DavidIngraham/ArduPilot-tinkering/viewer/README.md

# MicroAGU viewer workspace

Shared Three.js rendering, recorded-data applets, and the browser ArduPilot + Rust
simulator. Existing HTML URLs are preserved for blog embeds. Physics lives in
`../simulation`; applets never implement or tune the aircraft model.

## Ownership

| Directory | Owns | Must not depend on |
| --- | --- | --- |
| `packages/contracts` | Validated truth/log formats, pose and mission types, worker protocol, attitude math | DOM, Three.js, applications |
| `packages/playback` | Interpolation, live truth buffering, truth/log → render-pose adapters | DOM, Three.js, rendering, simulator |
| `packages/rendering` | CAD and canopy geometry, asset loading, scene resources, cameras and route display | Simulator, applets, UI |
| `packages/sim-browser` | Rust binding adapter, ArduPilot transport, worker client, browser isolation and runtime integrity | Rendering, Three.js, applets |
| `packages/applet-ui` | Mount lifecycle, touch controls, timeline controls, comparison layout, charts and capture | Simulator, applications |
| `apps/applets` | Each explanation's data selection, annotations, layout and definition | Other applet implementations |
| `apps/simulator` | Simulator HTML, flight controls, default home/mission, input mapping, presentation loop | Private renderer or worker state |
| `assets` | CAD models, bounded presentation recordings, runtime configuration and pinned asset inventories | Experiment execution |
| `generated` | Rust JS/WASM/types, ArduPilot WASM and generated MAVLink dialect | Hand edits |
| `tools/build`, `tools/convert`, `tools/publish` | Build manifests, data conversion and verified publishing | Tuning or flight-study execution |
| `../research/viewer-studies` | Recording harnesses, gusts, scenario generation and analysis | Runtime imports from the web applications |

Packages are private npm workspaces with explicit exports and one lockfile.
`npm run check:boundaries` enforces package direction; TypeScript checks every
application, package, tool and test. There is no implicit `shared` catch-all.

## Develop and test

```sh
cd viewer
npm ci
npm run assets:fetch       # Restore missing published excerpts by pinned SHA-256
npm run dev               # Open a page listed in apps/applets/registry.ts
npm test
npm run test:physics      # Frozen native/WASM reference trajectories
npm run test:sitl         # Real ArduPlane: modes, launch, mission and manual takeover
npm run build
npx playwright install chromium
npm run test:browser
```

Node 24 is used in CI. `npm run assets:fetch` never overwrites a local recording.
Large flight logs, source videos and fitting outputs stay outside this workspace.
The committed `assets/manifests/recordings.json` pins the published excerpts.
Builds report missing excerpts; publishing an incomplete applet fails before
writing anything. Replay pages never download ArduPilot or the physics WASM.

After intentionally regenerating and reviewing research exports, run
`npm run assets:inventory` to update the recording hashes. Builds do not rewrite
these expected hashes or regenerate experiments.

## Adding an applet

Create `apps/applets/NAME/index.html`, `definition.ts` and `applet.ts` together.
The simulator's HTML lives at `apps/simulator/index.html` beside `main.ts`.
The definition declares its stable public `page`, source `html`, TypeScript `entry`, exact asset requirements
(or pinned dataset groups), controls and initial camera category. Register it in
`apps/applets/registry.ts`; the build and publisher derive their page lists from
that registry. Applet-specific diagrams and scientific annotations stay beside
the definition. Reuse shared rendering, playback and controls through package
exports; do not import another applet's implementation.

Mount through `registerApplet(definition, scope => ...)`. Use the scope for frames,
timers, event handlers, workers, sockets, captures and owned render resources.
Use `ModelAssets` for per-mount CAD loading. Disposal cancels callbacks and pending
loads, terminates workers, releases GPU resources and closes sockets. The exported
handle supports `mount()` and `dispose()`; the browser tests repeatedly exercise
those operations. The simulator's Reset uses that lifecycle without a reload.

## State and clocks

Simulation truth (`microagu.state.v1`) and measured flight data
(`microagu.flight.v1`) remain distinct. Their playback adapters produce a NED/xyzw
`RenderPose`. Missing canopy/rotor observations remain null. Only rendering converts
NED to Three.js coordinates. The simulator worker owns physics time; one app-level
presentation loop samples the live buffer and updates aircraft and camera together.
The renderer does not read telemetry, execute missions, advance physics or own a clock.

## Build and publish

```sh
npm run build
npm run publish -- --destination /path/to/site/assets/microagu-viewer
# Or publish one application:
npm run publish -- --destination /path/to/site/assets/microagu-viewer --app simulator
```

The build combines Vite's dependency manifest, worker output inventory and each
applet's declared assets into `dist/applet-manifest.json`. Publishing verifies every
file hash before copying the selected dependency closure. It never parses minified
JavaScript. Existing Python `tools/publish_*.py` commands delegate to this publisher.
Only publishing the simulator includes its worker, WASM and isolation service worker.

Source folders do not determine published URLs. The build emits each HTML file at
its definition's `page` (for example `pitch-fbd.html` or `simulator.html`) and makes
its compiled asset URLs relative to that location. The dev server serves these
same routes and redirects source HTML paths to them, preserving query parameters.
Blog links and iframe embeds continue to use `/assets/microagu-viewer/<page>`;
link to `apps/applets/<id>/index.html` on GitHub only when referring to source code.

Generated Rust bindings are produced by `../simulation/tools/generate.sh` into
`generated/physics`. Firmware builds write to `generated/ardupilot`; resolved runtime
configuration/provenance live in `assets/runtime`. The public URLs remain `wasm/*`.
Browser startup checks the recorded hashes and uses versioned runtime URLs.

See [simulator operation and rebuilding](SIMULATOR.md),
[individual experiment and capture recipes](docs/RECIPES.md), and
[the reusable physics package](../simulation/README.md).
