DavidIngraham/ArduPilot-tinkering/scratch/plane-trajectory/LogMessages.rst

.. Dynamically generated list of Logger Messages
.. This page was generated using Tools/autotest/logger_metdata/parse.py

.. DO NOT EDIT

.. _logmessages:

Onboard Message Log Messages
============================

This is a list of log messages which may be present in logs produced and stored onboard ArduPilot vehicles.

.. _ACC:

ACC
~~~

IMU accelerometer data

+----------+----------+-------------------------------------------------+
| TimeUS   | μs       | Time since system startup                       |
+----------+----------+-------------------------------------------------+
| I        | instance | accelerometer sensor instance number            |
+----------+----------+-------------------------------------------------+
| SampleUS | μs       | time since system startup this sample was taken |
+----------+----------+-------------------------------------------------+
| AccX     | m/s/s    | acceleration along X axis                       |
+----------+----------+-------------------------------------------------+
| AccY     | m/s/s    | acceleration along Y axis                       |
+----------+----------+-------------------------------------------------+
| AccZ     | m/s/s    | acceleration along Z axis                       |
+----------+----------+-------------------------------------------------+

.. _ADSB:

ADSB
~~~~

Automatic Dependent Serveillance - Broadcast detected vehicle information

+--------------+-------------------+-----------------------------+
| TimeUS       | μs                | Time since system startup   |
+--------------+-------------------+-----------------------------+
| ICAO_address |                   | Transponder address         |
+--------------+-------------------+-----------------------------+
| Lat          | 1e-7 deglatitude  | Vehicle latitude            |
+--------------+-------------------+-----------------------------+
| Lng          | 1e-7 deglongitude | Vehicle longitude           |
+--------------+-------------------+-----------------------------+
| Alt          | mm                | Vehicle altitude            |
+--------------+-------------------+-----------------------------+
| Heading      | cdegheading       | Vehicle heading             |
+--------------+-------------------+-----------------------------+
| Hor_vel      | mm/s              | Vehicle horizontal velocity |
+--------------+-------------------+-----------------------------+
| Ver_vel      | mm/s              | Vehicle vertical velocity   |
+--------------+-------------------+-----------------------------+
| Squark       |                   | Transponder squawk code     |
+--------------+-------------------+-----------------------------+

.. _AERG:

AERG
~~~~

Aeron PLX GNSS status and accuracy (GPS_PARA + EXTD_GNSS)

+--------+----+-----------------------------------------------------+
| TimeUS | μs | Time since system startup                           |
+--------+----+-----------------------------------------------------+
| GMS    |    | Time of week                                        |
+--------+----+-----------------------------------------------------+
| GWk    |    | GPS week                                            |
+--------+----+-----------------------------------------------------+
| NSat   |    | Satellites in view                                  |
+--------+----+-----------------------------------------------------+
| FixT   |    | GPS fix type as reported to AP_GPS                  |
+--------+----+-----------------------------------------------------+
| Jam    |    | Jamming detection level (1=none,2=warn,3=critical)  |
+--------+----+-----------------------------------------------------+
| Spf    |    | Spoofing detection level (1=none,2=warn,3=critical) |
+--------+----+-----------------------------------------------------+
| HPA    |    | Horizontal position accuracy                        |
+--------+----+-----------------------------------------------------+
| VPA    |    | Vertical position accuracy                          |
+--------+----+-----------------------------------------------------+
| HVA    |    | Horizontal velocity accuracy                        |
+--------+----+-----------------------------------------------------+
| HDOP   |    | Horizontal dilution of precision                    |
+--------+----+-----------------------------------------------------+
| VDOP   |    | Vertical dilution of precision                      |
+--------+----+-----------------------------------------------------+

.. _AERN:

AERN
~~~~

Aeron PLX fused navigation solution (NAV_PARA1)

+--------+--------------+-----------------------------------+
| TimeUS | μs           | Time since system startup         |
+--------+--------------+-----------------------------------+
| Epoch  | s            | Unix epoch seconds at sample time |
+--------+--------------+-----------------------------------+
| Lat    | deglatitude  | Latitude                          |
+--------+--------------+-----------------------------------+
| Lng    | deglongitude | Longitude                         |
+--------+--------------+-----------------------------------+
| Alt    | m            | Height above WGS84 ellipsoid      |
+--------+--------------+-----------------------------------+
| VN     | m/s          | Velocity north                    |
+--------+--------------+-----------------------------------+
| VE     | m/s          | Velocity east                     |
+--------+--------------+-----------------------------------+
| VD     | m/s          | Velocity down                     |
+--------+--------------+-----------------------------------+
| Crs    | degheading   | Course over ground                |
+--------+--------------+-----------------------------------+
| Roll   | rad          | Roll angle                        |
+--------+--------------+-----------------------------------+
| Pitch  | rad          | Pitch angle                       |
+--------+--------------+-----------------------------------+
| Yaw    | rad          | Yaw angle                         |
+--------+--------------+-----------------------------------+
| InsSt  |              | PLX INS filter-source status word |
+--------+--------------+-----------------------------------+
| HwSt   |              | PLX hardware status word          |
+--------+--------------+-----------------------------------+

.. _AERS:

AERS
~~~~

Aeron PLX raw sensor data (SENS_PARA)

+--------+--------+---------------------------+
| TimeUS | μs     | Time since system startup |
+--------+--------+---------------------------+
| Temp   | degC   | Sensor temperature        |
+--------+--------+---------------------------+
| GX     | deg/s  | Gyro X                    |
+--------+--------+---------------------------+
| GY     | deg/s  | Gyro Y                    |
+--------+--------+---------------------------+
| GZ     | deg/s  | Gyro Z                    |
+--------+--------+---------------------------+
| AX     | m/s/s  | Accel X                   |
+--------+--------+---------------------------+
| AY     | m/s/s  | Accel Y                   |
+--------+--------+---------------------------+
| AZ     | m/s/s  | Accel Z                   |
+--------+--------+---------------------------+
| MX     | mGauss | Mag X                     |
+--------+--------+---------------------------+
| MY     | mGauss | Mag Y                     |
+--------+--------+---------------------------+
| MZ     | mGauss | Mag Z                     |
+--------+--------+---------------------------+
| Pres   | Pa     | Barometric pressure       |
+--------+--------+---------------------------+
| BTmp   | degC   | Barometer temperature     |
+--------+--------+---------------------------+
| BAlt   | m      | Barometric altitude       |
+--------+--------+---------------------------+

.. _AETR:

AETR
~~~~

Normalised pre-mixer control surface outputs

+--------+----+--------------------------------------------------------------+
| TimeUS | μs | Time since system startup                                    |
+--------+----+--------------------------------------------------------------+
| Ail    |    | Pre-mixer value for aileron output (between -4500 and 4500)  |
+--------+----+--------------------------------------------------------------+
| Elev   |    | Pre-mixer value for elevator output (between -4500 and 4500) |
+--------+----+--------------------------------------------------------------+
| Thr    |    | Pre-mixer value for throttle output (between -100 and 100)   |
+--------+----+--------------------------------------------------------------+
| Rudd   |    | Pre-mixer value for rudder output (between -4500 and 4500)   |
+--------+----+--------------------------------------------------------------+
| Flap   |    | Pre-mixer value for flaps output (between 0 and 100)         |
+--------+----+--------------------------------------------------------------+
| Steer  |    | Pre-mixer value for steering output (between -4500 and 4500) |
+--------+----+--------------------------------------------------------------+
| SS     |    | Surface movement / airspeed scaling value                    |
+--------+----+--------------------------------------------------------------+

.. _AHR2:

AHR2
~~~~

Backup AHRS data

+--------+--------------+-------------------------------------------+
| TimeUS | μs           | Time since system startup                 |
+--------+--------------+-------------------------------------------+
| Roll   | deg          | Estimated roll                            |
+--------+--------------+-------------------------------------------+
| Pitch  | deg          | Estimated pitch                           |
+--------+--------------+-------------------------------------------+
| Yaw    | degheading   | Estimated yaw                             |
+--------+--------------+-------------------------------------------+
| Alt    | m            | Estimated altitude                        |
+--------+--------------+-------------------------------------------+
| Lat    | deglatitude  | Estimated latitude                        |
+--------+--------------+-------------------------------------------+
| Lng    | deglongitude | Estimated longitude                       |
+--------+--------------+-------------------------------------------+
| Q1     |              | Estimated attitude quaternion component 1 |
+--------+--------------+-------------------------------------------+
| Q2     |              | Estimated attitude quaternion component 2 |
+--------+--------------+-------------------------------------------+
| Q3     |              | Estimated attitude quaternion component 3 |
+--------+--------------+-------------------------------------------+
| Q4     |              | Estimated attitude quaternion component 4 |
+--------+--------------+-------------------------------------------+

.. _AIS1:

AIS1
~~~~

Contents of 'position report' AIS message, see: https://gpsd.gitlab.io/gpsd/AIVDM.html#_types_1_2_and_3_position_report_class_a

+------+----+---------------------------+
| US   | μs | Time since system startup |
+------+----+---------------------------+
| typ  |    | Message Type              |
+------+----+---------------------------+
| rep  |    | Repeat Indicator          |
+------+----+---------------------------+
| mmsi |    | MMSI                      |
+------+----+---------------------------+
| nav  |    | Navigation Status         |
+------+----+---------------------------+
| rot  |    | Rate of Turn (ROT)        |
+------+----+---------------------------+
| sog  |    | Speed Over Ground (SOG)   |
+------+----+---------------------------+
| pos  |    | Position Accuracy         |
+------+----+---------------------------+
| lon  |    | Longitude                 |
+------+----+---------------------------+
| lat  |    | Latitude                  |
+------+----+---------------------------+
| cog  |    | Course Over Ground (COG)  |
+------+----+---------------------------+
| hed  |    | True Heading (HDG)        |
+------+----+---------------------------+
| sec  |    | Time Stamp                |
+------+----+---------------------------+
| man  |    | Maneuver Indicator        |
+------+----+---------------------------+
| raim |    | RAIM flag                 |
+------+----+---------------------------+
| rad  |    | Radio status              |
+------+----+---------------------------+

.. _AIS4:

AIS4
~~~~

Contents of 'Base Station Report' AIS message, see: https://gpsd.gitlab.io/gpsd/AIVDM.html#_type_4_base_station_report

+------+----+---------------------------+
| US   | μs | Time since system startup |
+------+----+---------------------------+
| rep  |    | Repeat Indicator          |
+------+----+---------------------------+
| mmsi |    | MMSI                      |
+------+----+---------------------------+
| year |    | Year (UTC)                |
+------+----+---------------------------+
| mth  |    | Month (UTC)               |
+------+----+---------------------------+
| day  |    | Day (UTC)                 |
+------+----+---------------------------+
| h    |    | Hour (UTC)                |
+------+----+---------------------------+
| m    |    | Minute (UTC)              |
+------+----+---------------------------+
| s    |    | Second (UTC)              |
+------+----+---------------------------+
| fix  |    | Fix quality               |
+------+----+---------------------------+
| lon  |    | Longitude                 |
+------+----+---------------------------+
| lat  |    | Latitude                  |
+------+----+---------------------------+
| epfd |    | Type of EPFD              |
+------+----+---------------------------+
| raim |    | RAIM flag                 |
+------+----+---------------------------+
| rad  |    | Radio status              |
+------+----+---------------------------+

.. _AIS5:

AIS5
~~~~

Contents of 'static and voyage related data' AIS message, see: https://gpsd.gitlab.io/gpsd/AIVDM.html#_type_5_static_and_voyage_related_data
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
