DavidIngraham/ArduPilot-tinkering/scratch/plane-trajectory/raster-matrix/raster-summary-matrix.pdf

## Raster survey matrix: standard L1 versus line-to-line planner Each cell: AUTO course time / requested-line coverage / survey-leg RMS error

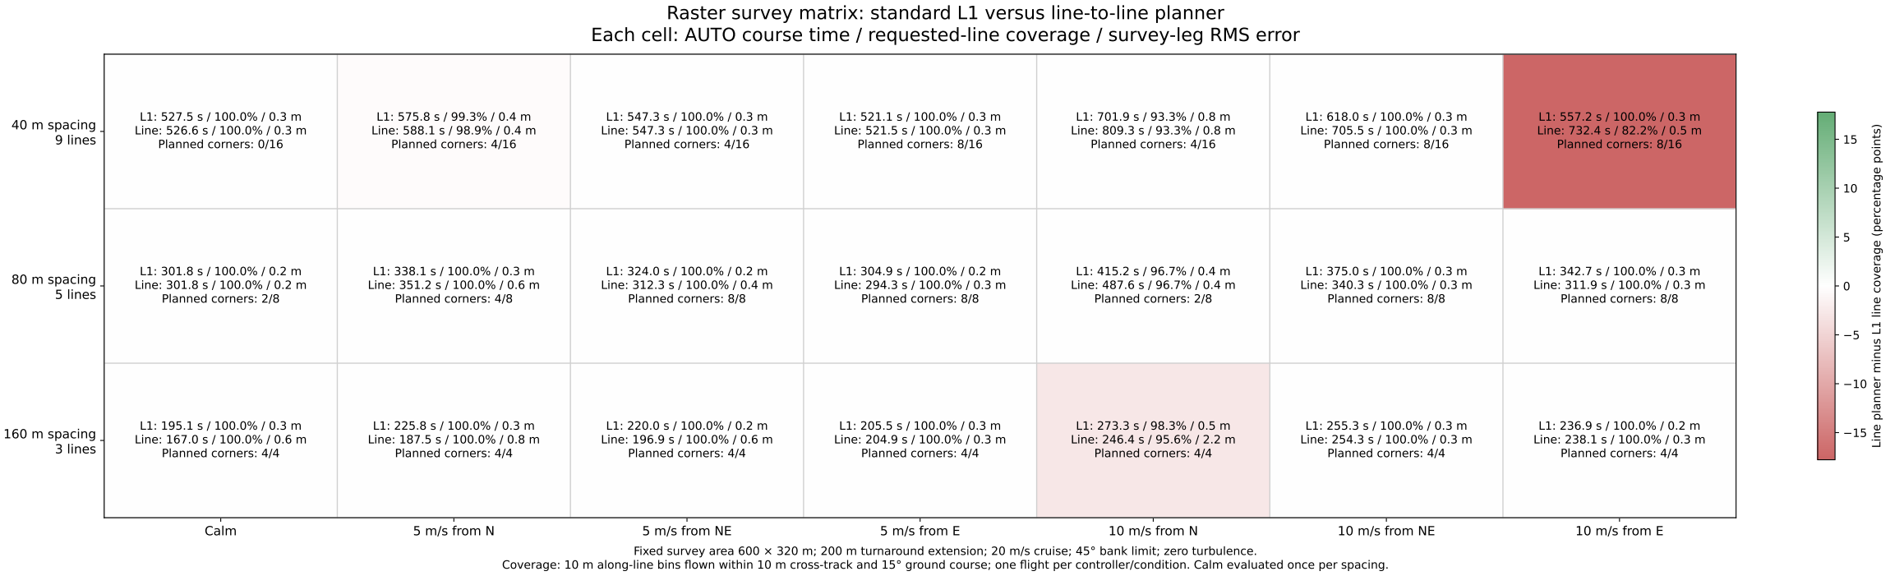
[picture p53: page 1]

Calm | 5 m/s from N | 5 m/s from NE | 5 m/s from E | 10 m/s from N | 10 m/s from NE | 10 m/s from E

40 m spacing
9 lines

80 m spacing
5 lines

160 m spacing
3 lines
L1: 527.5 s / 100.0% / 0.3 m Line: 526.6 s / 100.0% / 0.3 m Planned corners: 0/16 | L1: 575.8 s / 99.3% / 0.4 m Line: 588.1 s / 98.9% / 0.4 m Planned corners: 4/16 | L1: 547.3 s / 100.0% / 0.3 m Line: 547.3 s / 100.0% / 0.3 m Planned corners: 4/16 | L1: 521.1 s / 100.0% / 0.3 m Line: 521.5 s / 100.0% / 0.3 m Planned corners: 8/16 | L1:
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
