DavidIngraham/ArduPilot-tinkering/docs/assets/landing-refinement/landing-final.png

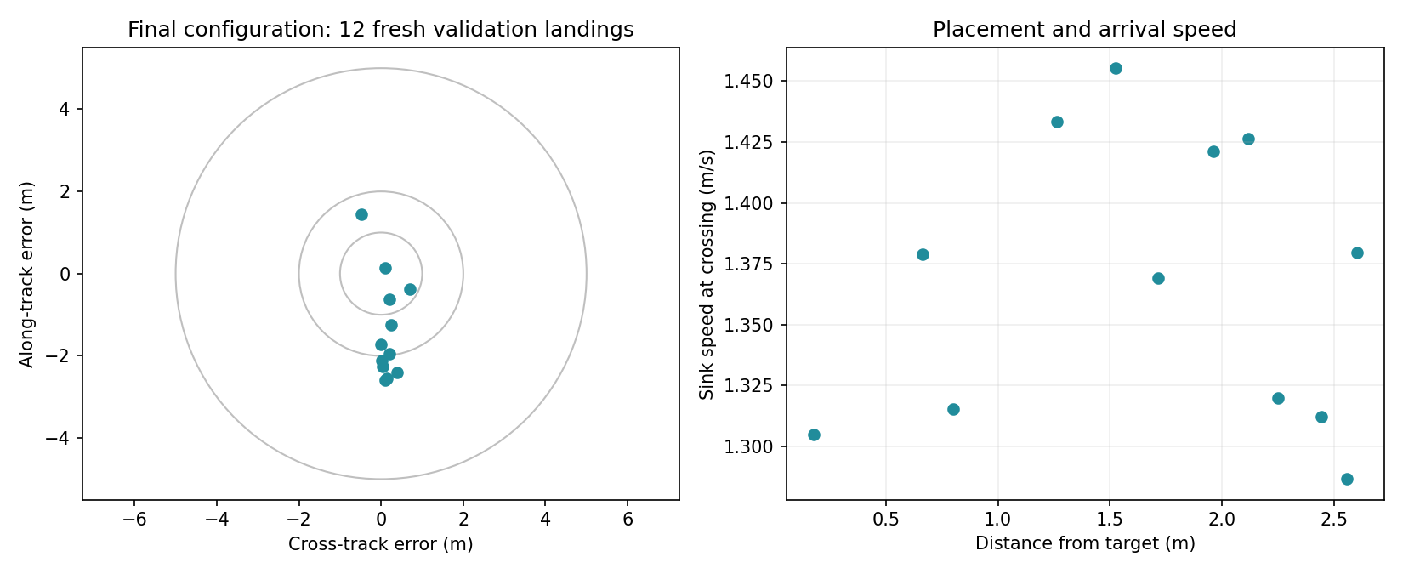
docs/assets/landing-refinement/landing-final.png
