DavidIngraham/ArduPilot-tinkering/docs/assets/landing-refinement/matched-response.png

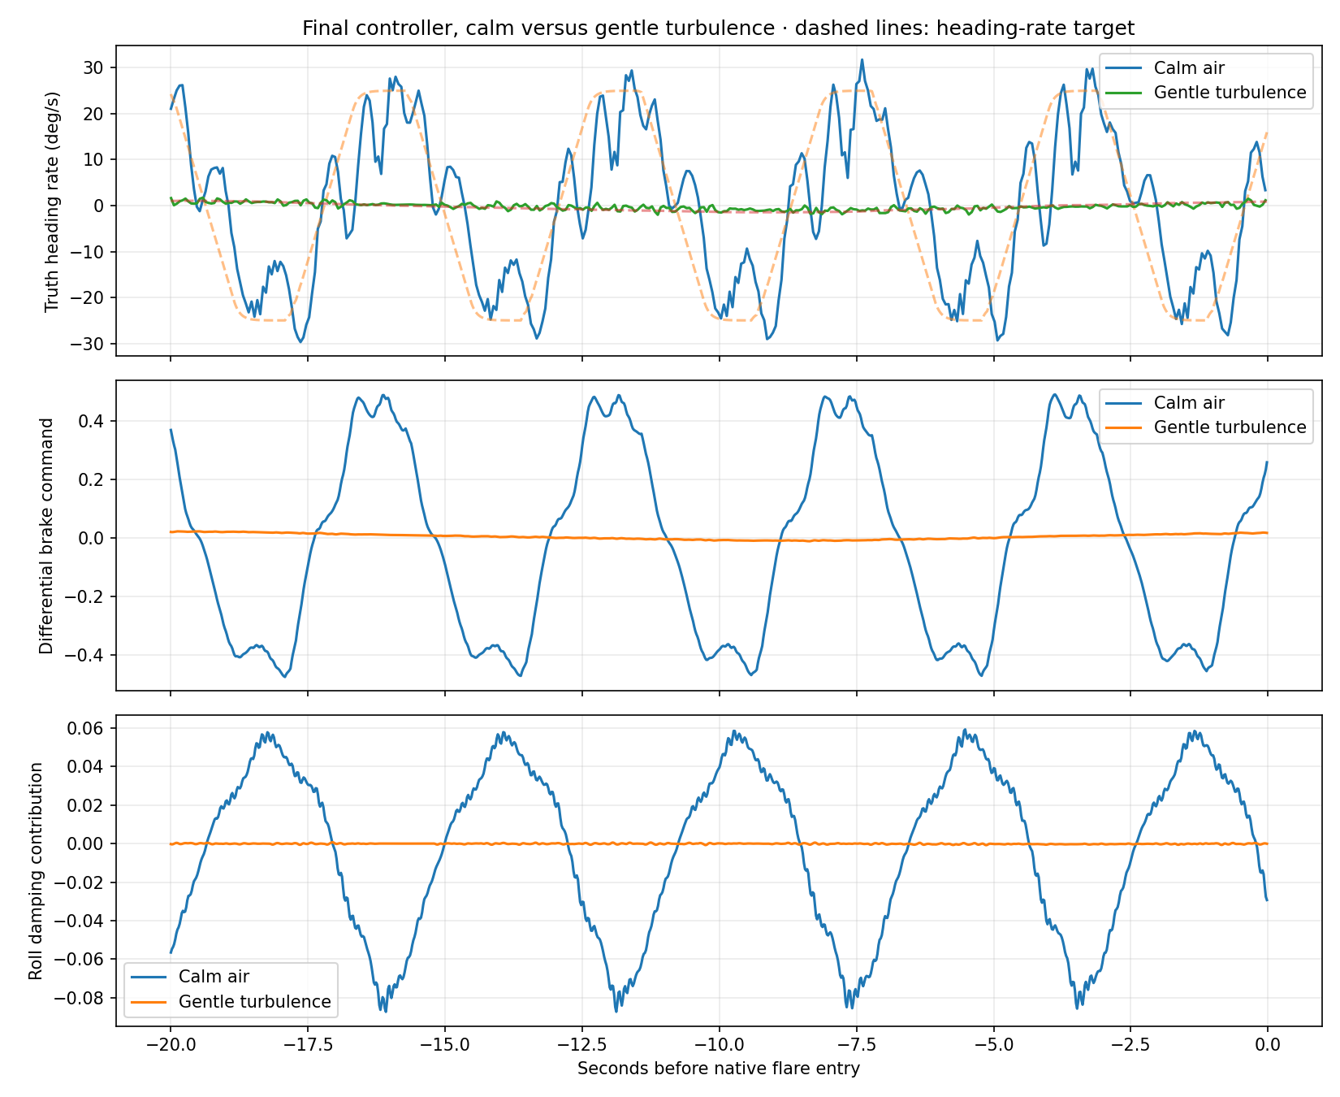
docs/assets/landing-refinement/matched-response.png
