DavidIngraham/ArduPilot-tinkering/docs/assets/landing/landing-final.png

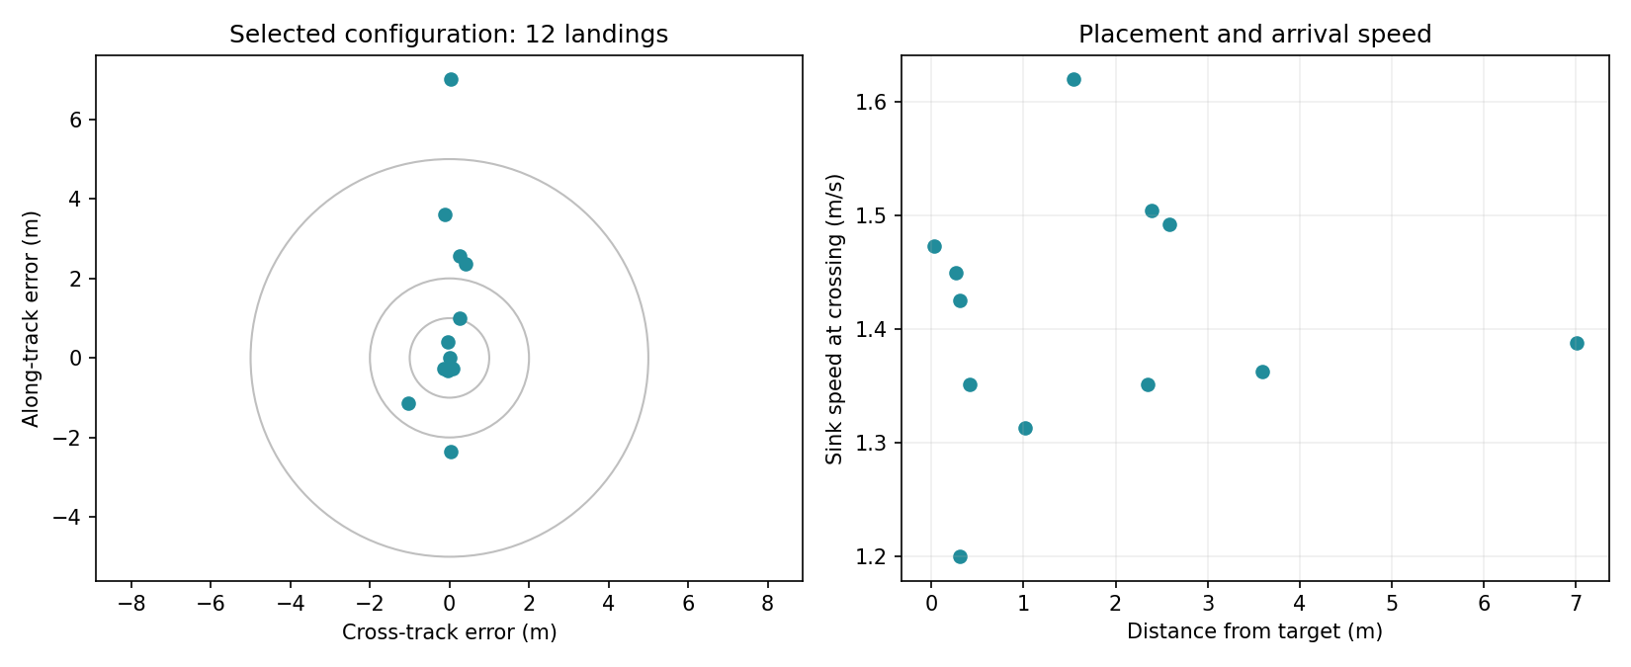
docs/assets/landing/landing-final.png
