DavidIngraham/ArduPilot-tinkering/docs/assets/landing/landing-iteration.png

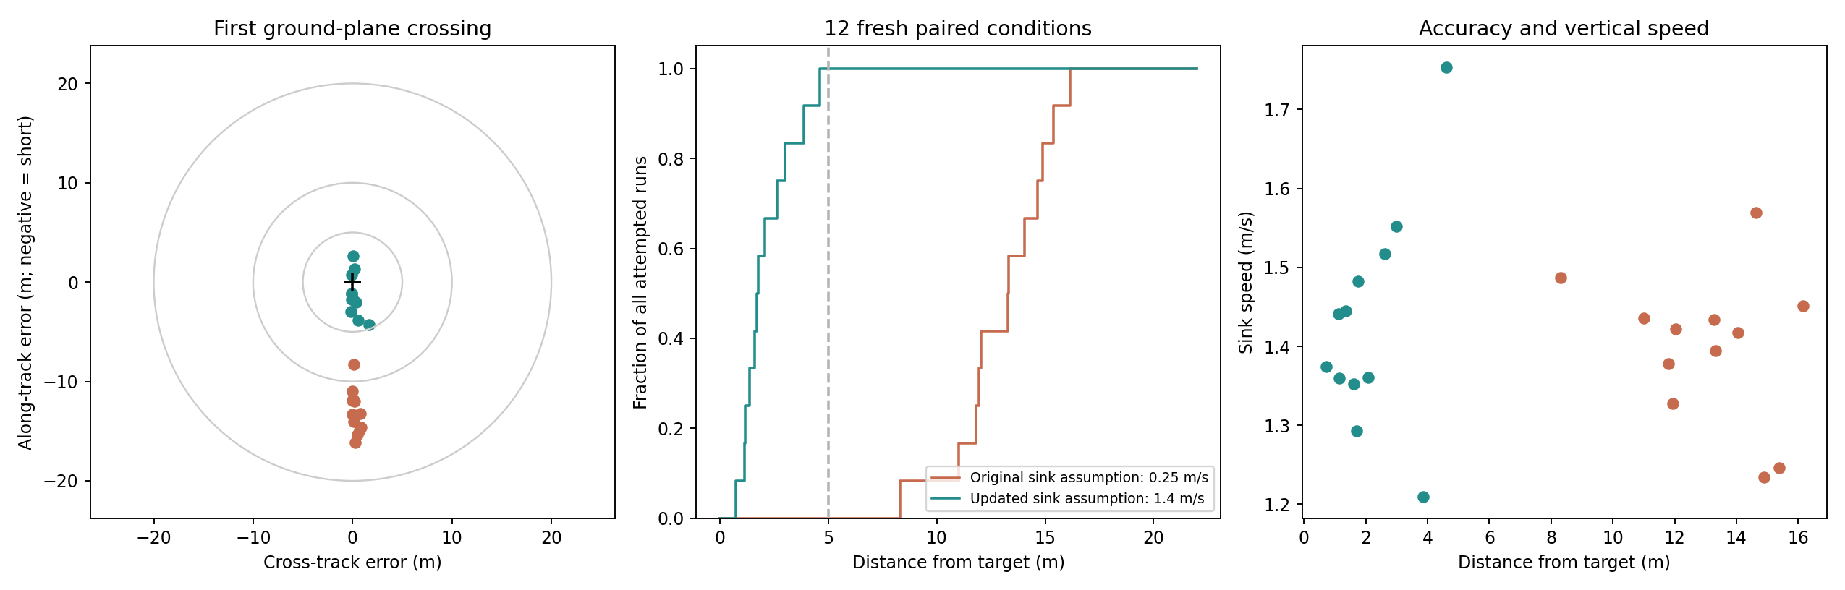
docs/assets/landing/landing-iteration.png
