DavidIngraham/ArduPilot-tinkering/docs/assets/landing/spot-landing.jpg

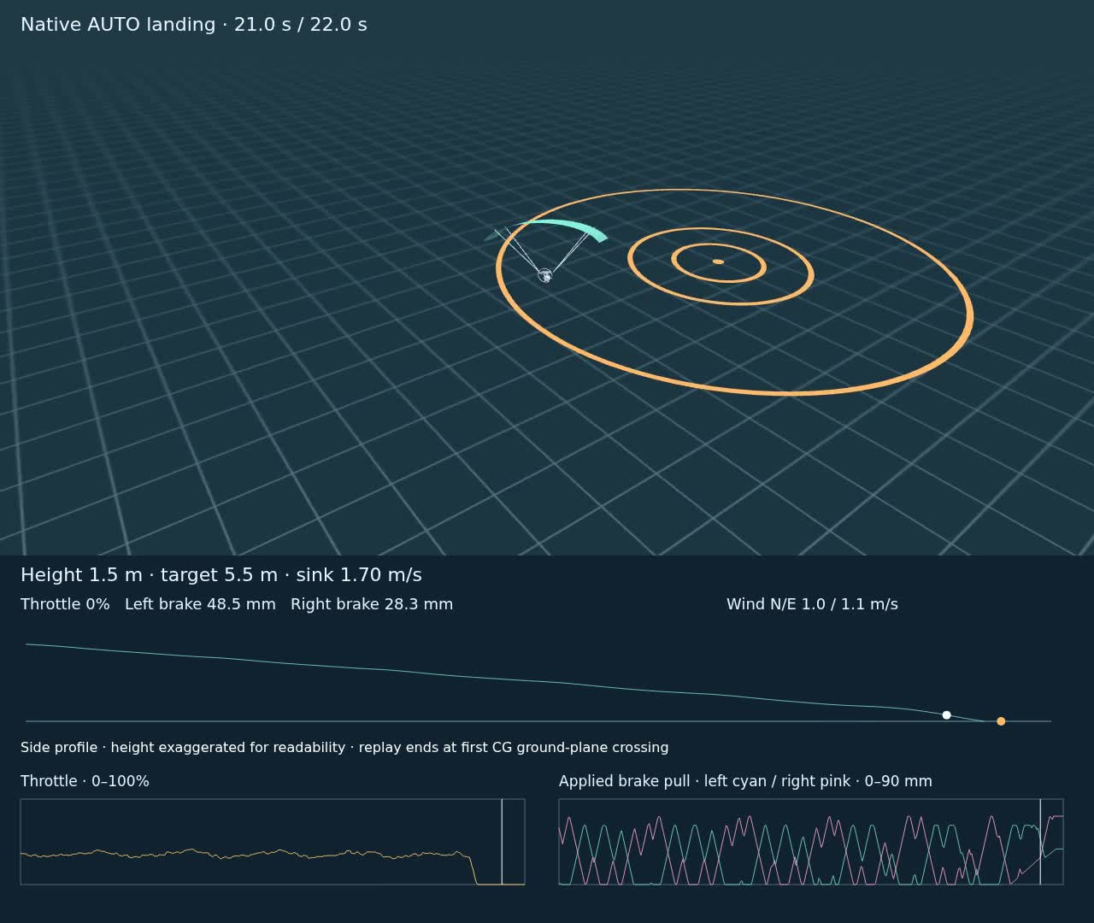
docs/assets/landing/spot-landing.jpg
