DavidIngraham/ArduPilot-tinkering/docs/assets/longitudinal-final-design/candidate-screen.png

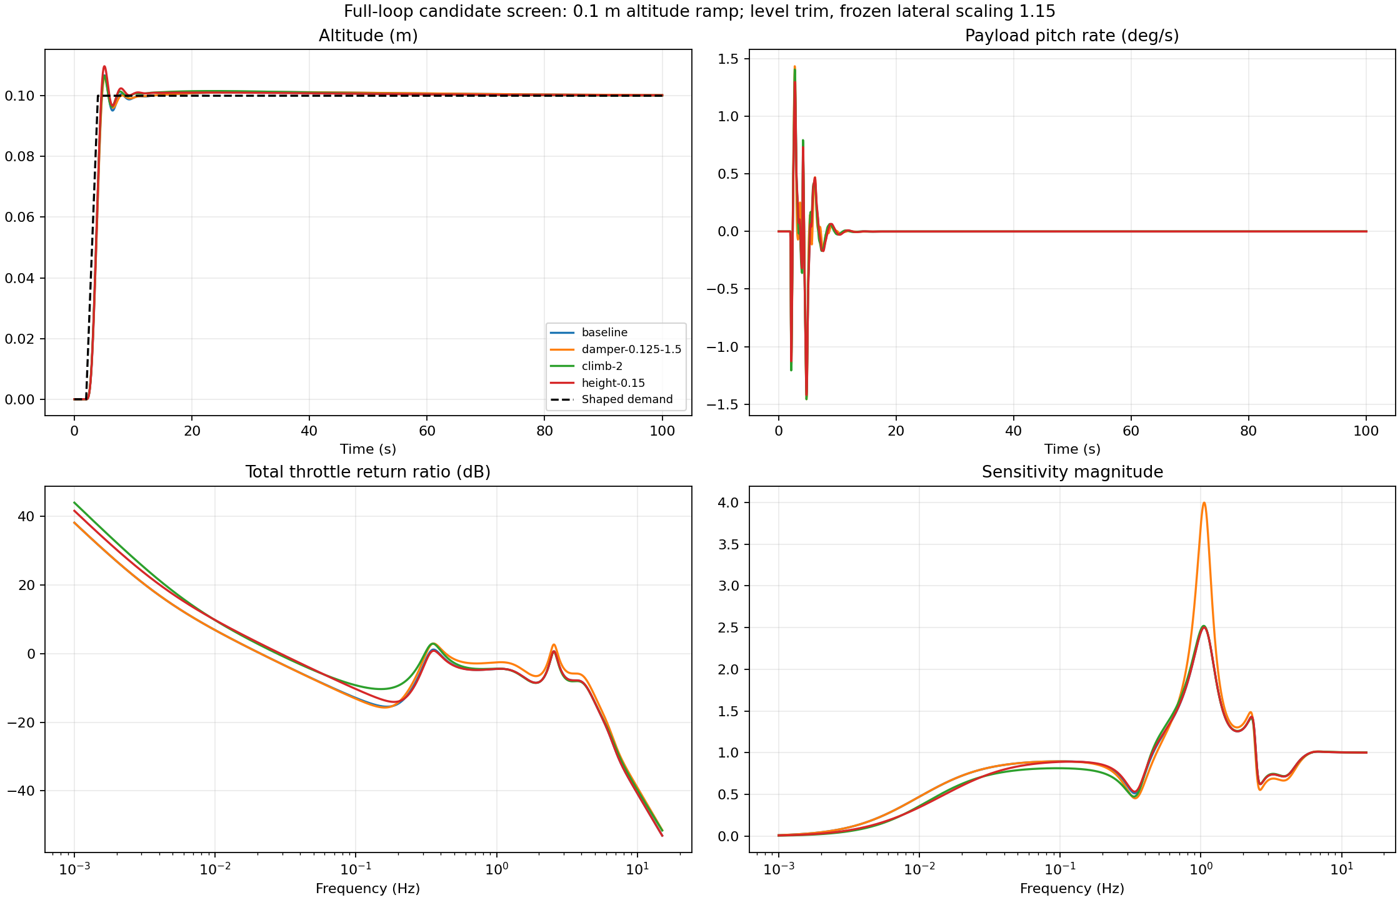
docs/assets/longitudinal-final-design/candidate-screen.png
