DavidIngraham/ArduPilot-tinkering/docs/assets/longitudinal-final-design/nyquist.png

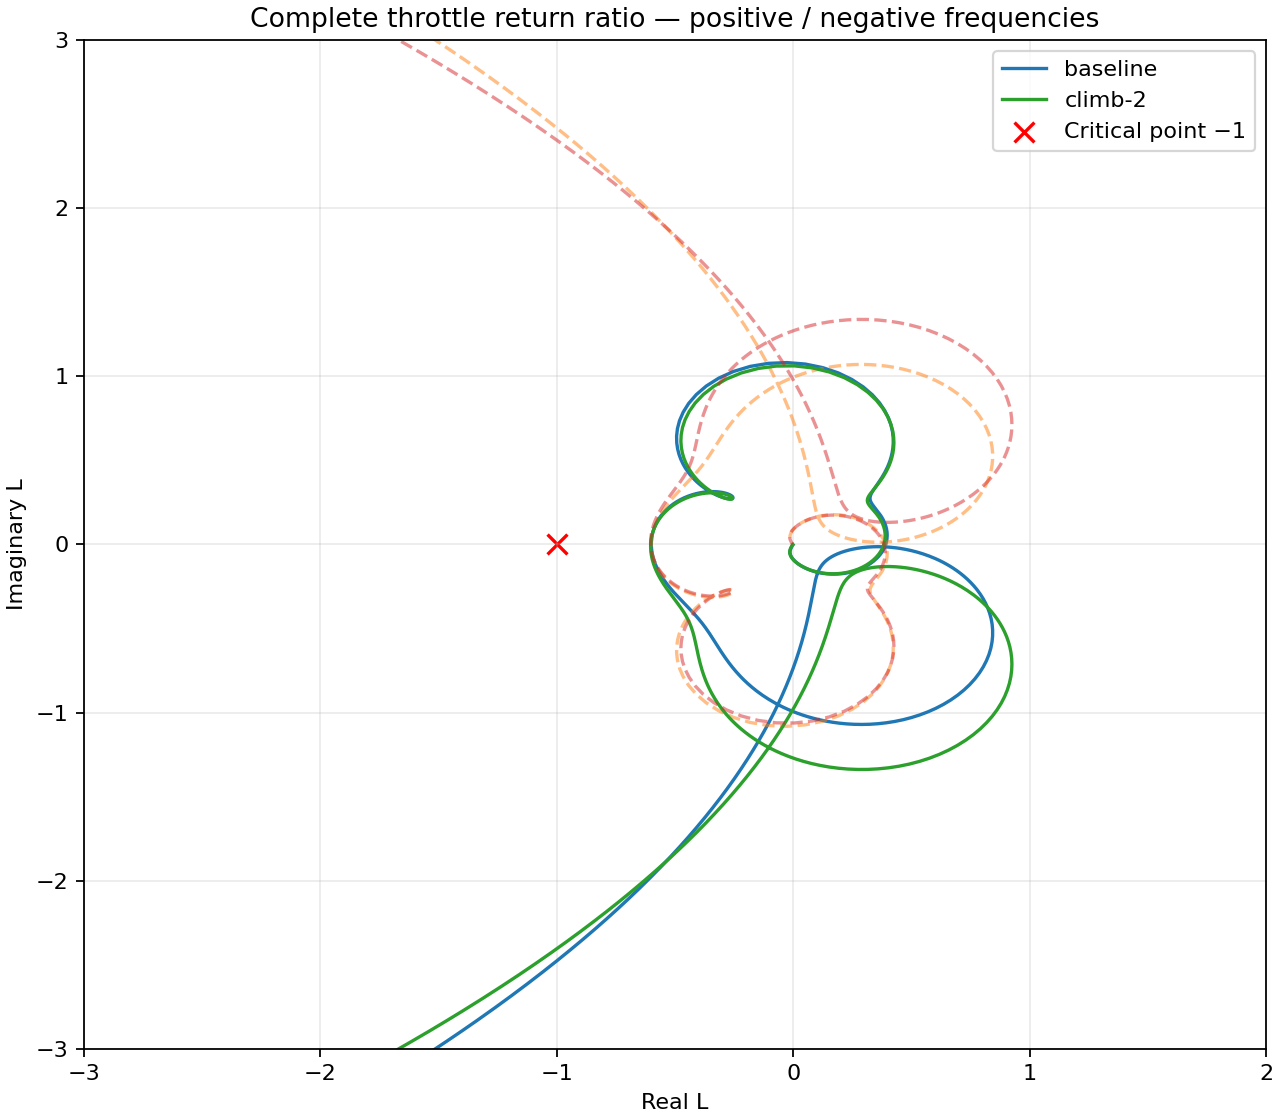
docs/assets/longitudinal-final-design/nyquist.png
