DavidIngraham/ArduPilot-tinkering/docs/assets/micro-agu/battery-box.png

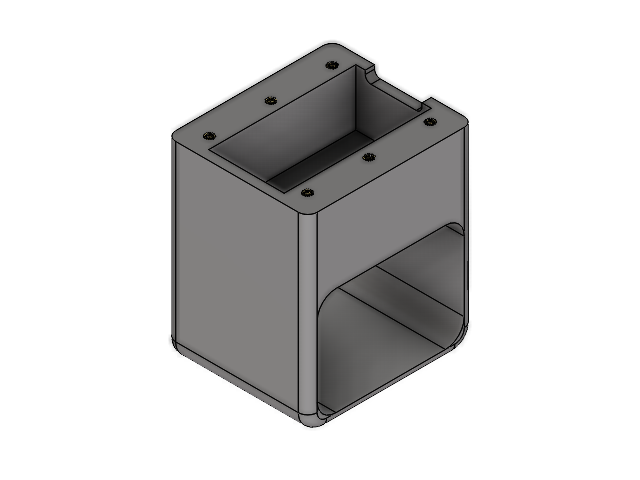
docs/assets/micro-agu/battery-box.png
