DavidIngraham/ArduPilot-tinkering/docs/assets/micro-agu/spreader.png

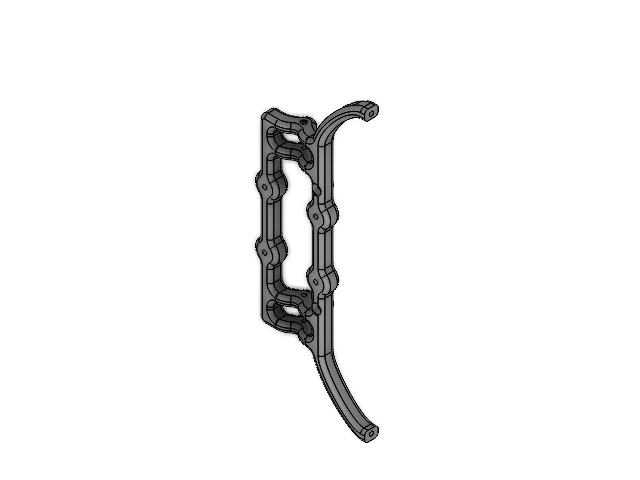
docs/assets/micro-agu/spreader.png
