DavidIngraham/ArduPilot-tinkering/docs/assets/model-mechanics/nine-dof.png

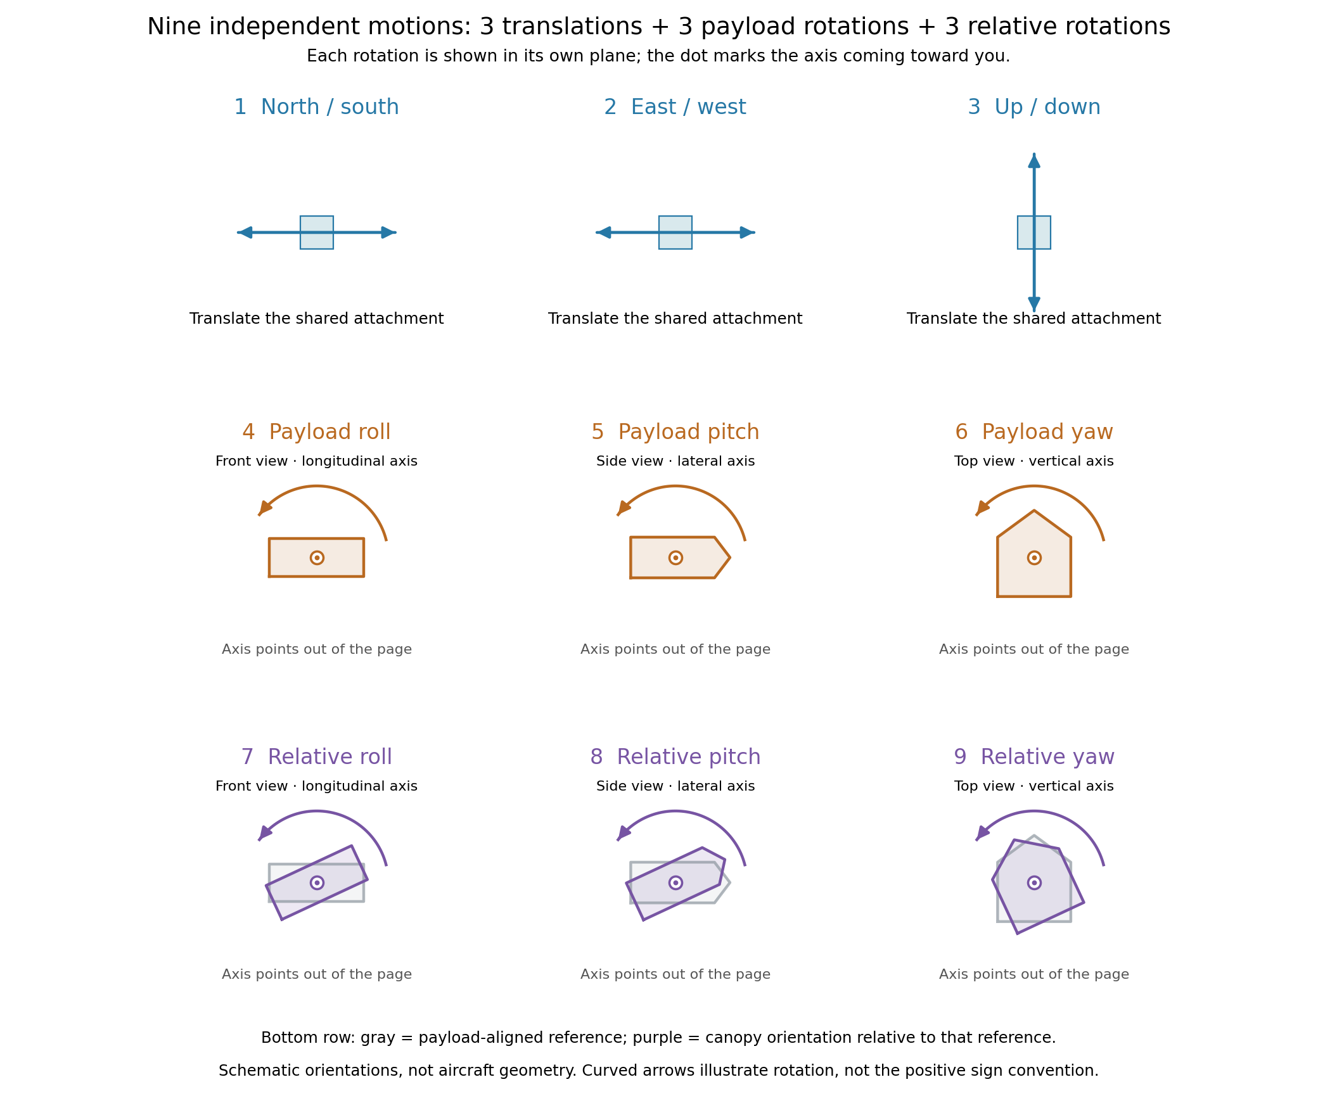
docs/assets/model-mechanics/nine-dof.png
