DavidIngraham/ArduPilot-tinkering/docs/assets/viewer/altitude-comparison/altitude-comparison-smooth-camera.jpg

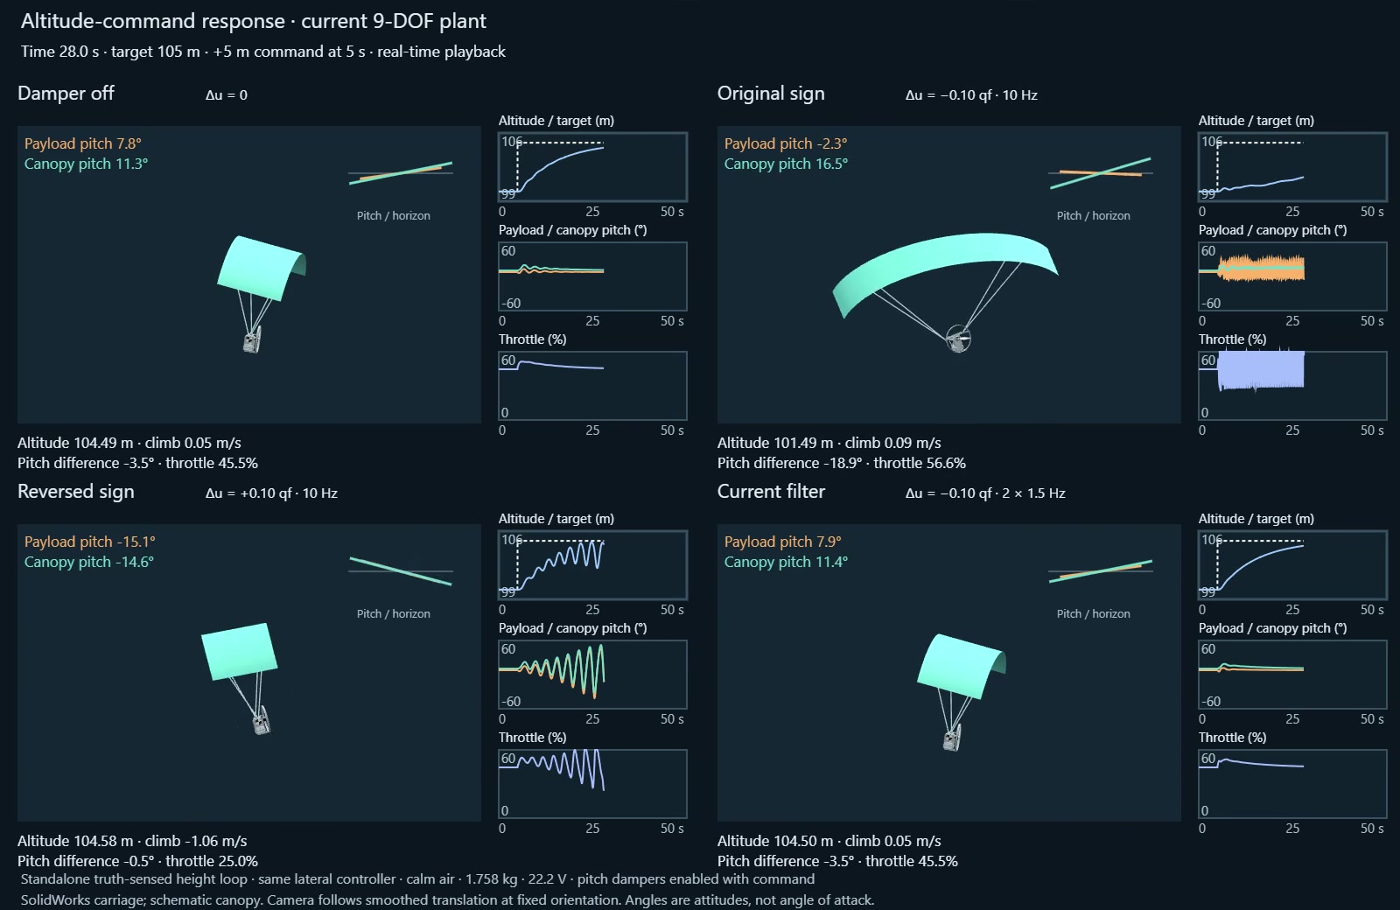
docs/assets/viewer/altitude-comparison/altitude-comparison-smooth-camera.jpg
