DavidIngraham/ArduPilot-tinkering/docs/assets/viewer/auto-calm-profile-plain.jpg

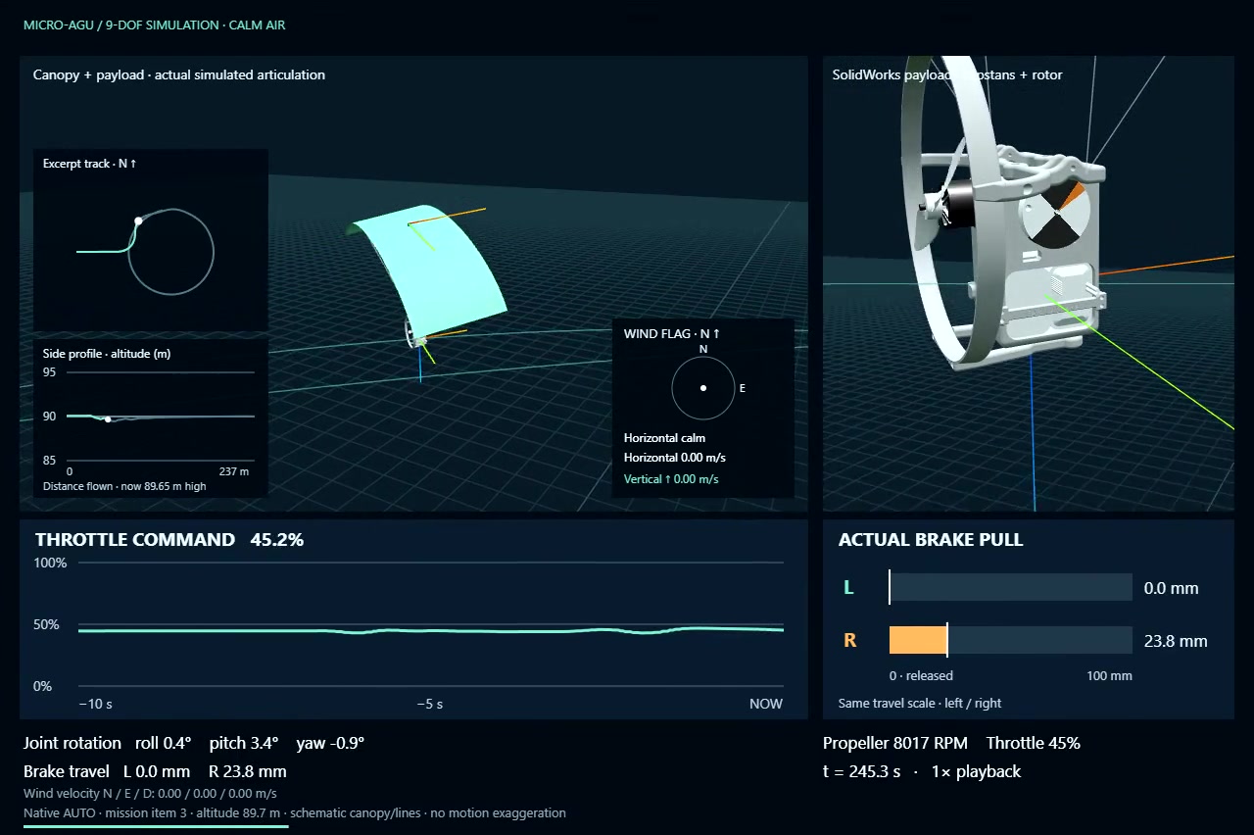
docs/assets/viewer/auto-calm-profile-plain.jpg
