DavidIngraham/ArduPilot-tinkering/docs/assets/viewer/auto-crosswind-profile.jpg

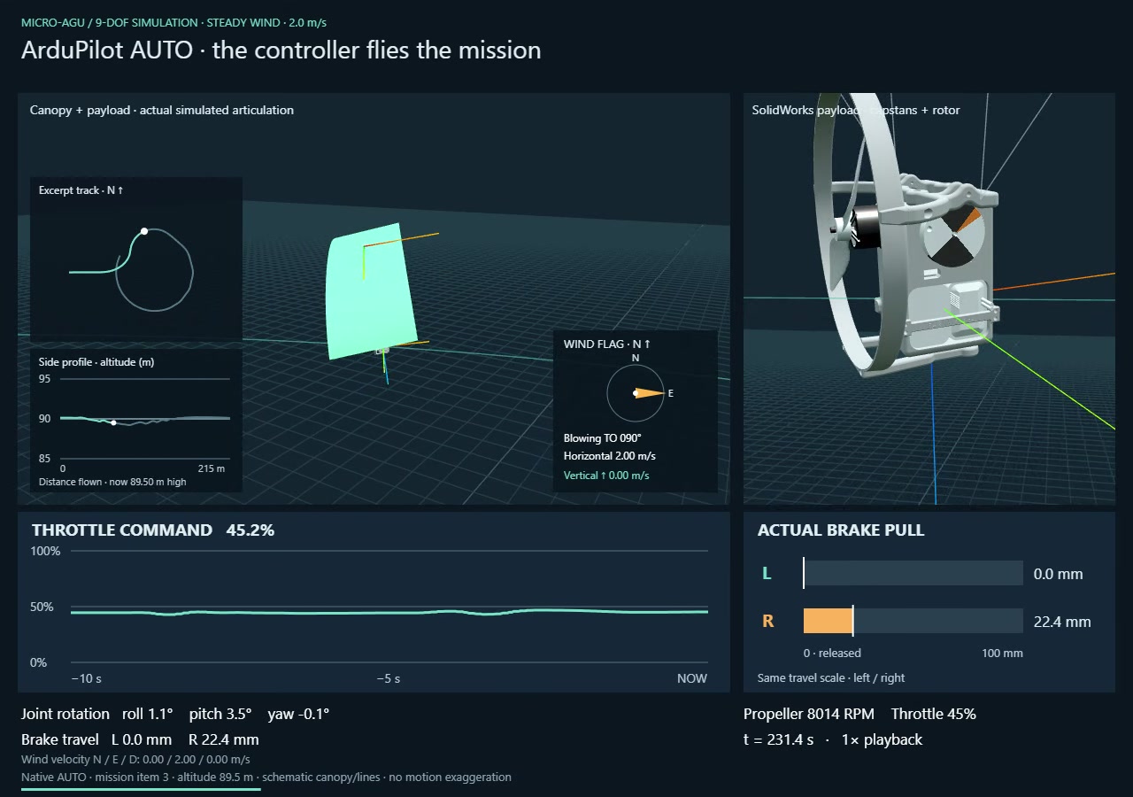
docs/assets/viewer/auto-crosswind-profile.jpg
