DavidIngraham/ArduPilot-tinkering/docs/assets/viewer/auto-gust-profile.jpg

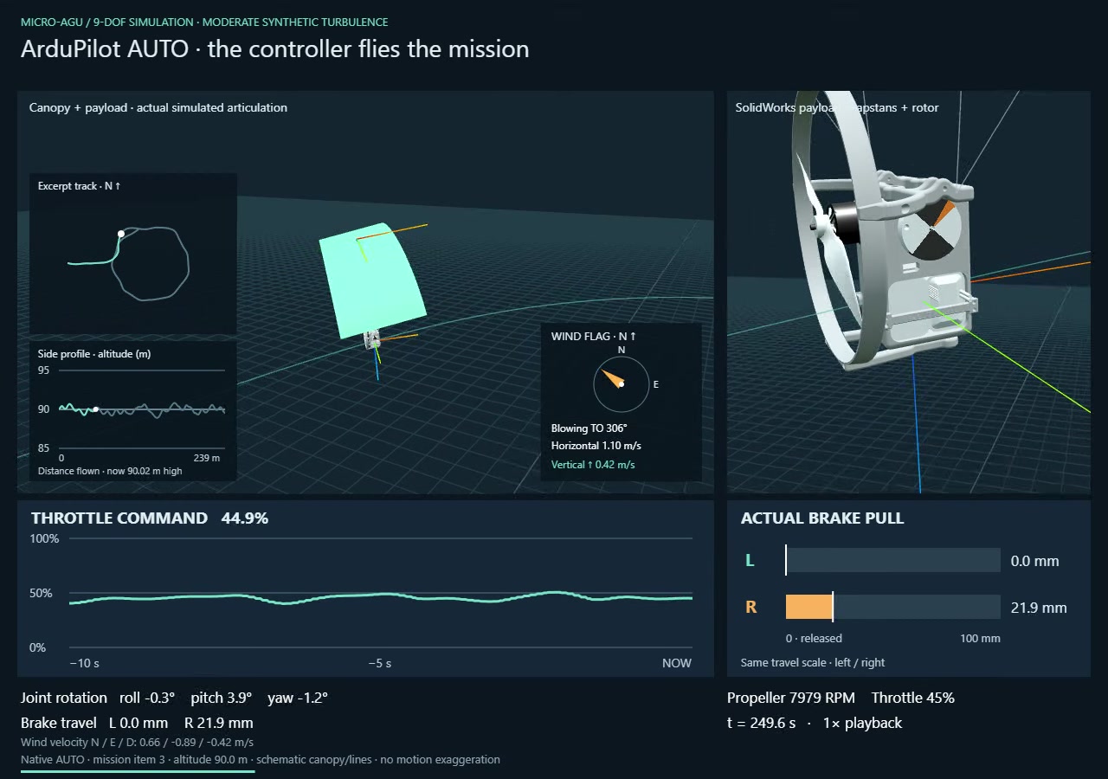
docs/assets/viewer/auto-gust-profile.jpg
