DavidIngraham/ArduPilot-tinkering/docs/assets/viewer/auto-mission-controls.jpg

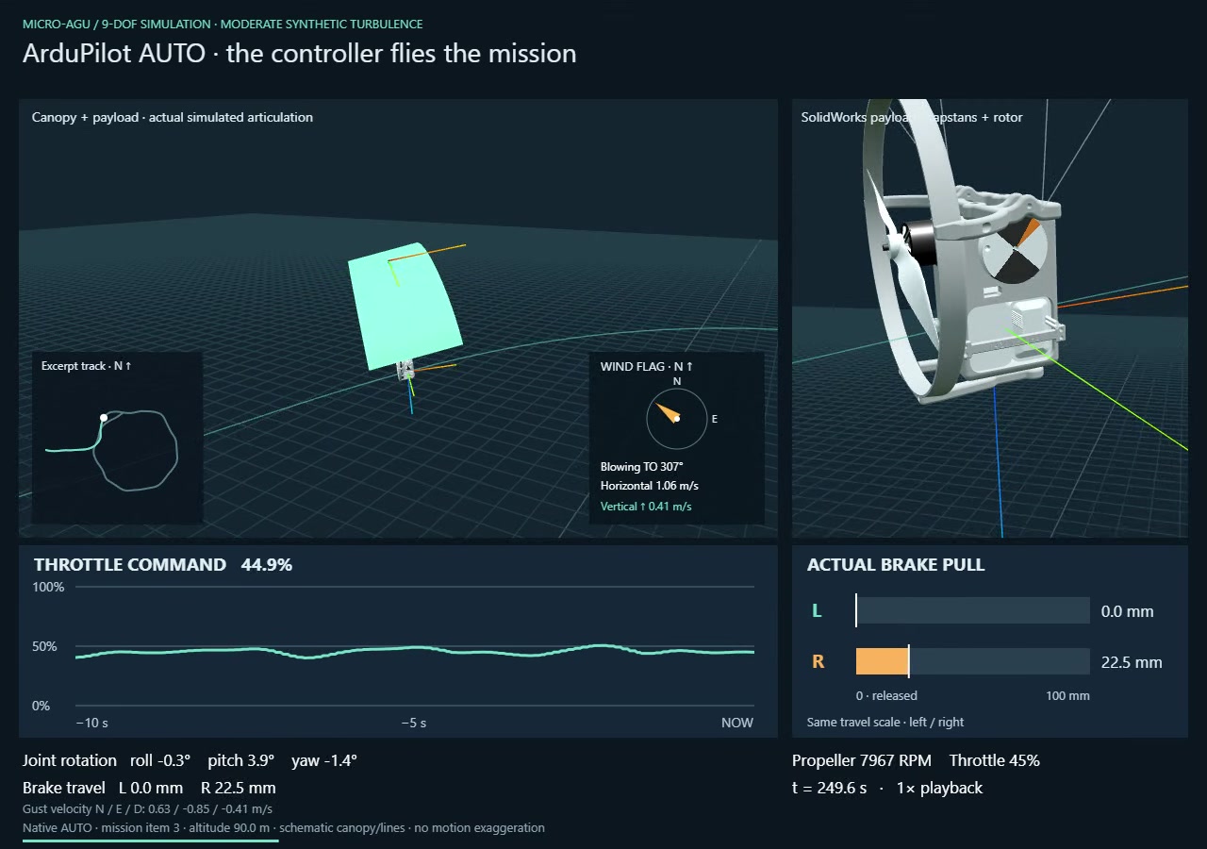
docs/assets/viewer/auto-mission-controls.jpg
