DavidIngraham/ArduPilot-tinkering/docs/assets/viewer/auto-mission-turbulence-marked.jpg

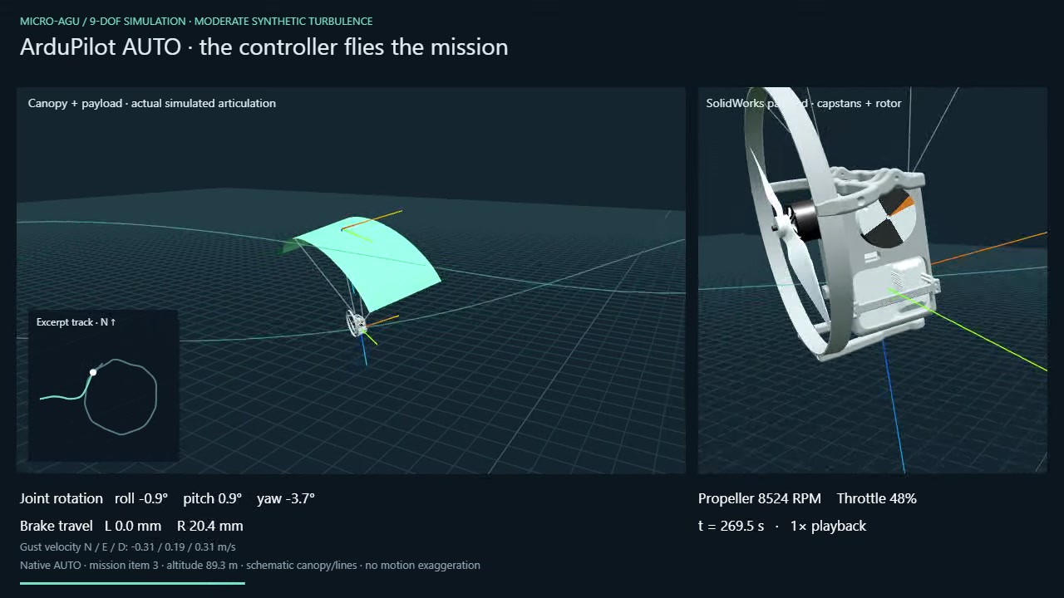
docs/assets/viewer/auto-mission-turbulence-marked.jpg
