DavidIngraham/ArduPilot-tinkering/docs/assets/viewer/joint-tour/joint-tour.jpg

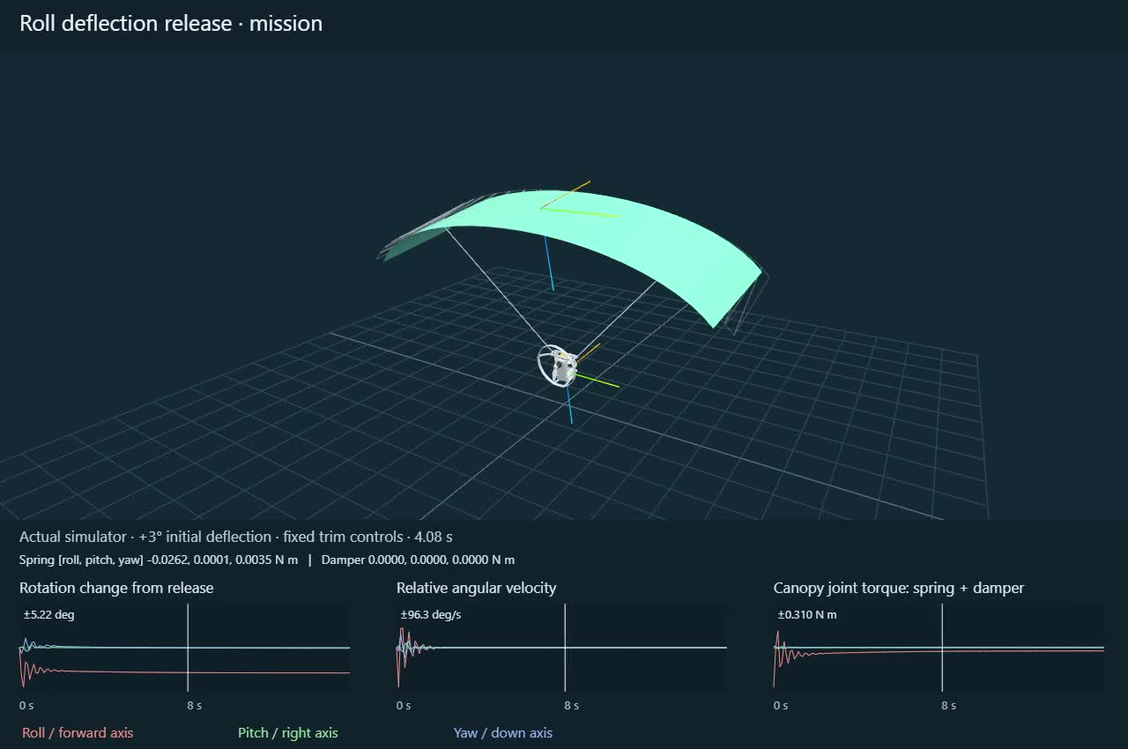
docs/assets/viewer/joint-tour/joint-tour.jpg
