DavidIngraham/ArduPilot-tinkering/docs/assets/viewer/pitch-fbd/pitch-fbd.jpg

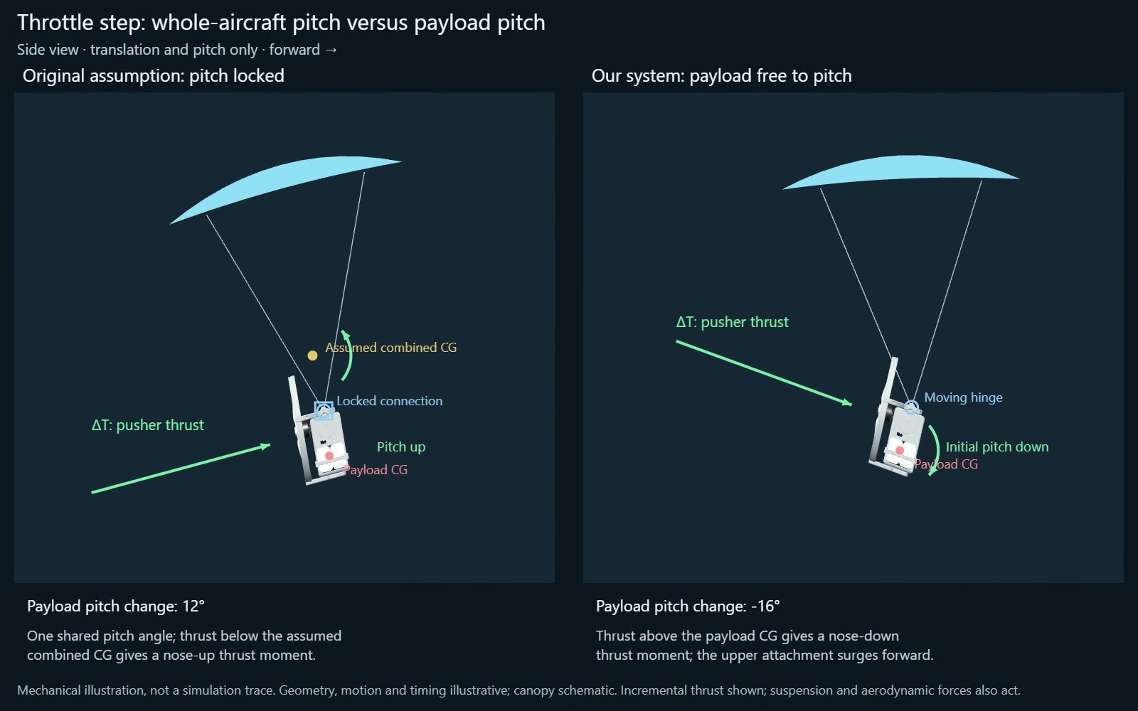
docs/assets/viewer/pitch-fbd/pitch-fbd.jpg
