DavidIngraham/ArduPilot-tinkering/docs/assets/viewer/pitch-sign/pitch-sign-carriage.jpg

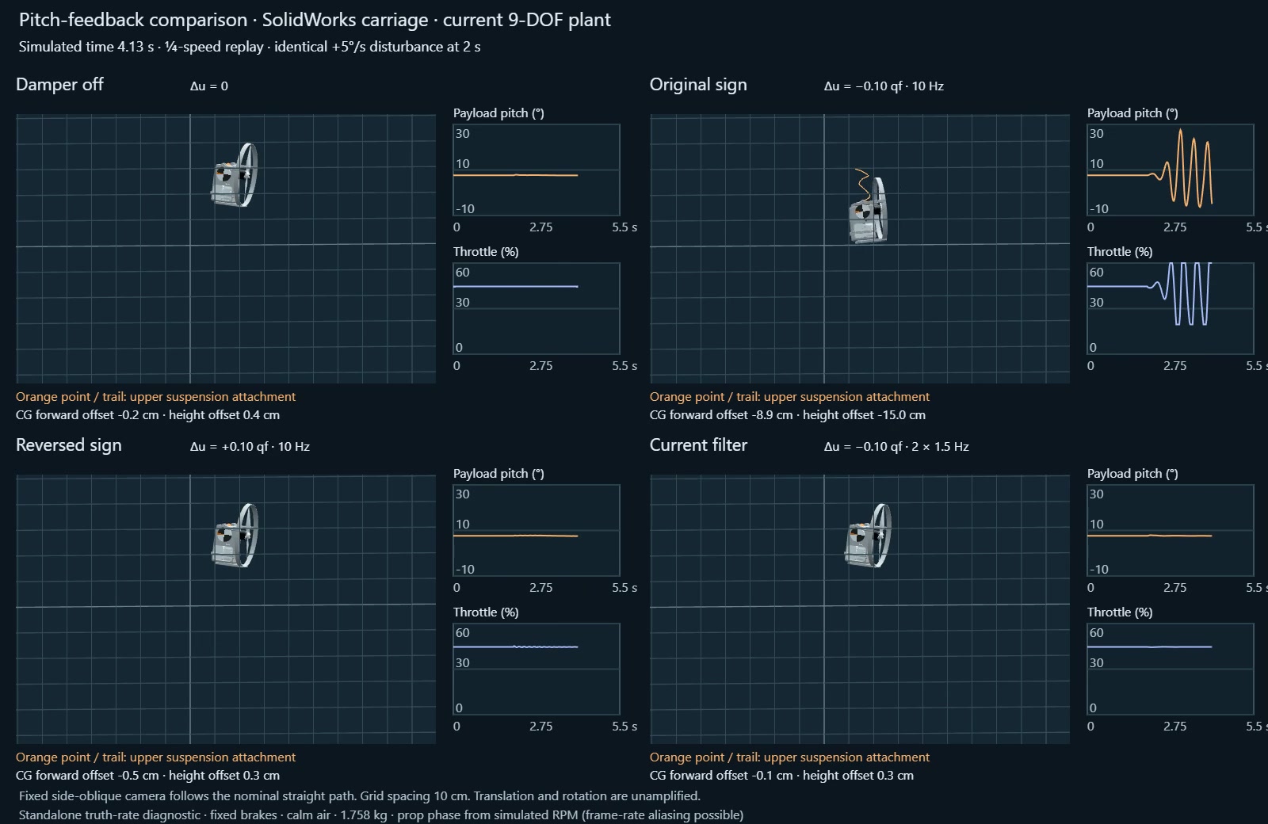
docs/assets/viewer/pitch-sign/pitch-sign-carriage.jpg
