DavidIngraham/ArduPilot-tinkering/docs/assets/viewer/pitch-sign/pitch-sign.jpg

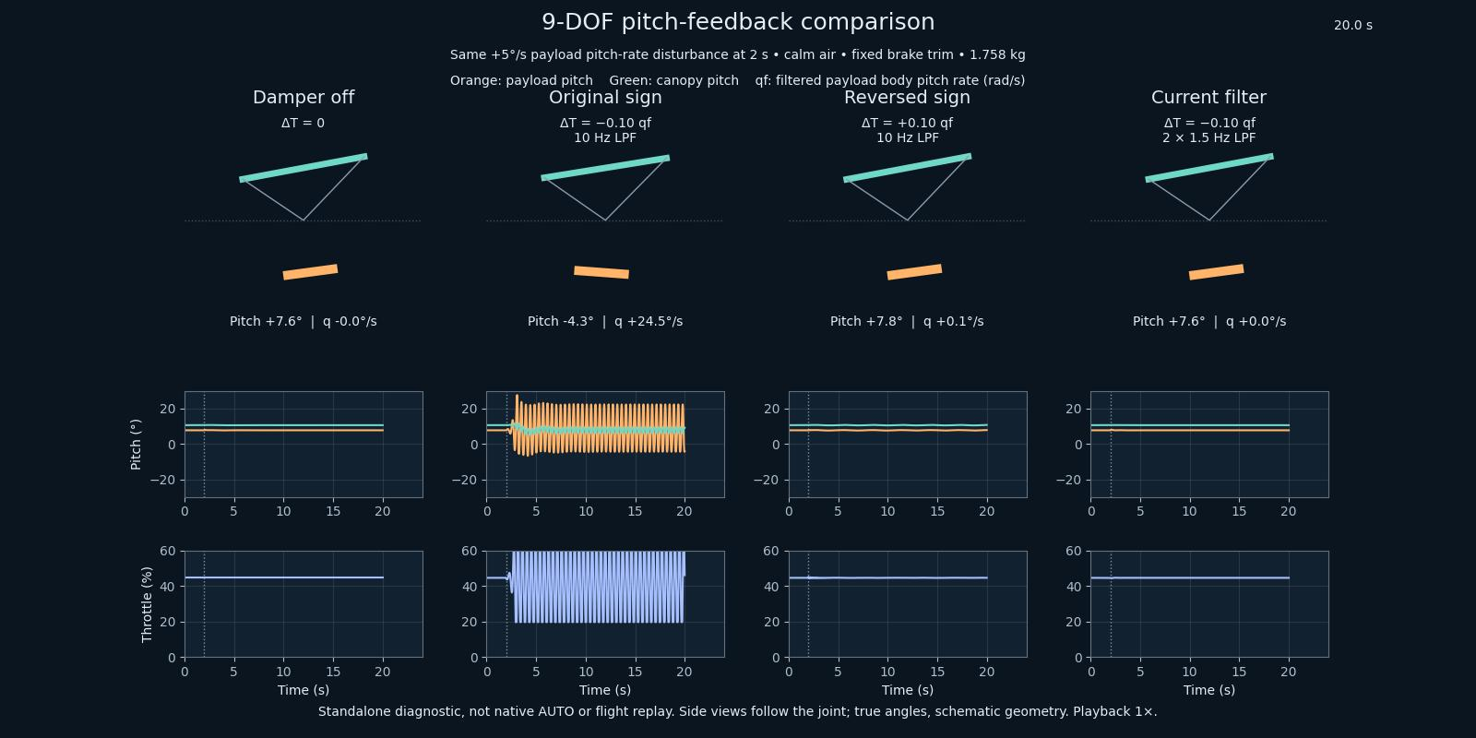
docs/assets/viewer/pitch-sign/pitch-sign.jpg
