DavidIngraham/ArduPilot-tinkering/docs/assets/viewer/reversing-turn-controls-plain.jpg

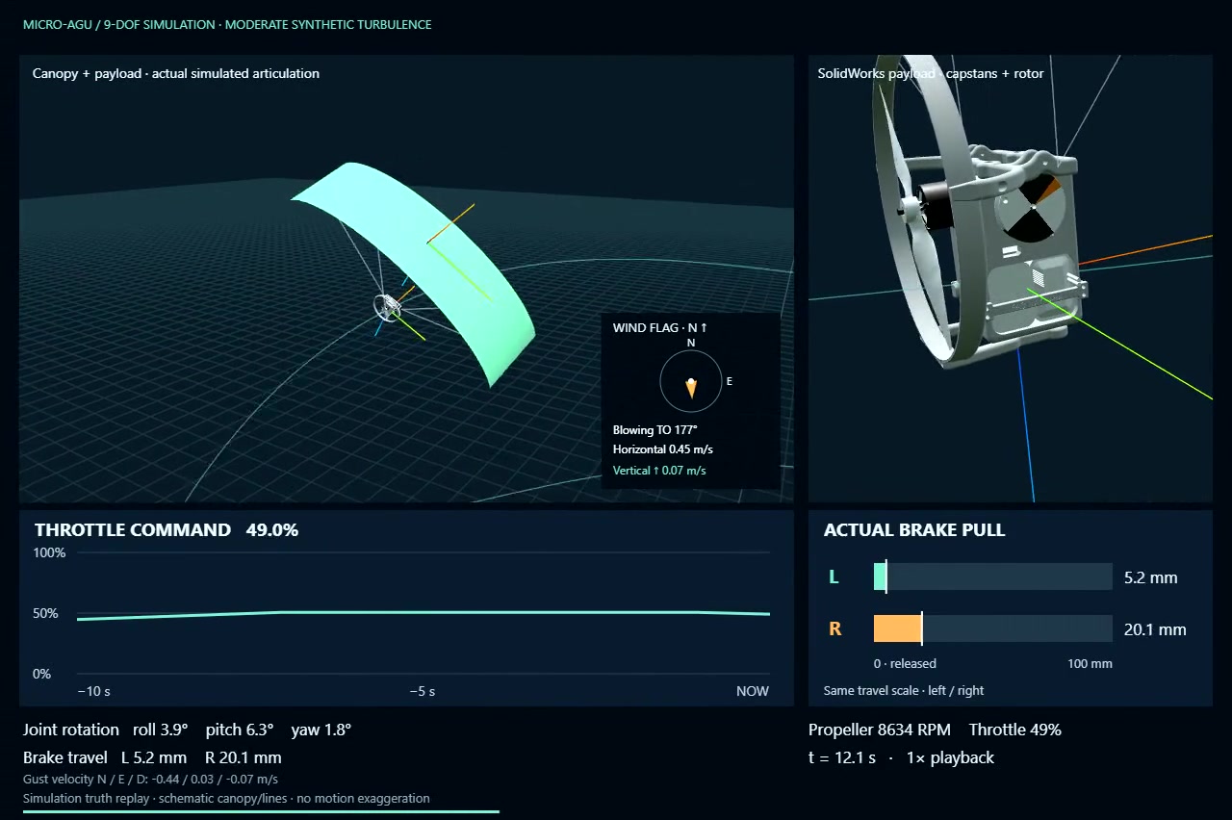
docs/assets/viewer/reversing-turn-controls-plain.jpg
