DavidIngraham/ArduPilot-tinkering/docs/assets/viewer/reversing-turn-turbulence-marked.jpg

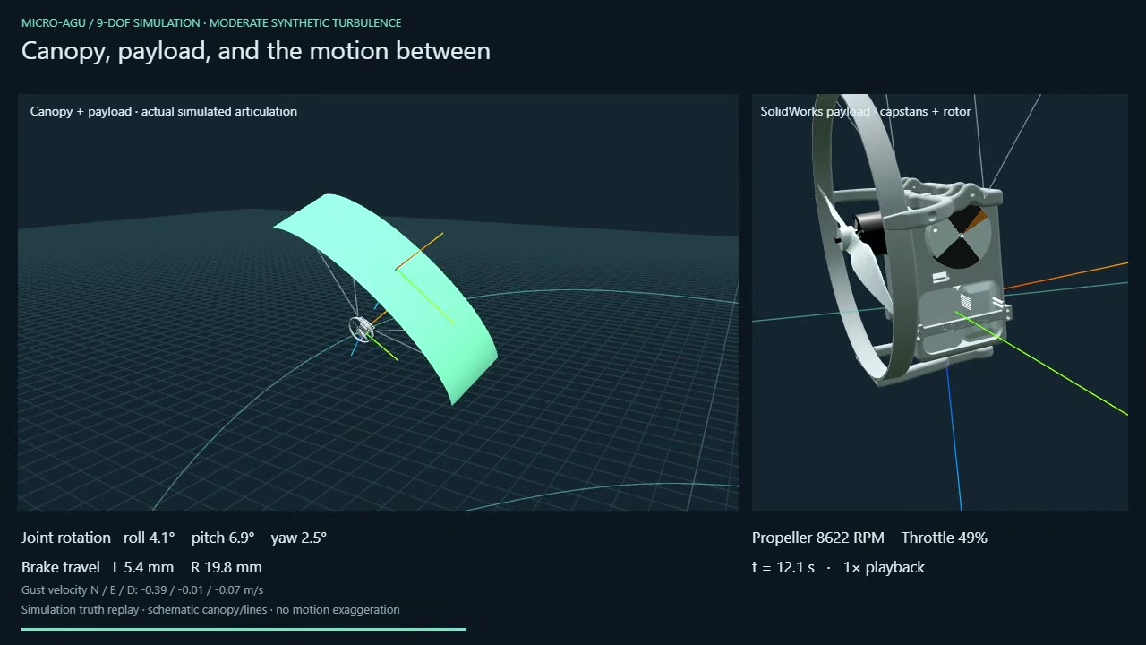
docs/assets/viewer/reversing-turn-turbulence-marked.jpg
