DavidIngraham/ArduPilot-tinkering/docs/assets/viewer/reversing-turn.jpg

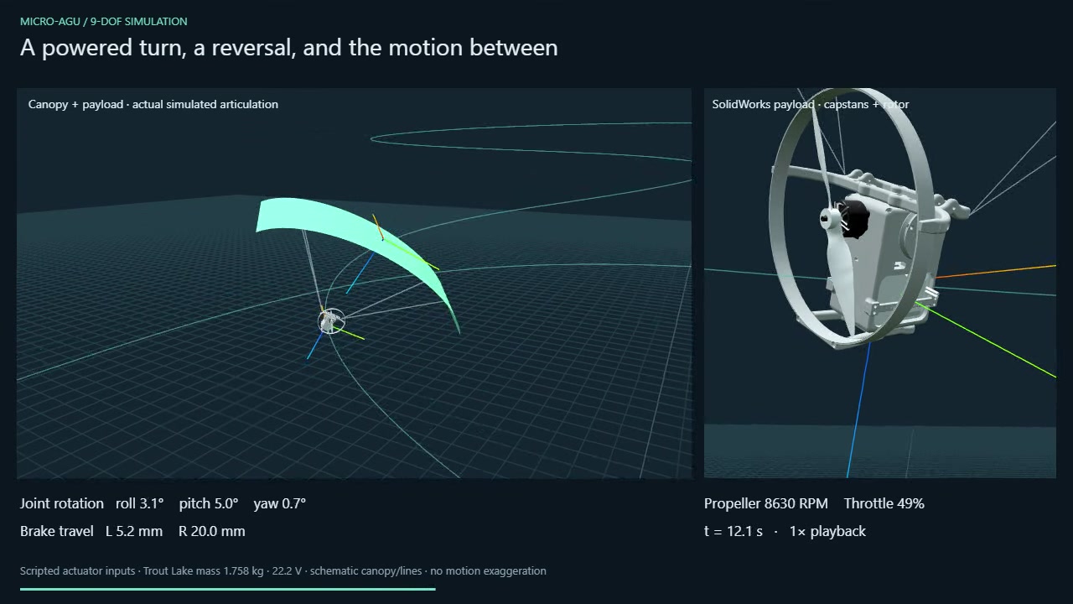
docs/assets/viewer/reversing-turn.jpg
