DavidIngraham/ArduPilot-tinkering/scratch/plane-trajectory/line-transition-comparison.png

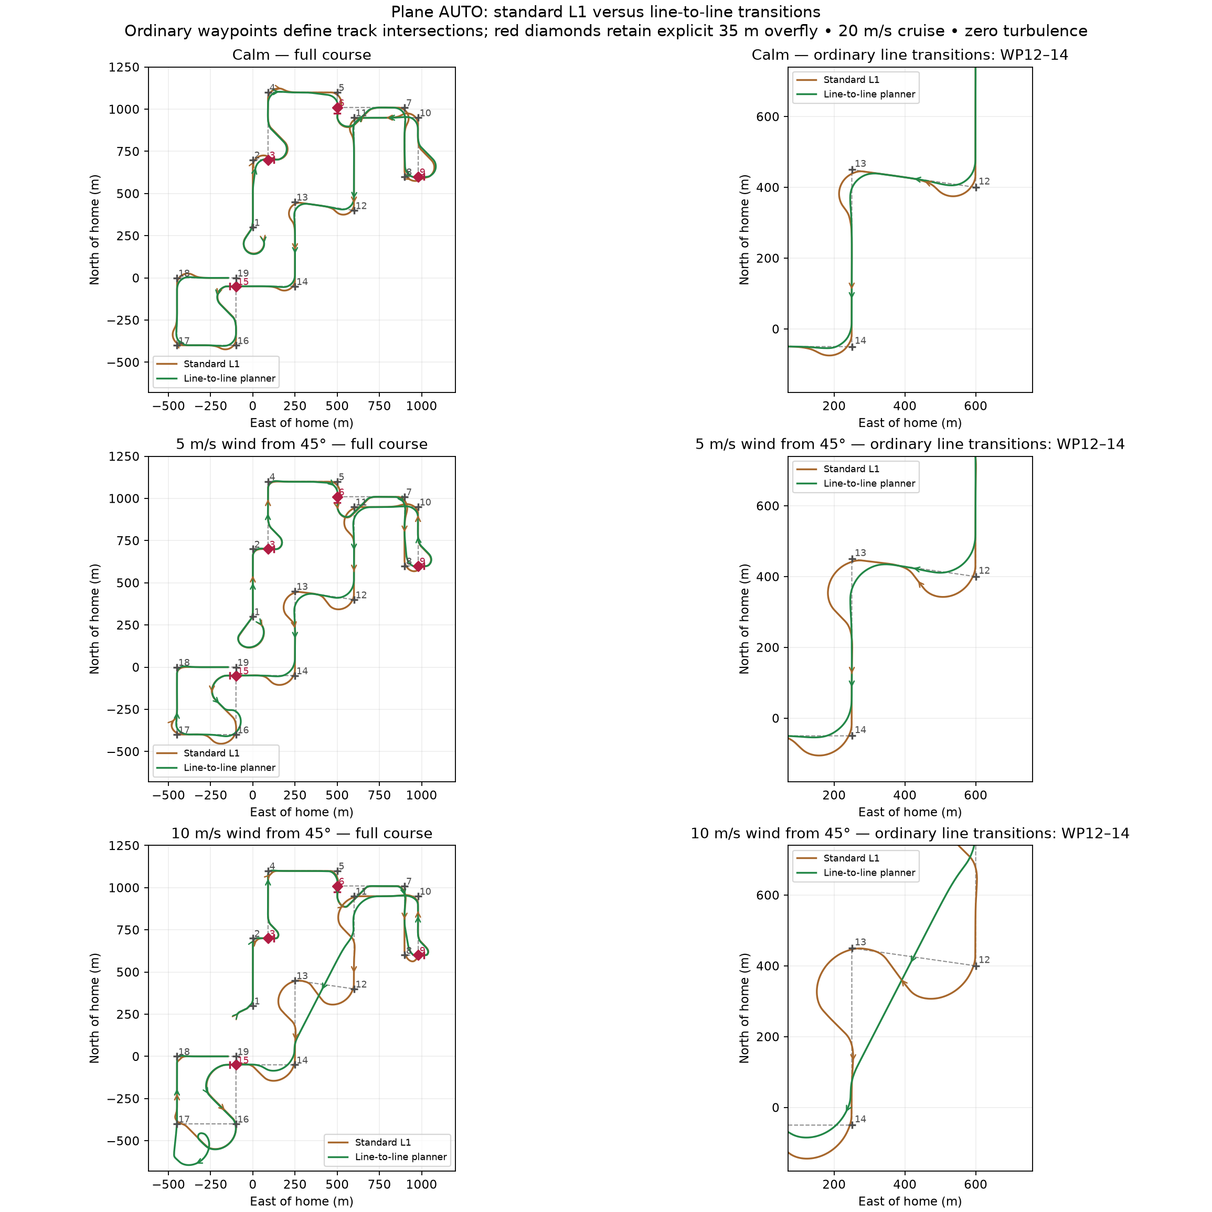
scratch/plane-trajectory/line-transition-comparison.png
