DavidIngraham/ArduPilot-tinkering/scratch/plane-trajectory/mission-comparison.png

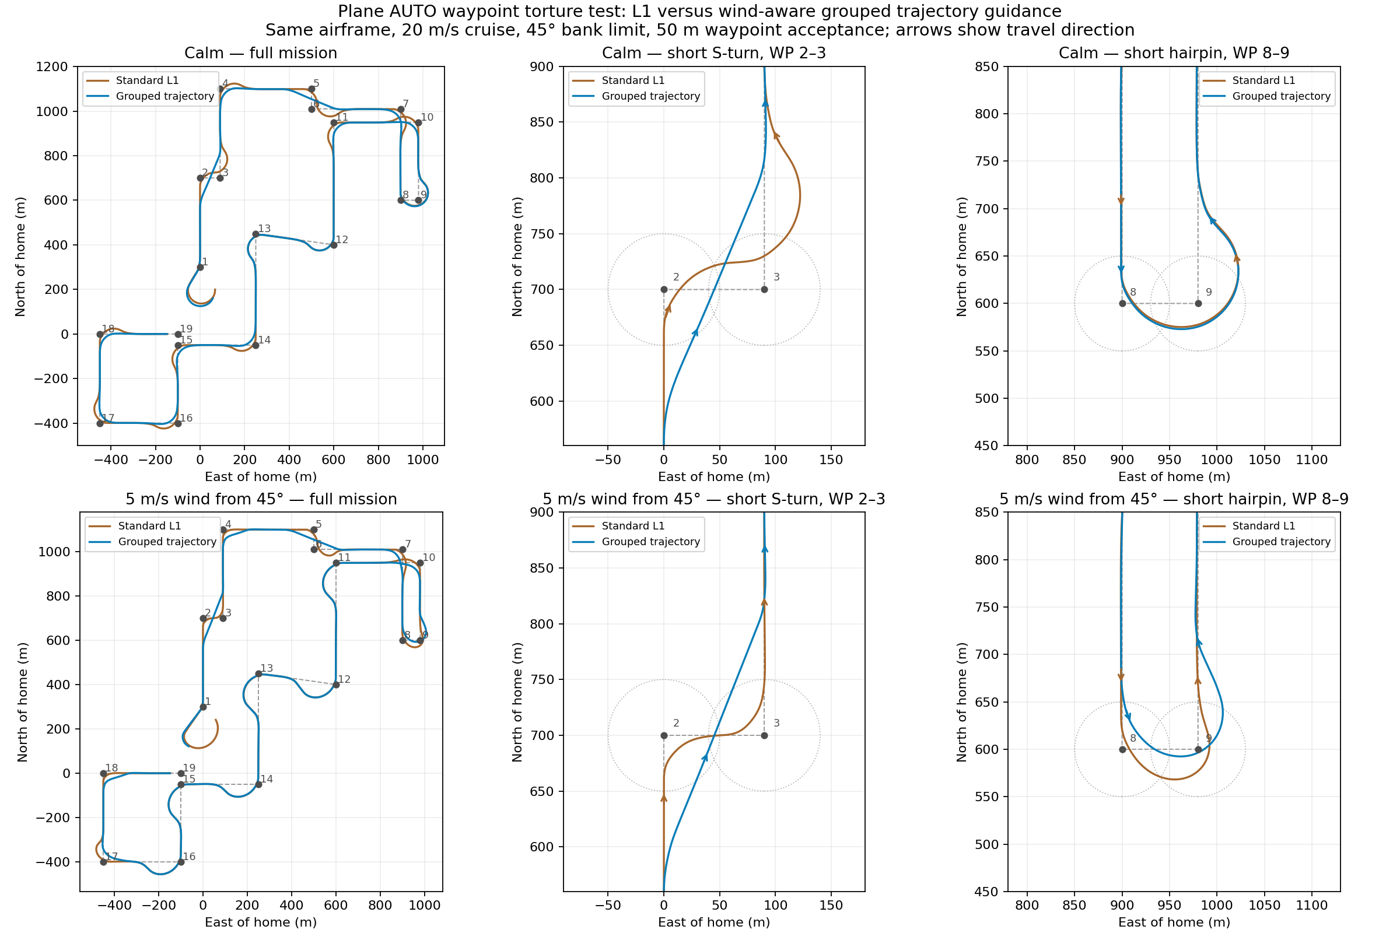
scratch/plane-trajectory/mission-comparison.png
