DavidIngraham/ArduPilot-tinkering/scratch/plane-trajectory/overfly-mission-comparison.png

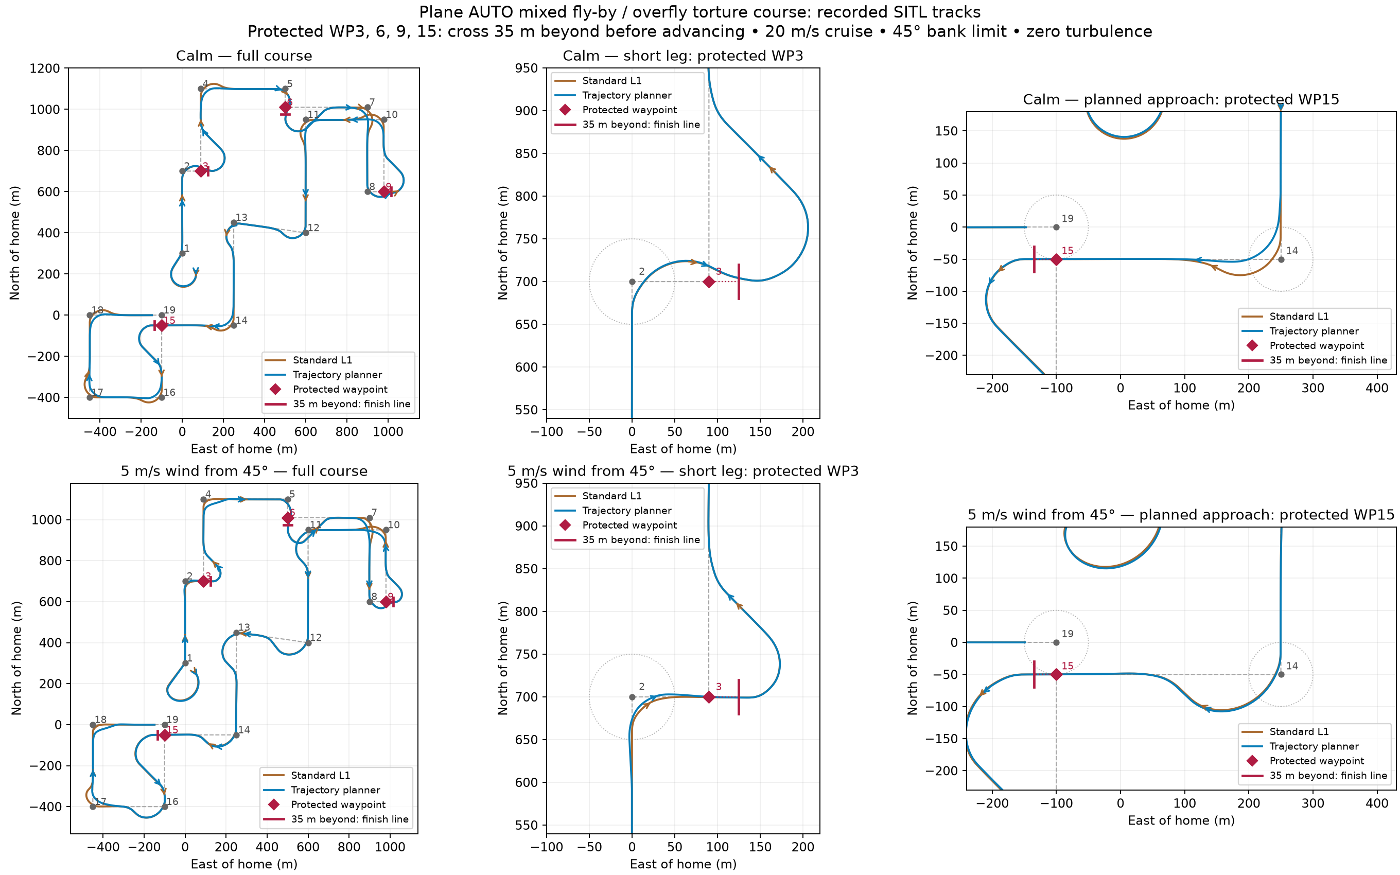
scratch/plane-trajectory/overfly-mission-comparison.png
