DavidIngraham/ArduPilot-tinkering/scratch/plane-trajectory/raster-matrix/raster-summary-matrix.png

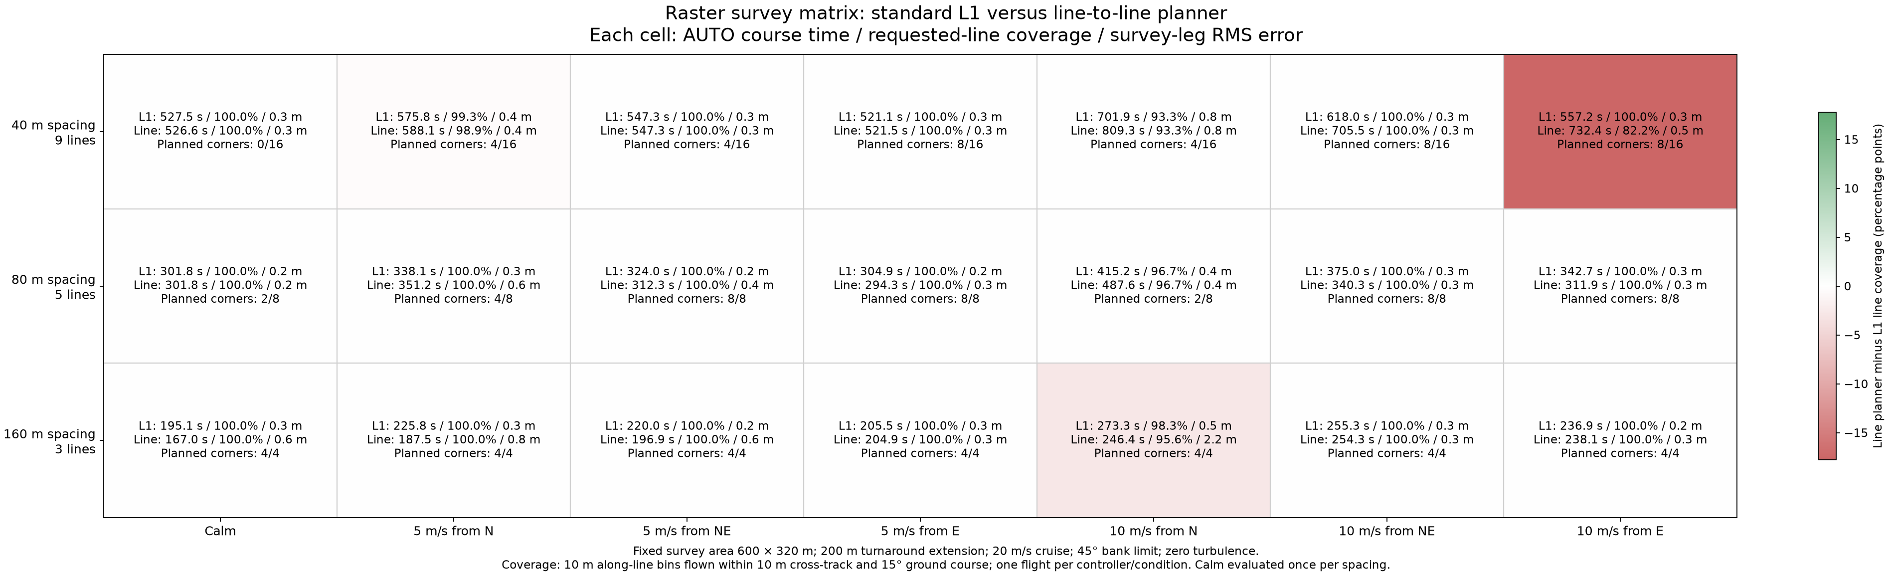
scratch/plane-trajectory/raster-matrix/raster-summary-matrix.png
