DavidIngraham/ArduPilot-tinkering/scratch/plane-trajectory/raster-matrix/raster-track-matrix.png

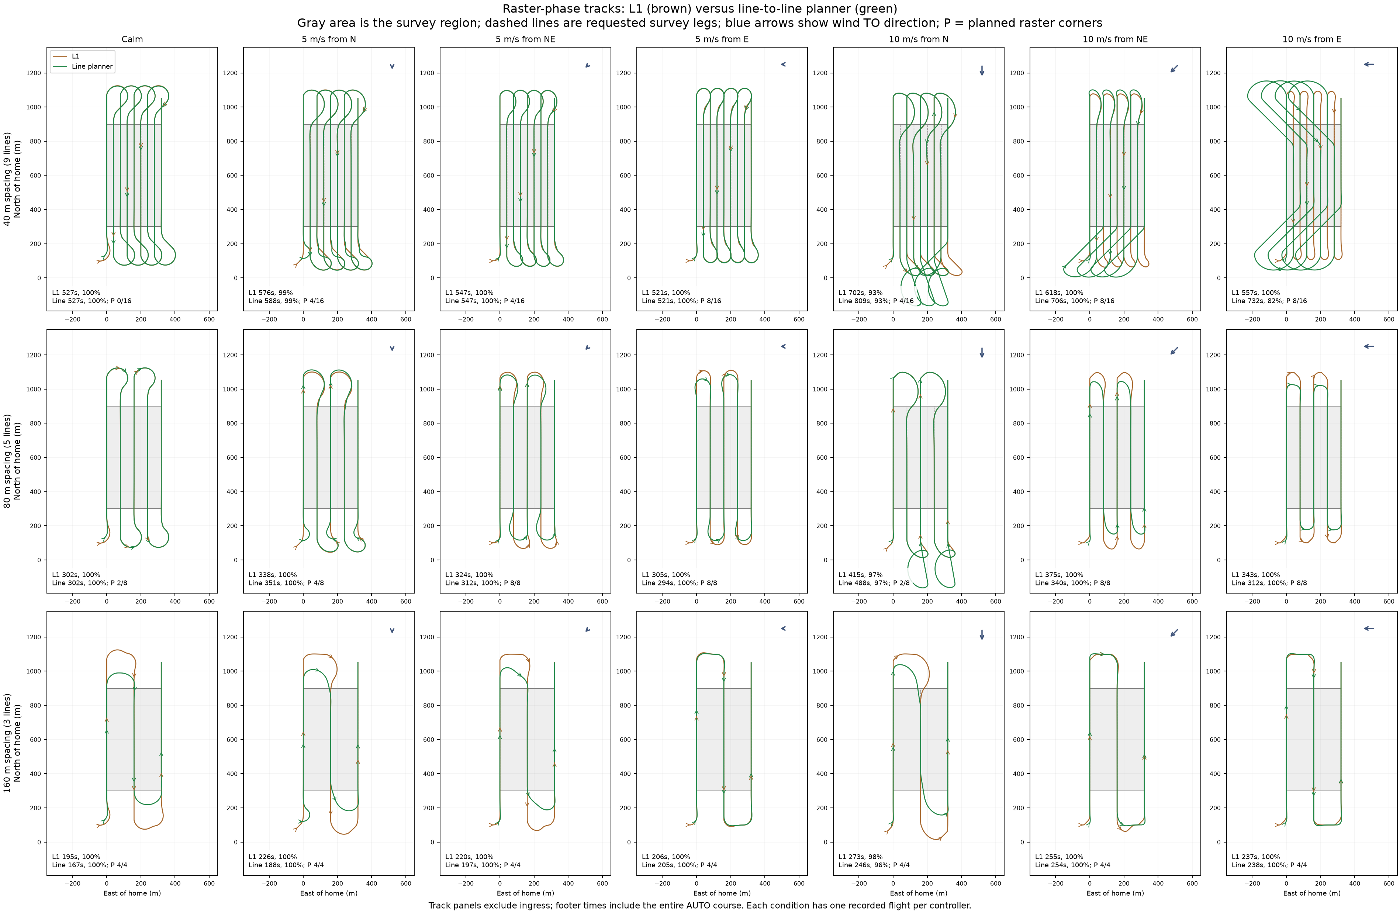
scratch/plane-trajectory/raster-matrix/raster-track-matrix.png
