DavidIngraham/ArduPilot-tinkering/scratch/plane-trajectory/strong-wind-mission-comparison.png

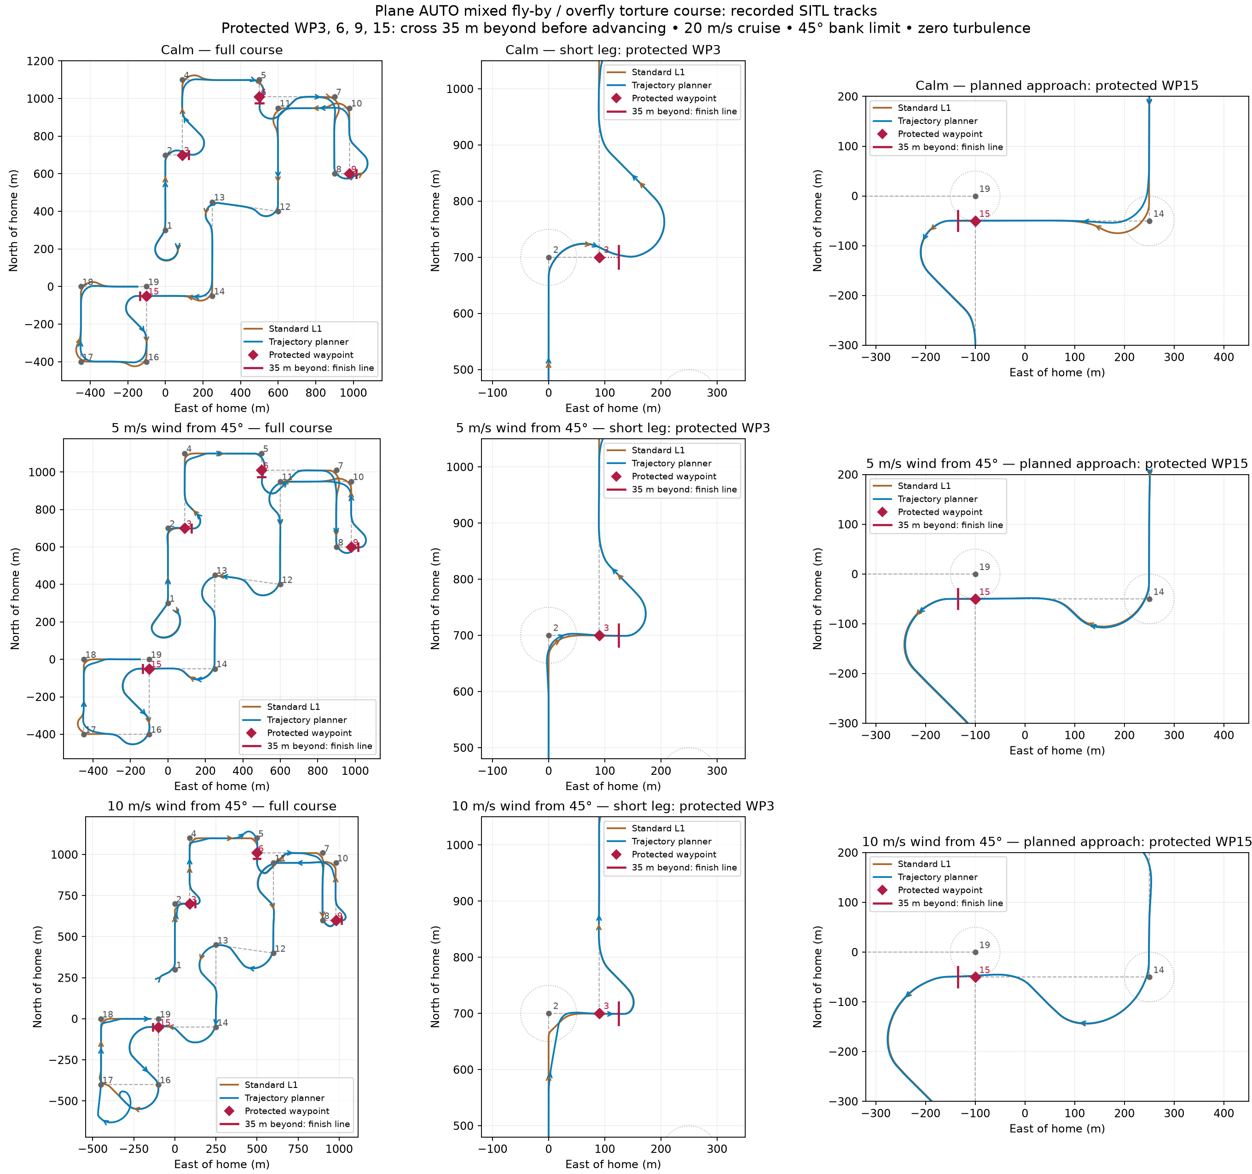
scratch/plane-trajectory/strong-wind-mission-comparison.png
