DavidIngraham/ArduPilot-tinkering/scratch/plane-trajectory/trial07/calm.png

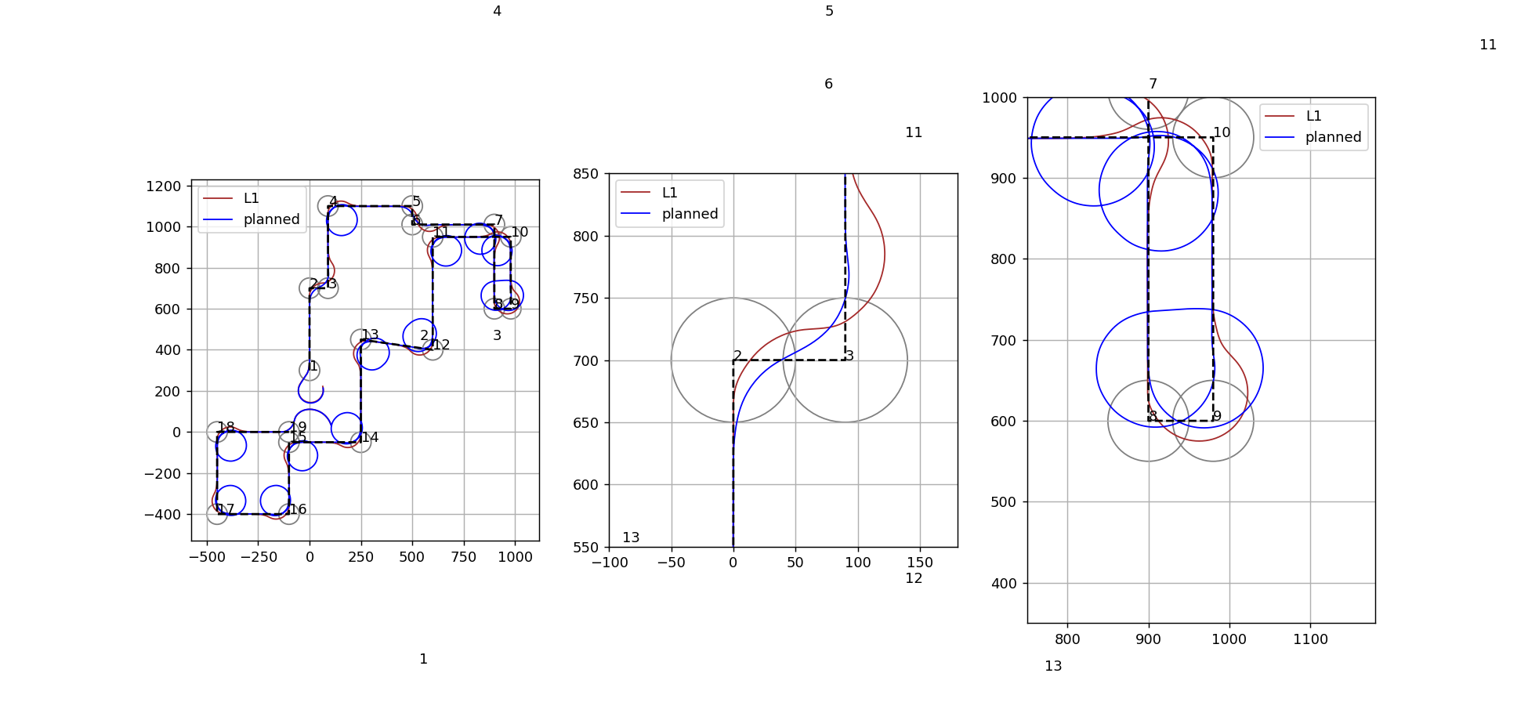
scratch/plane-trajectory/trial07/calm.png
