DavidIngraham/ArduPilot-tinkering/viewer/tests/browser/visual.spec.ts-snapshots/pitch-fbd-linux.png

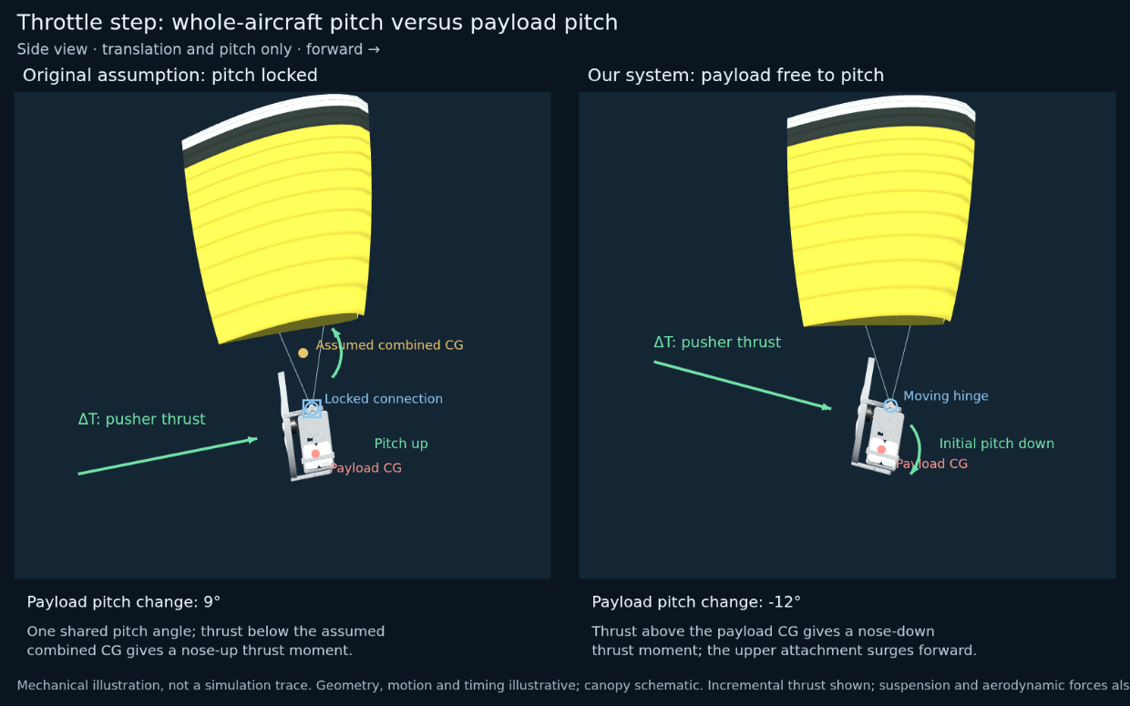
viewer/tests/browser/visual.spec.ts-snapshots/pitch-fbd-linux.png
