DavidIngraham/ArduPilot-tinkering/viewer/tests/browser/visual.spec.ts-snapshots/rigging-comparison-linux.png

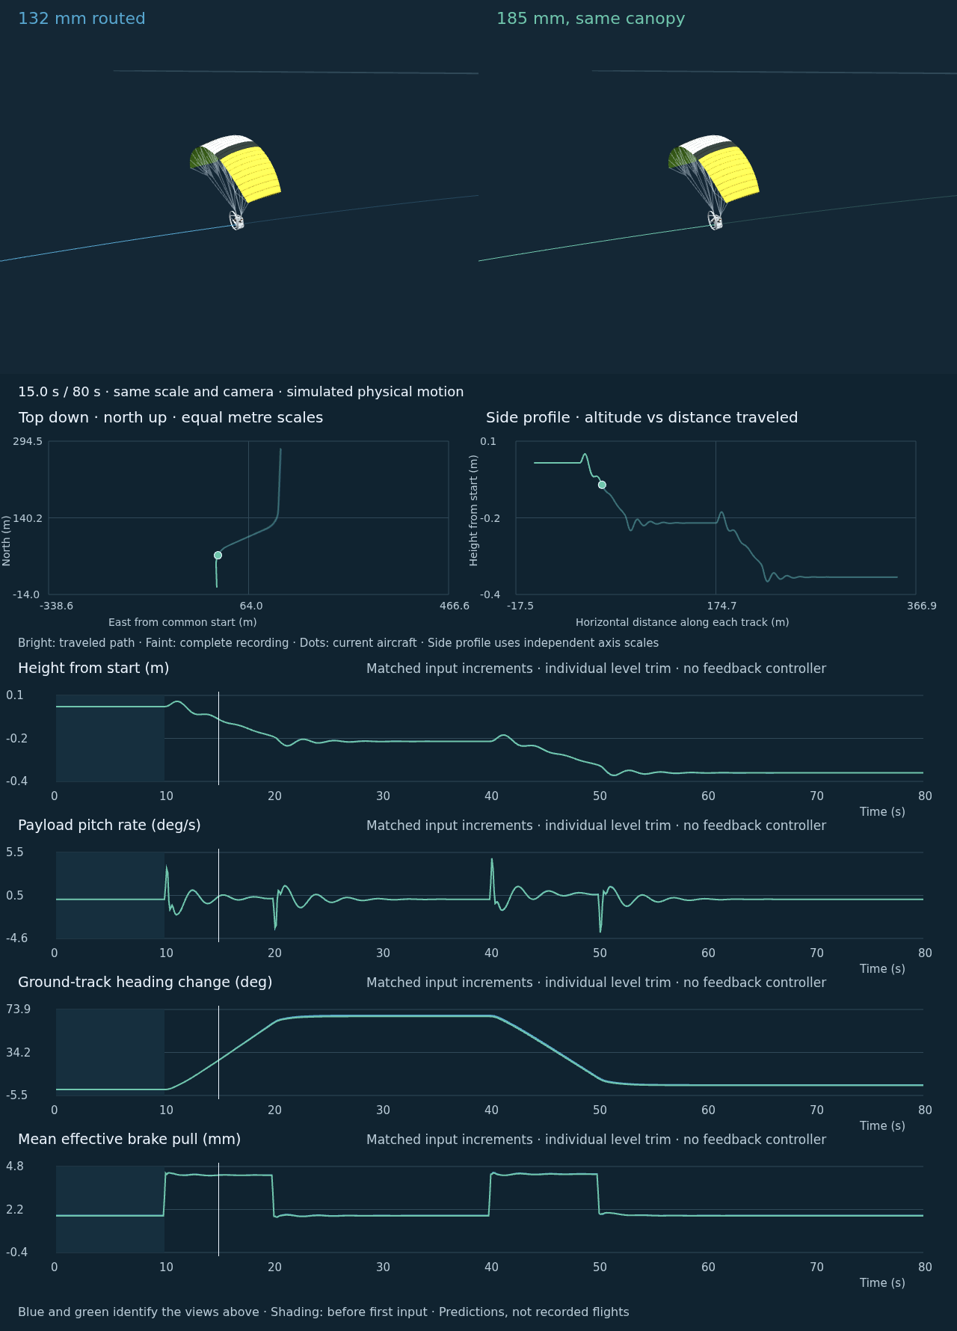
viewer/tests/browser/visual.spec.ts-snapshots/rigging-comparison-linux.png
