DavidIngraham/ArduPilot-tinkering/viewer/tests/browser/visual.spec.ts-snapshots/trim-launch-linux.png

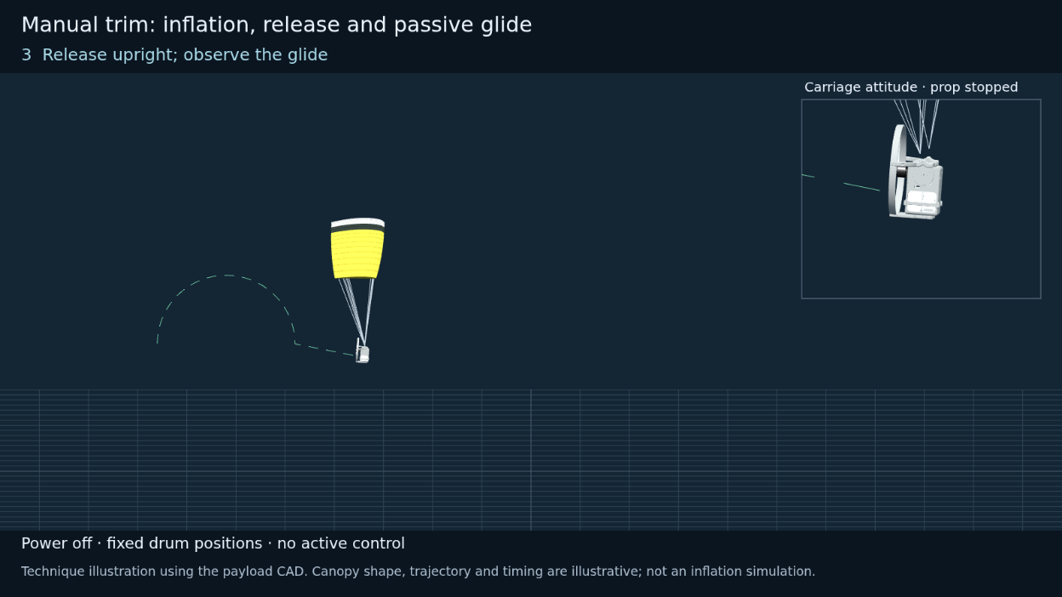
viewer/tests/browser/visual.spec.ts-snapshots/trim-launch-linux.png
