DavidIngraham/ArduPilot-tinkering/scratch/plane-trajectory/raster-soft-turn-cost/raster-summary-matrix.pdf

## Raster survey matrix: standard L1 versus line-to-line planner Each cell: AUTO course time / requested-line coverage / survey-leg RMS error

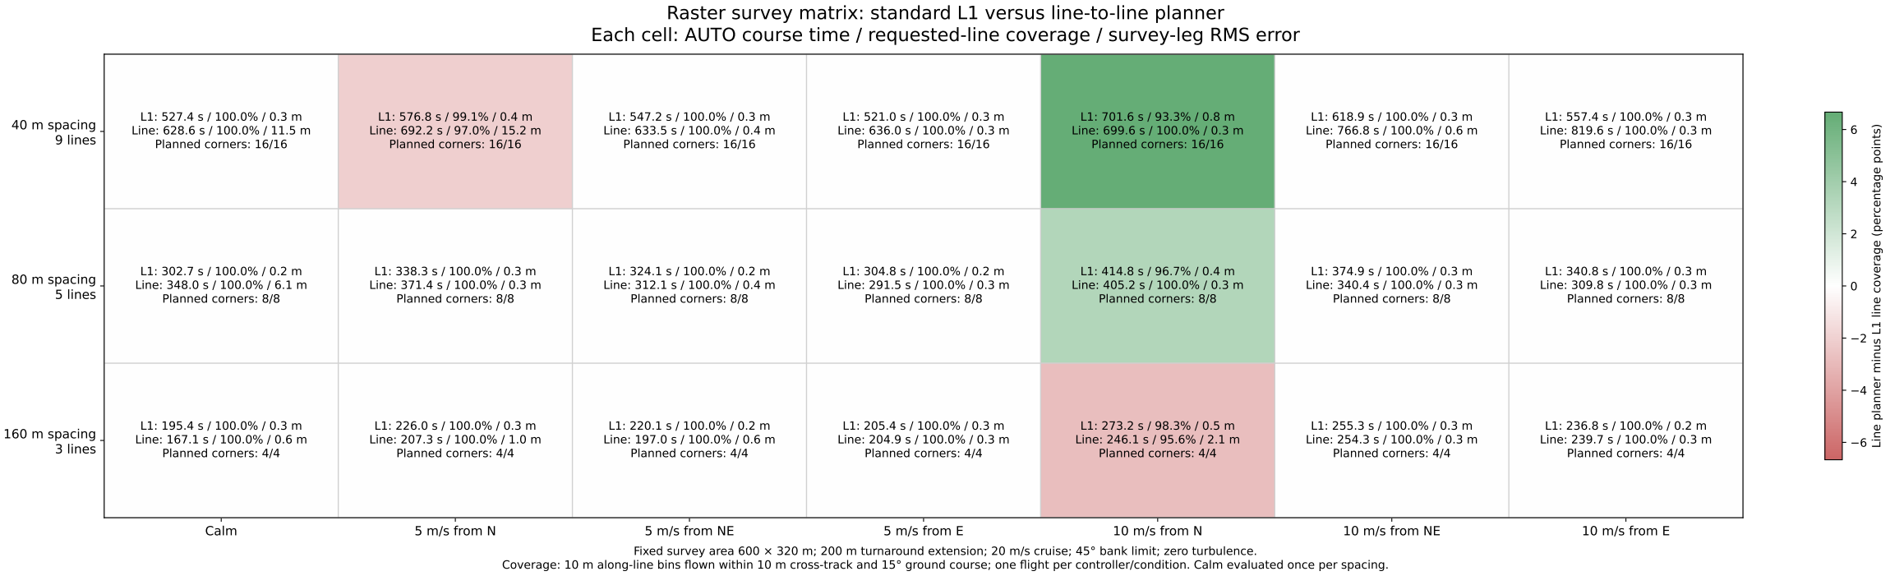
[picture p87: page 1]

Calm | 5 m/s from N | 5 m/s from NE | 5 m/s from E | 10 m/s from N | 10 m/s from NE | 10 m/s from E

40 m spacing
9 lines

80 m spacing
5 lines

160 m spacing
3 lines
L1: 527.4 s / 100.0% / 0.3 m Line: 628.6 s / 100.0% / 11.5 m Planned corners: 16/16 | L1: 576.8 s / 99.1% / 0.4 m Line: 692.2 s / 97.0% / 15.2 m Planned corners: 16/16 | L1: 547.2 s / 100.0% / 0.3 m Line: 633.5 s / 100.0% / 0.4 m Planned corners: 16/16 | L1: 521.0 s / 100.0% / 0.3 m Line: 636.0 s / 100.0% / 0.3 m Planned corners: 16/16 | L1: 701.6 s / 93.3% / 0.8 m Line: 699.6 s / 100.0% / 0.3 m Planned corners: 16/16 | L1: 618.9 s / 100.0% / 0.3 m Line: 766.8 s / 100.0% / 0.6 m Planned corners: 16/16 | L1: 557.4 s / 100.0% / 0.3 m Line: 819.6 s / 100.0% / 0.3 m Planned corners: 16/16
L1: 302.7 s / 100.0% / 0.2 m Line: 348.0 s / 100.0% / 6.1 m Planned corners: 8/8 | L1: 338.3 s / 100.0% / 0.3 m Line: 371.4 s / 100.0% / 0.3 m Planned corners: 8/8 | L1: 324.1 s / 100.0% / 0.2 m Line: 312.1 s / 100.0% / 0.4 m Planned corners: 8/8 | L1: 304.8 s / 100.0% / 0.2 m Line: 291.5 s / 100.0% / 0.3 m Planned corners: 8/8 | L1: 414.8 s / 96.7% / 0.4 m Line: 405.2 s / 100.0% / 0.3 m Planned corners: 8/8 | L1: 374.9 s / 100.0% / 0.3 m Line: 340.4 s / 100.0% / 0.3 m Planned corners: 8/8 | L1: 340.8 s / 100.0% / 0.3 m Line: 309.8 s / 100.0% / 0.3 m Planned corners: 8/8
L1: 195.4 s / 100.0% / 0.3 m Line: 167.1 s / 100.0% / 0.6 m Planned corners: 4/4 | L1: 226.0 s / 100.0% / 0.3 m Line: 207.3 s / 100.0% / 1.0 m Planned corners: 4/4 | L1: 220.1 s / 100.0% / 0.2 m Line: 197.0 s / 100.0% / 0.6 m Planned corners: 4/4 | L1: 205.4 s / 100.0% / 0.3 m Line: 204.9 s / 100.0% / 0.3 m Planned corners: 4/4 | L1: 273.2 s / 98.3% / 0.5 m Line: 246.1 s / 95.6% / 2.1 m Planned corners: 4/4 | L1: 255.3 s / 100.0% / 0.3 m Line: 254.3 s / 100.0% / 0.3 m Planned corners: 4/4 | L1: 236.8 s / 100.0% / 0.2 m Line: 239.7 s / 100.0% / 0.3 m Planned corners: 4/4
−6

−4

−2

0

2

4

6

Line planner minus L1 line coverage (percentage points)

Fixed survey area 600 × 320 m; 200 m turnaround extension; 20 m/s cruise; 45° bank limit; zero turbulence. Coverage: 10 m along-line bins flown within 10 m cross-track and 15° ground course; one flight per controller/condition. Calm evaluated once per spacing.
