DavidIngraham/ArduPilot-tinkering/scratch/plane-trajectory/raster-soft-turn-cost/raster-track-matrix.pdf

−200 | 0 | 200 | 400 | 600

0

200

400

600

800

1000

1200

### 40 m spacing (9 lines)

### North of home (m)

L1 527s, 100%
Line 629s, 100%; P 16/16

### Calm

L1
Line planner
−200 | 0 | 200 | 400 | 600

0

200

400

600

800

1000

1200

L1 577s, 99%
Line 692s, 97%; P 16/16

### 5 m/s from N

−200 | 0 | 200 | 400 | 600

0

200

400

600

800

1000

1200

L1 547s, 100%
Line 633s, 100%; P 16/16

### 5 m/s from NE

−200 | 0 | 200 | 400 | 600

0

200

400

600

800

1000

1200

L1 521s, 100%
Line 636s, 100%; P 16/16

### 5 m/s from E

−200 | 0 | 200 | 400 | 600

0

200

400

600

800

1000

1200

L1 702s, 93%
Line 700s, 100%; P 16/16

### 10 m/s from N

−200 | 0 | 200 | 400 | 600

0

200

400

600

800

1000

1200

L1 619s, 100%
Line 767s, 100%; P 16/16

### 10 m/s from NE

−200 | 0 | 200 | 400 | 600

0

200

400

600

800

1000

1200

L1 557s, 100%
Line 820s, 100%; P 16/16

### 10 m/s from E

−200 | 0 | 200 | 400 | 600

0

200

400

600

800

1000

1200

### 80 m spacing (5 lines)

### North of home (m)

L1 303s, 100%
Line 348s, 100%; P 8/8
−200 | 0 | 200 | 400 | 600

0

200

400

600

800

1000

1200

L1 338s, 100%
Line 371s, 100%; P 8/8
−200 | 0 | 200 | 400 | 600

0

200

400

600

800

1000

1200

L1 324s, 100%
Line 312s, 100%; P 8/8
−200 | 0 | 200 | 400 | 600

0

200

400

600

800

1000

1200

L1 305s, 100%
Line 292s, 100%; P 8/8
−200 | 0 | 200 | 400 | 600

0

200

400

600

800

1000

1200

L1 415s, 97%
Line 405s, 100%; P 8/8
−200 | 0 | 200 | 400 | 600

0

200

400

600

800

1000

1200

L1 375s, 100%
Line 340s, 100%; P 8/8
−200 | 0 | 200 | 400 | 600

0

200

400

600

800

1000

1200

L1 341s, 100%
Line 310s, 100%; P 8/8
−200 | 0 | 200 | 400 | 600

East of home (m)

0

200

400

600

800

1000

1200

### 160 m spacing (3 lines)

### North of home (m)

L1 195s, 100%
Line 167s, 100%; P 4/4
−200 | 0 | 200 | 400 | 600

East of home (m)

0

200

400

600

800

1000

1200

L1 226s, 100%
Line 207s, 100%; P 4/4
−200 | 0 | 200 | 400 | 600

East of home (m)

0

200

400

600

800

1000

1200

L1 220s, 100%
Line 197s, 100%; P 4/4
−200 | 0 | 200 | 400 | 600

East of home (m)

0

200

400

600

800

1000

1200

L1 205s, 100%
Line 205s, 100%; P 4/4
−200 | 0 | 200 | 400 | 600

East of home (m)

0

200

400

600

800

1000

1200

L1 273s, 98%
Line 246s, 96%; | P 4/4
−200 | 0 | 200 | 400 | 600

East of home (m)

0

200

400

600

800

1000

1200

L1 255s, 100%
Line 254s, 100%; P 4/4
−200 | 0 | 200 | 400 | 600

East of home (m)

0

200

400

600

800

1000

1200

L1 237s, 100%
Line 240s, 100%; P 4/4

# Raster-phase tracks: L1 (brown) versus line-to-line planner (green)

Gray area is the survey region; dashed lines are requested survey legs; blue arrows show wind TO direction; P = planned raster corners

Track panels exclude ingress; footer times include the entire AUTO course. Each condition has one recorded flight per controller.
