DavidIngraham/ArduPilot-tinkering/scratch/plane-trajectory/raster-soft-turn-cost/raster-track-matrix.png

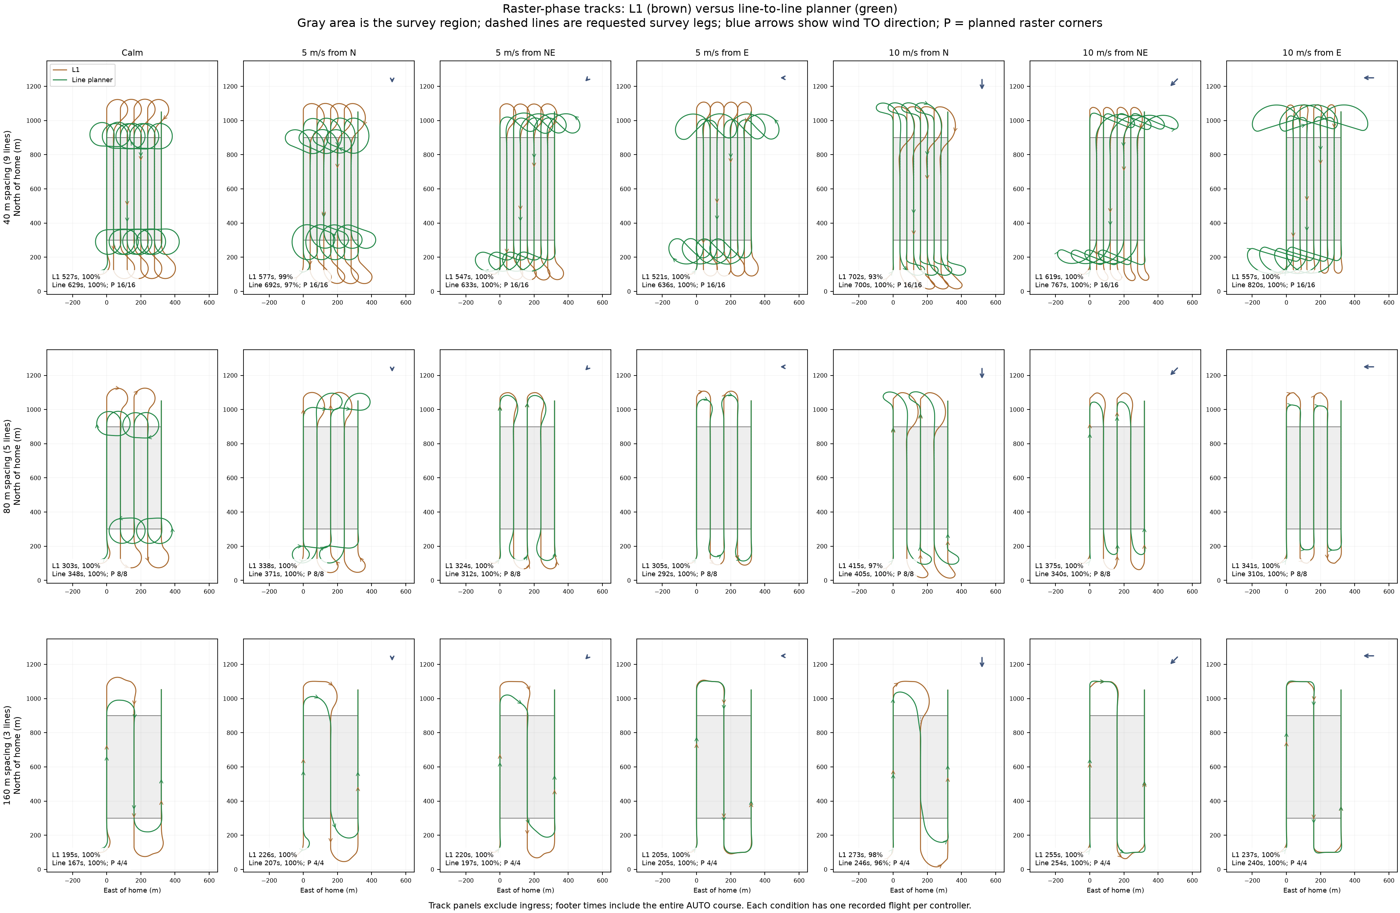
scratch/plane-trajectory/raster-soft-turn-cost/raster-track-matrix.png
