DavidIngraham/ArduPilot-tinkering/cad/solidworks/3115Motor.SLDASM

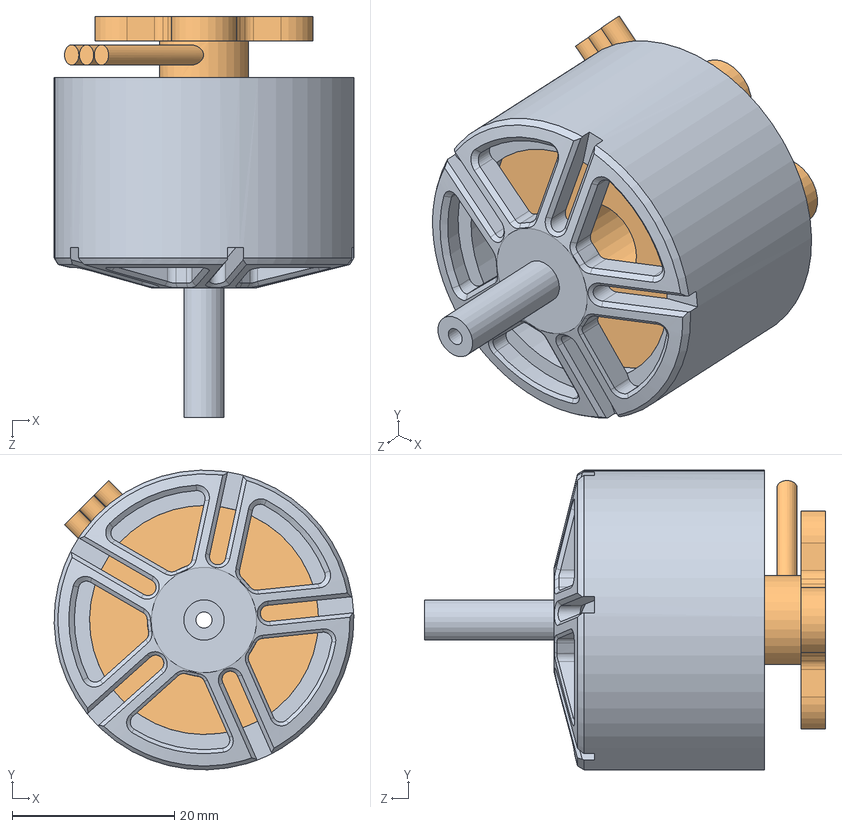
[picture p89: CAD file, 2026-10-14]
cad/solidworks/3115Motor.SLDASM
37.0 x 37.0 x 49.5 mm
Stator
Rotor
