DavidIngraham/ArduPilot-tinkering/cad/solidworks/microAGU.SLDASM

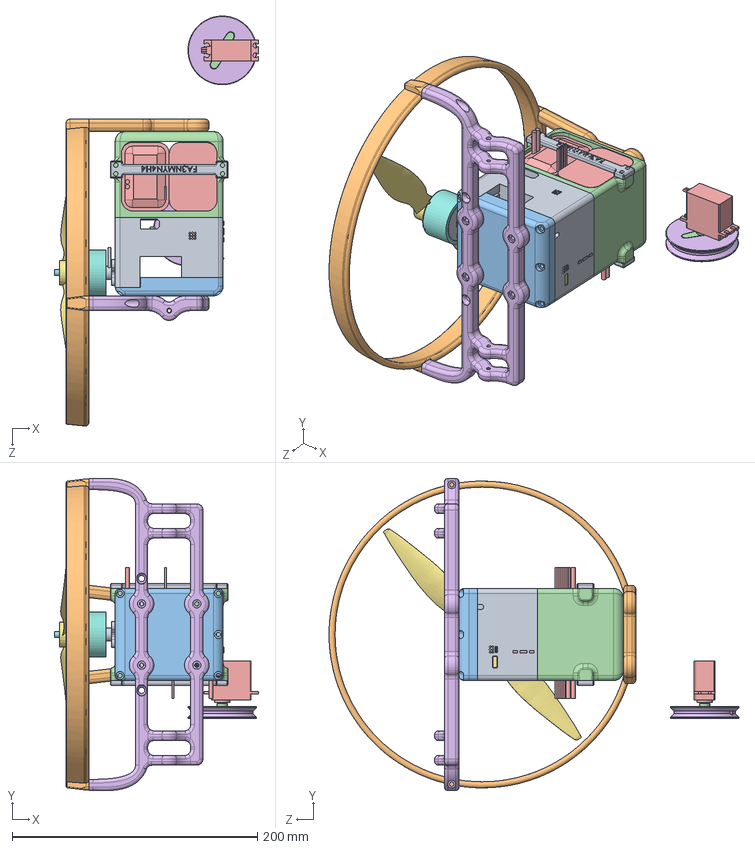
[picture p90: CAD file, 2026-10-14]
cad/solidworks/microAGU.SLDASM
166.3 x 254.5 x 334.1 mm
Shroud
Stator
Rotor
APC 9x6 CW
SpreaderBarSpar
Nav6S300Lion x 2
BatteryBox
TopBlock
M10Q-5883
CoreBlock
AutoPilot
USBBoard
ControlArm x 2
DS339HV x 2
ServoHorn x 2
ESC
Skid
BatteryGate x 2
