DavidIngraham/ArduPilot-tinkering/cad/solidworks/ServoAssembly.SLDASM

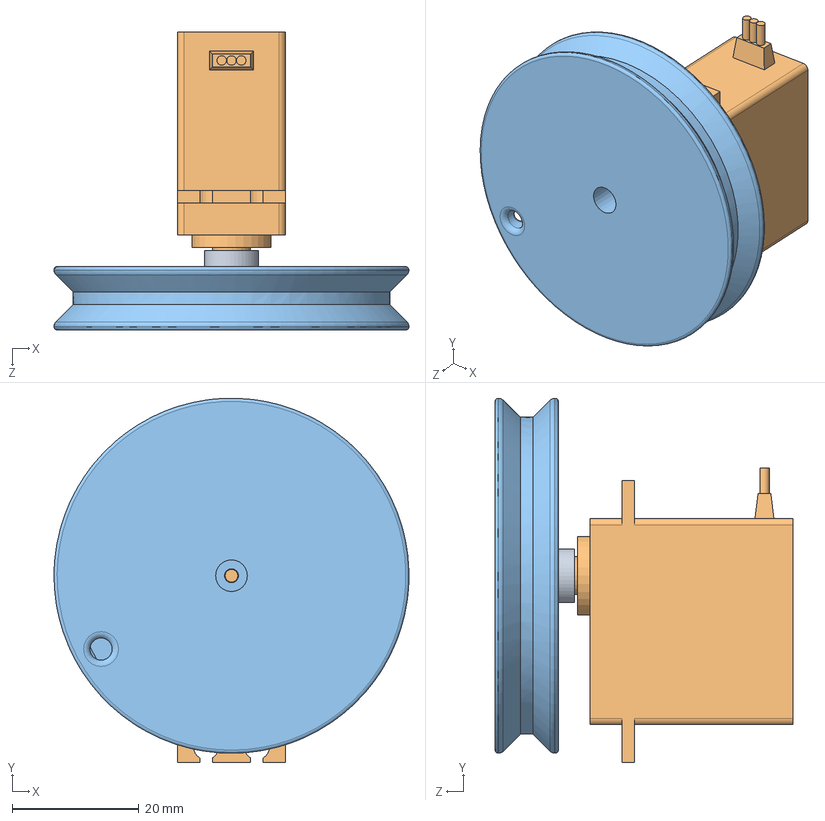
[picture p91: CAD file, 2026-10-14]
cad/solidworks/ServoAssembly.SLDASM
56.0 x 57.5 x 47.0 mm
ControlArm
DS339HV
ServoHorn
