DavidIngraham/ArduPilot-tinkering/cad/solidworks/BatteryBoxAssm.SLDASM

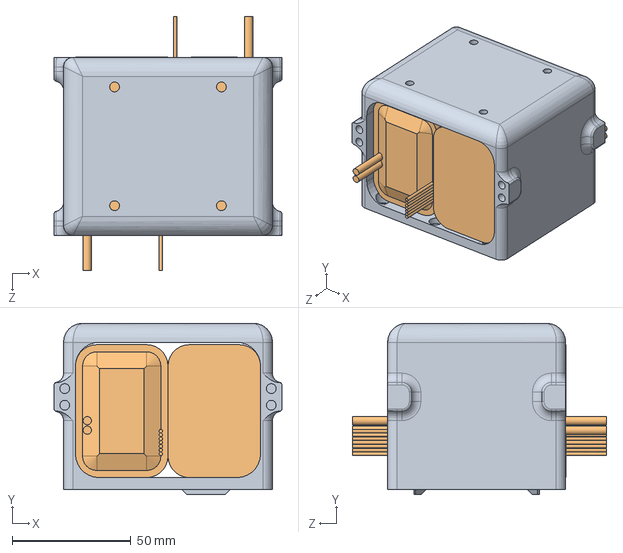
[picture p92: CAD file, 2026-10-14]
cad/solidworks/BatteryBoxAssm.SLDASM
96.0 x 72.2 x 107.0 mm
Nav6S300Lion x 2
BatteryBox
