DavidIngraham/ArduPilot-tinkering/cad/solidworks/SpreaderBarSpar.SLDPRT

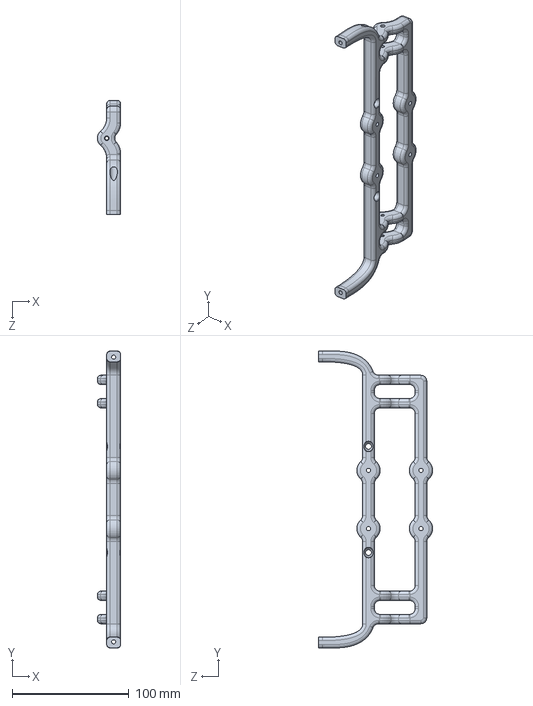
[picture p93: CAD file, 2026-10-15]
cad/solidworks/SpreaderBarSpar.SLDPRT
20.0 x 254.5 x 98.0 mm
