DavidIngraham/ArduPilot-tinkering/cad/solidworks/ServoHorn.SLDPRT

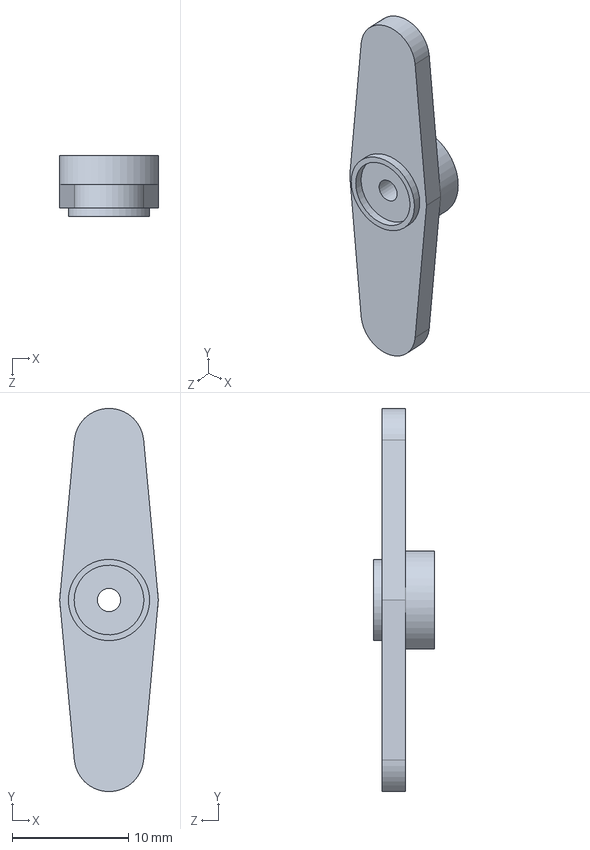
[picture p94: CAD file, 2026-10-14]
cad/solidworks/ServoHorn.SLDPRT
8.50 x 33.0 x 5.25 mm
