DavidIngraham/ArduPilot-tinkering/cad/solidworks/Rotor.SLDPRT

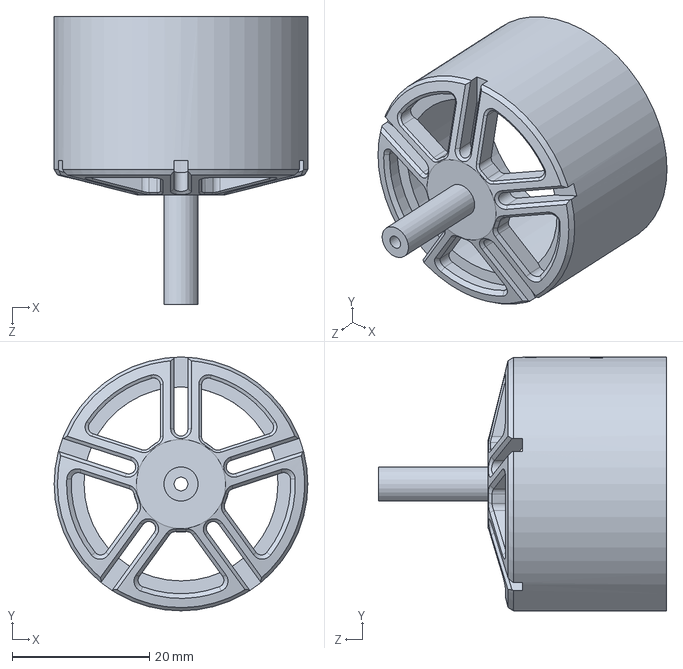
[picture p95: CAD file, 2026-10-14]
cad/solidworks/Rotor.SLDPRT
37.0 x 37.0 x 42.0 mm
