DavidIngraham/ArduPilot-tinkering/cad/solidworks/BatteryBox.SLDPRT

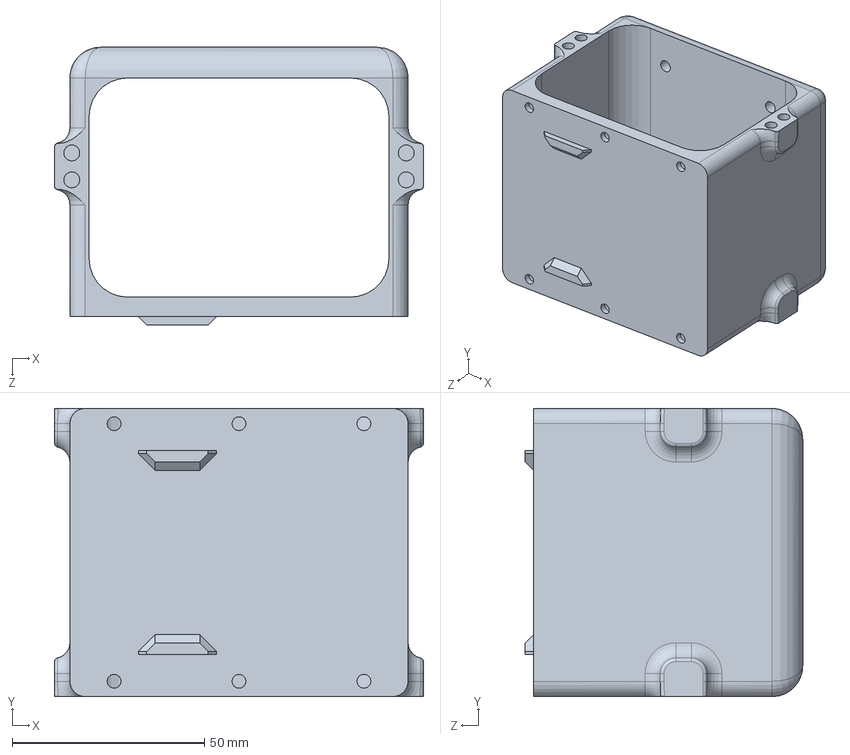
[picture p96: CAD file, 2026-10-14]
cad/solidworks/BatteryBox.SLDPRT
96.0 x 75.0 x 72.2 mm
