DavidIngraham/ArduPilot-tinkering/cad/solidworks/ControlArm.SLDPRT

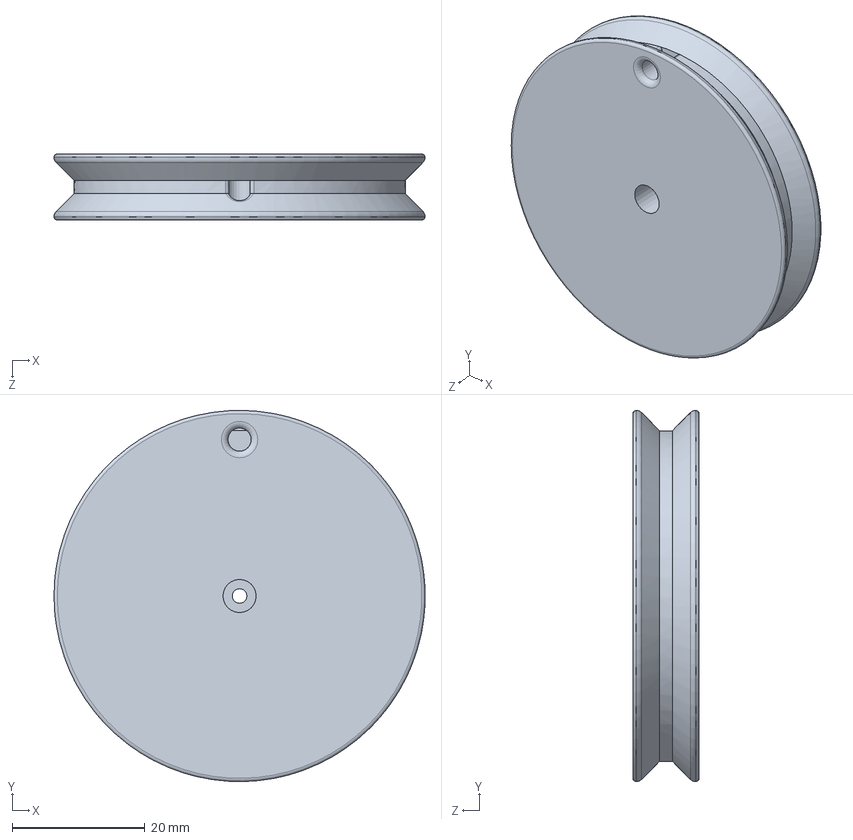
[picture p97: CAD file, 2026-10-14]
cad/solidworks/ControlArm.SLDPRT
56.0 x 56.0 x 10.0 mm
