DavidIngraham/ArduPilot-tinkering/cad/solidworks/CoreBlock.SLDPRT

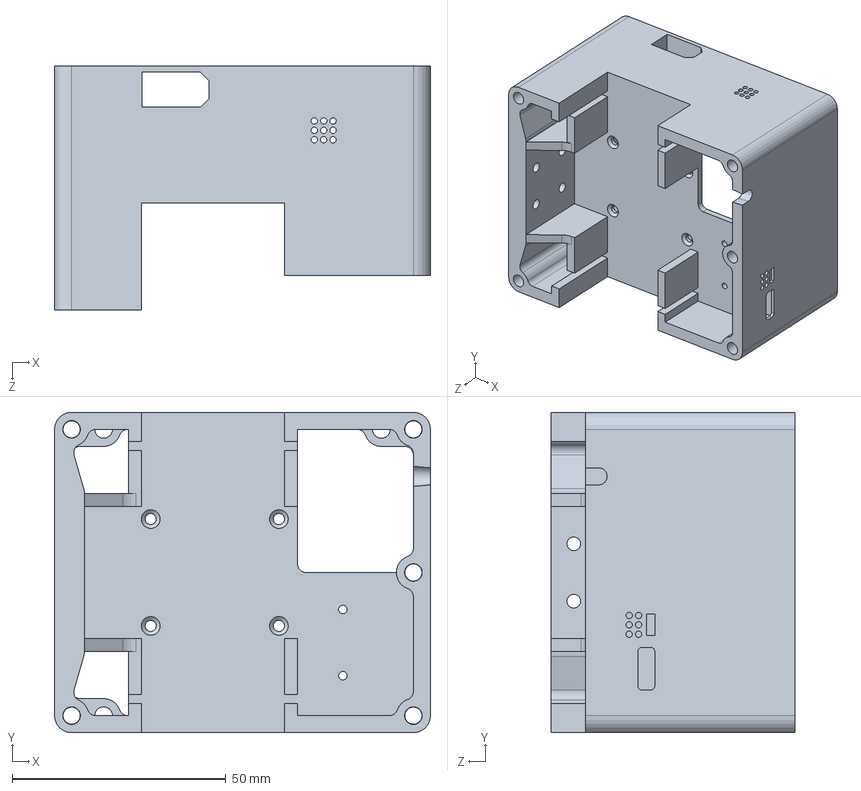
[picture p98: CAD file, 2026-10-14]
cad/solidworks/CoreBlock.SLDPRT
88.0 x 75.0 x 57.0 mm
