DavidIngraham/ArduPilot-tinkering/cad/solidworks/ESC.SLDPRT

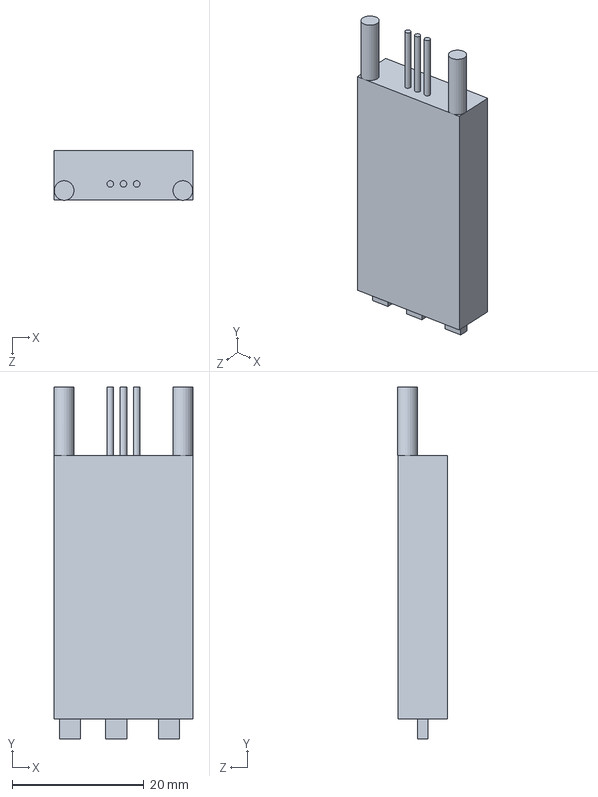
[picture p99: CAD file, 2026-10-14]
cad/solidworks/ESC.SLDPRT
21.0 x 53.4 x 7.55 mm
