DavidIngraham/ArduPilot-tinkering/cad/solidworks/Nav6S300Lion.SLDPRT

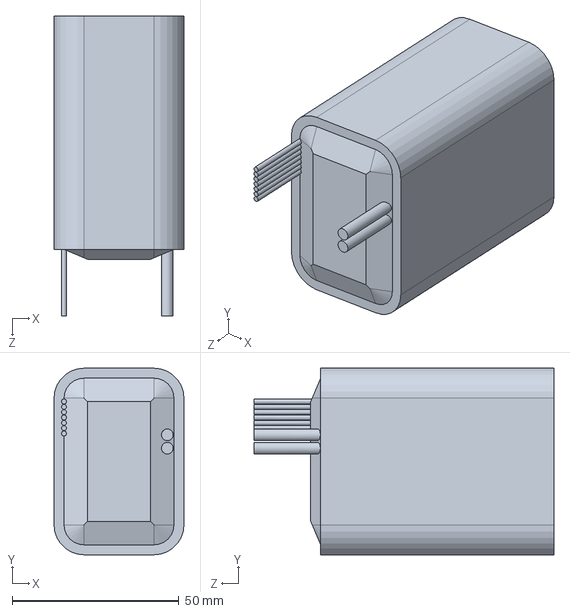
[picture p100: CAD file, 2026-10-14]
cad/solidworks/Nav6S300Lion.SLDPRT
39.0 x 56.0 x 90.0 mm
