DavidIngraham/ArduPilot-tinkering/cad/solidworks/APC 9x6 CW.SLDPRT

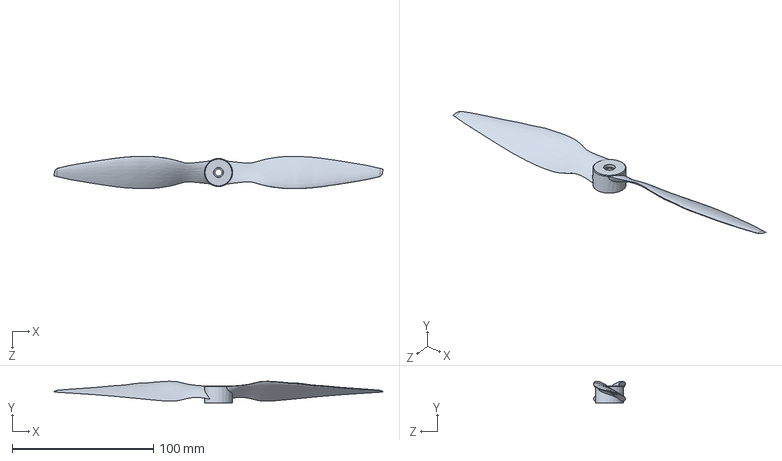
[picture p101: CAD file, 2026-10-14]
cad/solidworks/APC 9x6 CW.SLDPRT
232.6 x 15.2 x 22.9 mm
