DavidIngraham/ArduPilot-tinkering/cad/solidworks/Stator.SLDPRT

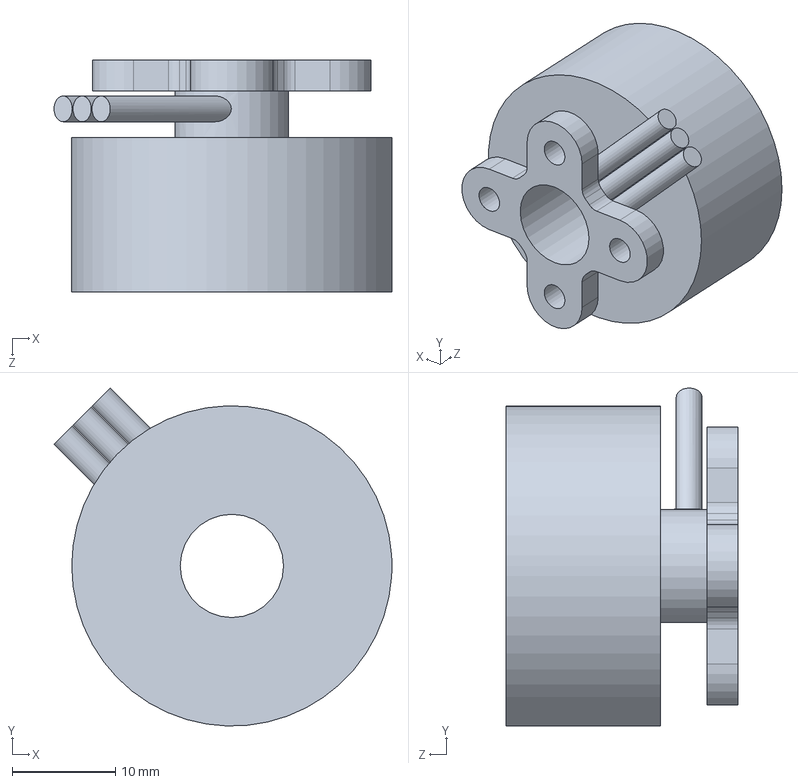
[picture p102: CAD file, 2026-10-14]
cad/solidworks/Stator.SLDPRT
32.7 x 32.7 x 22.5 mm
