DavidIngraham/ArduPilot-tinkering/cad/solidworks/USBBoard.SLDPRT

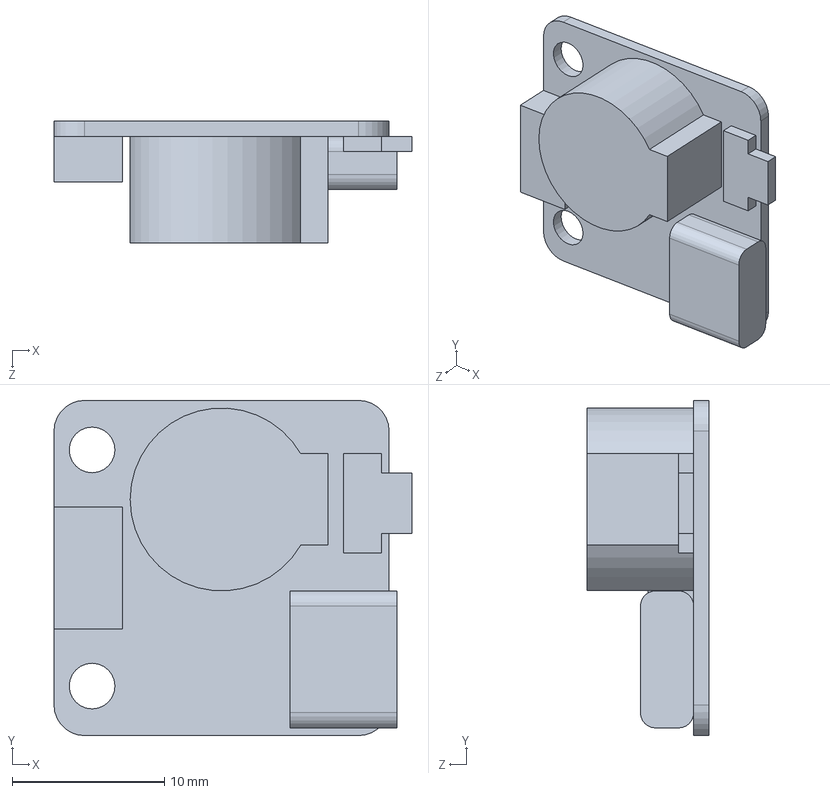
[picture p103: CAD file, 2026-10-14]
cad/solidworks/USBBoard.SLDPRT
23.5 x 22.0 x 8.00 mm
