DavidIngraham/ArduPilot-tinkering/cad/solidworks/TopBlock.SLDPRT

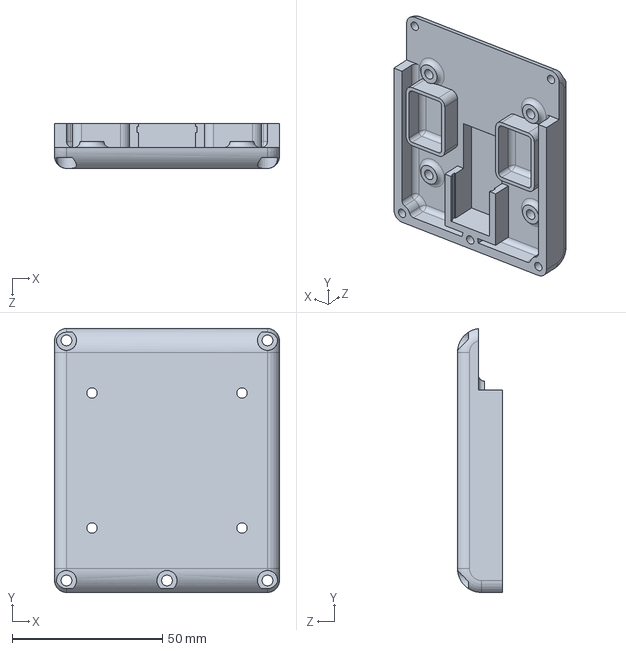
[picture p104: CAD file, 2026-10-14]
cad/solidworks/TopBlock.SLDPRT
75.0 x 88.0 x 15.0 mm
