DavidIngraham/ArduPilot-tinkering/cad/solidworks/AutoPilot.SLDPRT

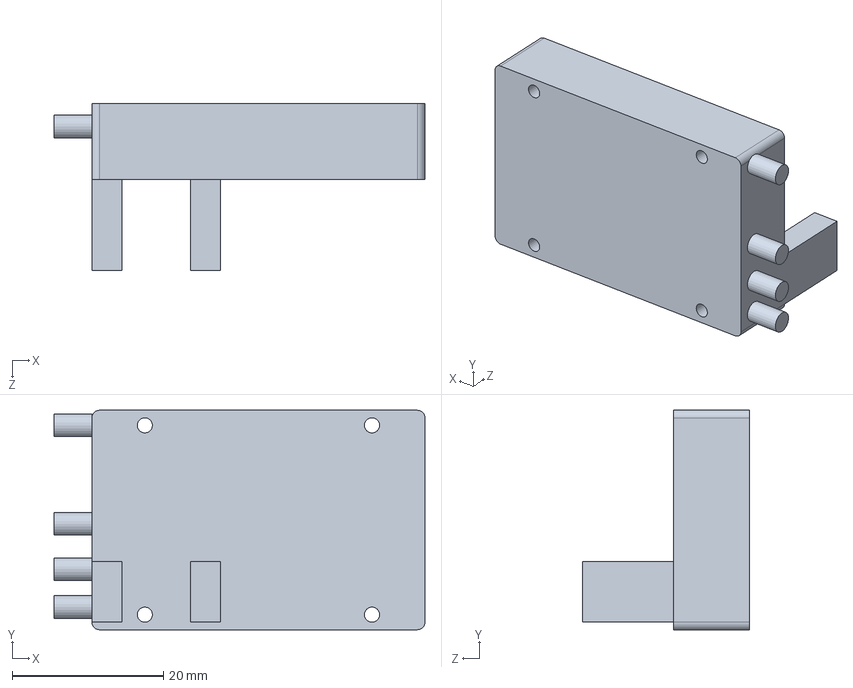
[picture p105: CAD file, 2026-10-14]
cad/solidworks/AutoPilot.SLDPRT
49.0 x 29.0 x 22.0 mm
