DavidIngraham/ArduPilot-tinkering/cad/solidworks/Skid.SLDPRT

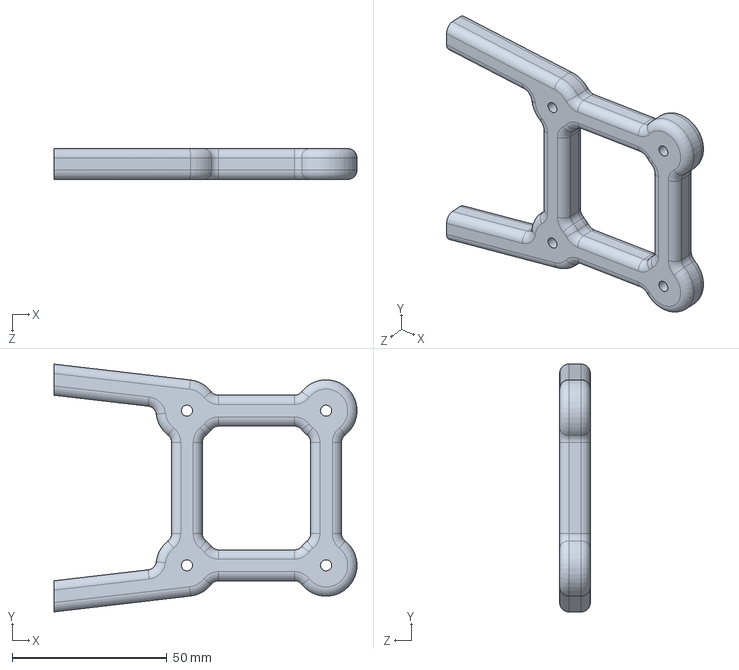
[picture p106: CAD file, 2026-10-14]
cad/solidworks/Skid.SLDPRT
98.0 x 80.1 x 10.0 mm
