DavidIngraham/ArduPilot-tinkering/cad/solidworks/DS339HV.SLDPRT

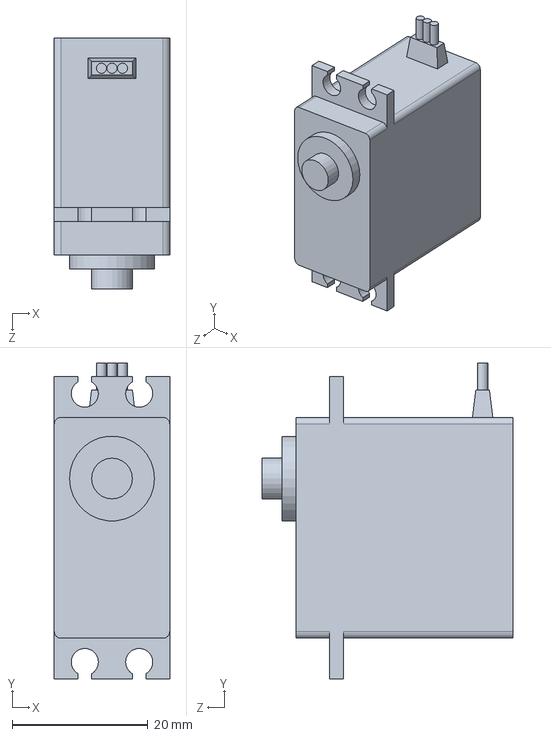
[picture p107: CAD file, 2026-10-14]
cad/solidworks/DS339HV.SLDPRT
17.0 x 46.5 x 37.0 mm
