DavidIngraham/ArduPilot-tinkering/cad/solidworks/SpreaderBar.SLDPRT

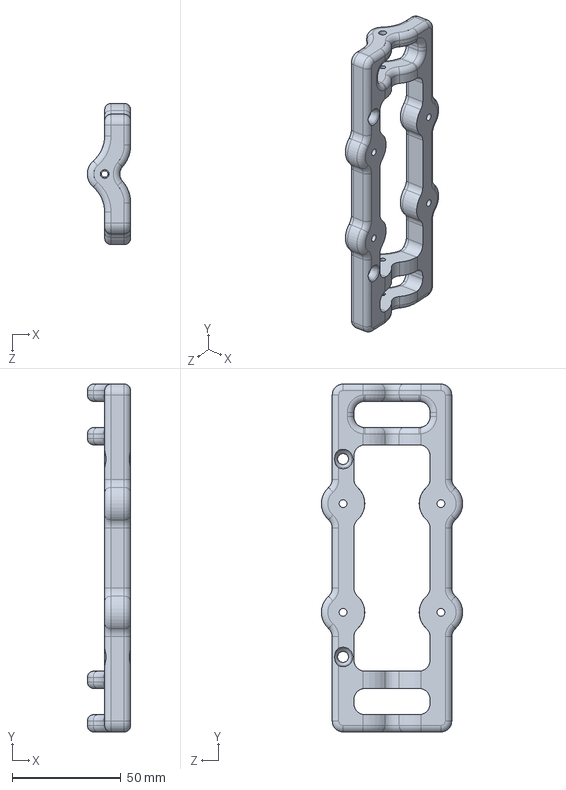
[picture p108: CAD file, 2026-10-14]
cad/solidworks/SpreaderBar.SLDPRT
20.0 x 160.0 x 65.0 mm
