DavidIngraham/ArduPilot-tinkering/cad/solidworks/M10Q-5883.SLDPRT

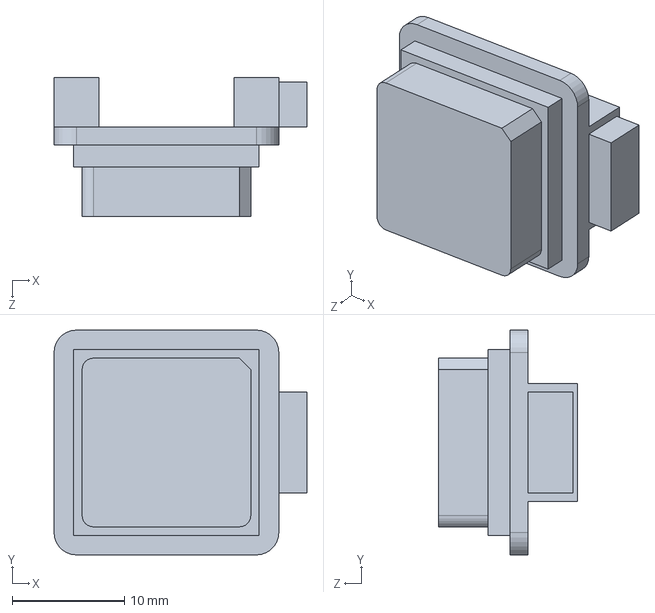
[picture p109: CAD file, 2026-10-14]
cad/solidworks/M10Q-5883.SLDPRT
22.5 x 20.0 x 12.4 mm
