DavidIngraham/ArduPilot-tinkering/cad/solidworks/BatteryGate.SLDPRT

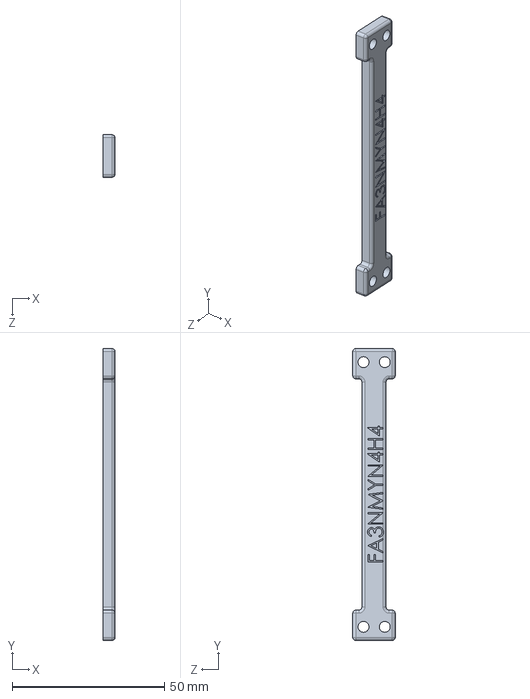
[picture p110: CAD file, 2026-10-14]
cad/solidworks/BatteryGate.SLDPRT
4.00 x 96.0 x 14.0 mm
