DavidIngraham/ArduPilot-tinkering/cad/solidworks/Shroud.SLDPRT

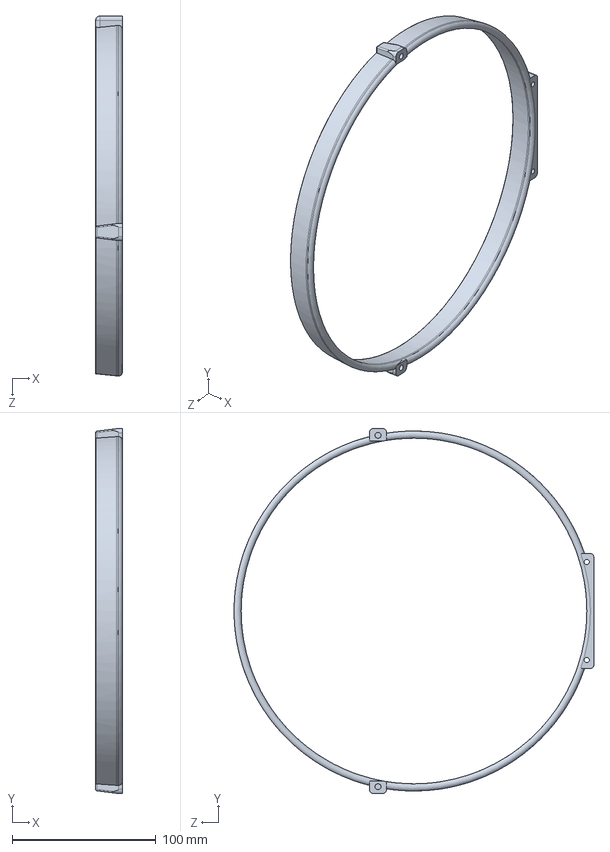
[picture p111: CAD file, 2026-10-14]
cad/solidworks/Shroud.SLDPRT
18.5 x 253.6 x 250.0 mm
