DavidIngraham/ArduPilot-tinkering/cad/solidworks/BatteryBoxWithInserts.SLDASM

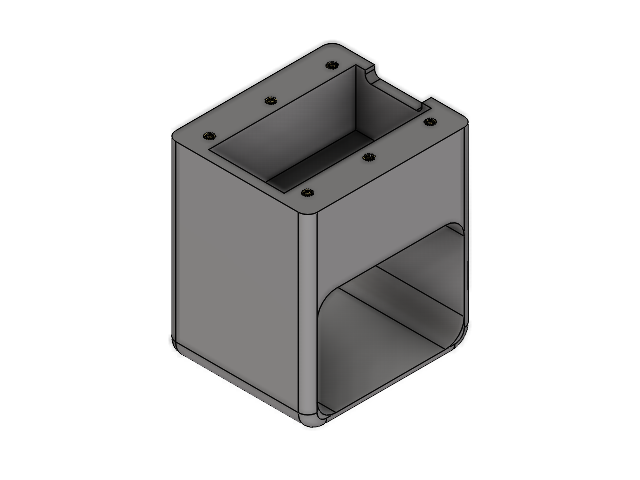
[picture p112: CAD file, 2026-10-14]
cad/solidworks/BatteryBoxWithInserts.SLDASM
BatteryBox
m3_standard x 6
