DavidIngraham/ArduPilot-tinkering/cad/solidworks/SpreaderAssembly.SLDASM

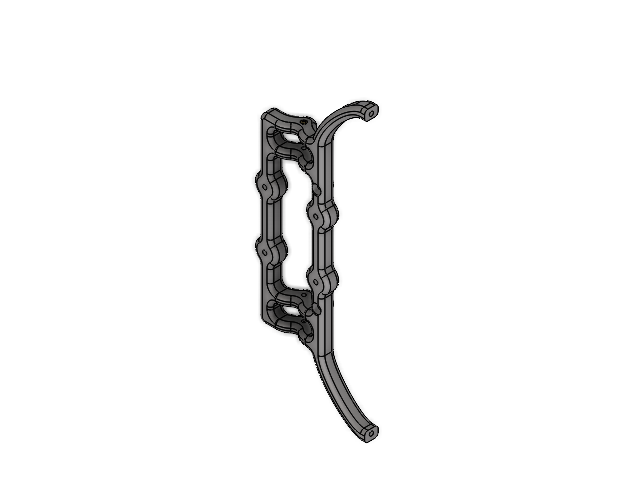
[picture p113: CAD file, 2026-10-14]
cad/solidworks/SpreaderAssembly.SLDASM
SpreaderBarSpar
m3_standard x 2
