DavidIngraham/ArduPilot-tinkering/cad/solidworks/AvionicsAsm.SLDASM

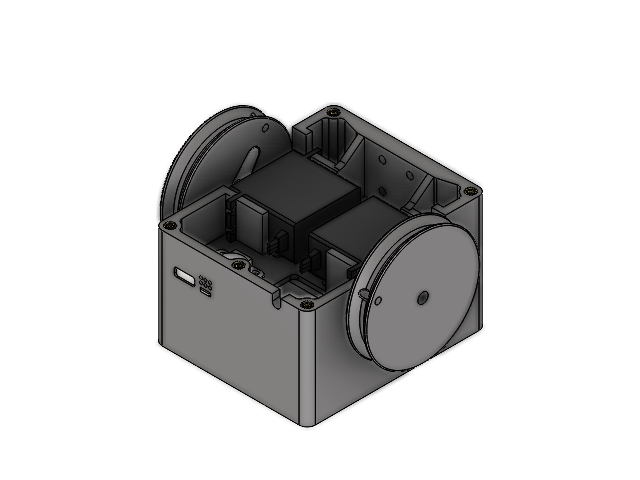
[picture p114: CAD file, 2026-10-14]
cad/solidworks/AvionicsAsm.SLDASM
CoreBlock
AutoPilot
m3_standard x 11
USBBoard
ControlArm x 2
DS339HV x 2
ServoHorn x 2
ESC
