DavidIngraham/ArduPilot-tinkering/(list of files, cad)

Other CAD files:
cad/solidworks/CoreWithInserts.SLDASM
cad/solidworks/MirrorServoAssembly.SLDASM
cad/solidworks/MirrorDS339HV.SLDPRT
cad/solidworks/MirrorControlArm.SLDPRT
cad/solidworks/MirrorServoHorn.SLDPRT
