DavidIngraham/ArduPilot-tinkering/provenance/paraglider-unit-tests.txt

[==========] Running 20 tests from 1 test suite.
[----------] Global test environment set-up.
[----------] 20 tests from ParagliderTest
[ RUN      ] ParagliderTest.ThrowGuideSuppliesReactionMomentsUntilRelease
[       OK ] ParagliderTest.ThrowGuideSuppliesReactionMomentsUntilRelease (1 ms)
[ RUN      ] ParagliderTest.BrakeForceUsesDynamicPressure
[       OK ] ParagliderTest.BrakeForceUsesDynamicPressure (0 ms)
[ RUN      ] ParagliderTest.BrakeForceIsMirrorSymmetric
[       OK ] ParagliderTest.BrakeForceIsMirrorSymmetric (0 ms)
[ RUN      ] ParagliderTest.BrakeMomentsUseSpanSquared
[       OK ] ParagliderTest.BrakeMomentsUseSpanSquared (0 ms)
[ RUN      ] ParagliderTest.BrakeMomentsReverseAndCancel
[       OK ] ParagliderTest.BrakeMomentsReverseAndCancel (0 ms)
[ RUN      ] ParagliderTest.YawDampingOpposesRotationAndScalesWithSpeed
[       OK ] ParagliderTest.YawDampingOpposesRotationAndScalesWithSpeed (0 ms)
[ RUN      ] ParagliderTest.PropellerReactionTorqueTracksThrustAndRotationDirection
[       OK ] ParagliderTest.PropellerReactionTorqueTracksThrustAndRotationDirection (0 ms)
[ RUN      ] ParagliderTest.NoseUpIncreasesAngleOfAttackAndLift
[       OK ] ParagliderTest.NoseUpIncreasesAngleOfAttackAndLift (0 ms)
[ RUN      ] ParagliderTest.CanopyJointPitchUsesPhysicalAngleConvention
[       OK ] ParagliderTest.CanopyJointPitchUsesPhysicalAngleConvention (0 ms)
[ RUN      ] ParagliderTest.LiftIsPerpendicularAndDragOpposesAirflow
[       OK ] ParagliderTest.LiftIsPerpendicularAndDragOpposesAirflow (0 ms)
[ RUN      ] ParagliderTest.AirflowAndCanopySpanDefineLiftPlane
[       OK ] ParagliderTest.AirflowAndCanopySpanDefineLiftPlane (0 ms)
[ RUN      ] ParagliderTest.PitchRateMomentRemovesEnergy
[       OK ] ParagliderTest.PitchRateMomentRemovesEnergy (0 ms)
[ RUN      ] ParagliderTest.NegativeStallPreservesLiftSign
[       OK ] ParagliderTest.NegativeStallPreservesLiftSign (0 ms)
[ RUN      ] ParagliderTest.PitchMomentOpposesIncreasingAngleOfAttack
[       OK ] ParagliderTest.PitchMomentOpposesIncreasingAngleOfAttack (0 ms)
[ RUN      ] ParagliderTest.JointGeometryKeepsSystemCGFixed
[       OK ] ParagliderTest.JointGeometryKeepsSystemCGFixed (0 ms)
[ RUN      ] ParagliderTest.ThrustAbovePayloadCGCanPitchPayloadDown
[       OK ] ParagliderTest.ThrustAbovePayloadCGCanPitchPayloadDown (0 ms)
[ RUN      ] ParagliderTest.LockedJointUsesTotalMomentAndInertia
[       OK ] ParagliderTest.LockedJointUsesTotalMomentAndInertia (0 ms)
[ RUN      ] ParagliderTest.JointDampingRemovesEnergy
[       OK ] ParagliderTest.JointDampingRemovesEnergy (0 ms)
[ RUN      ] ParagliderTest.FreeJointConservesEnergyWithoutDamping
[       OK ] ParagliderTest.FreeJointConservesEnergyWithoutDamping (1 ms)
[ RUN      ] ParagliderTest.CanopyRateChangesAerodynamicDamping
[       OK ] ParagliderTest.CanopyRateChangesAerodynamicDamping (0 ms)
[----------] 20 tests from ParagliderTest (2 ms total)

[----------] Global test environment tear-down
[==========] 20 tests from 1 test suite ran. (2 ms total)
[  PASSED  ] 20 tests.
