DavidIngraham/ArduPilot-tinkering/scratch/paraglider-tests/pitch-joint/unit-tests.txt

[==========] Running 12 tests from 1 test suite.
[----------] Global test environment set-up.
[----------] 12 tests from ParagliderTest
[ RUN      ] ParagliderTest.BrakeForceUsesDynamicPressure
[       OK ] ParagliderTest.BrakeForceUsesDynamicPressure (0 ms)
[ RUN      ] ParagliderTest.BrakeForceIsMirrorSymmetric
[       OK ] ParagliderTest.BrakeForceIsMirrorSymmetric (0 ms)
[ RUN      ] ParagliderTest.BrakeMomentsUseSpanSquared
[       OK ] ParagliderTest.BrakeMomentsUseSpanSquared (0 ms)
[ RUN      ] ParagliderTest.BrakeMomentsReverseAndCancel
[       OK ] ParagliderTest.BrakeMomentsReverseAndCancel (0 ms)
[ RUN      ] ParagliderTest.YawDampingOpposesRotationAndScalesWithSpeed
[       OK ] ParagliderTest.YawDampingOpposesRotationAndScalesWithSpeed (0 ms)
[ RUN      ] ParagliderTest.PropellerReactionTorqueTracksThrustAndRotationDirection
[       OK ] ParagliderTest.PropellerReactionTorqueTracksThrustAndRotationDirection (0 ms)
[ RUN      ] ParagliderTest.JointGeometryKeepsSystemCGFixed
[       OK ] ParagliderTest.JointGeometryKeepsSystemCGFixed (0 ms)
[ RUN      ] ParagliderTest.ThrustAbovePayloadCGCanPitchPayloadDown
[       OK ] ParagliderTest.ThrustAbovePayloadCGCanPitchPayloadDown (0 ms)
[ RUN      ] ParagliderTest.LockedJointUsesTotalMomentAndInertia
[       OK ] ParagliderTest.LockedJointUsesTotalMomentAndInertia (0 ms)
[ RUN      ] ParagliderTest.JointDampingRemovesEnergy
[       OK ] ParagliderTest.JointDampingRemovesEnergy (0 ms)
[ RUN      ] ParagliderTest.FreeJointConservesEnergyWithoutDamping
[       OK ] ParagliderTest.FreeJointConservesEnergyWithoutDamping (11 ms)
[ RUN      ] ParagliderTest.CanopyRateChangesAerodynamicDamping
[       OK ] ParagliderTest.CanopyRateChangesAerodynamicDamping (0 ms)
[----------] 12 tests from ParagliderTest (11 ms total)

[----------] Global test environment tear-down
[==========] 12 tests from 1 test suite ran. (11 ms total)
[  PASSED  ] 12 tests.
