DavidIngraham/ArduPilot-tinkering/scratch/paraglider-tests/pitch-joint/auto-regression/restored-joint-test.txt

lckfile='/workspace/buildlogs/autotest.lck'
step=test.Plane.ParagliderPitchJoint
Running: ("git rev-parse HEAD") in (/workspace/ardupilot)
Removing diagnostic files: ['autotest-1791505197849956.tlog']
>>>> RUNNING STEP: test.Plane.ParagliderPitchJoint at Fri Oct  9 00:26:57 2026
Running: ("rm -f logs/*.BIN logs/LASTLOG.TXT") in (.)
step=test.Plane.ParagliderPitchJoint
step=test.Plane.ParagliderPitchJoint
AT-0000.1: Starting simulator
AT-0000.1: Starting SITL
Running: "/workspace/ardupilot/build/sitl/bin/arduplane" "-w" "--home" "-35.362938,149.165085,585,354" "--model" "plane-elevrev" "--serial1=tcp:2" "--defaults" "/tmp/tmp_6yz3pl2"
arduplane: Home: -35.362938 149.165085 alt=585.000000m hdg=354.000000
arduplane: Starting sketch 'ArduPlane'
arduplane: Starting SITL input
arduplane: Using Irlock at port : 9005
arduplane: Using \clock topic for DDS timing: disabled
arduplane: bind port 5760 for SERIAL0
arduplane: SERIAL0 on TCP port 5760
arduplane: Waiting for connection ....
AT-0000.2: Starting MAVLink connection
AT-0000.4: Drained 0 messages from mav (0.000000/s)
arduplane: Connection on serial port 5760
arduplane: Loaded defaults from @ROMFS/models/plane.parm,@ROMFS/models/plane-reverse-servo-pitch-yaw.parm,@ROMFS/models/plane-reverse-rc-pitch-yaw.parm,/tmp/tmp_6yz3pl2
arduplane: Smoothing reset at 0.001
arduplane: bind port 5762 for SERIAL1
arduplane: SERIAL1 on TCP port 5762
arduplane: bind port 5763 for SERIAL2
arduplane: SERIAL2 on TCP port 5763
arduplane: validate_structures:536: Validating structures
arduplane: Waiting for internal clock bits to be set (current=0x00)
arduplane: Loaded defaults from @ROMFS/models/plane.parm,@ROMFS/models/plane-reverse-servo-pitch-yaw.parm,@ROMFS/models/plane-reverse-rc-pitch-yaw.parm,/tmp/tmp_6yz3pl2
AT-0000.5: AP: Ground start
AT-0000.5: AP: Skipping INS calibration
AT-0000.5: AP: Calibrating barometer
AT-0000.5: AP: RCInput: decoding UDP (Pulses)
AT-0000.6: Doing timesync roundtrip
AT-0000.6: Received: TIMESYNC {tc1 : 1029077000, ts1 : 588410519802}
AT-0000.6: Received TIMESYNC response after 0.003053s
AT-0000.9: AP: Barometer 1 calibration complete
AT-0000.9: AP: Barometer 2 calibration complete
AT-0000.9: AP: Airspeed 1 calibration started
AT-0000.9: AP: ArduPilot Ready
AT-0001.0: AP: Throttle failsafe off
AT-0001.3: AP: Airspeed 1 calibrated
AT-0001.7: Drained 895 messages from mav (1284.847197/s)
AT-0001.8: Firmware Version (4, 8, 0, 'dev')
AT-0001.8: Firmware hash e97b7242
Running: ("git rev-parse --short=8 HEAD") in (/workspace/ardupilot)
AT-0001.8: Git hash e97b7242
AT-0002.0: Sim time: 8.165000
AT-0002.0: set_parameters: ({'LOG_DISARMED': 1, 'LOG_DARM_RATEMAX': 5, 'LOG_FILE_RATEMAX': 10})
AT-0002.0: LOG_DISARMED want=1.000000 autopilot=None (attempt=1/30)
AT-0002.0: Requesting (LOG_DISARMED)
AT-0002.0: LOG_DARM_RATEMAX want=5.000000 autopilot=None (attempt=1/30)
AT-0002.0: Requesting (LOG_DARM_RATEMAX)
AT-0002.0: LOG_FILE_RATEMAX want=10.000000 autopilot=None (attempt=1/30)
AT-0002.0: Requesting (LOG_FILE_RATEMAX)
AT-0002.0: LOG_DISARMED want=1.000000 autopilot=None (attempt=2/30)
AT-0002.0: Requesting (LOG_DISARMED)
AT-0002.0: LOG_DARM_RATEMAX want=5.000000 autopilot=None (attempt=2/30)
AT-0002.0: Requesting (LOG_DARM_RATEMAX)
AT-0002.0: LOG_FILE_RATEMAX want=10.000000 autopilot=None (attempt=2/30)
AT-0002.0: Requesting (LOG_FILE_RATEMAX)
AT-0002.1: Received wanted PARAM_VALUE LOG_DISARMED=0.000000
AT-0002.1: Received wanted PARAM_VALUE LOG_DARM_RATEMAX=0.000000
AT-0002.1: Received wanted PARAM_VALUE LOG_FILE_RATEMAX=0.000000
AT-0002.1: Received wanted PARAM_VALUE LOG_DISARMED=0.000000
AT-0002.1: Received wanted PARAM_VALUE LOG_DARM_RATEMAX=0.000000
AT-0002.1: Received wanted PARAM_VALUE LOG_FILE_RATEMAX=0.000000
AT-0002.1: AP: GPS 1: probing for u-blox at 230400 baud
AT-0002.1: AP: GPS 1: detected u-blox
AT-0002.1: LOG_DISARMED want=1.000000 autopilot=0.0 (attempt=3/30)
AT-0002.1: Sending set (LOG_DISARMED) to (1.000000) (old=0.000000)
AT-0002.1: LOG_DARM_RATEMAX want=5.000000 autopilot=0.0 (attempt=3/30)
AT-0002.1: Sending set (LOG_DARM_RATEMAX) to (5.000000) (old=0.000000)
AT-0002.1: LOG_FILE_RATEMAX want=10.000000 autopilot=0.0 (attempt=3/30)
AT-0002.1: Sending set (LOG_FILE_RATEMAX) to (10.000000) (old=0.000000)
AT-0002.2: Received wanted PARAM_VALUE LOG_DISARMED=1.000000
AT-0002.2: Received wanted PARAM_VALUE LOG_DARM_RATEMAX=5.000000
AT-0002.2: Received wanted PARAM_VALUE LOG_FILE_RATEMAX=10.000000
AT-0002.2: AP: EKF2 IMU0 MAG0 initial yaw alignment complete
AT-0002.2: AP: EKF2 IMU1 MAG0 initial yaw alignment complete
AT-0002.2: LOG_DISARMED want=1.000000 autopilot=1.0 (attempt=4/30)
AT-0002.2: LOG_DISARMED is now 1.000000
AT-0002.2: LOG_DARM_RATEMAX want=5.000000 autopilot=5.0 (attempt=4/30)
AT-0002.2: LOG_DARM_RATEMAX is now 5.000000
AT-0002.2: LOG_FILE_RATEMAX want=10.000000 autopilot=10.0 (attempt=4/30)
AT-0002.2: LOG_FILE_RATEMAX is now 10.000000
AT-0002.3: Drained 0 messages from mav (0.000000/s)
AT-0002.4: Rebooting SITL
AT-0002.4: Sending param_request_read for (STAT_RESET)
AT-0002.6: get_parameter(STAT_RESET): PARAM_VALUE {param_id : STAT_RESET, param_value : 1.0, param_type : 6, param_count : 1461, param_index : 65535}
AT-0002.7: Sending param_request_read for (STAT_BOOTCNT)
AT-0003.5: AP: EKF3 IMU0 initialised
AT-0003.5: AP: EKF3 IMU1 initialised
AT-0003.8: get_parameter(STAT_BOOTCNT): PARAM_VALUE {param_id : STAT_BOOTCNT, param_value : 1.0, param_type : 4, param_count : 1461, param_index : 65535}
AT-0003.9: Sending reboot command
AT-0003.9: Sending COMMAND_LONG to (1,1) (MAV_CMD_PREFLIGHT_REBOOT_SHUTDOWN=246) (p1=1.000000 p2=1.000000 p3=0.000000 p4=0.000000 p5=0.000000 p6=0.000000  p7=0.000000)
AT-0003.9: Sending param_request_read for (STAT_BOOTCNT)
AT-0003.9: AP: EKF3 IMU0 tilt alignment complete
AT-0003.9: AP: EKF3 IMU1 tilt alignment complete
AT-0003.9: While awaiting reboot received (COMMAND_ACK {command : 246, result : 0, progress : 0, result_param2 : 0, target_system : 250, target_component : 250})
EOF on TCP socket
Attempting reconnect
[Errno 111] Connection refused sleeping
[Errno 111] Connection refused sleeping
[Errno 111] Connection refused sleeping
arduplane: Home: -35.362938 149.165085 alt=585.000000m hdg=354.000000
arduplane: Starting sketch 'ArduPlane'
arduplane: Starting SITL input
arduplane: Using Irlock at port : 9005
arduplane: Using \clock topic for DDS timing: disabled
arduplane: bind port 5760 for SERIAL0
arduplane: SERIAL0 on TCP port 5760
arduplane: Waiting for connection ....
arduplane: Connection on serial port 5760
AT-0004.2: get_parameter(STAT_BOOTCNT): None
AT-0004.2: Sending param_request_read for (STAT_BOOTCNT)
arduplane: Loaded defaults from @ROMFS/models/plane.parm,@ROMFS/models/plane-reverse-servo-pitch-yaw.parm,@ROMFS/models/plane-reverse-rc-pitch-yaw.parm,/tmp/tmp_6yz3pl2
arduplane: bind port 5762 for SERIAL1
arduplane: SERIAL1 on TCP port 5762
arduplane: bind port 5763 for SERIAL2
arduplane: SERIAL2 on TCP port 5763
arduplane: Smoothing reset at 0.001
arduplane: validate_structures:536: Validating structures
arduplane: Waiting for internal clock bits to be set (current=0x00)
arduplane: Loaded defaults from @ROMFS/models/plane.parm,@ROMFS/models/plane-reverse-servo-pitch-yaw.parm,@ROMFS/models/plane-reverse-rc-pitch-yaw.parm,/tmp/tmp_6yz3pl2
AT-0004.2: get_parameter(STAT_BOOTCNT): PARAM_VALUE {param_id : INS_ACC_ID, param_value : 2753028.0, param_type : 6, param_count : 1451, param_index : 65535}
AT-0004.2: (INS_ACC_ID) != (STAT_BOOTCNT)
AT-0004.2: get_parameter(STAT_BOOTCNT): PARAM_VALUE {param_id : INS_ACC2_ID, param_value : 2753036.0, param_type : 6, param_count : 1451, param_index : 65535}
AT-0004.2: (INS_ACC2_ID) != (STAT_BOOTCNT)
AT-0004.2: get_parameter(STAT_BOOTCNT): PARAM_VALUE {param_id : BARO_ALT_OFFSET, param_value : 0.0, param_type : 9, param_count : 1451, param_index : 65535}
AT-0004.2: (BARO_ALT_OFFSET) != (STAT_BOOTCNT)
AT-0004.2: get_parameter(STAT_BOOTCNT): PARAM_VALUE {param_id : STAT_BOOTCNT, param_value : 2.0, param_type : 4, param_count : 1451, param_index : 65535}
AT-0004.2: current=2.0 required=2
AT-0004.2: Doing timesync roundtrip
AT-0004.2: AP: Ground start
AT-0004.2: AP: Skipping INS calibration
AT-0004.2: AP: Calibrating barometer
AT-0004.2: Received: TIMESYNC {tc1 : 213570000, ts1 : 605590388986}
AT-0004.2: Received TIMESYNC response after 0.000149s
AT-0004.2: Calling initialise-after-reboot
AT-0004.2: AP: RCInput: decoding UDP (Pulses)
AT-0004.2: Drained 0 messages from mav (0.000000/s)
AT-0004.3: Doing timesync roundtrip
AT-0004.3: Received: TIMESYNC {tc1 : 1041572000, ts1 : 609885356282}
AT-0004.3: Received TIMESYNC response after 0.000036s
AT-0004.3: AP: Barometer 1 calibration complete
AT-0004.3: AP: Barometer 2 calibration complete
AT-0004.3: AP: Airspeed 1 calibration started
AT-0004.3: AP: ArduPilot Ready
AT-0004.3: AP: Throttle failsafe off
AT-0004.4: Reboot complete
AT-0004.4: set_parameters: ({})
AT-0004.4: Sending COMMAND_LONG to (1,1) (MAV_CMD_REQUEST_MESSAGE=512) (p1=164.000000 p2=0.000000 p3=0.000000 p4=0.000000 p5=0.000000 p6=0.000000  p7=0.000000)
AT-0004.4: Simstate Close to startup location: dist=0.011132 max=1.000000 (simstate: Location(lat=-35.3629381 lng=149.1650850 no-alt) start-loc: Location(lat=-35.3629380 lng=149.1650850 alt=585.00m-ABSOLUTE))
AT-0004.4: SITL is running
AT-0004.4: Ready to start testing!
AT-0004.4: Waiting for a heartbeat with mavlink protocol 2.0
AT-0004.4: Drained 26 messages from mav (12832.655213/s)
AT-0004.5: Setting up RC parameters
AT-0004.5: AP: Airspeed 1 calibrated
AT-0004.5: RC values good
AT-0004.5: Waiting for mode-switch mode MANUAL
AT-0004.5: Waiting for mode MANUAL
AT-0004.7: Got mode MANUAL
AT-0004.7: Received (MISSION_ACK {target_system : 250, target_component : 250, type : 0, mission_type : 1})
AT-0004.7: MISSION_ACK.target_system has expected value 250
AT-0004.7: MISSION_ACK.target_component has expected value 250
AT-0004.7: MISSION_ACK.type has expected value 0 (MAV_MISSION_ACCEPTED)
AT-0004.7: AP: Fence Indexed OK
AT-0004.7: Received (MISSION_ACK {target_system : 250, target_component : 250, type : 0, mission_type : 0})
AT-0004.7: MISSION_ACK.target_system has expected value 250
AT-0004.7: MISSION_ACK.target_component has expected value 250
AT-0004.7: MISSION_ACK.type has expected value 0 (MAV_MISSION_ACCEPTED)
AT-0004.7: AP: Flight plan received
AT-0004.7: Received (MISSION_ACK {target_system : 250, target_component : 250, type : 0, mission_type : 2})
AT-0004.7: MISSION_ACK.target_system has expected value 250
AT-0004.7: MISSION_ACK.target_component has expected value 250
AT-0004.7: MISSION_ACK.type has expected value 0 (MAV_MISSION_ACCEPTED)
AT-0004.7: ##################################################################################
AT-0004.7: ########## ParagliderPitchJoint (Fly the articulated model with the throttle pitch damper disabled)  ##########
AT-0004.7: ##################################################################################
AT-0004.7: Downloading parameters
AT-0004.7: AP: ArduPlane V4.8.0-dev (e97b7242)
AT-0004.7: AP: f34bda38c22c4dee98a9bc8da64e12a2
AT-0005.3: Downloaded 1461 parameters OK (attempt=1)
AT-0005.3: Doing timesync roundtrip
AT-0005.3: Received: TIMESYNC {tc1 : 7502320000, ts1 : 614180323578}
AT-0005.3: Received TIMESYNC response after 0.000000s
AT-0005.3: RC values good
AT-0005.3: Changing mode to MANUAL
AT-0005.3: Sending COMMAND_LONG to (1,1) (MAV_CMD_DO_SET_MODE=176) (p1=1.000000 p2=0.000000 p3=0.000000 p4=0.000000 p5=0.000000 p6=0.000000  p7=0.000000)
AT-0005.3: Got mode MANUAL
AT-0005.4: AP: GPS 1: probing for u-blox at 230400 baud
AT-0005.4: AP: GPS 1: detected u-blox
AT-0005.5: AP: EKF2 IMU0 MAG0 initial yaw alignment complete
AT-0005.5: AP: EKF2 IMU1 MAG0 initial yaw alignment complete
AT-0005.5: Overriding speedup to 10
AT-0005.5: set_parameters: ({'SIM_SPEEDUP': 10})
AT-0005.5: SIM_SPEEDUP want=10.000000 autopilot=None (attempt=1/10)
AT-0005.5: Requesting (SIM_SPEEDUP)
AT-0005.5: AP: EKF3 IMU0 initialised
AT-0005.5: AP: EKF3 IMU1 initialised
AT-0005.5: Received wanted PARAM_VALUE SIM_SPEEDUP=10.000000
AT-0005.5: SIM_SPEEDUP want=10.000000 autopilot=10.0 (attempt=2/10)
AT-0005.5: SIM_SPEEDUP is now 10.000000
AT-0005.5: Stopping SITL
arduplane: 
AT-0005.7: Starting SITL
Running: "/workspace/ardupilot/build/sitl/bin/arduplane" "-w" "--home" "-35.362938,149.165085,585,354" "--model" "paraglider-throw:paraglider-pitch-joint.json" "--serial1=tcp:2" "--defaults" "/tmp/tmp6xp5anyc,/workspace/ardupilot/Tools/autotest/default_params/paraglider.parm"
arduplane: Loaded paraglider coefficients from @ROMFS/models/paraglider-pitch-joint.json
arduplane: Home: -35.362938 149.165085 alt=585.000000m hdg=354.000000
arduplane: Starting sketch 'ArduPlane'
arduplane: Starting SITL input
arduplane: Using Irlock at port : 9005
arduplane: Using \clock topic for DDS timing: disabled
arduplane: bind port 5760 for SERIAL0
arduplane: SERIAL0 on TCP port 5760
arduplane: Waiting for connection ....
Attempting reconnect
AT-0005.7: Drained 0 messages from mav (0.000000/s)
arduplane: Connection on serial port 5760
arduplane: Loaded defaults from @ROMFS/default_params/paraglider.parm,/tmp/tmp6xp5anyc,/workspace/ardupilot/Tools/autotest/default_params/paraglider.parm
arduplane: Smoothing reset at 0.001
arduplane: bind port 5762 for SERIAL1
arduplane: SERIAL1 on TCP port 5762
arduplane: bind port 5763 for SERIAL2
arduplane: SERIAL2 on TCP port 5763
arduplane: validate_structures:536: Validating structures
arduplane: Closed connection on SERIAL0
arduplane: Waiting for internal clock bits to be set (current=0x00)
arduplane: New connection on SERIAL0
arduplane: Loaded defaults from @ROMFS/default_params/paraglider.parm,/tmp/tmp6xp5anyc,/workspace/ardupilot/Tools/autotest/default_params/paraglider.parm
AT-0005.7: AP: Ground start
AT-0005.7: AP: Skipping INS calibration
AT-0005.7: AP: Calibrating barometer
AT-0005.8: AP: RCInput: decoding UDP (Pulses)
AT-0006.7: Doing timesync roundtrip
AT-0006.7: AP: Barometer 1 calibration complete
AT-0006.7: AP: Barometer 2 calibration complete
AT-0006.7: AP: No airspeed sensor
AT-0006.7: AP: ArduPilot Ready
AT-0006.7: AP: Throttle failsafe off
AT-0006.7: Received: TIMESYNC {tc1 : 4883368000, ts1 : 622770258170}
AT-0006.8: Received TIMESYNC response after 0.000541s
AT-0006.8: RC values good
AT-0006.8: Sending param_request_read for (TECS_PG_ENABLE)
AT-0006.8: get_parameter(TECS_PG_ENABLE): PARAM_VALUE {param_id : TECS_PG_ENABLE, param_value : 1.0, param_type : 2, param_count : 1410, param_index : 65535}
AT-0006.8: Sending param_request_read for (SERVO1_FUNCTION)
AT-0006.9: get_parameter(SERVO1_FUNCTION): PARAM_VALUE {param_id : SERVO1_FUNCTION, param_value : 190.0, param_type : 4, param_count : 1410, param_index : 65535}
AT-0006.9: Sending param_request_read for (SERVO2_FUNCTION)
AT-0006.9: get_parameter(SERVO2_FUNCTION): PARAM_VALUE {param_id : SERVO2_FUNCTION, param_value : 191.0, param_type : 4, param_count : 1410, param_index : 65535}
AT-0006.9: TECS_PG_ENABLE has expected value 1.000000
AT-0006.9: SERVO1_FUNCTION has expected value 190.000000
AT-0006.9: SERVO2_FUNCTION has expected value 191.000000
AT-0006.9: set_parameters: ({'TKOFF_ALT': 120, 'SERVO7_FUNCTION': 0, 'TECS_PTCH_DAMP': 0})
AT-0006.9: TKOFF_ALT want=120.000000 autopilot=None (attempt=1/30)
AT-0006.9: Requesting (TKOFF_ALT)
AT-0006.9: SERVO7_FUNCTION want=0.000000 autopilot=None (attempt=1/30)
AT-0006.9: Requesting (SERVO7_FUNCTION)
AT-0006.9: TECS_PTCH_DAMP want=0.000000 autopilot=None (attempt=1/30)
AT-0006.9: Requesting (TECS_PTCH_DAMP)
AT-0006.9: Received wanted PARAM_VALUE TKOFF_ALT=50.000000
AT-0006.9: Received wanted PARAM_VALUE SERVO7_FUNCTION=0.000000
AT-0006.9: Received wanted PARAM_VALUE TECS_PTCH_DAMP=0.200000
AT-0006.9: TKOFF_ALT want=120.000000 autopilot=50.0 (attempt=2/30)
AT-0006.9: Sending set (TKOFF_ALT) to (120.000000) (old=50.000000)
AT-0006.9: SERVO7_FUNCTION want=0.000000 autopilot=0.0 (attempt=2/30)
AT-0006.9: SERVO7_FUNCTION is now 0.000000
AT-0006.9: TECS_PTCH_DAMP want=0.000000 autopilot=0.20000000298023224 (attempt=2/30)
AT-0006.9: Sending set (TECS_PTCH_DAMP) to (0.000000) (old=0.200000)
AT-0006.9: Received wanted PARAM_VALUE TKOFF_ALT=120.000000
AT-0006.9: Received wanted PARAM_VALUE TECS_PTCH_DAMP=0.000000
AT-0006.9: TKOFF_ALT want=120.000000 autopilot=120.0 (attempt=3/30)
AT-0006.9: TKOFF_ALT is now 120.000000
AT-0006.9: TECS_PTCH_DAMP want=0.000000 autopilot=0.0 (attempt=3/30)
AT-0006.9: TECS_PTCH_DAMP is now 0.000000
AT-0006.9: Changing mode to TAKEOFF
AT-0006.9: Sending COMMAND_LONG to (1,1) (MAV_CMD_DO_SET_MODE=176) (p1=1.000000 p2=13.000000 p3=0.000000 p4=0.000000 p5=0.000000 p6=0.000000  p7=0.000000)
AT-0006.9: Got mode TAKEOFF
AT-0006.9: Waiting for ready to arm
AT-0006.9: Sending param_request_read for (AHRS_EKF_TYPE)
AT-0007.0: get_parameter(AHRS_EKF_TYPE): PARAM_VALUE {param_id : AHRS_EKF_TYPE, param_value : 3.0, param_type : 2, param_count : 1410, param_index : 65535}
AT-0007.0: Waiting for EKF value 831
AT-0007.0: Want=831 got=1024 errors=1024
AT-0007.1: AP: GPS 1: probing for u-blox at 230400 baud
AT-0007.1: AP: GPS 1: detected u-blox
AT-0007.1: Want=831 got=1024 errors=1024
AT-0007.2: Want=831 got=1024 errors=1024
AT-0007.2: AP: EKF3 IMU0 initialised
AT-0007.2: AP: EKF3 IMU1 initialised
AT-0007.4: Want=831 got=0 errors=0
AT-0007.4: AP: EKF3 IMU0 tilt alignment complete
AT-0007.4: AP: EKF3 IMU1 tilt alignment complete
AT-0007.4: AP: EKF3 IMU0 MAG0 initial yaw alignment complete
AT-0007.4: AP: EKF3 IMU1 MAG0 initial yaw alignment complete
AT-0007.4: Want=831 got=167 errors=128
AT-0007.6: Want=831 got=167 errors=128
AT-0007.7: Want=831 got=167 errors=128
AT-0007.9: Want=831 got=167 errors=128
AT-0008.0: Want=831 got=167 errors=128
AT-0008.8: Want=831 got=167 errors=128
AT-0009.2: Want=831 got=167 errors=128
AT-0009.7: Want=831 got=167 errors=128
AT-0009.9: AP: EKF3 IMU0 origin set
AT-0009.9: AP: EKF3 IMU1 origin set
AT-0009.9: AP: EKF3 IMU0 is using GPS
AT-0009.9: AP: EKF3 IMU1 is using GPS
AT-0009.9: AP: AHRS: EKF3 active
AT-0009.9: AP: Field Elevation Set: 585m
AT-0009.9: EKF Flags OK
AT-0009.9: Waiting for GPS health
AT-0009.9: GPS healthy after 0.000000/30.000000 seconds
AT-0010.0: Polled home position (HOME_POSITION {latitude : -353629380, longitude : 1491650850, altitude : 585090, x : 0.0, y : 0.0, z : -0.0, q : [nan, nan, nan, nan], approach_x : 0.0, approach_y : 0.0, approach_z : 0.0, time_usec : 20984936})
AT-0010.0: Doing timesync roundtrip
AT-0010.0: Received: TIMESYNC {tc1 : 21068558000, ts1 : 635655160058}
AT-0010.0: Received TIMESYNC response after 0.000000s
AT-0010.1: Took 13 seconds to become armable
AT-0010.1: Arm motors with MAVLink cmd
AT-0010.1: Sending COMMAND_LONG to (1,1) (MAV_CMD_COMPONENT_ARM_DISARM=400) (p1=1.000000 p2=0.000000 p3=0.000000 p4=0.000000 p5=0.000000 p6=0.000000  p7=0.000000)
AT-0010.1: ACK received: COMMAND_ACK {command : 400, result : 0, progress : 0, result_param2 : 0, target_system : 250, target_component : 250} (0.000000s)
AT-0010.1: AP: Throttle armed
AT-0010.1: AP: Armed AUTO, xaccel = -0.0 m/s/s, waiting 0.2 sec
AT-0010.1: AP: Triggered AUTO. GPS speed = 0.0
AT-0010.1: Motors ARMED
AT-0010.1: RC values good
AT-0010.1: Sending COMMAND_LONG to (1,1) (MAV_CMD_DO_SET_SERVO=183) (p1=7.000000 p2=2000.000000 p3=0.000000 p4=0.000000 p5=0.000000 p6=0.000000  p7=0.000000)
AT-0010.1: ACK received: COMMAND_ACK {command : 183, result : 0, progress : 0, result_param2 : 0, target_system : 250, target_component : 250} (0.000000s)
AT-0010.1: Waiting for Altitude=122.50 with accuracy 7.50
AT-0010.2: Altitude=0.01 (want 122.500000 +- 7.500000)
AT-0010.2: AP: Takeoff to 120m for 200.0m heading 354.0 deg
AT-0010.2: AP: Autoland direction= 354
AT-0010.2: Altitude=4.89 (want 122.500000 +- 7.500000)
AT-0010.3: Altitude=3.87 (want 122.500000 +- 7.500000)
AT-0010.4: Altitude=9.29 (want 122.500000 +- 7.500000)
AT-0010.6: Altitude=10.90 (want 122.500000 +- 7.500000)
AT-0011.4: AP: SIM Hit ground at 3.122988 m/s
AT-0011.6: Altitude=-0.13 (want 122.500000 +- 7.500000)
AT-0011.9: Altitude=2.08 (want 122.500000 +- 7.500000)
AT-0012.0: Altitude=4.75 (want 122.500000 +- 7.500000)
AT-0012.1: Altitude=6.32 (want 122.500000 +- 7.500000)
AT-0012.2: Altitude=9.29 (want 122.500000 +- 7.500000)
AT-0012.3: Altitude=11.14 (want 122.500000 +- 7.500000)
AT-0012.4: Altitude=12.82 (want 122.500000 +- 7.500000)
AT-0012.5: Altitude=15.11 (want 122.500000 +- 7.500000)
AT-0012.6: Altitude=16.97 (want 122.500000 +- 7.500000)
AT-0012.8: Altitude=18.96 (want 122.500000 +- 7.500000)
AT-0012.9: Altitude=21.22 (want 122.500000 +- 7.500000)
AT-0013.1: Altitude=22.97 (want 122.500000 +- 7.500000)
AT-0013.2: Altitude=25.00 (want 122.500000 +- 7.500000)
AT-0013.3: Altitude=27.60 (want 122.500000 +- 7.500000)
AT-0013.4: Altitude=29.53 (want 122.500000 +- 7.500000)
AT-0013.5: Altitude=31.44 (want 122.500000 +- 7.500000)
AT-0013.6: Altitude=33.55 (want 122.500000 +- 7.500000)
AT-0013.7: Altitude=35.37 (want 122.500000 +- 7.500000)
AT-0013.8: Altitude=37.33 (want 122.500000 +- 7.500000)
AT-0013.9: Altitude=39.45 (want 122.500000 +- 7.500000)
AT-0014.0: Altitude=41.37 (want 122.500000 +- 7.500000)
AT-0014.2: Altitude=43.55 (want 122.500000 +- 7.500000)
AT-0014.3: Altitude=45.48 (want 122.500000 +- 7.500000)
AT-0014.4: Altitude=47.80 (want 122.500000 +- 7.500000)
AT-0014.5: Altitude=49.65 (want 122.500000 +- 7.500000)
AT-0014.6: Altitude=51.55 (want 122.500000 +- 7.500000)
AT-0014.7: Altitude=53.30 (want 122.500000 +- 7.500000)
AT-0014.8: Altitude=55.24 (want 122.500000 +- 7.500000)
AT-0015.0: Altitude=56.99 (want 122.500000 +- 7.500000)
AT-0015.1: Altitude=58.94 (want 122.500000 +- 7.500000)
AT-0015.2: Altitude=60.72 (want 122.500000 +- 7.500000)
AT-0015.3: Altitude=62.68 (want 122.500000 +- 7.500000)
AT-0015.5: Altitude=64.64 (want 122.500000 +- 7.500000)
AT-0015.6: Altitude=66.59 (want 122.500000 +- 7.500000)
AT-0015.7: Altitude=68.55 (want 122.500000 +- 7.500000)
AT-0015.7: Altitude=70.56 (want 122.500000 +- 7.500000)
AT-0015.8: Altitude=72.39 (want 122.500000 +- 7.500000)
AT-0016.0: Altitude=75.13 (want 122.500000 +- 7.500000)
AT-0016.1: Altitude=77.06 (want 122.500000 +- 7.500000)
AT-0016.2: Altitude=78.86 (want 122.500000 +- 7.500000)
AT-0016.3: Altitude=81.33 (want 122.500000 +- 7.500000)
AT-0016.7: Altitude=87.04 (want 122.500000 +- 7.500000)
AT-0016.8: Altitude=89.43 (want 122.500000 +- 7.500000)
AT-0016.9: Altitude=91.41 (want 122.500000 +- 7.500000)
AT-0017.1: Altitude=93.55 (want 122.500000 +- 7.500000)
AT-0017.2: Altitude=96.11 (want 122.500000 +- 7.500000)
AT-0017.3: Altitude=97.90 (want 122.500000 +- 7.500000)
AT-0017.4: Altitude=100.20 (want 122.500000 +- 7.500000)
AT-0017.5: Altitude=102.54 (want 122.500000 +- 7.500000)
AT-0017.7: Altitude=104.43 (want 122.500000 +- 7.500000)
AT-0017.8: Altitude=106.54 (want 122.500000 +- 7.500000)
AT-0017.9: Altitude=108.30 (want 122.500000 +- 7.500000)
AT-0018.0: Altitude=110.43 (want 122.500000 +- 7.500000)
AT-0018.1: Altitude=112.22 (want 122.500000 +- 7.500000)
AT-0018.2: Altitude=114.34 (want 122.500000 +- 7.500000)
AT-0018.2: Attained Altitude=115.133
AT-0018.3: Sending COMMAND_LONG to (1,1) (MAV_CMD_DO_SET_SERVO=183) (p1=7.000000 p2=1000.000000 p3=0.000000 p4=0.000000 p5=0.000000 p6=0.000000  p7=0.000000)
AT-0018.3: ACK received: COMMAND_ACK {command : 183, result : 0, progress : 0, result_param2 : 0, target_system : 250, target_component : 250} (0.000000s)
AT-0018.3: Changing mode to FBWB
AT-0018.3: Sending COMMAND_LONG to (1,1) (MAV_CMD_DO_SET_MODE=176) (p1=1.000000 p2=6.000000 p3=0.000000 p4=0.000000 p5=0.000000 p6=0.000000  p7=0.000000)
AT-0018.3: Got mode FBWB
AT-0018.3: RC values good
AT-0018.4: Delaying 30.000000 seconds for settle the passive pitch joint
AT-0032.0: Disarm motors with MAVLink cmd
AT-0032.0: Sending COMMAND_LONG to (1,1) (MAV_CMD_COMPONENT_ARM_DISARM=400) (p1=0.000000 p2=21196.000000 p3=0.000000 p4=0.000000 p5=0.000000 p6=0.000000  p7=0.000000)
AT-0032.0: ACK received: COMMAND_ACK {command : 400, result : 0, progress : 0, result_param2 : 0, target_system : 250, target_component : 250} (0.000000s)
AT-0032.0: Waiting for DISARM
AT-0032.0: AP: Throttle disarmed
AT-0032.0: Waiting for disarm (0.00s so far of allowed 30.00)
AT-0032.0: DISARMED after 0.00 seconds (allowed=30.00)
AT-0032.0: Drained 0 messages from mav (0.000000/s)
AT-0032.2: set_parameters: ({'SIM_SPEEDUP': 10.0, 'SERVO7_FUNCTION': 0.0, 'TKOFF_ALT': 50.0, 'TECS_PTCH_DAMP': 0.20000000298023224})
AT-0032.2: SIM_SPEEDUP want=10.000000 autopilot=None (attempt=1/40)
AT-0032.2: Requesting (SIM_SPEEDUP)
AT-0032.2: SERVO7_FUNCTION want=0.000000 autopilot=None (attempt=1/40)
AT-0032.2: Requesting (SERVO7_FUNCTION)
AT-0032.2: TKOFF_ALT want=50.000000 autopilot=None (attempt=1/40)
AT-0032.2: Requesting (TKOFF_ALT)
AT-0032.2: TECS_PTCH_DAMP want=0.200000 autopilot=None (attempt=1/40)
AT-0032.2: Requesting (TECS_PTCH_DAMP)
AT-0032.2: SIM_SPEEDUP want=10.000000 autopilot=None (attempt=2/40)
AT-0032.2: Requesting (SIM_SPEEDUP)
AT-0032.2: SERVO7_FUNCTION want=0.000000 autopilot=None (attempt=2/40)
AT-0032.2: Requesting (SERVO7_FUNCTION)
AT-0032.2: TKOFF_ALT want=50.000000 autopilot=None (attempt=2/40)
AT-0032.2: Requesting (TKOFF_ALT)
AT-0032.2: TECS_PTCH_DAMP want=0.200000 autopilot=None (attempt=2/40)
AT-0032.2: Requesting (TECS_PTCH_DAMP)
AT-0032.2: Received wanted PARAM_VALUE SIM_SPEEDUP=10.000000
AT-0032.2: Received wanted PARAM_VALUE SERVO7_FUNCTION=0.000000
AT-0032.2: Received wanted PARAM_VALUE TKOFF_ALT=120.000000
AT-0032.2: Received wanted PARAM_VALUE TECS_PTCH_DAMP=0.000000
AT-0032.2: Received wanted PARAM_VALUE SIM_SPEEDUP=10.000000
AT-0032.2: SIM_SPEEDUP want=10.000000 autopilot=10.0 (attempt=3/40)
AT-0032.2: SIM_SPEEDUP is now 10.000000
AT-0032.2: SERVO7_FUNCTION want=0.000000 autopilot=0.0 (attempt=3/40)
AT-0032.2: SERVO7_FUNCTION is now 0.000000
AT-0032.2: TKOFF_ALT want=50.000000 autopilot=120.0 (attempt=3/40)
AT-0032.2: Sending set (TKOFF_ALT) to (50.000000) (old=120.000000)
AT-0032.2: TECS_PTCH_DAMP want=0.200000 autopilot=0.0 (attempt=3/40)
AT-0032.2: Sending set (TECS_PTCH_DAMP) to (0.200000) (old=0.000000)
AT-0032.2: Received wanted PARAM_VALUE TKOFF_ALT=120.000000
AT-0032.2: Received wanted PARAM_VALUE TECS_PTCH_DAMP=0.000000
AT-0032.2: Received wanted PARAM_VALUE TKOFF_ALT=50.000000
AT-0032.2: Received wanted PARAM_VALUE TECS_PTCH_DAMP=0.200000
AT-0032.2: TKOFF_ALT want=50.000000 autopilot=50.0 (attempt=4/40)
AT-0032.2: TKOFF_ALT is now 50.000000
AT-0032.2: TECS_PTCH_DAMP want=0.200000 autopilot=0.20000000298023224 (attempt=4/40)
AT-0032.2: TECS_PTCH_DAMP is now 0.200000
AT-0032.2: Drained 0 messages from mav (0.000000/s)
AT-0032.3: Resetting SITL commandline to default
AT-0032.3: Stopping SITL
arduplane: 
AT-0032.3: Starting SITL
Running: "/workspace/ardupilot/build/sitl/bin/arduplane" "-w" "--home" "-35.362938,149.165085,585,354" "--model" "plane-elevrev" "--serial1=tcp:2" "--defaults" "/tmp/tmp10uovu1w"
arduplane: Home: -35.362938 149.165085 alt=585.000000m hdg=354.000000
arduplane: Starting sketch 'ArduPlane'
arduplane: Starting SITL input
arduplane: Using Irlock at port : 9005
arduplane: Using \clock topic for DDS timing: disabled
arduplane: bind port 5760 for SERIAL0
arduplane: SERIAL0 on TCP port 5760
arduplane: Waiting for connection ....
Attempting reconnect
AT-0032.4: Doing timesync roundtrip
arduplane: Connection on serial port 5760
arduplane: Loaded defaults from @ROMFS/models/plane.parm,@ROMFS/models/plane-reverse-servo-pitch-yaw.parm,@ROMFS/models/plane-reverse-rc-pitch-yaw.parm,/tmp/tmp10uovu1w
arduplane: Smoothing reset at 0.001
arduplane: bind port 5762 for SERIAL1
arduplane: SERIAL1 on TCP port 5762
arduplane: bind port 5763 for SERIAL2
arduplane: SERIAL2 on TCP port 5763
arduplane: validate_structures:536: Validating structures
arduplane: Waiting for internal clock bits to be set (current=0x00)
AT-0032.4: Received: TIMESYNC {tc1 : -2177000, ts1 : 652835029242}
AT-0032.4: Received TIMESYNC response after 0.000037s
arduplane: Loaded defaults from @ROMFS/models/plane.parm,@ROMFS/models/plane-reverse-servo-pitch-yaw.parm,@ROMFS/models/plane-reverse-rc-pitch-yaw.parm,/tmp/tmp10uovu1w
AT-0032.4: AP: Ground start
AT-0032.4: AP: Skipping INS calibration
AT-0032.4: AP: Calibrating barometer
AT-0032.4: AP: RCInput: decoding UDP (Pulses)
AT-0032.5: set_parameters: ({'LOG_DISARMED': 1, 'LOG_DARM_RATEMAX': 5, 'LOG_FILE_RATEMAX': 10})
AT-0032.5: AP: Barometer 1 calibration complete
AT-0032.5: AP: Barometer 2 calibration complete
AT-0032.5: AP: Airspeed 1 calibration started
AT-0032.5: AP: ArduPilot Ready
AT-0032.5: AP: Throttle failsafe off
AT-0032.5: LOG_DISARMED want=1.000000 autopilot=None (attempt=1/30)
AT-0032.5: Requesting (LOG_DISARMED)
AT-0032.6: LOG_DARM_RATEMAX want=5.000000 autopilot=None (attempt=1/30)
AT-0032.6: Requesting (LOG_DARM_RATEMAX)
AT-0032.6: LOG_FILE_RATEMAX want=10.000000 autopilot=None (attempt=1/30)
AT-0032.6: Requesting (LOG_FILE_RATEMAX)
AT-0032.6: Received wanted PARAM_VALUE LOG_DISARMED=0.000000
AT-0032.6: Received wanted PARAM_VALUE LOG_DARM_RATEMAX=0.000000
AT-0032.6: Received wanted PARAM_VALUE LOG_FILE_RATEMAX=0.000000
AT-0032.6: LOG_DISARMED want=1.000000 autopilot=0.0 (attempt=2/30)
AT-0032.6: Sending set (LOG_DISARMED) to (1.000000) (old=0.000000)
AT-0032.6: LOG_DARM_RATEMAX want=5.000000 autopilot=0.0 (attempt=2/30)
AT-0032.6: Sending set (LOG_DARM_RATEMAX) to (5.000000) (old=0.000000)
AT-0032.6: LOG_FILE_RATEMAX want=10.000000 autopilot=0.0 (attempt=2/30)
AT-0032.6: Sending set (LOG_FILE_RATEMAX) to (10.000000) (old=0.000000)
AT-0032.6: Received wanted PARAM_VALUE LOG_DISARMED=1.000000
AT-0032.6: Received wanted PARAM_VALUE LOG_DARM_RATEMAX=5.000000
AT-0032.6: Received wanted PARAM_VALUE LOG_FILE_RATEMAX=10.000000
AT-0032.6: LOG_DISARMED want=1.000000 autopilot=1.0 (attempt=3/30)
AT-0032.6: LOG_DISARMED is now 1.000000
AT-0032.6: LOG_DARM_RATEMAX want=5.000000 autopilot=5.0 (attempt=3/30)
AT-0032.6: LOG_DARM_RATEMAX is now 5.000000
AT-0032.6: LOG_FILE_RATEMAX want=10.000000 autopilot=10.0 (attempt=3/30)
AT-0032.6: LOG_FILE_RATEMAX is now 10.000000
AT-0032.6: Drained 0 messages from mav (0.000000/s)
AT-0032.7: Rebooting SITL
AT-0032.7: Sending param_request_read for (STAT_RESET)
AT-0032.7: get_parameter(STAT_RESET): PARAM_VALUE {param_id : STAT_RESET, param_value : 1.0, param_type : 6, param_count : 1461, param_index : 65535}
AT-0032.7: Sending param_request_read for (STAT_BOOTCNT)
AT-0032.7: AP: Airspeed 1 calibrated
AT-0032.7: get_parameter(STAT_BOOTCNT): PARAM_VALUE {param_id : STAT_BOOTCNT, param_value : 1.0, param_type : 4, param_count : 1461, param_index : 65535}
AT-0032.7: Sending reboot command
AT-0032.7: Sending COMMAND_LONG to (1,1) (MAV_CMD_PREFLIGHT_REBOOT_SHUTDOWN=246) (p1=1.000000 p2=1.000000 p3=0.000000 p4=0.000000 p5=0.000000 p6=0.000000  p7=0.000000)
AT-0032.7: Sending param_request_read for (STAT_BOOTCNT)
AT-0032.7: While awaiting reboot received (COMMAND_ACK {command : 246, result : 0, progress : 0, result_param2 : 0, target_system : 250, target_component : 250})
EOF on TCP socket
Attempting reconnect
[Errno 111] Connection refused sleeping
arduplane: Home: -35.362938 149.165085 alt=585.000000m hdg=354.000000
arduplane: Starting sketch 'ArduPlane'
arduplane: Starting SITL input
arduplane: Using Irlock at port : 9005
arduplane: Using \clock topic for DDS timing: disabled
arduplane: bind port 5760 for SERIAL0
arduplane: SERIAL0 on TCP port 5760
arduplane: Waiting for connection ....
arduplane: Connection on serial port 5760
arduplane: Loaded defaults from @ROMFS/models/plane.parm,@ROMFS/models/plane-reverse-servo-pitch-yaw.parm,@ROMFS/models/plane-reverse-rc-pitch-yaw.parm,/tmp/tmp10uovu1w
arduplane: bind port 5762 for SERIAL1
arduplane: SERIAL1 on TCP port 5762
arduplane: bind port 5763 for SERIAL2
arduplane: SERIAL2 on TCP port 5763
arduplane: Smoothing reset at 0.001
arduplane: validate_structures:536: Validating structures
arduplane: Waiting for internal clock bits to be set (current=0x00)
AT-0032.8: get_parameter(STAT_BOOTCNT): None
AT-0032.8: Sending param_request_read for (STAT_BOOTCNT)
AT-0032.8: AP: Ground start
AT-0032.8: AP: Skipping INS calibration
AT-0032.8: AP: Calibrating barometer
AT-0032.8: AP: RCInput: decoding UDP (Pulses)
arduplane: Loaded defaults from @ROMFS/models/plane.parm,@ROMFS/models/plane-reverse-servo-pitch-yaw.parm,@ROMFS/models/plane-reverse-rc-pitch-yaw.parm,/tmp/tmp10uovu1w
AT-0032.8: get_parameter(STAT_BOOTCNT): PARAM_VALUE {param_id : STAT_BOOTCNT, param_value : 2.0, param_type : 4, param_count : 1451, param_index : 65535}
AT-0032.8: current=2.0 required=2
AT-0032.8: Doing timesync roundtrip
AT-0032.8: Received: TIMESYNC {tc1 : 984928000, ts1 : 665719931130}
AT-0032.8: Received TIMESYNC response after 0.000092s
AT-0032.8: Calling initialise-after-reboot
AT-0032.8: Drained 0 messages from mav (0.000000/s)
AT-0032.9: Doing timesync roundtrip
AT-0032.9: AP: Barometer 1 calibration complete
AT-0032.9: AP: Barometer 2 calibration complete
AT-0032.9: AP: Airspeed 1 calibration started
AT-0032.9: AP: ArduPilot Ready
AT-0032.9: Received: TIMESYNC {tc1 : 1722966000, ts1 : 670014898426}
AT-0032.9: Received TIMESYNC response after 0.000025s
AT-0032.9: AP: Throttle failsafe off
AT-0033.0: Reboot complete
AT-0033.0: set_parameters: ({})
AT-0033.0: Sending COMMAND_LONG to (1,1) (MAV_CMD_REQUEST_MESSAGE=512) (p1=164.000000 p2=0.000000 p3=0.000000 p4=0.000000 p5=0.000000 p6=0.000000  p7=0.000000)
AT-0033.0: Simstate Close to startup location: dist=0.011132 max=1.000000 (simstate: Location(lat=-35.3629381 lng=149.1650850 no-alt) start-loc: Location(lat=-35.3629380 lng=149.1650850 alt=585.00m-ABSOLUTE))
AT-0033.0: Reset SITL commandline to default
AT-0033.0: Downloading parameters
AT-0033.0: AP: ArduPlane V4.8.0-dev (e97b7242)
AT-0033.0: AP: f34bda38c22c4dee98a9bc8da64e12a2
AT-0033.3: Downloaded 1461 parameters OK (attempt=1)
AT-0033.3: Parameter leak check: clean
AT-0033.3: AP: Airspeed 1 calibrated
AT-0033.6: Received (MISSION_ACK {target_system : 250, target_component : 250, type : 0, mission_type : 1})
AT-0033.6: MISSION_ACK.target_system has expected value 250
AT-0033.6: MISSION_ACK.target_component has expected value 250
AT-0033.6: MISSION_ACK.type has expected value 0 (MAV_MISSION_ACCEPTED)
AT-0033.6: AP: Fence Indexed OK
AT-0033.9: Received (MISSION_ACK {target_system : 250, target_component : 250, type : 0, mission_type : 0})
AT-0033.9: MISSION_ACK.target_system has expected value 250
AT-0033.9: MISSION_ACK.target_component has expected value 250
AT-0033.9: MISSION_ACK.type has expected value 0 (MAV_MISSION_ACCEPTED)
AT-0033.9: AP: Flight plan received
AT-0033.9: AP: GPS 1: probing for u-blox at 230400 baud
AT-0033.9: AP: GPS 1: detected u-blox
AT-0034.0: AP: EKF2 IMU0 MAG0 initial yaw alignment complete
AT-0034.0: AP: EKF2 IMU1 MAG0 initial yaw alignment complete
AT-0034.0: AP: EKF3 IMU0 initialised
AT-0034.0: AP: EKF3 IMU1 initialised
AT-0034.1: Received (MISSION_ACK {target_system : 250, target_component : 250, type : 0, mission_type : 2})
AT-0034.1: MISSION_ACK.target_system has expected value 250
AT-0034.1: MISSION_ACK.target_component has expected value 250
AT-0034.1: MISSION_ACK.type has expected value 0 (MAV_MISSION_ACCEPTED)
AT-0034.1: AP: EKF3 IMU0 tilt alignment complete
AT-0034.1: AP: EKF3 IMU1 tilt alignment complete
AT-0034.1: AP: EKF3 IMU0 MAG0 initial yaw alignment complete
AT-0034.1: AP: EKF3 IMU1 MAG0 initial yaw alignment complete
AT-0034.2: Received (MISSION_ACK {target_system : 250, target_component : 250, type : 0, mission_type : 0})
AT-0034.2: MISSION_ACK.target_system has expected value 250
AT-0034.2: MISSION_ACK.target_component has expected value 250
AT-0034.2: MISSION_ACK.type has expected value 0 (MAV_MISSION_ACCEPTED)
AT-0034.2: PASSED: "ParagliderPitchJoint (Fly the articulated model with the throttle pitch damper disabled)"
AT-0034.2: Joining RC thread
AT-0034.2: Stopping SITL
arduplane: 
>>>> PASSED STEP: test.Plane.ParagliderPitchJoint at Fri Oct  9 00:27:32 2026
