DavidIngraham/ArduPilot-tinkering/scratch/paraglider-tests/separation-2026-10-07/autotest-artifacts/ArduPlane-ParagliderL1Damping.txt

AT-0000.8: ##################################################################################
AT-0000.8: ########## ParagliderL1Damping (Evaluate stronger L1 guidance damping on the extended AUTO mission)  ##########
AT-0000.8: ##################################################################################
AT-0000.8: Downloading parameters
AT-0000.8: AP: ArduPlane V4.8.0-dev (dd6d3fce)
AT-0000.8: AP: f34bda38c22c4dee98a9bc8da64e12a2
AT-0001.0: Downloaded 1460 parameters OK (attempt=1)
AT-0001.0: Doing timesync roundtrip
AT-0001.0: Received: TIMESYNC {tc1 : 5082455000, ts1 : 618475290874}
AT-0001.0: Received TIMESYNC response after 0.000000s
AT-0001.0: RC values good
AT-0001.0: Changing mode to MANUAL
AT-0001.0: Sending COMMAND_LONG to (1,1) (MAV_CMD_DO_SET_MODE=176) (p1=1.000000 p2=0.000000 p3=0.000000 p4=0.000000 p5=0.000000 p6=0.000000  p7=0.000000)
AT-0001.0: Got mode MANUAL
AT-0001.0: Overriding speedup to 10
AT-0001.0: set_parameters: ({'SIM_SPEEDUP': 10})
AT-0001.0: SIM_SPEEDUP want=10.000000 autopilot=None (attempt=1/10)
AT-0001.0: Requesting (SIM_SPEEDUP)
AT-0001.0: Received wanted PARAM_VALUE SIM_SPEEDUP=10.000000
AT-0001.0: SIM_SPEEDUP want=10.000000 autopilot=10.0 (attempt=2/10)
AT-0001.0: SIM_SPEEDUP is now 10.000000
AT-0001.0: Stopping SITL
AT-0001.1: Starting SITL
Running: "/workspace/ardupilot/build/sitl/bin/arduplane" "-w" "--home" "-35.362938,149.165085,585,354" "--model" "paraglider-throw" "--serial1=tcp:2" "--defaults" "/tmp/tmpcy045uzk,/workspace/ardupilot/Tools/autotest/default_params/paraglider.parm"
Attempting reconnect
AT-0001.1: Drained 0 messages from mav (0.000000/s)
AT-0001.1: AP: Ground start
AT-0001.1: AP: Skipping INS calibration
AT-0001.1: AP: Calibrating barometer
AT-0001.1: AP: RCInput: decoding UDP (Pulses)
AT-0001.2: Doing timesync roundtrip
AT-0001.2: Received: TIMESYNC {tc1 : 1052401000, ts1 : 627065225466}
AT-0001.2: Received TIMESYNC response after 0.000185s
AT-0001.3: AP: Barometer 1 calibration complete
AT-0001.3: AP: Barometer 2 calibration complete
AT-0001.3: AP: No airspeed sensor
AT-0001.3: AP: ArduPilot Ready
AT-0001.3: AP: Throttle failsafe off
AT-0001.3: RC values good
AT-0001.3: Sending param_request_read for (TECS_PG_ENABLE)
AT-0001.3: get_parameter(TECS_PG_ENABLE): PARAM_VALUE {param_id : TECS_PG_ENABLE, param_value : 1.0, param_type : 2, param_count : 1398, param_index : 65535}
AT-0001.3: Sending param_request_read for (SERVO1_FUNCTION)
AT-0001.4: get_parameter(SERVO1_FUNCTION): PARAM_VALUE {param_id : SERVO1_FUNCTION, param_value : 190.0, param_type : 4, param_count : 1398, param_index : 65535}
AT-0001.4: Sending param_request_read for (SERVO2_FUNCTION)
AT-0001.4: get_parameter(SERVO2_FUNCTION): PARAM_VALUE {param_id : SERVO2_FUNCTION, param_value : 191.0, param_type : 4, param_count : 1398, param_index : 65535}
AT-0001.4: TECS_PG_ENABLE has expected value 1.000000
AT-0001.4: SERVO1_FUNCTION has expected value 190.000000
AT-0001.4: SERVO2_FUNCTION has expected value 191.000000
AT-0001.4: set_parameters: ({'TKOFF_ALT': 60, 'SERVO7_FUNCTION': 0})
AT-0001.4: TKOFF_ALT want=60.000000 autopilot=None (attempt=1/20)
AT-0001.4: Requesting (TKOFF_ALT)
AT-0001.4: SERVO7_FUNCTION want=0.000000 autopilot=None (attempt=1/20)
AT-0001.4: Requesting (SERVO7_FUNCTION)
AT-0001.4: Received wanted PARAM_VALUE TKOFF_ALT=50.000000
AT-0001.4: Received wanted PARAM_VALUE SERVO7_FUNCTION=0.000000
AT-0001.4: TKOFF_ALT want=60.000000 autopilot=50.0 (attempt=2/20)
AT-0001.4: Sending set (TKOFF_ALT) to (60.000000) (old=50.000000)
AT-0001.4: SERVO7_FUNCTION want=0.000000 autopilot=0.0 (attempt=2/20)
AT-0001.4: SERVO7_FUNCTION is now 0.000000
AT-0001.4: Received wanted PARAM_VALUE TKOFF_ALT=60.000000
AT-0001.4: TKOFF_ALT want=60.000000 autopilot=60.0 (attempt=3/20)
AT-0001.4: TKOFF_ALT is now 60.000000
AT-0001.4: Changing mode to TAKEOFF
AT-0001.4: Sending COMMAND_LONG to (1,1) (MAV_CMD_DO_SET_MODE=176) (p1=1.000000 p2=13.000000 p3=0.000000 p4=0.000000 p5=0.000000 p6=0.000000  p7=0.000000)
AT-0001.4: Got mode TAKEOFF
AT-0001.4: Waiting for ready to arm
AT-0001.4: Sending param_request_read for (AHRS_EKF_TYPE)
AT-0001.4: get_parameter(AHRS_EKF_TYPE): PARAM_VALUE {param_id : AHRS_EKF_TYPE, param_value : 3.0, param_type : 2, param_count : 1398, param_index : 65535}
AT-0001.4: Waiting for EKF value 831
AT-0001.4: Want=831 got=1024 errors=1024
AT-0001.6: Want=831 got=1024 errors=1024
AT-0001.7: Want=831 got=1024 errors=1024
AT-0001.8: Want=831 got=1024 errors=1024
AT-0001.9: Want=831 got=1024 errors=1024
AT-0002.0: Want=831 got=1024 errors=1024
AT-0002.0: AP: GPS 1: probing for u-blox at 230400 baud
AT-0002.0: AP: GPS 1: detected u-blox
AT-0002.1: Want=831 got=1024 errors=1024
AT-0002.1: AP: EKF3 IMU0 initialised
AT-0002.1: AP: EKF3 IMU1 initialised
AT-0002.2: Want=831 got=1024 errors=1024
AT-0002.3: Want=831 got=0 errors=0
AT-0002.3: AP: EKF3 IMU0 tilt alignment complete
AT-0002.3: AP: EKF3 IMU1 tilt alignment complete
AT-0002.3: AP: EKF3 IMU0 MAG0 initial yaw alignment complete
AT-0002.3: AP: EKF3 IMU1 MAG0 initial yaw alignment complete
AT-0002.4: Want=831 got=167 errors=128
AT-0002.5: Want=831 got=167 errors=128
AT-0002.6: Want=831 got=167 errors=128
AT-0002.7: Want=831 got=167 errors=128
AT-0002.8: Want=831 got=167 errors=128
AT-0002.9: Want=831 got=167 errors=128
AT-0003.1: Want=831 got=167 errors=128
AT-0003.1: AP: EKF3 IMU0 origin set
AT-0003.1: AP: EKF3 IMU1 origin set
AT-0003.1: AP: EKF3 IMU0 is using GPS
AT-0003.1: AP: EKF3 IMU1 is using GPS
AT-0003.1: AP: AHRS: EKF3 active
AT-0003.1: AP: Field Elevation Set: 585m
AT-0003.1: EKF Flags OK
AT-0003.1: Waiting for GPS health
AT-0003.2: GPS healthy after 0.000000/30.000000 seconds
AT-0003.2: Polled home position (HOME_POSITION {latitude : -353629380, longitude : 1491650850, altitude : 585090, x : 0.0, y : 0.0, z : -0.0, q : [nan, nan, nan, nan], approach_x : 0.0, approach_y : 0.0, approach_z : 0.0, time_usec : 20984936})
AT-0003.2: Doing timesync roundtrip
AT-0003.2: Received: TIMESYNC {tc1 : 21129367000, ts1 : 639950127354}
AT-0003.2: Received TIMESYNC response after 0.000000s
AT-0003.2: Took 18 seconds to become armable
AT-0003.2: Arm motors with MAVLink cmd
AT-0003.2: Sending COMMAND_LONG to (1,1) (MAV_CMD_COMPONENT_ARM_DISARM=400) (p1=1.000000 p2=0.000000 p3=0.000000 p4=0.000000 p5=0.000000 p6=0.000000  p7=0.000000)
AT-0003.2: ACK received: COMMAND_ACK {command : 400, result : 0, progress : 0, result_param2 : 0, target_system : 250, target_component : 250} (0.000000s)
AT-0003.3: AP: Throttle armed
AT-0003.3: AP: Armed AUTO, xaccel = -0.0 m/s/s, waiting 0.2 sec
AT-0003.3: AP: Triggered AUTO. GPS speed = 0.0
AT-0003.3: Motors ARMED
AT-0003.3: RC values good
AT-0003.3: Sending COMMAND_LONG to (1,1) (MAV_CMD_DO_SET_SERVO=183) (p1=7.000000 p2=2000.000000 p3=0.000000 p4=0.000000 p5=0.000000 p6=0.000000  p7=0.000000)
AT-0003.3: ACK received: COMMAND_ACK {command : 183, result : 0, progress : 0, result_param2 : 0, target_system : 250, target_component : 250} (0.000000s)
AT-0003.3: Waiting for Altitude=62.50 with accuracy 7.50
AT-0003.3: Altitude=-0.02 (want 62.500000 +- 7.500000)
AT-0003.4: AP: Takeoff to 60m for 200.0m heading 354.0 deg
AT-0003.4: AP: Autoland direction= 353
AT-0003.5: Altitude=4.88 (want 62.500000 +- 7.500000)
AT-0003.6: Altitude=8.11 (want 62.500000 +- 7.500000)
AT-0003.7: Altitude=12.65 (want 62.500000 +- 7.500000)
AT-0003.8: Altitude=14.65 (want 62.500000 +- 7.500000)
AT-0003.9: Altitude=12.35 (want 62.500000 +- 7.500000)
AT-0004.0: Altitude=6.24 (want 62.500000 +- 7.500000)
AT-0004.1: Altitude=3.22 (want 62.500000 +- 7.500000)
AT-0004.2: Altitude=1.07 (want 62.500000 +- 7.500000)
AT-0004.3: AP: SIM Hit ground at 2.107569 m/s
AT-0004.3: Altitude=-0.23 (want 62.500000 +- 7.500000)
AT-0004.4: Altitude=0.28 (want 62.500000 +- 7.500000)
AT-0004.5: Altitude=3.21 (want 62.500000 +- 7.500000)
AT-0004.6: Altitude=5.18 (want 62.500000 +- 7.500000)
AT-0004.7: Altitude=6.41 (want 62.500000 +- 7.500000)
AT-0004.8: Altitude=8.24 (want 62.500000 +- 7.500000)
AT-0004.9: Altitude=10.65 (want 62.500000 +- 7.500000)
AT-0005.0: Altitude=12.26 (want 62.500000 +- 7.500000)
AT-0005.1: Altitude=13.92 (want 62.500000 +- 7.500000)
AT-0005.2: Altitude=15.93 (want 62.500000 +- 7.500000)
AT-0005.4: Altitude=18.02 (want 62.500000 +- 7.500000)
AT-0005.5: Altitude=19.62 (want 62.500000 +- 7.500000)
AT-0005.6: Altitude=21.57 (want 62.500000 +- 7.500000)
AT-0005.7: Altitude=23.50 (want 62.500000 +- 7.500000)
AT-0005.8: Altitude=25.44 (want 62.500000 +- 7.500000)
AT-0005.9: Altitude=27.16 (want 62.500000 +- 7.500000)
AT-0006.0: Altitude=29.20 (want 62.500000 +- 7.500000)
AT-0006.1: Altitude=31.04 (want 62.500000 +- 7.500000)
AT-0006.2: Altitude=32.94 (want 62.500000 +- 7.500000)
AT-0006.3: Altitude=34.91 (want 62.500000 +- 7.500000)
AT-0006.4: Altitude=36.93 (want 62.500000 +- 7.500000)
AT-0006.5: Altitude=38.91 (want 62.500000 +- 7.500000)
AT-0006.6: Altitude=40.86 (want 62.500000 +- 7.500000)
AT-0006.7: Altitude=42.86 (want 62.500000 +- 7.500000)
AT-0006.9: Altitude=44.85 (want 62.500000 +- 7.500000)
AT-0007.0: Altitude=46.84 (want 62.500000 +- 7.500000)
AT-0007.1: Altitude=48.78 (want 62.500000 +- 7.500000)
AT-0007.2: Altitude=50.76 (want 62.500000 +- 7.500000)
AT-0007.3: Altitude=52.73 (want 62.500000 +- 7.500000)
AT-0007.4: Altitude=54.70 (want 62.500000 +- 7.500000)
AT-0007.4: Attained Altitude=55.066
AT-0007.4: Sending COMMAND_LONG to (1,1) (MAV_CMD_DO_SET_SERVO=183) (p1=7.000000 p2=1000.000000 p3=0.000000 p4=0.000000 p5=0.000000 p6=0.000000  p7=0.000000)
AT-0007.4: ACK received: COMMAND_ACK {command : 183, result : 0, progress : 0, result_param2 : 0, target_system : 250, target_component : 250} (0.000000s)
AT-0007.4: Changing mode to FBWB
AT-0007.4: Sending COMMAND_LONG to (1,1) (MAV_CMD_DO_SET_MODE=176) (p1=1.000000 p2=6.000000 p3=0.000000 p4=0.000000 p5=0.000000 p6=0.000000  p7=0.000000)
AT-0007.4: Got mode FBWB
AT-0007.5: RC values good
AT-0007.5: Waiting for Altitude=60.00 with accuracy 15.00
AT-0007.5: Altitude=56.15 (got 60.000000 +- 15.000000)
AT-0007.6: Altitude=57.87 (got 60.000000 +- 15.000000) (maintain=1.1/15.0)
AT-0007.7: Altitude=58.63 (got 60.000000 +- 15.000000) (maintain=2.2/15.0)
AT-0007.8: Altitude=58.59 (got 60.000000 +- 15.000000) (maintain=3.3/15.0)
AT-0007.9: Altitude=58.38 (got 60.000000 +- 15.000000) (maintain=4.4/15.0)
AT-0008.0: Altitude=58.19 (got 60.000000 +- 15.000000) (maintain=5.5/15.0)
AT-0008.1: Altitude=57.98 (got 60.000000 +- 15.000000) (maintain=6.6/15.0)
AT-0008.3: Altitude=57.77 (got 60.000000 +- 15.000000) (maintain=7.7/15.0)
AT-0008.4: Altitude=57.59 (got 60.000000 +- 15.000000) (maintain=8.7/15.0)
AT-0008.5: Altitude=57.40 (got 60.000000 +- 15.000000) (maintain=9.8/15.0)
AT-0008.6: Altitude=57.24 (got 60.000000 +- 15.000000) (maintain=10.8/15.0)
AT-0008.7: Altitude=57.06 (got 60.000000 +- 15.000000) (maintain=11.9/15.0)
AT-0008.8: Altitude=56.93 (got 60.000000 +- 15.000000) (maintain=12.9/15.0)
AT-0008.9: Altitude=56.77 (got 60.000000 +- 15.000000) (maintain=14.0/15.0)
AT-0009.0: Altitude=56.61 (got 60.000000 +- 15.000000) (maintain=15.0/15.0)
AT-0009.0: Attained Altitude=57.62095862068965
AT-0009.0: set_parameters: ({'WP_RADIUS': 40, 'WP_MAX_RADIUS': 0, 'WP_LOITER_RAD': 60, 'SIM_WIND_SPD': 0, 'SIM_WIND_TURB': 0})
AT-0009.0: WP_RADIUS want=40.000000 autopilot=None (attempt=1/50)
AT-0009.0: Requesting (WP_RADIUS)
AT-0009.0: WP_MAX_RADIUS want=0.000000 autopilot=None (attempt=1/50)
AT-0009.0: Requesting (WP_MAX_RADIUS)
AT-0009.0: WP_LOITER_RAD want=60.000000 autopilot=None (attempt=1/50)
AT-0009.0: Requesting (WP_LOITER_RAD)
AT-0009.0: SIM_WIND_SPD want=0.000000 autopilot=None (attempt=1/50)
AT-0009.0: Requesting (SIM_WIND_SPD)
AT-0009.0: SIM_WIND_TURB want=0.000000 autopilot=None (attempt=1/50)
AT-0009.0: Requesting (SIM_WIND_TURB)
AT-0009.0: Received wanted PARAM_VALUE WP_RADIUS=90.000000
AT-0009.0: Received wanted PARAM_VALUE WP_MAX_RADIUS=0.000000
AT-0009.0: Received wanted PARAM_VALUE WP_LOITER_RAD=60.000000
AT-0009.0: Received wanted PARAM_VALUE SIM_WIND_SPD=0.000000
AT-0009.0: Received wanted PARAM_VALUE SIM_WIND_TURB=0.000000
AT-0009.0: WP_RADIUS want=40.000000 autopilot=90.0 (attempt=2/50)
AT-0009.0: Sending set (WP_RADIUS) to (40.000000) (old=90.000000)
AT-0009.0: WP_MAX_RADIUS want=0.000000 autopilot=0.0 (attempt=2/50)
AT-0009.0: WP_MAX_RADIUS is now 0.000000
AT-0009.0: WP_LOITER_RAD want=60.000000 autopilot=60.0 (attempt=2/50)
AT-0009.0: WP_LOITER_RAD is now 60.000000
AT-0009.0: SIM_WIND_SPD want=0.000000 autopilot=0.0 (attempt=2/50)
AT-0009.0: SIM_WIND_SPD is now 0.000000
AT-0009.0: SIM_WIND_TURB want=0.000000 autopilot=0.0 (attempt=2/50)
AT-0009.0: SIM_WIND_TURB is now 0.000000
AT-0009.0: Received wanted PARAM_VALUE WP_RADIUS=40.000000
AT-0009.0: WP_RADIUS want=40.000000 autopilot=40.0 (attempt=3/50)
AT-0009.0: WP_RADIUS is now 40.000000
AT-0009.0: set_parameters: ({'NAVL1_DAMPING': 0.85})
AT-0009.0: NAVL1_DAMPING want=0.850000 autopilot=None (attempt=1/10)
AT-0009.0: Requesting (NAVL1_DAMPING)
AT-0009.0: Received wanted PARAM_VALUE NAVL1_DAMPING=0.750000
AT-0009.0: NAVL1_DAMPING want=0.850000 autopilot=0.75 (attempt=2/10)
AT-0009.0: Sending set (NAVL1_DAMPING) to (0.850000) (old=0.750000)
AT-0009.0: Received wanted PARAM_VALUE NAVL1_DAMPING=0.850000
AT-0009.0: NAVL1_DAMPING want=0.850000 autopilot=0.8500000238418579 (attempt=3/10)
AT-0009.0: NAVL1_DAMPING is now 0.850000
AT-0009.0: Sending param_request_read for (NAVL1_DAMPING)
AT-0009.0: get_parameter(NAVL1_DAMPING): PARAM_VALUE {param_id : NAVL1_DAMPING, param_value : 0.8500000238418579, param_type : 9, param_count : 1398, param_index : 65535}
AT-0009.0: Sending param_request_read for (NAVL1_PERIOD)
AT-0009.1: get_parameter(NAVL1_PERIOD): PARAM_VALUE {param_id : NAVL1_PERIOD, param_value : 17.0, param_type : 9, param_count : 1398, param_index : 65535}
AT-0009.1: Polled home position (HOME_POSITION {latitude : -353629380, longitude : 1491650850, altitude : 585080, x : 0.0, y : 0.0, z : 0.009999999776482582, q : [nan, nan, nan, nan], approach_x : 0.0, approach_y : 0.0, approach_z : 0.0, time_usec : 79984660})
AT-0009.1: check waypoints upload/download: upload 13 items
AT-0009.1: Doing timesync roundtrip
AT-0009.1: Received: TIMESYNC {tc1 : 80062451000, ts1 : 661424963834}
AT-0009.1: Received TIMESYNC response after 0.000000s
AT-0009.1: Handling request for item 0/12
AT-0009.1: Item (MISSION_ITEM_INT {target_system : 1, target_component : 1, seq : 0, frame : 6, command : 16, current : 0, autocontinue : 0, param1 : 0, param2 : 0, param3 : 0, param4 : 0, x : 0, y : 0, z : 0, mission_type : 0})
AT-0009.1: Handling request for item 1/12
AT-0009.1: Item (MISSION_ITEM_INT {target_system : 1, target_component : 1, seq : 1, frame : 6, command : 16, current : 0, autocontinue : 0, param1 : 0, param2 : 0, param3 : 0, param4 : 0, x : -353606921, y : 1491650849, z : 60, mission_type : 0})
AT-0009.1: Handling request for item 2/12
AT-0009.1: Item (MISSION_ITEM_INT {target_system : 1, target_component : 1, seq : 2, frame : 6, command : 16, current : 0, autocontinue : 0, param1 : 0, param2 : 0, param3 : 0, param4 : 0, x : -353570989, y : 1491650849, z : 90, mission_type : 0})
AT-0009.1: Handling request for item 3/12
AT-0009.1: Item (MISSION_ITEM_INT {target_system : 1, target_component : 1, seq : 3, frame : 6, command : 18, current : 0, autocontinue : 0, param1 : 2, param2 : 0, param3 : 60, param4 : 0, x : -353570988, y : 1491694909, z : 90, mission_type : 0})
AT-0009.1: Handling request for item 4/12
AT-0009.1: Item (MISSION_ITEM_INT {target_system : 1, target_component : 1, seq : 4, frame : 6, command : 16, current : 0, autocontinue : 0, param1 : 0, param2 : 0, param3 : 0, param4 : 0, x : -353606921, y : 1491694910, z : 60, mission_type : 0})
AT-0009.1: Handling request for item 5/12
AT-0009.1: Item (MISSION_ITEM_INT {target_system : 1, target_component : 1, seq : 5, frame : 6, command : 16, current : 0, autocontinue : 0, param1 : 0, param2 : 0, param3 : 0, param4 : 0, x : -353606921, y : 1491650849, z : 45, mission_type : 0})
AT-0009.1: Handling request for item 6/12
AT-0009.1: Item (MISSION_ITEM_INT {target_system : 1, target_component : 1, seq : 6, frame : 6, command : 16, current : 0, autocontinue : 0, param1 : 0, param2 : 0, param3 : 0, param4 : 0, x : -353642854, y : 1491650849, z : 45, mission_type : 0})
AT-0009.1: Handling request for item 7/12
AT-0009.1: Item (MISSION_ITEM_INT {target_system : 1, target_component : 1, seq : 7, frame : 6, command : 16, current : 0, autocontinue : 0, param1 : 0, param2 : 0, param3 : 0, param4 : 0, x : -353642854, y : 1491606787, z : 75, mission_type : 0})
AT-0009.1: Handling request for item 8/12
AT-0009.1: Item (MISSION_ITEM_INT {target_system : 1, target_component : 1, seq : 8, frame : 6, command : 18, current : 0, autocontinue : 0, param1 : 2, param2 : 0, param3 : -60, param4 : 0, x : -353606921, y : 1491606789, z : 75, mission_type : 0})
AT-0009.1: Handling request for item 9/12
AT-0009.1: Item (MISSION_ITEM_INT {target_system : 1, target_component : 1, seq : 9, frame : 6, command : 16, current : 0, autocontinue : 0, param1 : 0, param2 : 0, param3 : 0, param4 : 0, x : -353570988, y : 1491606790, z : 55, mission_type : 0})
AT-0009.1: Handling request for item 10/12
AT-0009.1: Item (MISSION_ITEM_INT {target_system : 1, target_component : 1, seq : 10, frame : 6, command : 16, current : 0, autocontinue : 0, param1 : 0, param2 : 0, param3 : 0, param4 : 0, x : -353570989, y : 1491650849, z : 55, mission_type : 0})
AT-0009.1: Handling request for item 11/12
AT-0009.1: Item (MISSION_ITEM_INT {target_system : 1, target_component : 1, seq : 11, frame : 6, command : 16, current : 0, autocontinue : 0, param1 : 0, param2 : 0, param3 : 0, param4 : 0, x : -353606921, y : 1491650849, z : 60, mission_type : 0})
AT-0009.1: Handling request for item 12/12
AT-0009.1: Item (MISSION_ITEM_INT {target_system : 1, target_component : 1, seq : 12, frame : 6, command : 17, current : 0, autocontinue : 0, param1 : 0, param2 : 0, param3 : 60, param4 : 0, x : -353629290, y : 1491650960, z : 60, mission_type : 0})
AT-0009.1: All sent
AT-0009.1: Upload of all 13 items succeeded
AT-0009.1: check waypoints upload/download: download items
AT-0009.1: Sending mission_request_list
AT-0009.1: AP: Flight plan received
AT-0009.1: Requesting item 0 (remaining=13)
AT-0009.2: Got (MISSION_ITEM_INT {target_system : 250, target_component : 250, seq : 0, frame : 0, command : 16, current : 0, autocontinue : 1, param1 : 0.0, param2 : 0.0, param3 : 0.0, param4 : 0.0, x : -353629380, y : 1491650850, z : 585.0800170898438, mission_type : 0})
AT-0009.2: Item 0 OK
AT-0009.2: Requesting item 1 (remaining=12)
AT-0009.2: Got (MISSION_ITEM_INT {target_system : 250, target_component : 250, seq : 1, frame : 3, command : 16, current : 0, autocontinue : 1, param1 : 0.0, param2 : 0.0, param3 : 0.0, param4 : 0.0, x : -353606921, y : 1491650849, z : 60.0, mission_type : 0})
AT-0009.2: Item 1 OK
AT-0009.2: Requesting item 2 (remaining=11)
AT-0009.2: Got (MISSION_ITEM_INT {target_system : 250, target_component : 250, seq : 2, frame : 3, command : 16, current : 0, autocontinue : 1, param1 : 0.0, param2 : 0.0, param3 : 0.0, param4 : 0.0, x : -353570989, y : 1491650849, z : 90.0, mission_type : 0})
AT-0009.2: Item 2 OK
AT-0009.2: Requesting item 3 (remaining=10)
AT-0009.2: Got (MISSION_ITEM_INT {target_system : 250, target_component : 250, seq : 3, frame : 3, command : 18, current : 0, autocontinue : 1, param1 : 2.0, param2 : 0.0, param3 : 60.0, param4 : 0.0, x : -353570988, y : 1491694909, z : 90.0, mission_type : 0})
AT-0009.2: Item 3 OK
AT-0009.2: Requesting item 4 (remaining=9)
AT-0009.2: Got (MISSION_ITEM_INT {target_system : 250, target_component : 250, seq : 4, frame : 3, command : 16, current : 0, autocontinue : 1, param1 : 0.0, param2 : 0.0, param3 : 0.0, param4 : 0.0, x : -353606921, y : 1491694910, z : 60.0, mission_type : 0})
AT-0009.2: Item 4 OK
AT-0009.2: Requesting item 5 (remaining=8)
AT-0009.2: Got (MISSION_ITEM_INT {target_system : 250, target_component : 250, seq : 5, frame : 3, command : 16, current : 0, autocontinue : 1, param1 : 0.0, param2 : 0.0, param3 : 0.0, param4 : 0.0, x : -353606921, y : 1491650849, z : 45.0, mission_type : 0})
AT-0009.2: Item 5 OK
AT-0009.2: Requesting item 6 (remaining=7)
AT-0009.2: Got (MISSION_ITEM_INT {target_system : 250, target_component : 250, seq : 6, frame : 3, command : 16, current : 0, autocontinue : 1, param1 : 0.0, param2 : 0.0, param3 : 0.0, param4 : 0.0, x : -353642854, y : 1491650849, z : 45.0, mission_type : 0})
AT-0009.2: Item 6 OK
AT-0009.2: Requesting item 7 (remaining=6)
AT-0009.2: Got (MISSION_ITEM_INT {target_system : 250, target_component : 250, seq : 7, frame : 3, command : 16, current : 0, autocontinue : 1, param1 : 0.0, param2 : 0.0, param3 : 0.0, param4 : 0.0, x : -353642854, y : 1491606787, z : 75.0, mission_type : 0})
AT-0009.2: Item 7 OK
AT-0009.2: Requesting item 8 (remaining=5)
AT-0009.2: Got (MISSION_ITEM_INT {target_system : 250, target_component : 250, seq : 8, frame : 3, command : 18, current : 0, autocontinue : 1, param1 : 2.0, param2 : 0.0, param3 : -60.0, param4 : 0.0, x : -353606921, y : 1491606789, z : 75.0, mission_type : 0})
AT-0009.2: Item 8 OK
AT-0009.2: Requesting item 9 (remaining=4)
AT-0009.2: Got (MISSION_ITEM_INT {target_system : 250, target_component : 250, seq : 9, frame : 3, command : 16, current : 0, autocontinue : 1, param1 : 0.0, param2 : 0.0, param3 : 0.0, param4 : 0.0, x : -353570988, y : 1491606790, z : 55.0, mission_type : 0})
AT-0009.2: Item 9 OK
AT-0009.2: Requesting item 10 (remaining=3)
AT-0009.2: Got (MISSION_ITEM_INT {target_system : 250, target_component : 250, seq : 10, frame : 3, command : 16, current : 0, autocontinue : 1, param1 : 0.0, param2 : 0.0, param3 : 0.0, param4 : 0.0, x : -353570989, y : 1491650849, z : 55.0, mission_type : 0})
AT-0009.2: Item 10 OK
AT-0009.2: Requesting item 11 (remaining=2)
AT-0009.2: Got (MISSION_ITEM_INT {target_system : 250, target_component : 250, seq : 11, frame : 3, command : 16, current : 0, autocontinue : 1, param1 : 0.0, param2 : 0.0, param3 : 0.0, param4 : 0.0, x : -353606921, y : 1491650849, z : 60.0, mission_type : 0})
AT-0009.2: Item 11 OK
AT-0009.2: Requesting item 12 (remaining=1)
AT-0009.2: Got (MISSION_ITEM_INT {target_system : 250, target_component : 250, seq : 12, frame : 3, command : 17, current : 0, autocontinue : 1, param1 : 0.0, param2 : 0.0, param3 : 60.0, param4 : 0.0, x : -353629290, y : 1491650960, z : 60.0, mission_type : 0})
AT-0009.2: Item 12 OK
AT-0009.2: All received
AT-0009.2: Checking waypoint items same
AT-0009.2: Checking 13 items
AT-0009.2: Comparing (MISSION_ITEM_INT {target_system : 1, target_component : 1, seq : 1, frame : 6, command : 16, current : 0, autocontinue : 0, param1 : 0, param2 : 0, param3 : 0, param4 : 0, x : -353606921, y : 1491650849, z : 60, mission_type : 0}) and (MISSION_ITEM_INT {target_system : 250, target_component : 250, seq : 1, frame : 3, command : 16, current : 0, autocontinue : 1, param1 : 0.0, param2 : 0.0, param3 : 0.0, param4 : 0.0, x : -353606921, y : 1491650849, z : 60.0, mission_type : 0})
AT-0009.2: Type is 0
AT-0009.2: Comparing (MISSION_ITEM_INT {target_system : 1, target_component : 1, seq : 2, frame : 6, command : 16, current : 0, autocontinue : 0, param1 : 0, param2 : 0, param3 : 0, param4 : 0, x : -353570989, y : 1491650849, z : 90, mission_type : 0}) and (MISSION_ITEM_INT {target_system : 250, target_component : 250, seq : 2, frame : 3, command : 16, current : 0, autocontinue : 1, param1 : 0.0, param2 : 0.0, param3 : 0.0, param4 : 0.0, x : -353570989, y : 1491650849, z : 90.0, mission_type : 0})
AT-0009.2: Type is 0
AT-0009.2: Comparing (MISSION_ITEM_INT {target_system : 1, target_component : 1, seq : 3, frame : 6, command : 18, current : 0, autocontinue : 0, param1 : 2, param2 : 0, param3 : 60, param4 : 0, x : -353570988, y : 1491694909, z : 90, mission_type : 0}) and (MISSION_ITEM_INT {target_system : 250, target_component : 250, seq : 3, frame : 3, command : 18, current : 0, autocontinue : 1, param1 : 2.0, param2 : 0.0, param3 : 60.0, param4 : 0.0, x : -353570988, y : 1491694909, z : 90.0, mission_type : 0})
AT-0009.2: Type is 0
AT-0009.2: Comparing (MISSION_ITEM_INT {target_system : 1, target_component : 1, seq : 4, frame : 6, command : 16, current : 0, autocontinue : 0, param1 : 0, param2 : 0, param3 : 0, param4 : 0, x : -353606921, y : 1491694910, z : 60, mission_type : 0}) and (MISSION_ITEM_INT {target_system : 250, target_component : 250, seq : 4, frame : 3, command : 16, current : 0, autocontinue : 1, param1 : 0.0, param2 : 0.0, param3 : 0.0, param4 : 0.0, x : -353606921, y : 1491694910, z : 60.0, mission_type : 0})
AT-0009.2: Type is 0
AT-0009.2: Comparing (MISSION_ITEM_INT {target_system : 1, target_component : 1, seq : 5, frame : 6, command : 16, current : 0, autocontinue : 0, param1 : 0, param2 : 0, param3 : 0, param4 : 0, x : -353606921, y : 1491650849, z : 45, mission_type : 0}) and (MISSION_ITEM_INT {target_system : 250, target_component : 250, seq : 5, frame : 3, command : 16, current : 0, autocontinue : 1, param1 : 0.0, param2 : 0.0, param3 : 0.0, param4 : 0.0, x : -353606921, y : 1491650849, z : 45.0, mission_type : 0})
AT-0009.2: Type is 0
AT-0009.2: Comparing (MISSION_ITEM_INT {target_system : 1, target_component : 1, seq : 6, frame : 6, command : 16, current : 0, autocontinue : 0, param1 : 0, param2 : 0, param3 : 0, param4 : 0, x : -353642854, y : 1491650849, z : 45, mission_type : 0}) and (MISSION_ITEM_INT {target_system : 250, target_component : 250, seq : 6, frame : 3, command : 16, current : 0, autocontinue : 1, param1 : 0.0, param2 : 0.0, param3 : 0.0, param4 : 0.0, x : -353642854, y : 1491650849, z : 45.0, mission_type : 0})
AT-0009.2: Type is 0
AT-0009.2: Comparing (MISSION_ITEM_INT {target_system : 1, target_component : 1, seq : 7, frame : 6, command : 16, current : 0, autocontinue : 0, param1 : 0, param2 : 0, param3 : 0, param4 : 0, x : -353642854, y : 1491606787, z : 75, mission_type : 0}) and (MISSION_ITEM_INT {target_system : 250, target_component : 250, seq : 7, frame : 3, command : 16, current : 0, autocontinue : 1, param1 : 0.0, param2 : 0.0, param3 : 0.0, param4 : 0.0, x : -353642854, y : 1491606787, z : 75.0, mission_type : 0})
AT-0009.2: Type is 0
AT-0009.2: Comparing (MISSION_ITEM_INT {target_system : 1, target_component : 1, seq : 8, frame : 6, command : 18, current : 0, autocontinue : 0, param1 : 2, param2 : 0, param3 : -60, param4 : 0, x : -353606921, y : 1491606789, z : 75, mission_type : 0}) and (MISSION_ITEM_INT {target_system : 250, target_component : 250, seq : 8, frame : 3, command : 18, current : 0, autocontinue : 1, param1 : 2.0, param2 : 0.0, param3 : -60.0, param4 : 0.0, x : -353606921, y : 1491606789, z : 75.0, mission_type : 0})
AT-0009.2: Type is 0
AT-0009.2: Comparing (MISSION_ITEM_INT {target_system : 1, target_component : 1, seq : 9, frame : 6, command : 16, current : 0, autocontinue : 0, param1 : 0, param2 : 0, param3 : 0, param4 : 0, x : -353570988, y : 1491606790, z : 55, mission_type : 0}) and (MISSION_ITEM_INT {target_system : 250, target_component : 250, seq : 9, frame : 3, command : 16, current : 0, autocontinue : 1, param1 : 0.0, param2 : 0.0, param3 : 0.0, param4 : 0.0, x : -353570988, y : 1491606790, z : 55.0, mission_type : 0})
AT-0009.2: Type is 0
AT-0009.2: Comparing (MISSION_ITEM_INT {target_system : 1, target_component : 1, seq : 10, frame : 6, command : 16, current : 0, autocontinue : 0, param1 : 0, param2 : 0, param3 : 0, param4 : 0, x : -353570989, y : 1491650849, z : 55, mission_type : 0}) and (MISSION_ITEM_INT {target_system : 250, target_component : 250, seq : 10, frame : 3, command : 16, current : 0, autocontinue : 1, param1 : 0.0, param2 : 0.0, param3 : 0.0, param4 : 0.0, x : -353570989, y : 1491650849, z : 55.0, mission_type : 0})
AT-0009.2: Type is 0
AT-0009.2: Comparing (MISSION_ITEM_INT {target_system : 1, target_component : 1, seq : 11, frame : 6, command : 16, current : 0, autocontinue : 0, param1 : 0, param2 : 0, param3 : 0, param4 : 0, x : -353606921, y : 1491650849, z : 60, mission_type : 0}) and (MISSION_ITEM_INT {target_system : 250, target_component : 250, seq : 11, frame : 3, command : 16, current : 0, autocontinue : 1, param1 : 0.0, param2 : 0.0, param3 : 0.0, param4 : 0.0, x : -353606921, y : 1491650849, z : 60.0, mission_type : 0})
AT-0009.2: Type is 0
AT-0009.2: Comparing (MISSION_ITEM_INT {target_system : 1, target_component : 1, seq : 12, frame : 6, command : 17, current : 0, autocontinue : 0, param1 : 0, param2 : 0, param3 : 60, param4 : 0, x : -353629290, y : 1491650960, z : 60, mission_type : 0}) and (MISSION_ITEM_INT {target_system : 250, target_component : 250, seq : 12, frame : 3, command : 17, current : 0, autocontinue : 1, param1 : 0.0, param2 : 0.0, param3 : 60.0, param4 : 0.0, x : -353629290, y : 1491650960, z : 60.0, mission_type : 0})
AT-0009.2: Type is 0
AT-0009.3: Polled home position (HOME_POSITION {latitude : -353629380, longitude : 1491650850, altitude : 585080, x : 0.0, y : 0.0, z : 0.009999999776482582, q : [nan, nan, nan, nan], approach_x : 0.0, approach_y : 0.0, approach_z : 0.0, time_usec : 81384933})
AT-0009.3: Sending COMMAND_LONG to (1,1) (MAV_CMD_SET_MESSAGE_INTERVAL=511) (p1=33.000000 p2=100000.000000 p3=0.000000 p4=0.000000 p5=0.000000 p6=0.000000  p7=0.000000)
AT-0009.3: ACK received: COMMAND_ACK {command : 511, result : 0, progress : 0, result_param2 : 0, target_system : 250, target_component : 250} (0.000000s)
AT-0009.3: Sending COMMAND_LONG to (1,1) (MAV_CMD_SET_MESSAGE_INTERVAL=511) (p1=30.000000 p2=100000.000000 p3=0.000000 p4=0.000000 p5=0.000000 p6=0.000000  p7=0.000000)
AT-0009.3: ACK received: COMMAND_ACK {command : 511, result : 0, progress : 0, result_param2 : 0, target_system : 250, target_component : 250} (0.000000s)
AT-0009.3: Sending COMMAND_LONG to (1,1) (MAV_CMD_SET_MESSAGE_INTERVAL=511) (p1=36.000000 p2=100000.000000 p3=0.000000 p4=0.000000 p5=0.000000 p6=0.000000  p7=0.000000)
AT-0009.3: ACK received: COMMAND_ACK {command : 511, result : 0, progress : 0, result_param2 : 0, target_system : 250, target_component : 250} (0.000000s)
AT-0009.3: Sending COMMAND_LONG to (1,1) (MAV_CMD_SET_MESSAGE_INTERVAL=511) (p1=42.000000 p2=100000.000000 p3=0.000000 p4=0.000000 p5=0.000000 p6=0.000000  p7=0.000000)
AT-0009.3: ACK received: COMMAND_ACK {command : 511, result : 0, progress : 0, result_param2 : 0, target_system : 250, target_component : 250} (0.000000s)
AT-0009.3: Sending COMMAND_LONG to (1,1) (MAV_CMD_SET_MESSAGE_INTERVAL=511) (p1=62.000000 p2=100000.000000 p3=0.000000 p4=0.000000 p5=0.000000 p6=0.000000  p7=0.000000)
AT-0009.3: ACK received: COMMAND_ACK {command : 511, result : 0, progress : 0, result_param2 : 0, target_system : 250, target_component : 250} (0.000000s)
AT-0009.3: Waiting for wp=1 current=1 dist=373m
AT-0009.3: Changing mode to AUTO
AT-0009.4: Sending COMMAND_LONG to (1,1) (MAV_CMD_DO_SET_MODE=176) (p1=1.000000 p2=10.000000 p3=0.000000 p4=0.000000 p5=0.000000 p6=0.000000  p7=0.000000)
AT-0009.4: Got mode AUTO
AT-0009.4: Sending param_request_read for (AIRSPEED_CRUISE)
AT-0009.4: AP: Mission: 1 WP
AT-0009.4: get_parameter(AIRSPEED_CRUISE): PARAM_VALUE {param_id : AIRSPEED_CRUISE, param_value : 5.0, param_type : 9, param_count : 1398, param_index : 65535}
AT-0009.4: -
AT-0009.4: ---------- AUTO item 1 at 60 metres  ----------
AT-0009.4: -
AT-0009.4: Waiting for wp=1 current=1 dist=429m
AT-0009.4: Waiting for wp=2 current=1 dist=431m
AT-0009.4: Waiting for wp=2 current=1 dist=432m
AT-0009.4: Waiting for wp=2 current=1 dist=433m
AT-0009.5: Waiting for wp=2 current=1 dist=434m
AT-0009.5: Waiting for wp=2 current=1 dist=435m
AT-0009.5: Waiting for wp=2 current=1 dist=436m
AT-0009.5: Waiting for wp=2 current=1 dist=436m
AT-0009.5: Waiting for wp=2 current=1 dist=437m
AT-0009.6: Waiting for wp=2 current=1 dist=438m
AT-0009.6: Waiting for wp=2 current=1 dist=439m
AT-0009.6: Waiting for wp=2 current=1 dist=439m
AT-0009.6: Waiting for wp=2 current=1 dist=440m
AT-0009.7: Waiting for wp=2 current=1 dist=440m
AT-0009.7: Waiting for wp=2 current=1 dist=441m
AT-0009.7: Waiting for wp=2 current=1 dist=441m
AT-0009.7: Waiting for wp=2 current=1 dist=442m
AT-0009.7: Waiting for wp=2 current=1 dist=443m
AT-0009.8: Waiting for wp=2 current=1 dist=443m
AT-0009.8: Waiting for wp=2 current=1 dist=444m
AT-0009.8: Waiting for wp=2 current=1 dist=445m
AT-0009.8: Waiting for wp=2 current=1 dist=446m
AT-0009.8: Waiting for wp=2 current=1 dist=446m
AT-0009.9: Waiting for wp=2 current=1 dist=447m
AT-0009.9: Waiting for wp=2 current=1 dist=448m
AT-0009.9: Waiting for wp=2 current=1 dist=448m
AT-0009.9: Waiting for wp=2 current=1 dist=449m
AT-0009.9: Waiting for wp=2 current=1 dist=449m
AT-0010.0: Waiting for wp=2 current=1 dist=450m
AT-0010.0: Waiting for wp=2 current=1 dist=451m
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
AT-0104.5: Waiting for wp=9 current=8 dist=74m
AT-0104.5: Waiting for wp=9 current=8 dist=73m
AT-0104.6: Waiting for wp=9 current=8 dist=72m
AT-0104.6: Waiting for wp=9 current=8 dist=71m
AT-0104.6: Waiting for wp=9 current=8 dist=70m
AT-0104.6: Waiting for wp=9 current=8 dist=69m
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
