DavidIngraham/ArduPilot-tinkering/docs/assets/flight-testing/pitch-damper-fbd.png

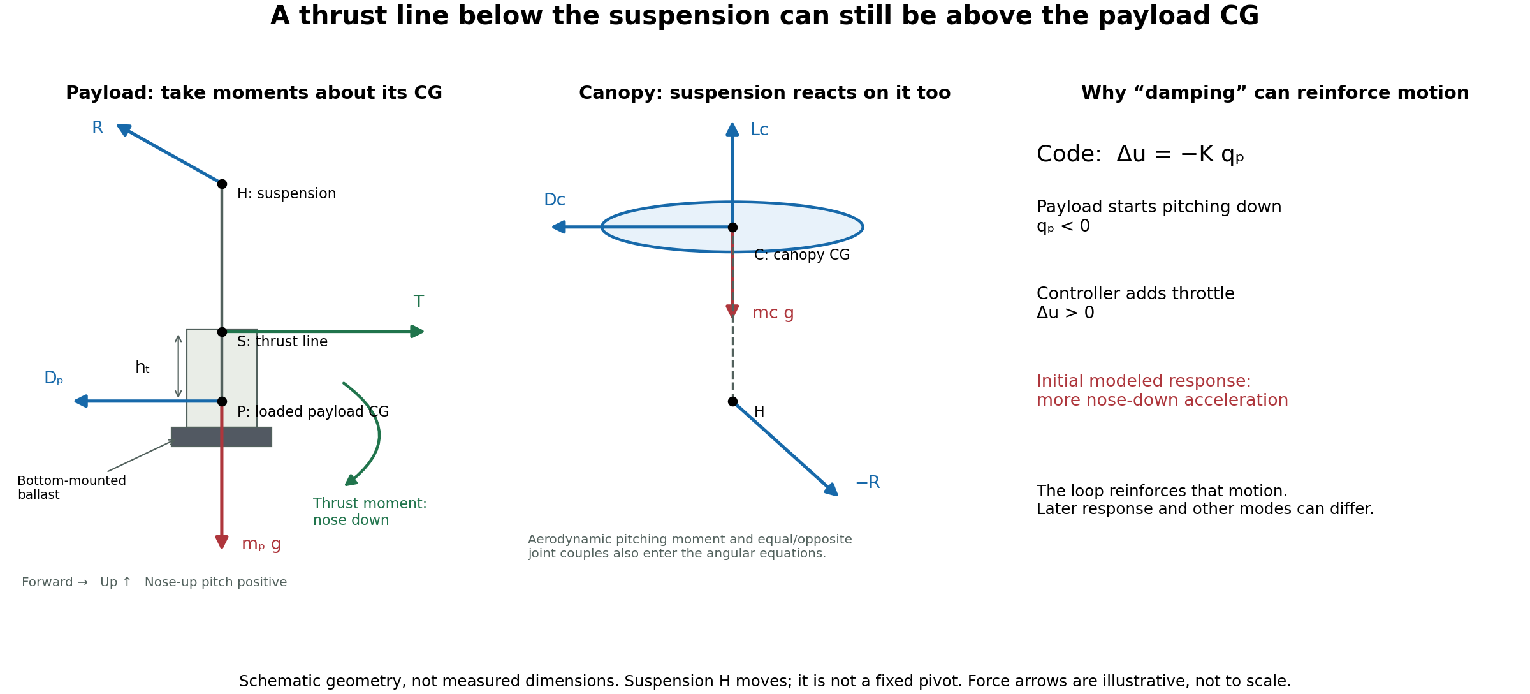
docs/assets/flight-testing/pitch-damper-fbd.png
