DavidIngraham/ArduPilot-tinkering/docs/assets/flight-testing/replay/hood-river-recap.jpg

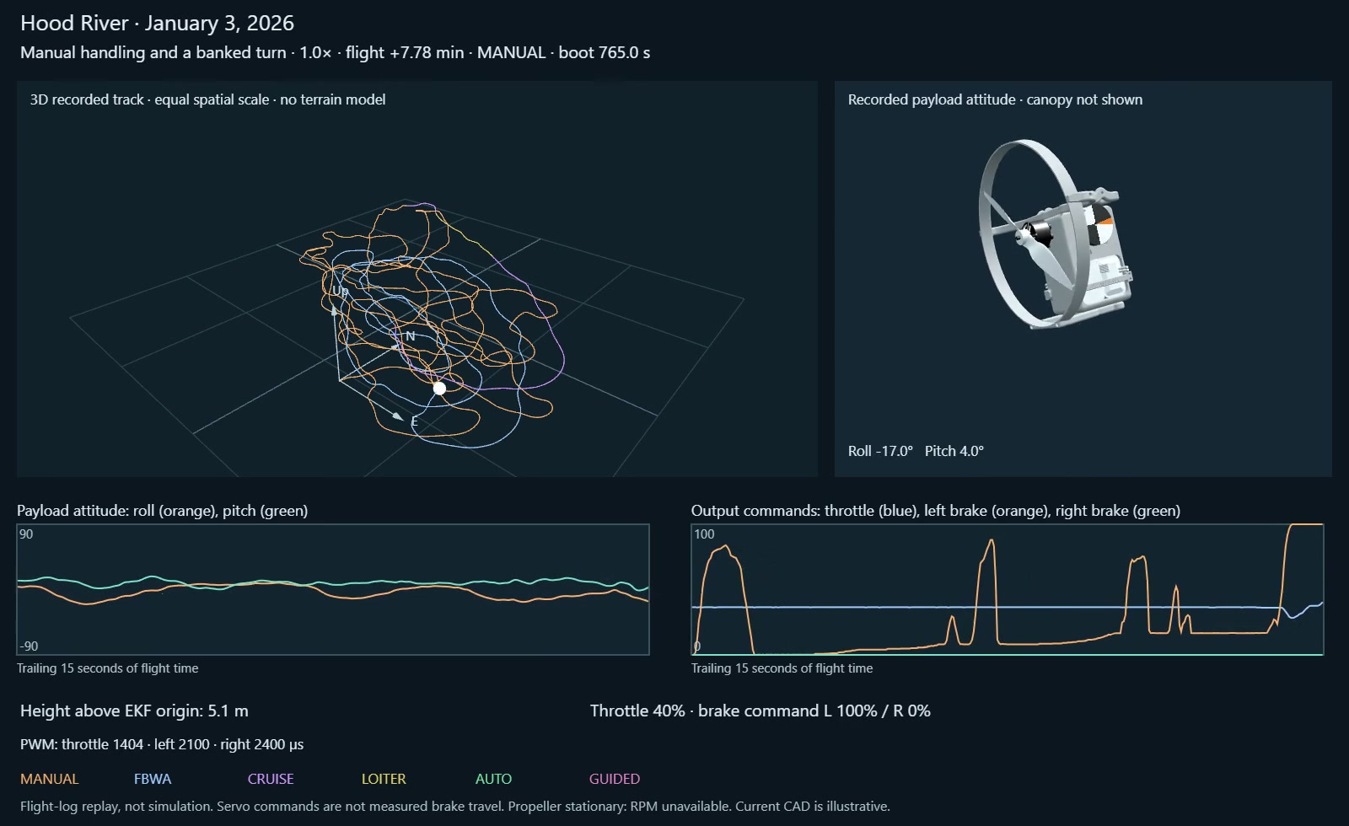
docs/assets/flight-testing/replay/hood-river-recap.jpg
