DavidIngraham/ArduPilot-tinkering/docs/assets/flight-testing/replay/trout-lake-recap.jpg

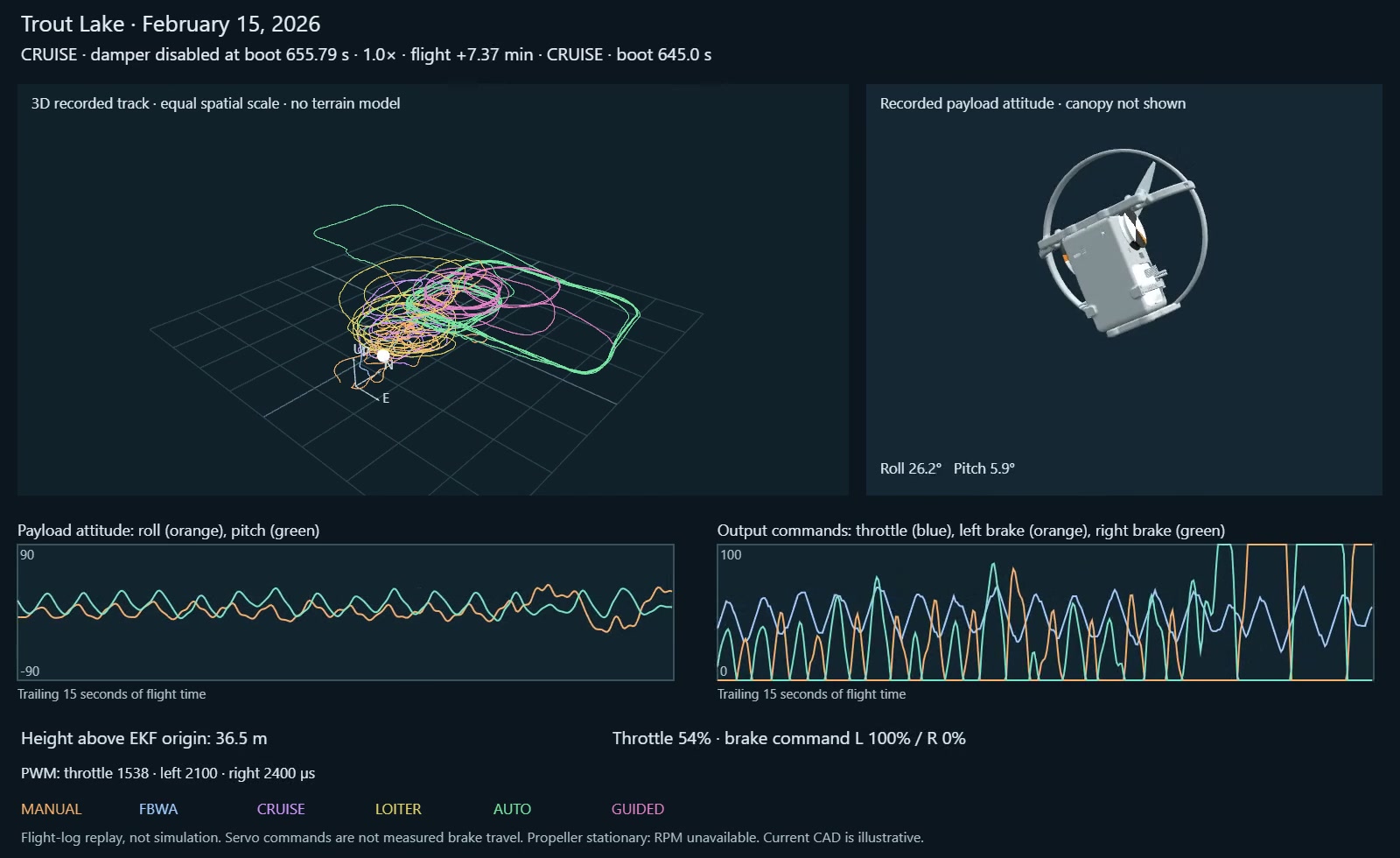
docs/assets/flight-testing/replay/trout-lake-recap.jpg
