DavidIngraham/ArduPilot-tinkering/docs/assets/flight-testing/trim-launch.jpg

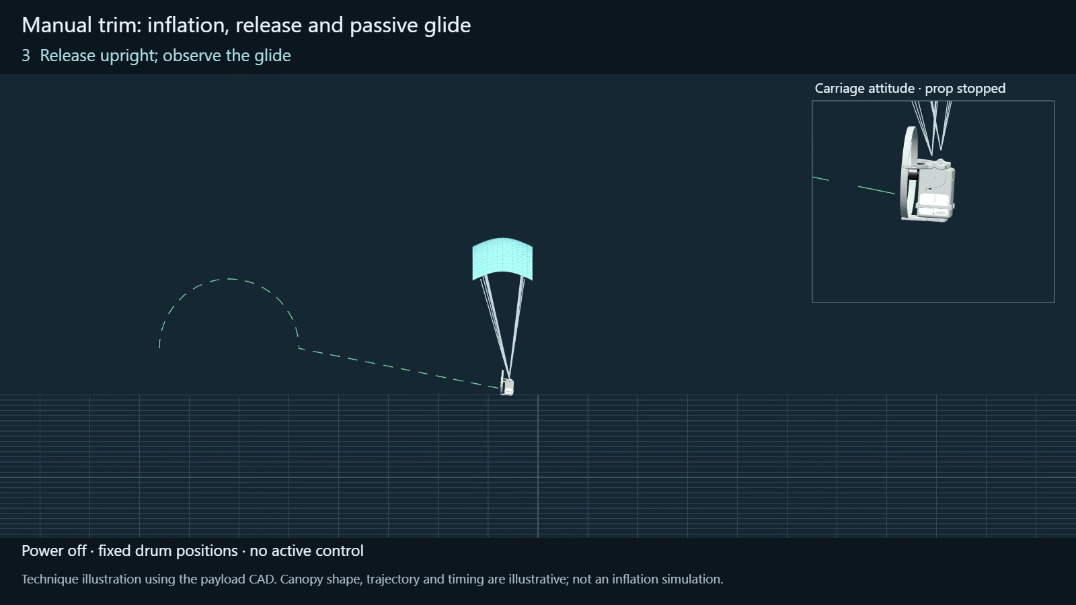
docs/assets/flight-testing/trim-launch.jpg
