DavidIngraham/ArduPilot-tinkering/research/flight-log-analysis/figures/turn-model-spike/classical-longitudinal/closed-bode.png

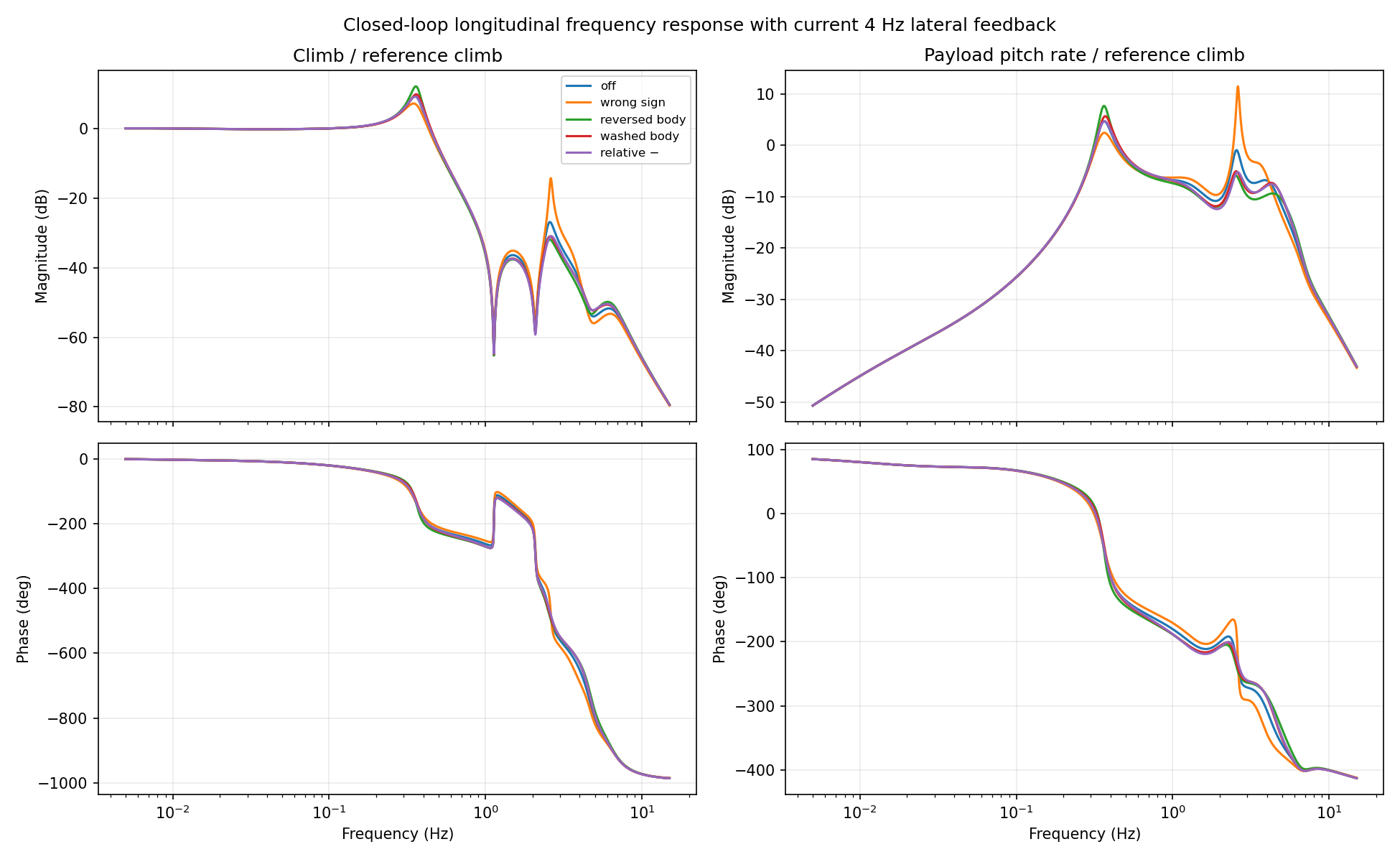
research/flight-log-analysis/figures/turn-model-spike/classical-longitudinal/closed-bode.png
