DavidIngraham/ArduPilot-tinkering/research/flight-log-analysis/figures/turn-model-spike/classical-longitudinal/damper-root-locus.png

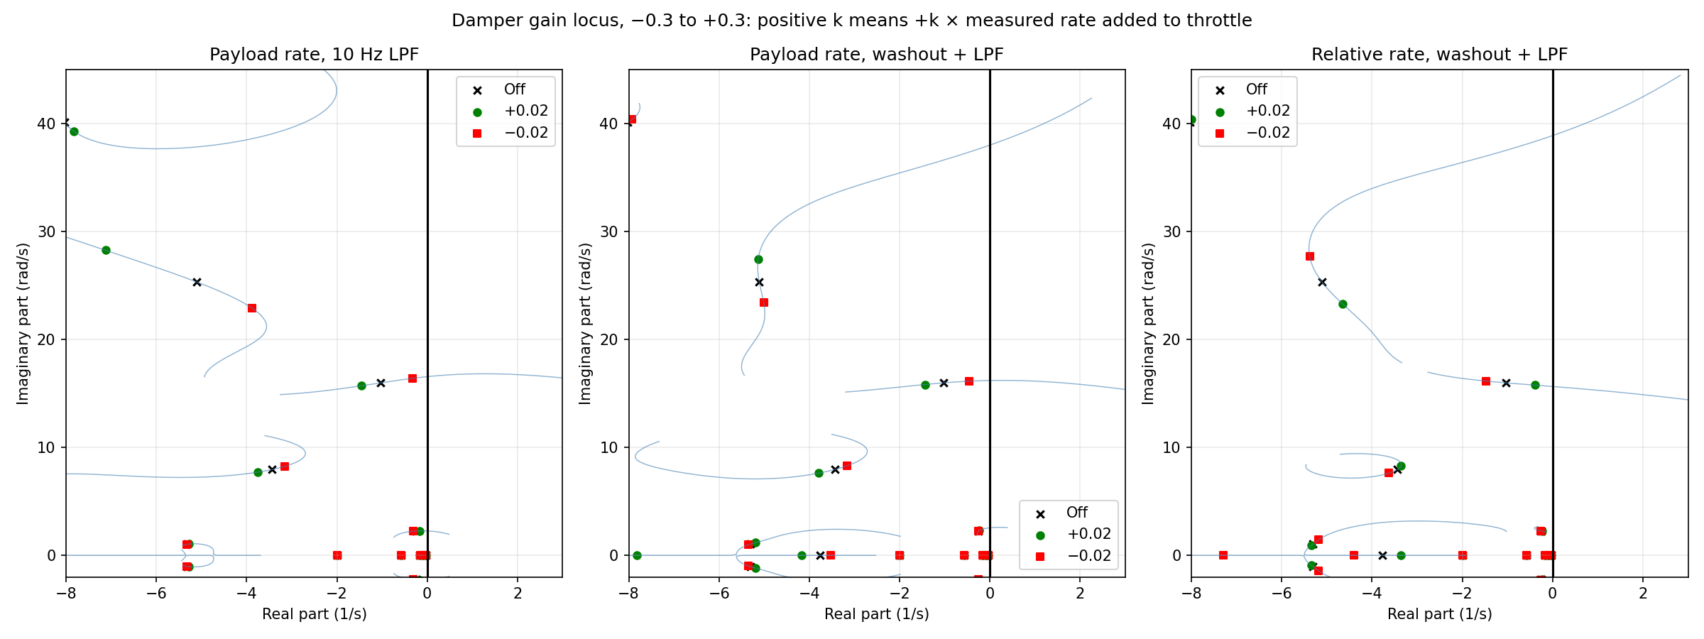
research/flight-log-analysis/figures/turn-model-spike/classical-longitudinal/damper-root-locus.png
