DavidIngraham/ArduPilot-tinkering/research/flight-log-analysis/figures/turn-model-spike/classical-longitudinal/gain-scan.png

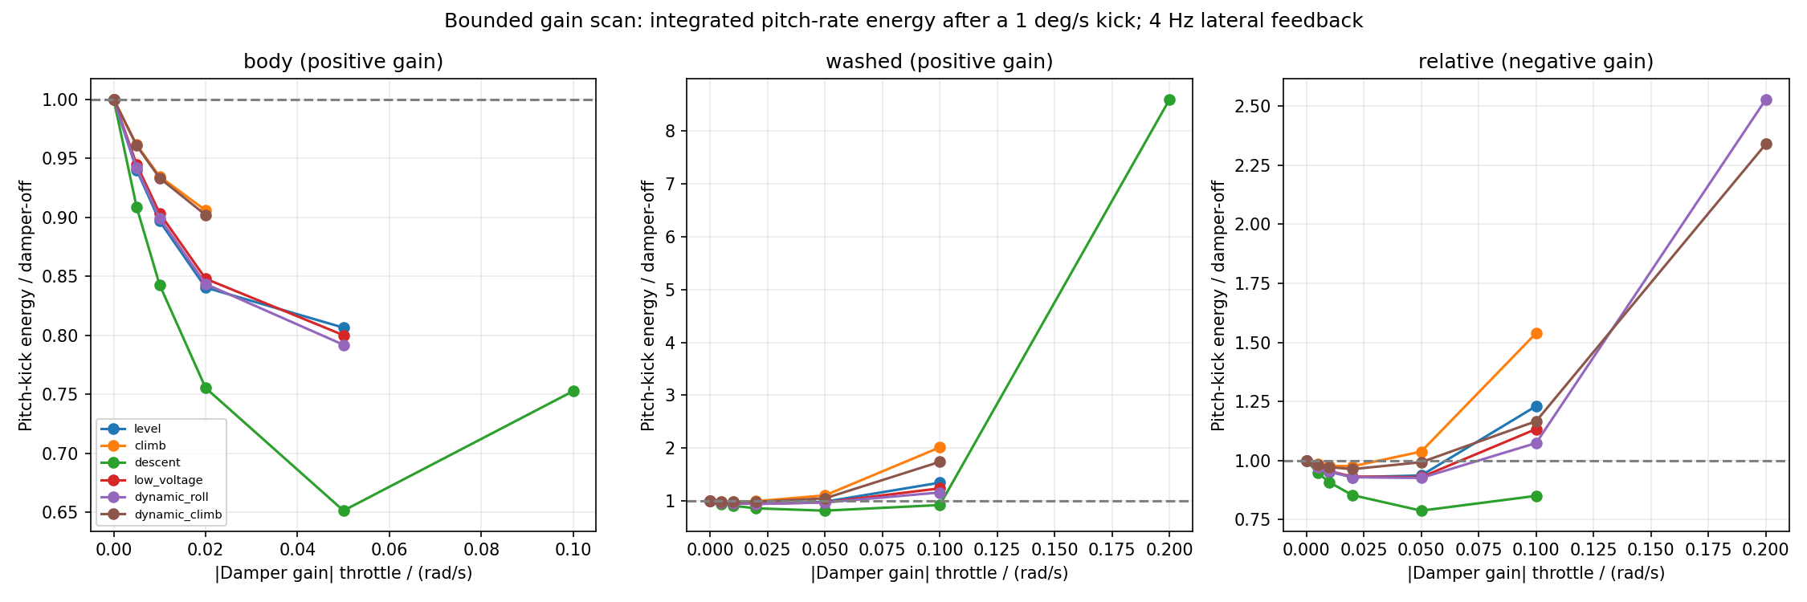
research/flight-log-analysis/figures/turn-model-spike/classical-longitudinal/gain-scan.png
