DavidIngraham/ArduPilot-tinkering/research/flight-log-analysis/figures/turn-model-spike/classical-longitudinal/nonlinear-dampers.png

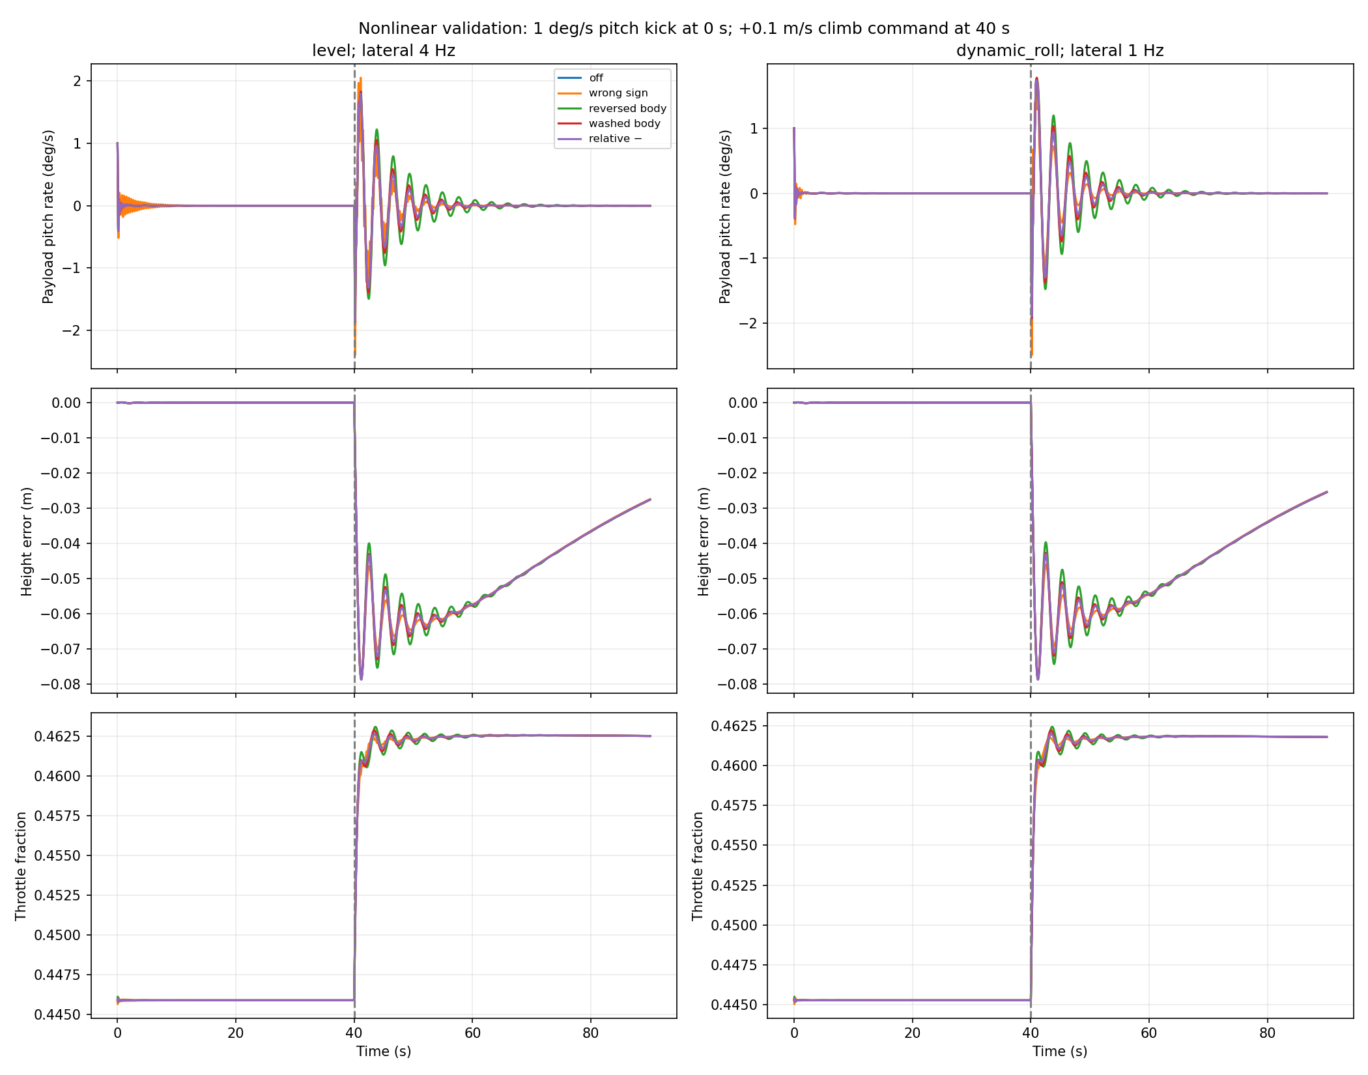
research/flight-log-analysis/figures/turn-model-spike/classical-longitudinal/nonlinear-dampers.png
