DavidIngraham/ArduPilot-tinkering/research/flight-log-analysis/figures/turn-model-spike/classical-longitudinal/nonlinear-summary.png

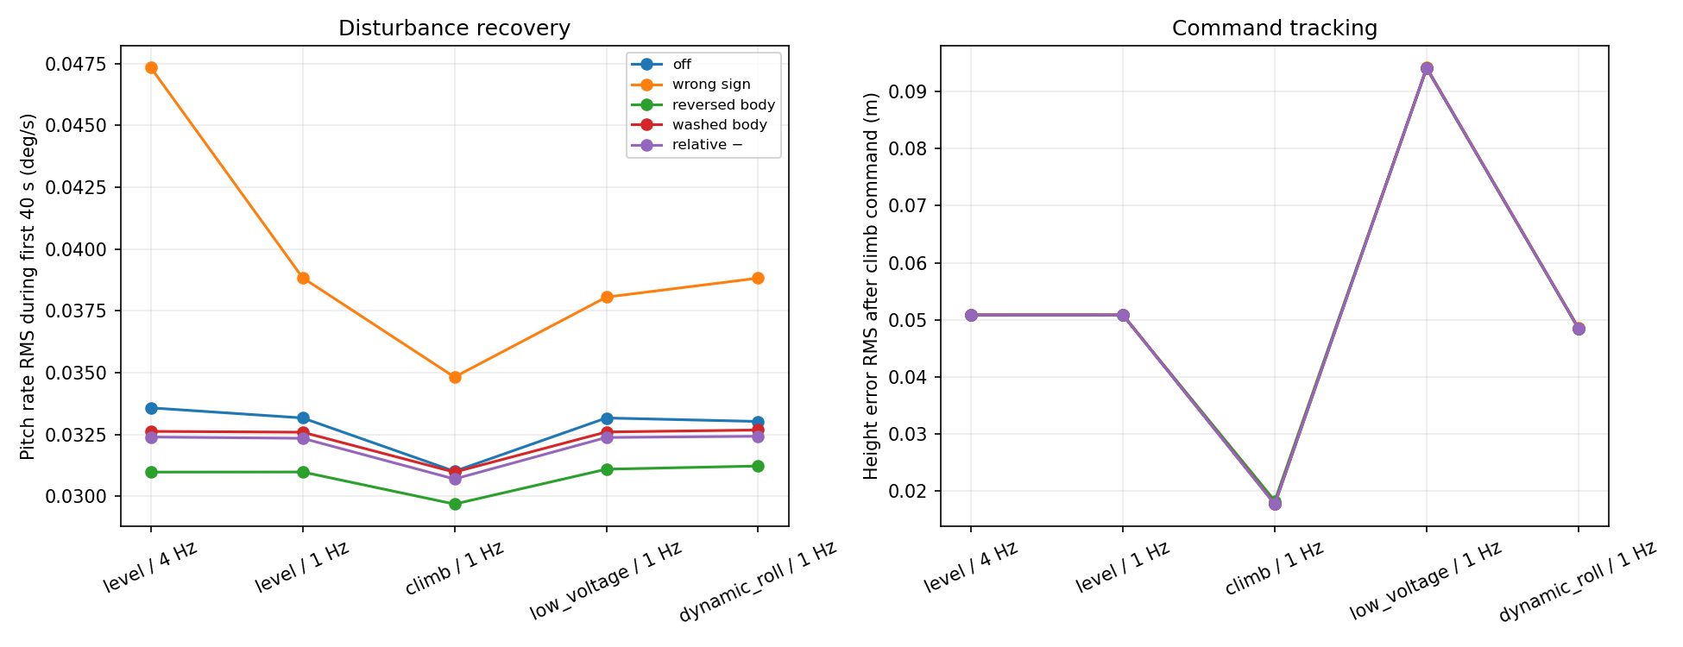
research/flight-log-analysis/figures/turn-model-spike/classical-longitudinal/nonlinear-summary.png
