DavidIngraham/ArduPilot-tinkering/research/flight-log-analysis/figures/turn-model-spike/classical-longitudinal/plant-bode.png

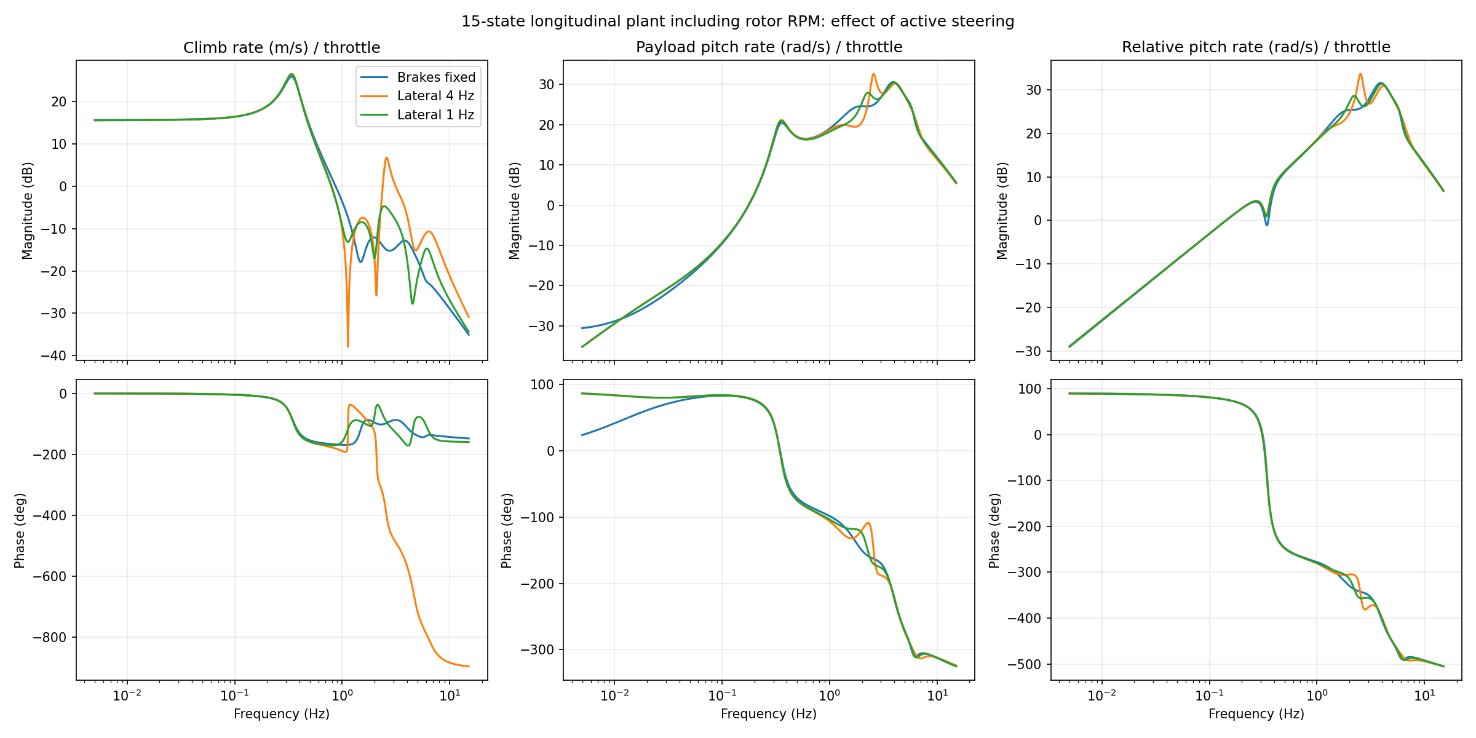
research/flight-log-analysis/figures/turn-model-spike/classical-longitudinal/plant-bode.png
