DavidIngraham/ArduPilot-tinkering/research/flight-log-analysis/figures/turn-model-spike/classical-longitudinal/slow-pitch-poles.png

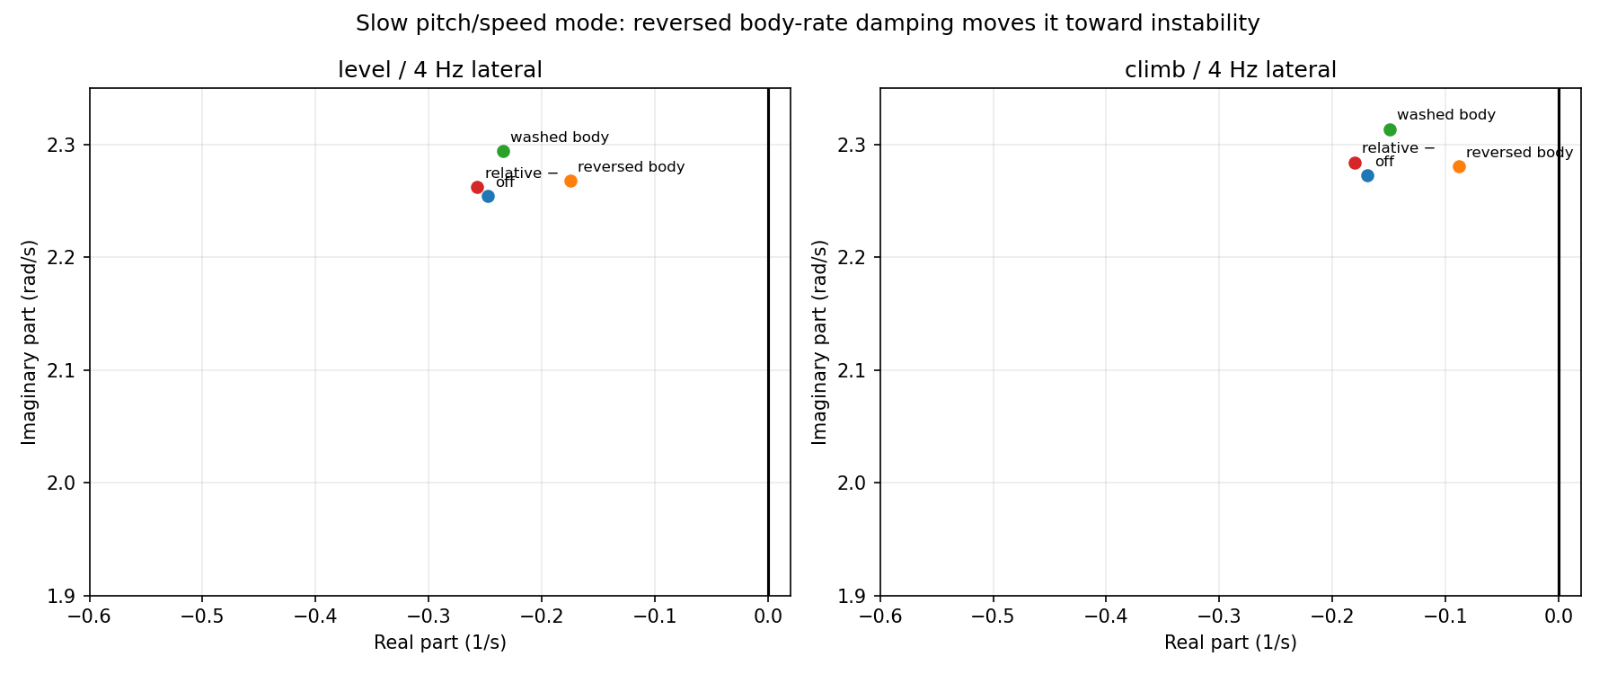
research/flight-log-analysis/figures/turn-model-spike/classical-longitudinal/slow-pitch-poles.png
