DavidIngraham/ArduPilot-tinkering/scratch/paraglider-tests/achievable-radius/mission-radius-comparison.png

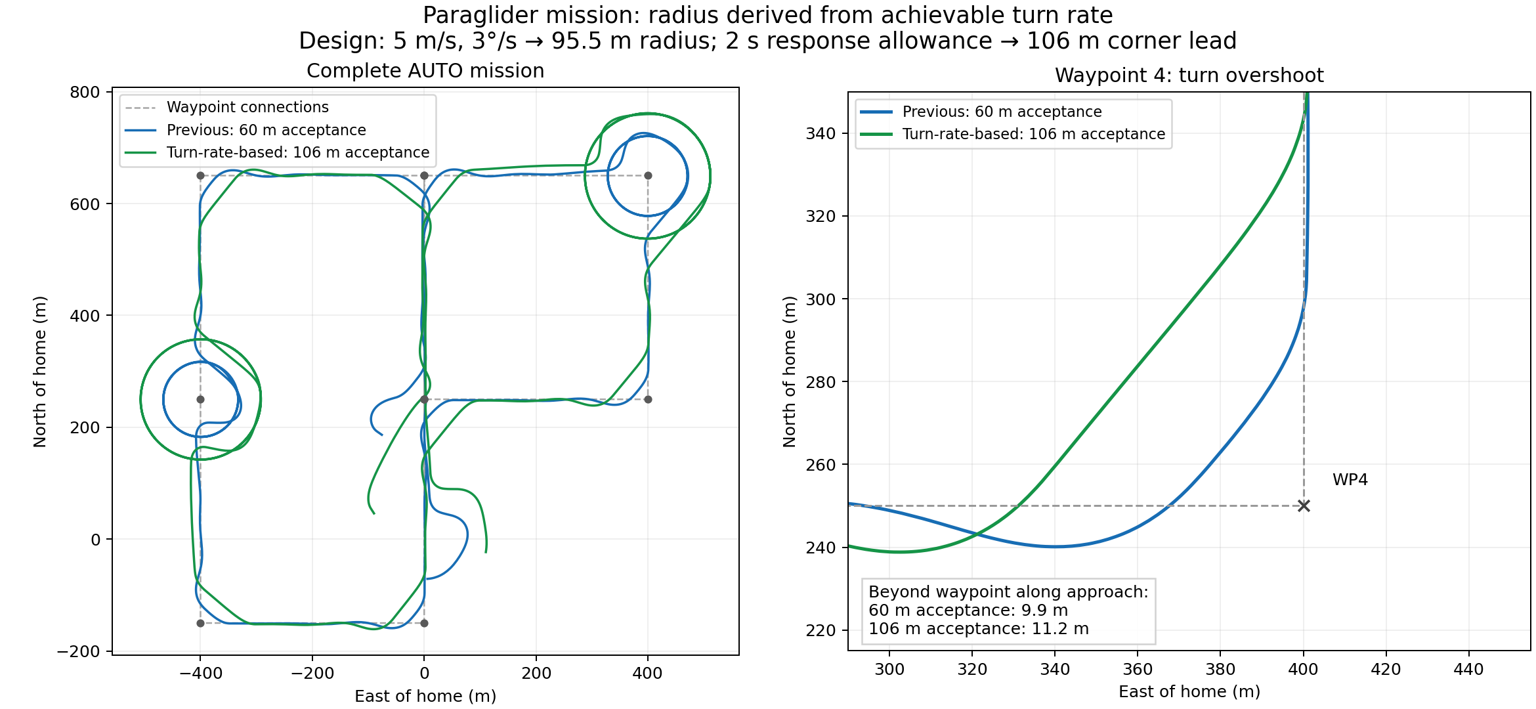
scratch/paraglider-tests/achievable-radius/mission-radius-comparison.png
