DavidIngraham/ArduPilot-tinkering/scratch/paraglider-tests/damping-prop/yaw-experiments.png

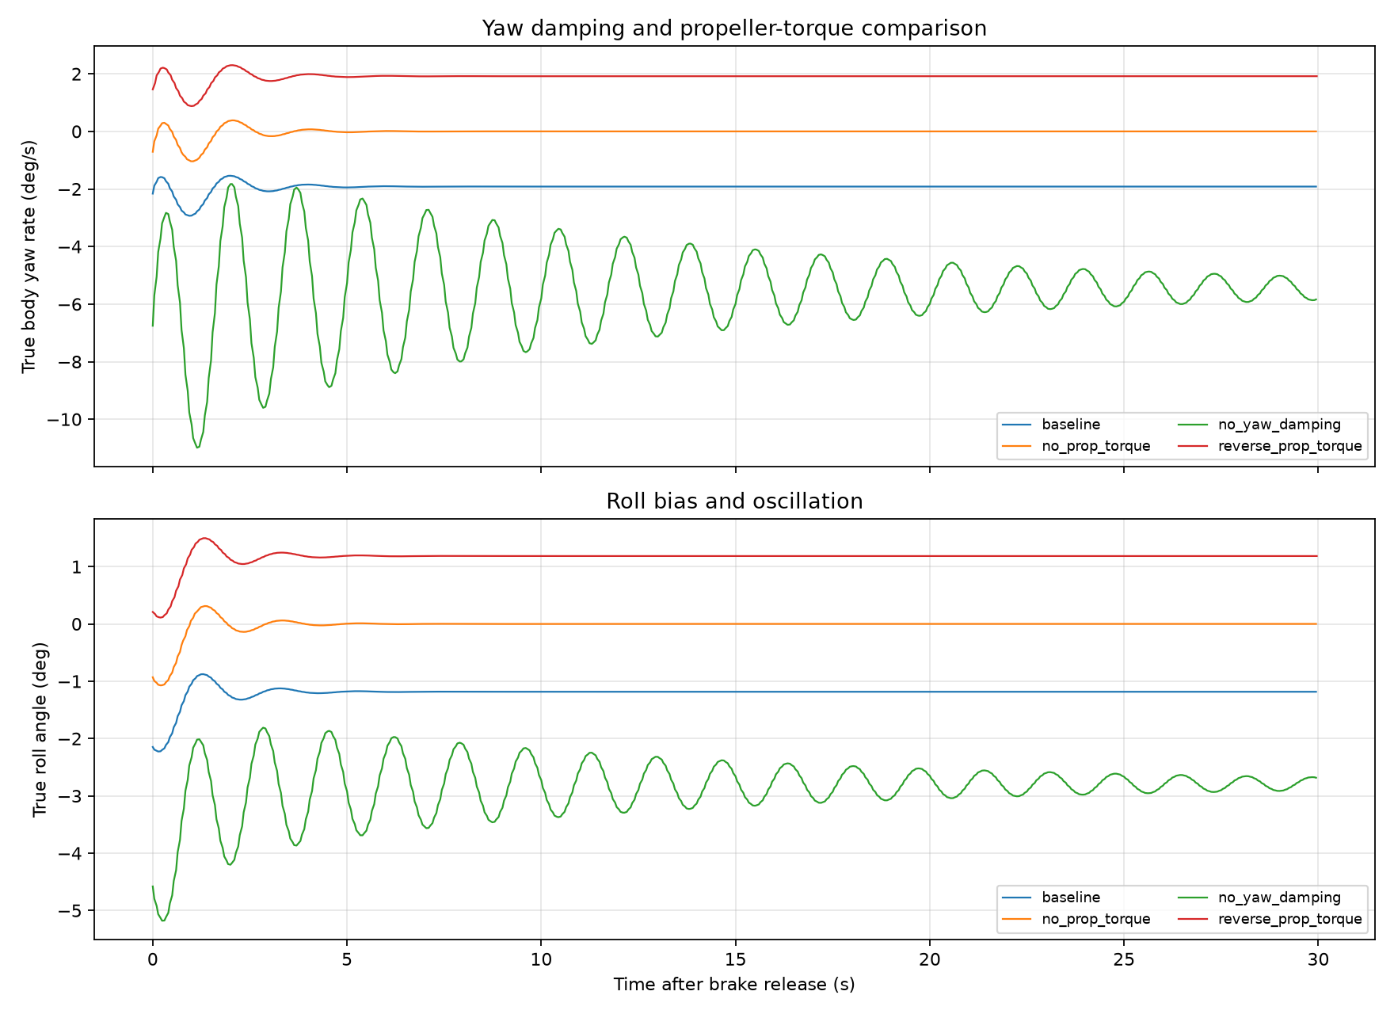
scratch/paraglider-tests/damping-prop/yaw-experiments.png
