DavidIngraham/ArduPilot-tinkering/scratch/paraglider-tests/dynamics.png

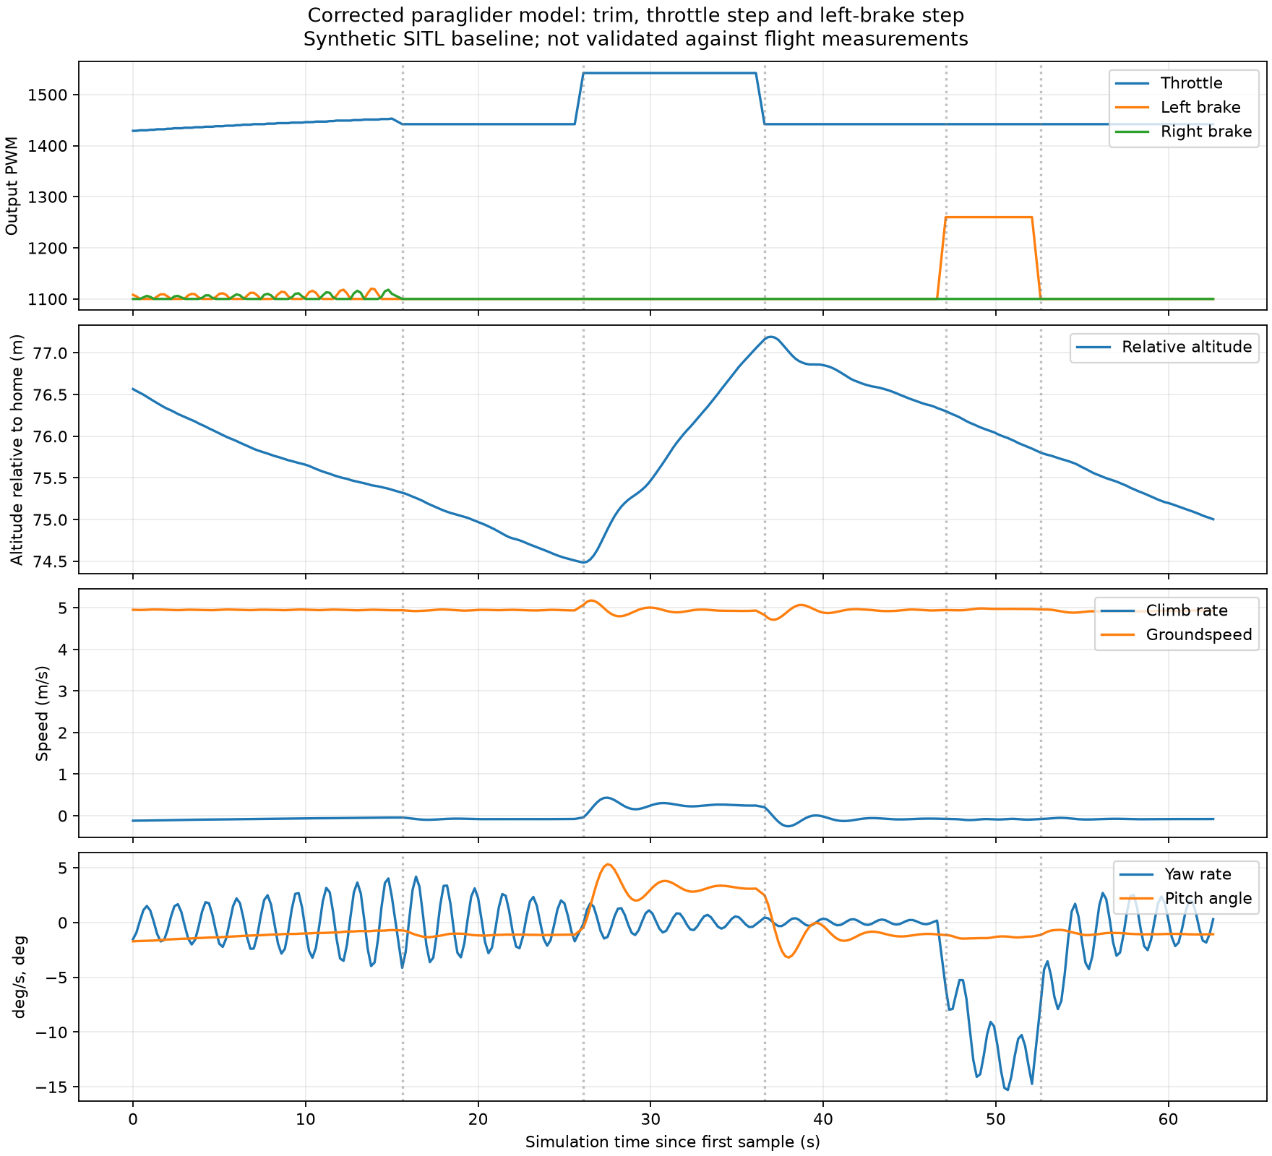
scratch/paraglider-tests/dynamics.png
