DavidIngraham/ArduPilot-tinkering/scratch/paraglider-tests/extended-mission-radius40/mission.png

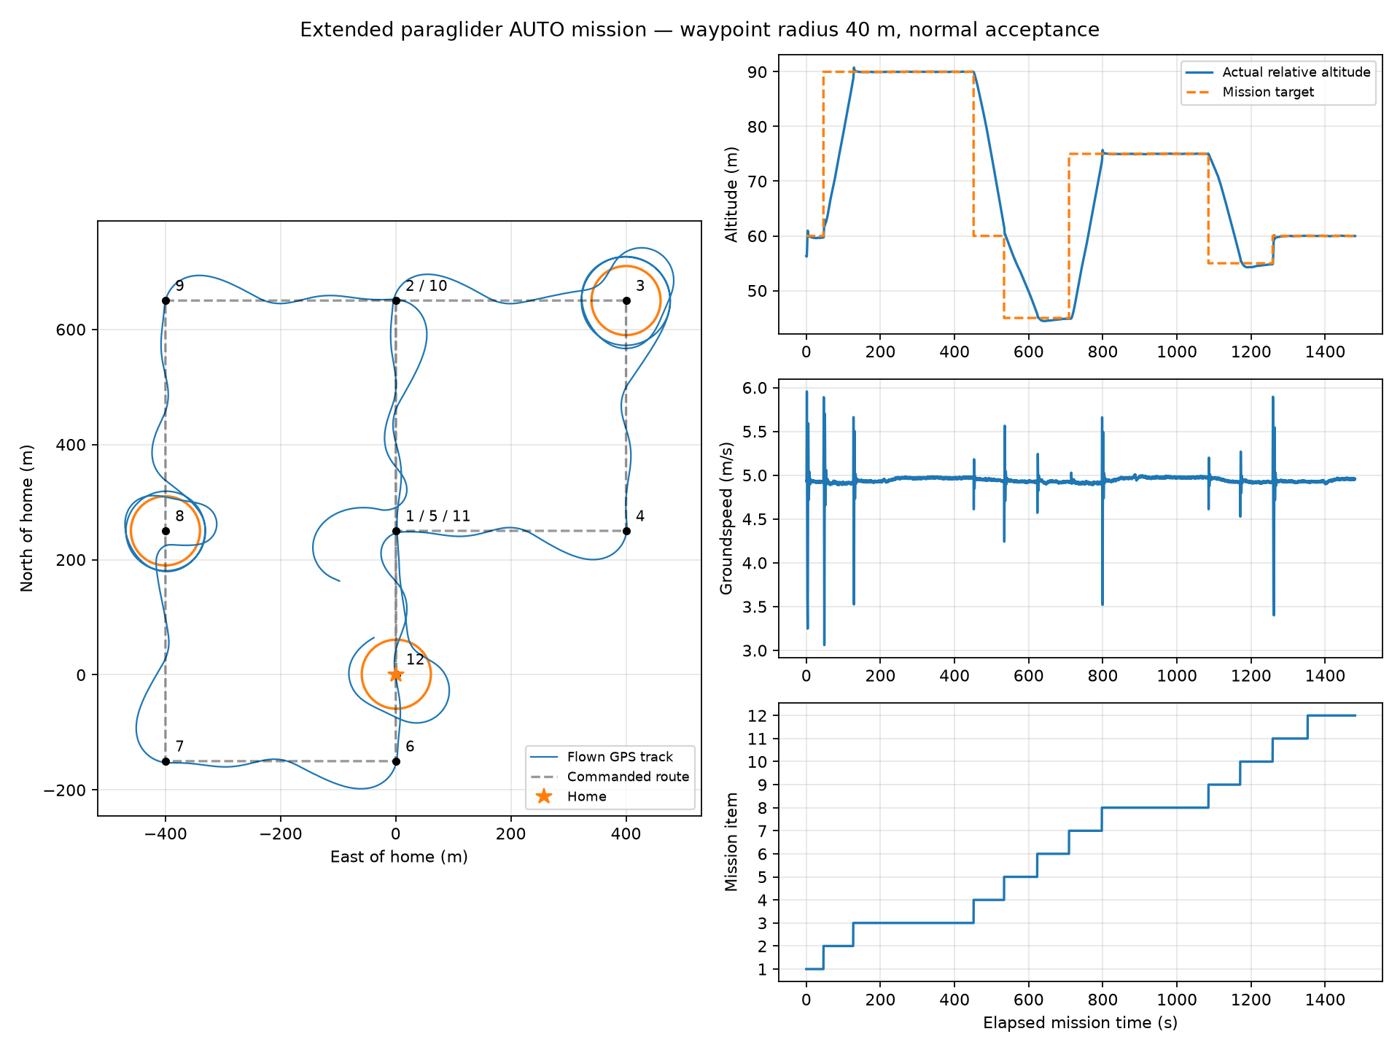
scratch/paraglider-tests/extended-mission-radius40/mission.png
