DavidIngraham/ArduPilot-tinkering/scratch/paraglider-tests/extended-mission/mission.png

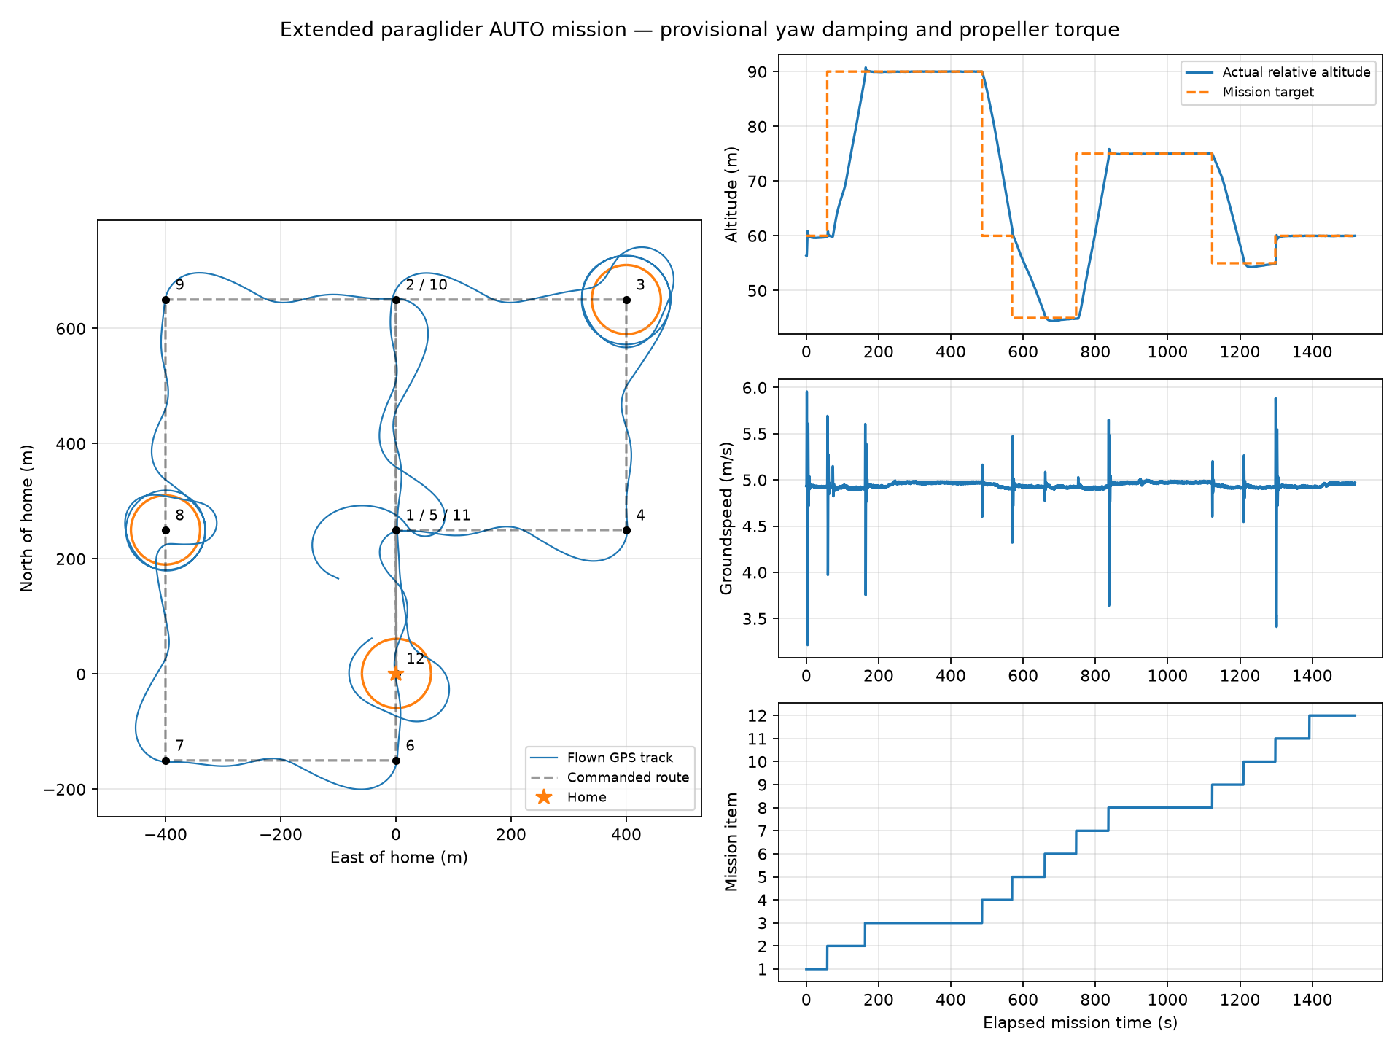
scratch/paraglider-tests/extended-mission/mission.png
