DavidIngraham/ArduPilot-tinkering/scratch/paraglider-tests/l1-damping085/comparison.png

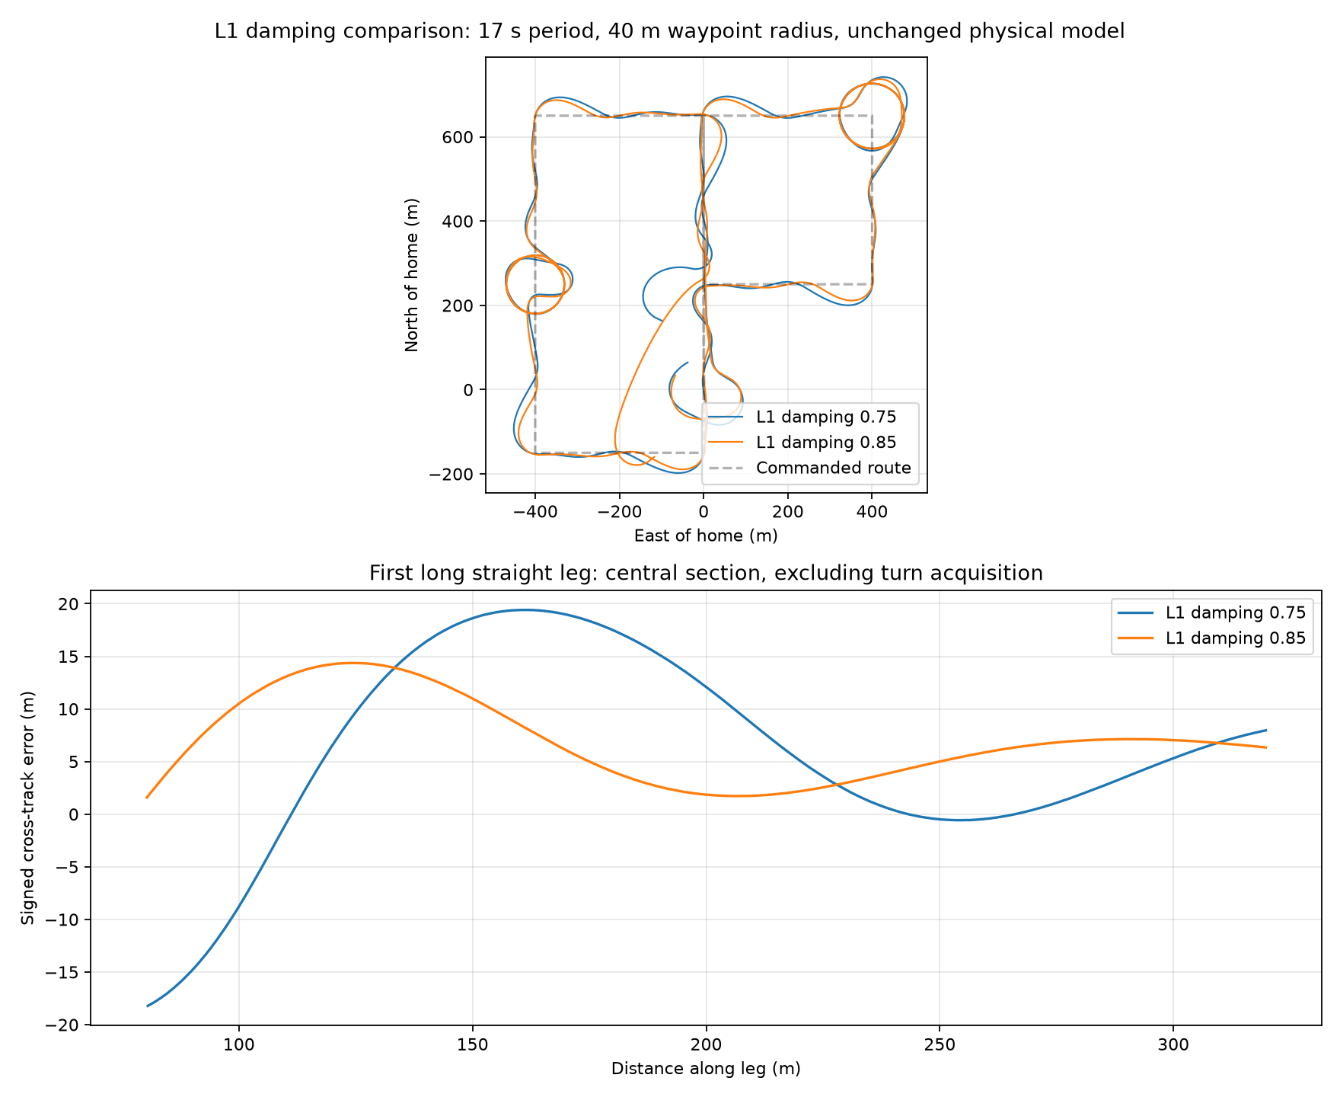
scratch/paraglider-tests/l1-damping085/comparison.png
