DavidIngraham/ArduPilot-tinkering/scratch/paraglider-tests/l1-quicktune/l1-search.png

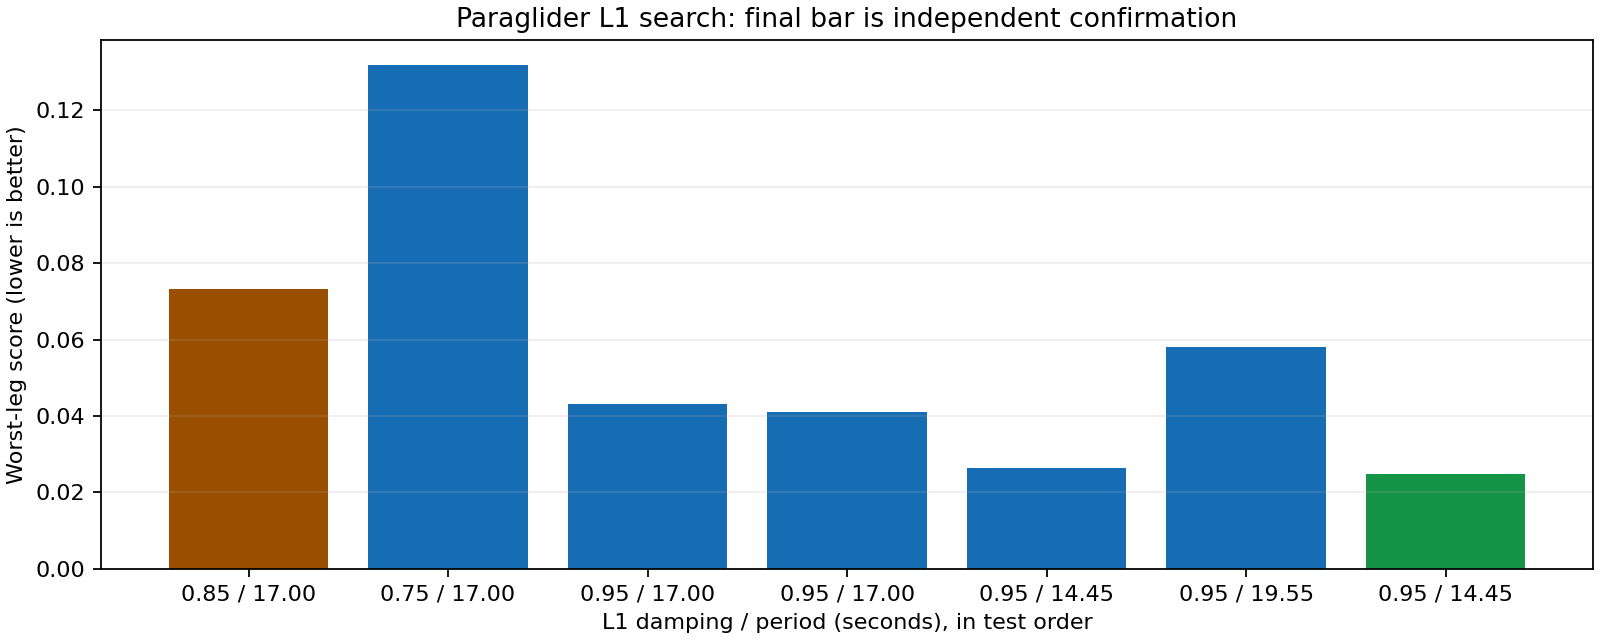
scratch/paraglider-tests/l1-quicktune/l1-search.png
