DavidIngraham/ArduPilot-tinkering/scratch/paraglider-tests/l1-quicktune/mission-comparison.png

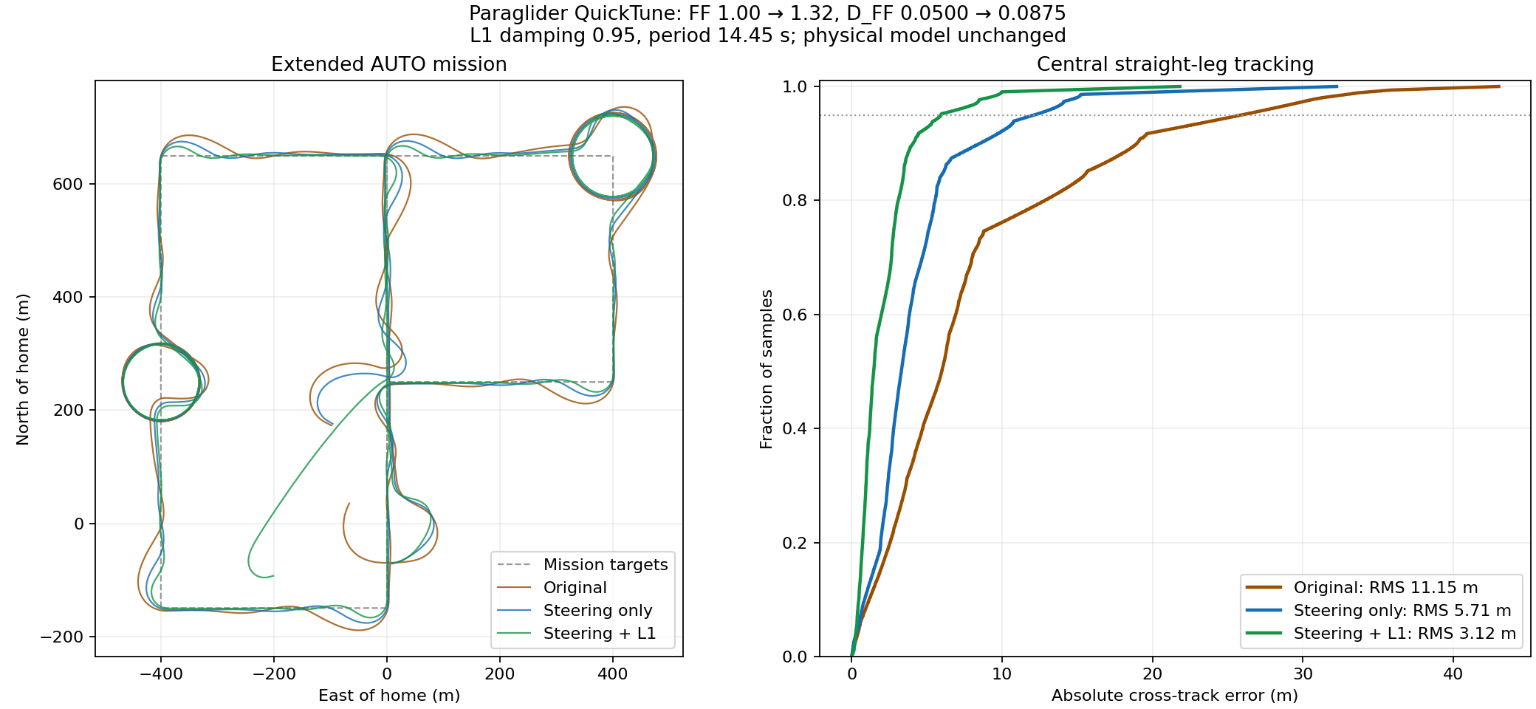
scratch/paraglider-tests/l1-quicktune/mission-comparison.png
