DavidIngraham/ArduPilot-tinkering/scratch/paraglider-tests/l1-quicktune/straight-leg-comparison.png

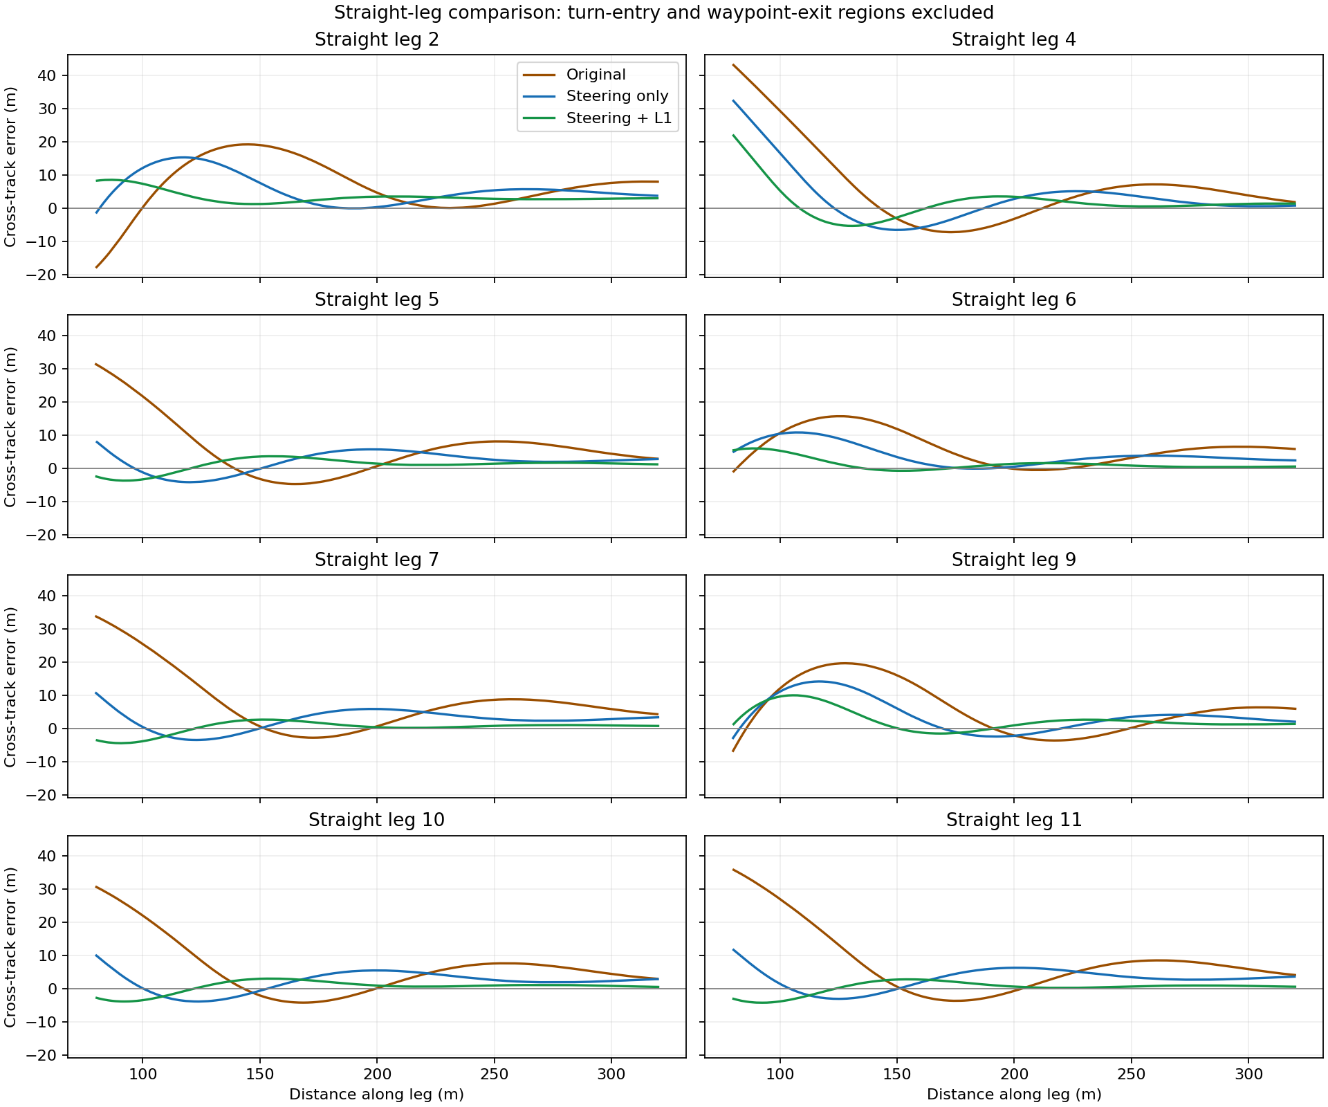
scratch/paraglider-tests/l1-quicktune/straight-leg-comparison.png
