DavidIngraham/ArduPilot-tinkering/scratch/paraglider-tests/pitch-joint/auto-regression/before-aero-sign/longitudinal-comparison.png

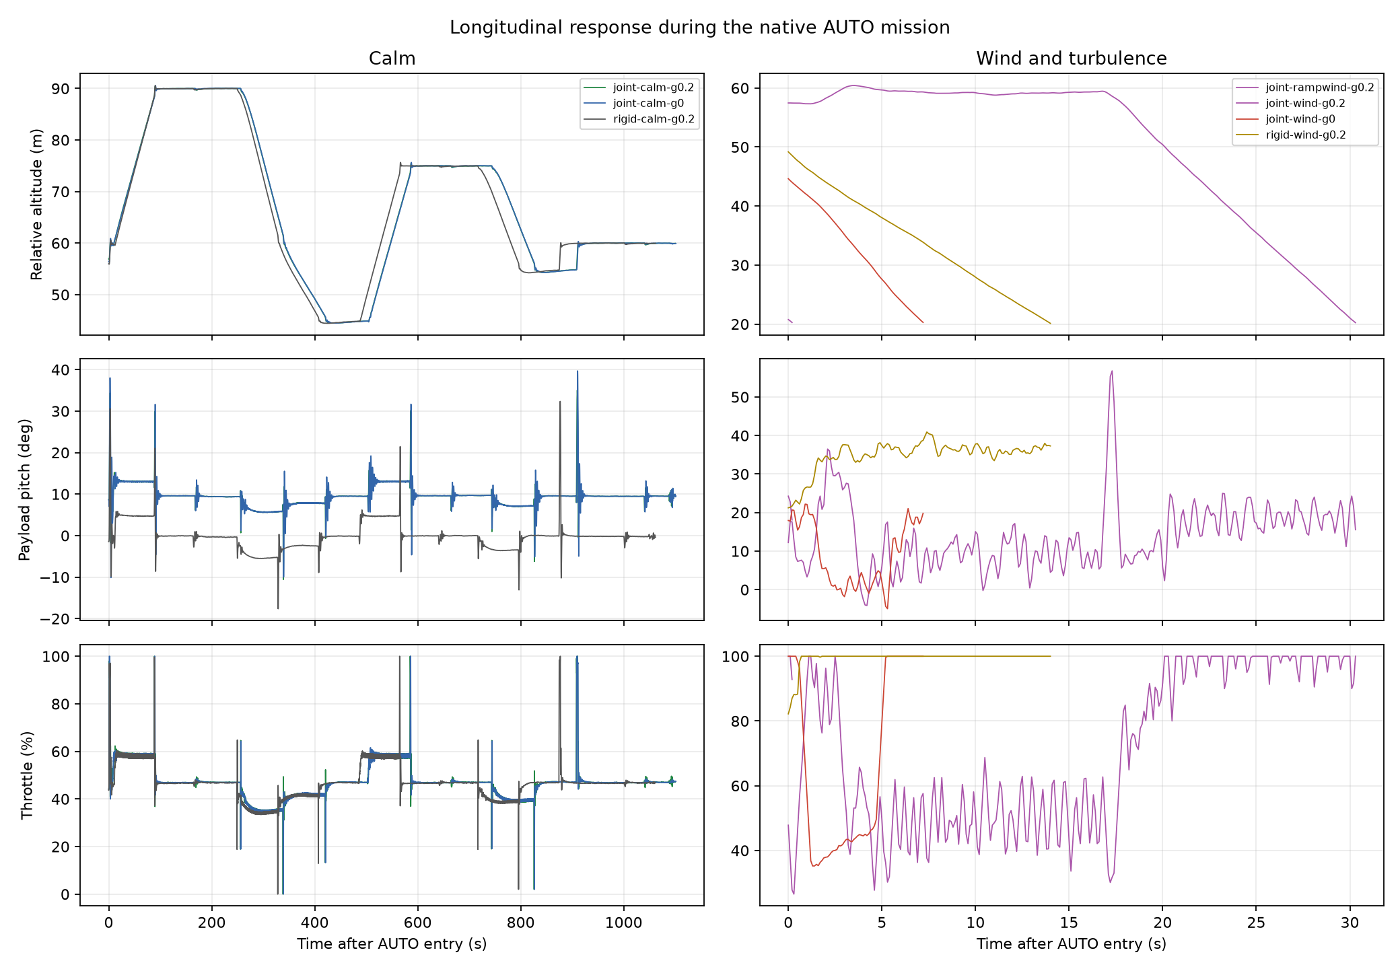
scratch/paraglider-tests/pitch-joint/auto-regression/before-aero-sign/longitudinal-comparison.png
