DavidIngraham/ArduPilot-tinkering/scratch/paraglider-tests/pitch-joint/damper-comparison.png

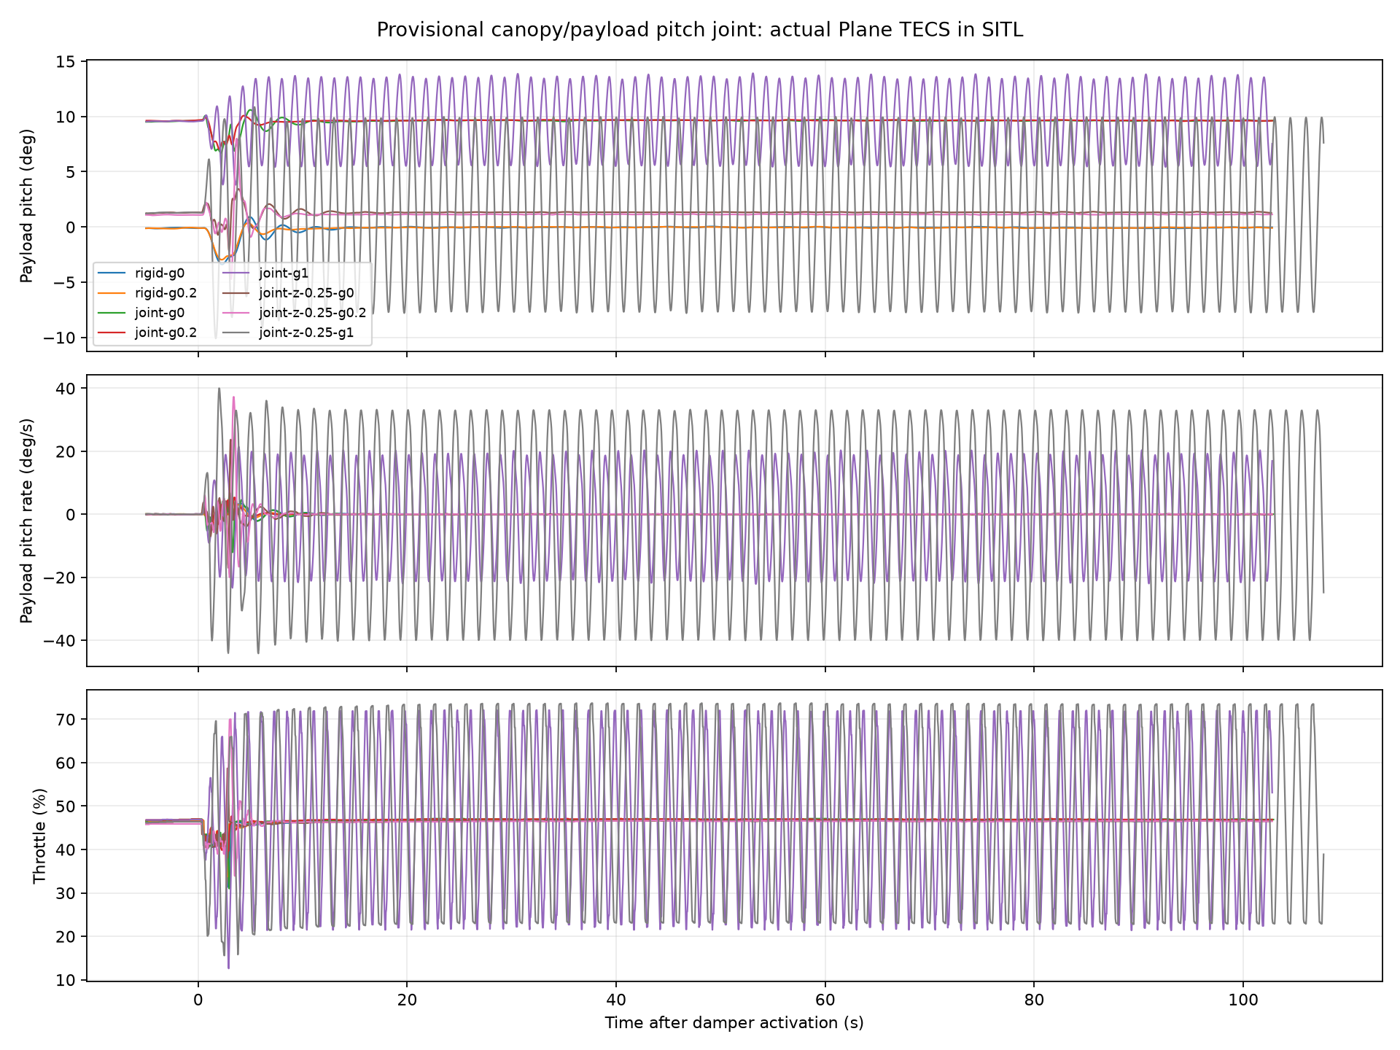
scratch/paraglider-tests/pitch-joint/damper-comparison.png
