DavidIngraham/ArduPilot-tinkering/scratch/paraglider-tests/pitch-joint/diagrams/cruise-free-body.png

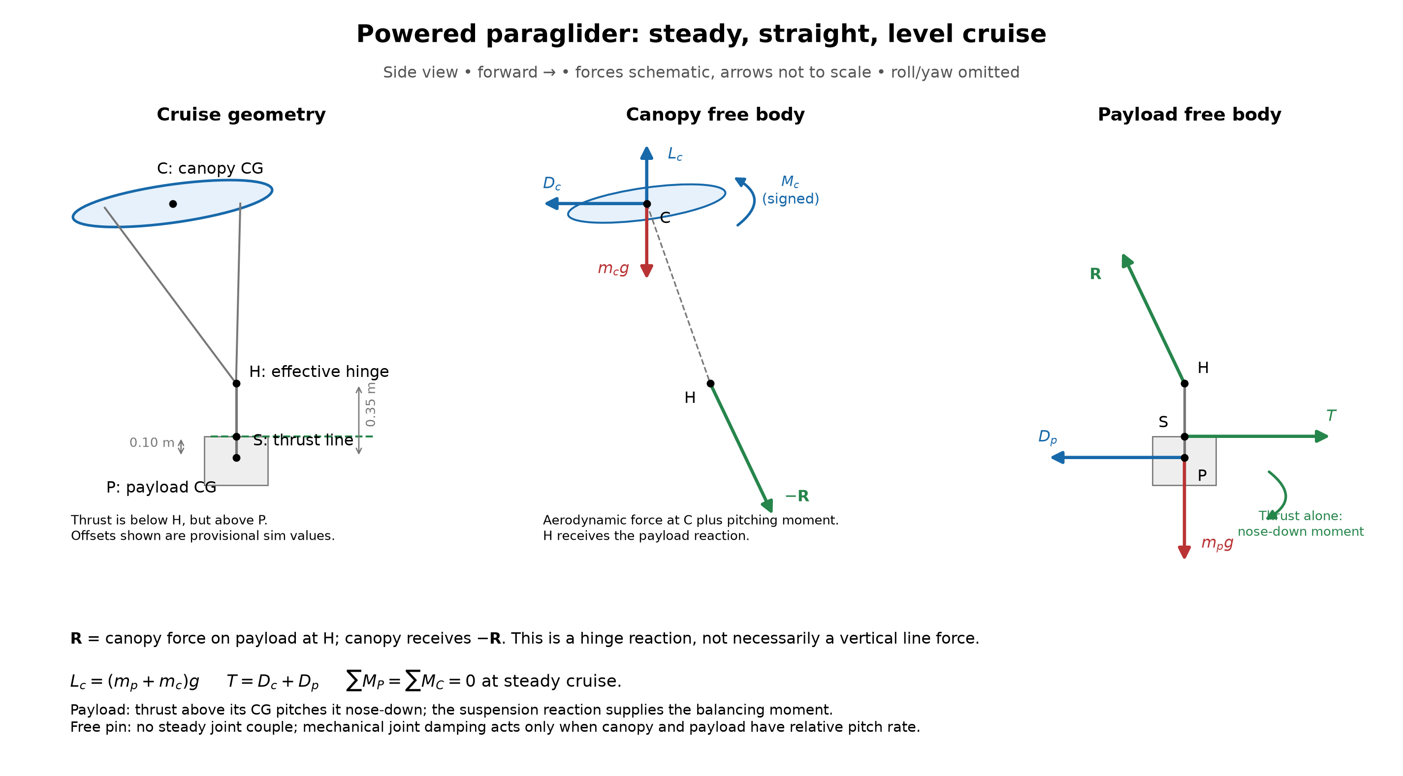
scratch/paraglider-tests/pitch-joint/diagrams/cruise-free-body.png
