DavidIngraham/ArduPilot-tinkering/scratch/paraglider-tests/pitch-joint/integrated-control/robustness-comparison.png

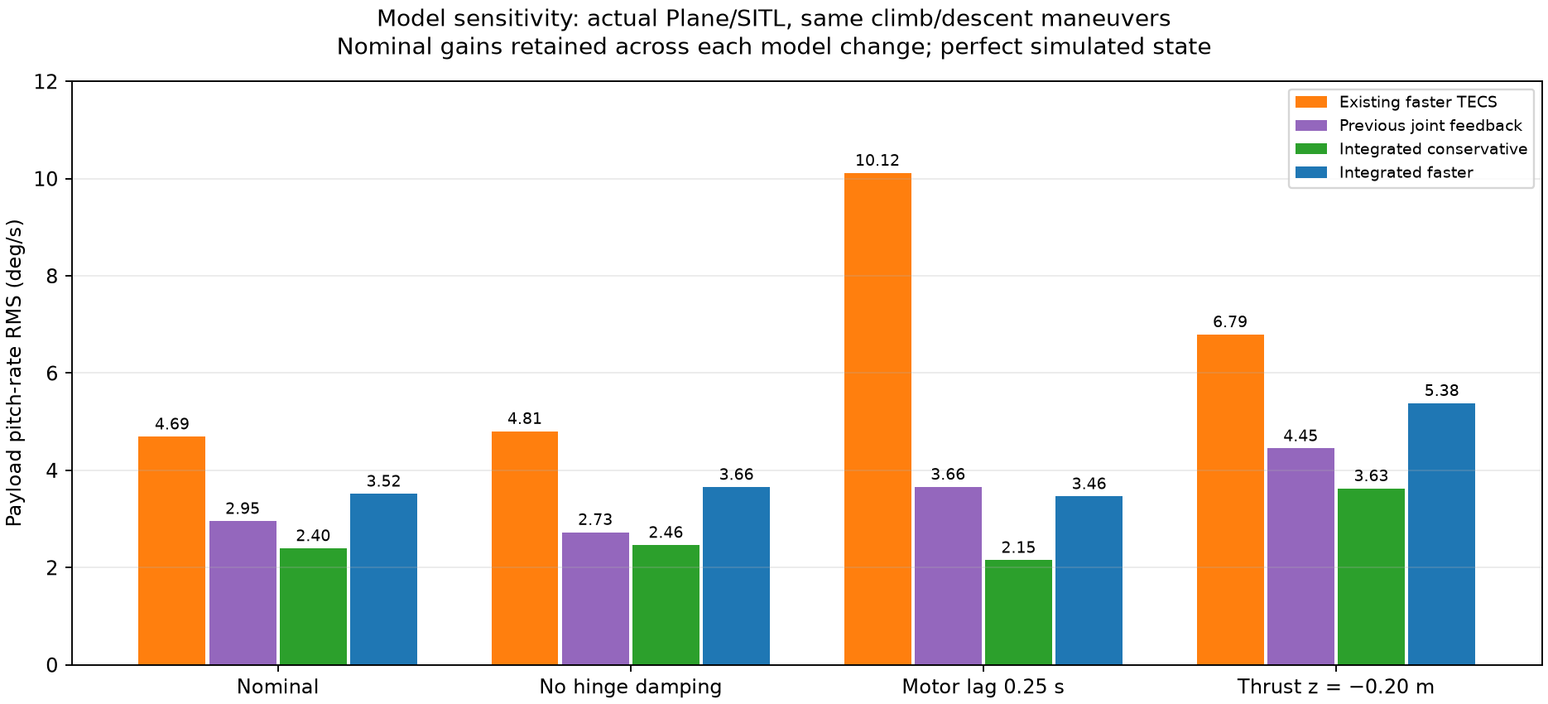
scratch/paraglider-tests/pitch-joint/integrated-control/robustness-comparison.png
