DavidIngraham/ArduPilot-tinkering/scratch/paraglider-tests/pitch-joint/matched-joint-comparison.png

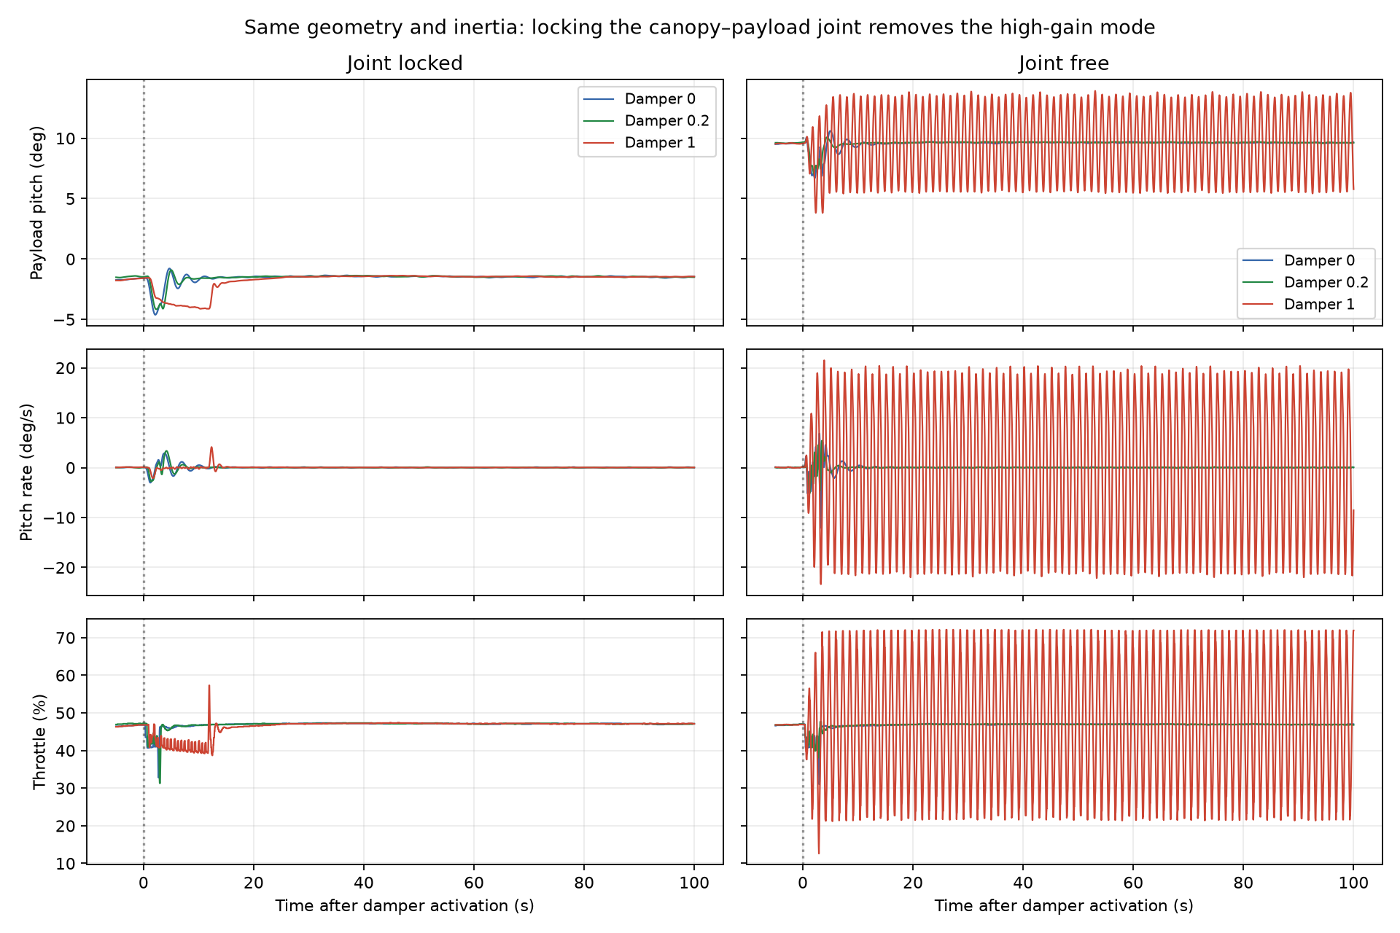
scratch/paraglider-tests/pitch-joint/matched-joint-comparison.png
