DavidIngraham/ArduPilot-tinkering/scratch/paraglider-tests/pitch-joint/oracle-control/damping-and-ablation.png

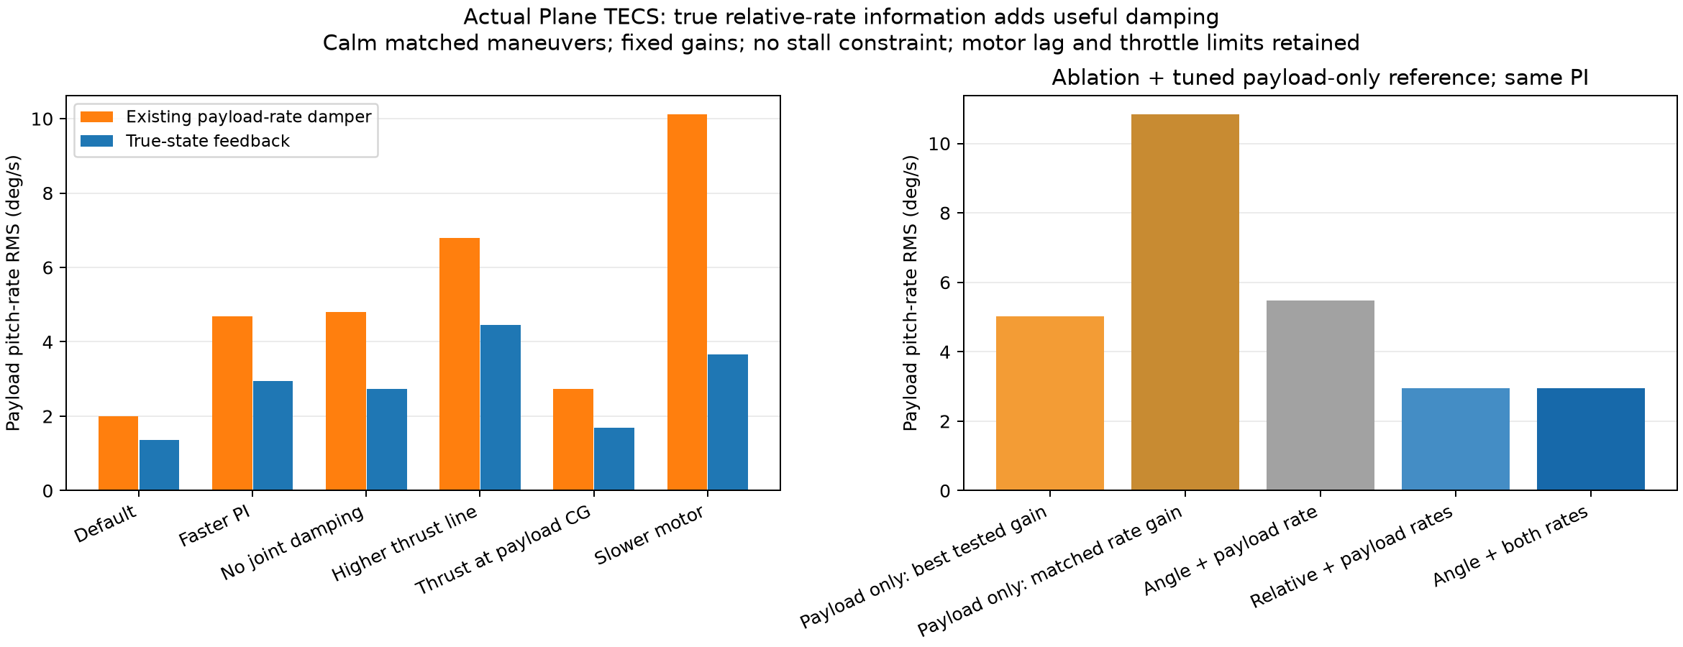
scratch/paraglider-tests/pitch-joint/oracle-control/damping-and-ablation.png
