DavidIngraham/ArduPilot-tinkering/scratch/paraglider-tests/pitch-joint/physics-review/actual-controller.png

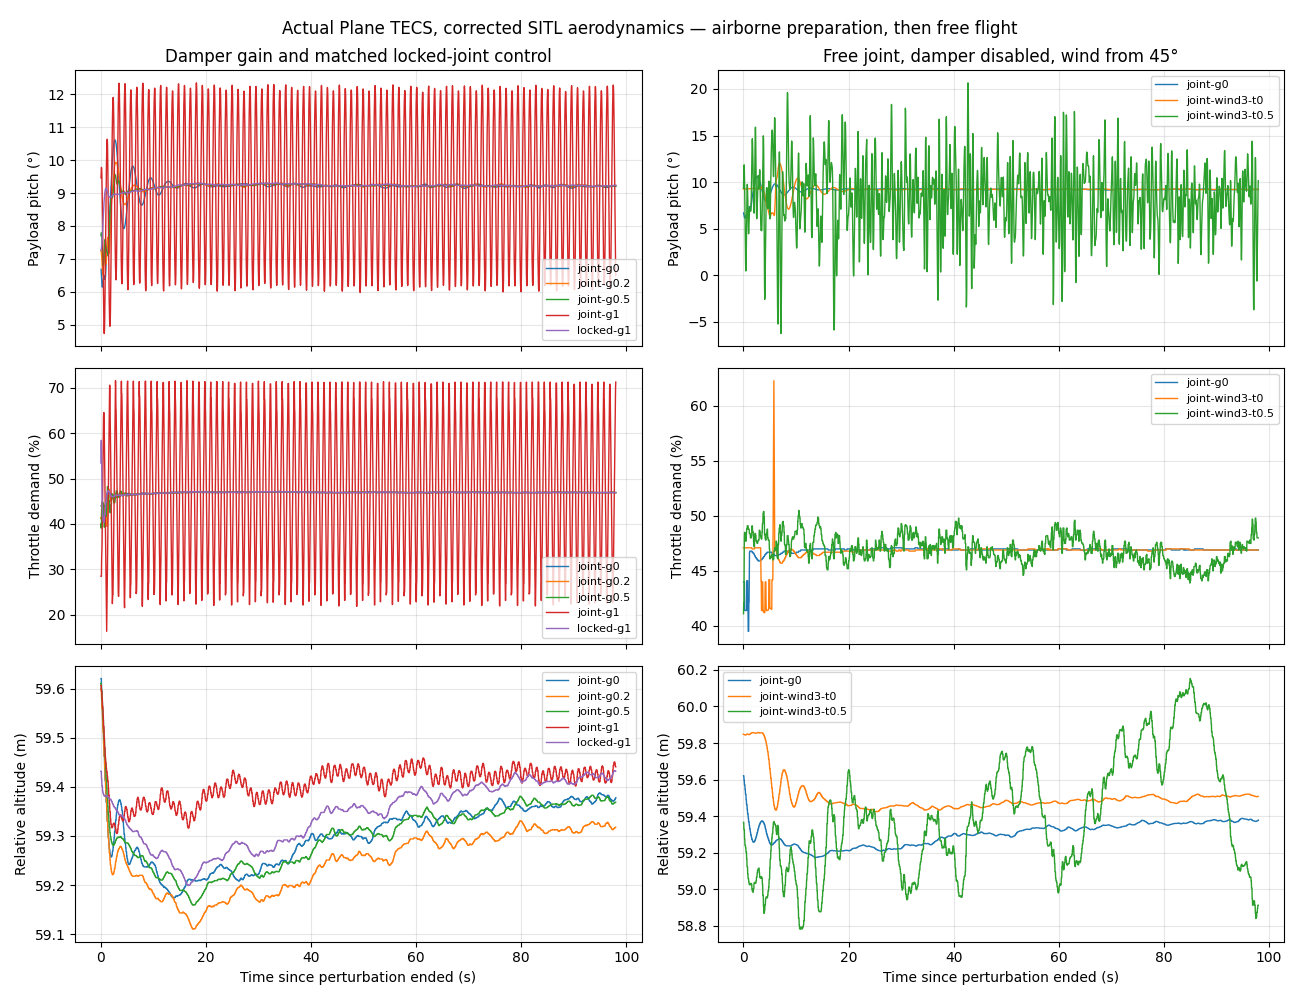
scratch/paraglider-tests/pitch-joint/physics-review/actual-controller.png
