DavidIngraham/ArduPilot-tinkering/scratch/paraglider-tests/pitch-joint/physics-review/longitudinal-comparison.png

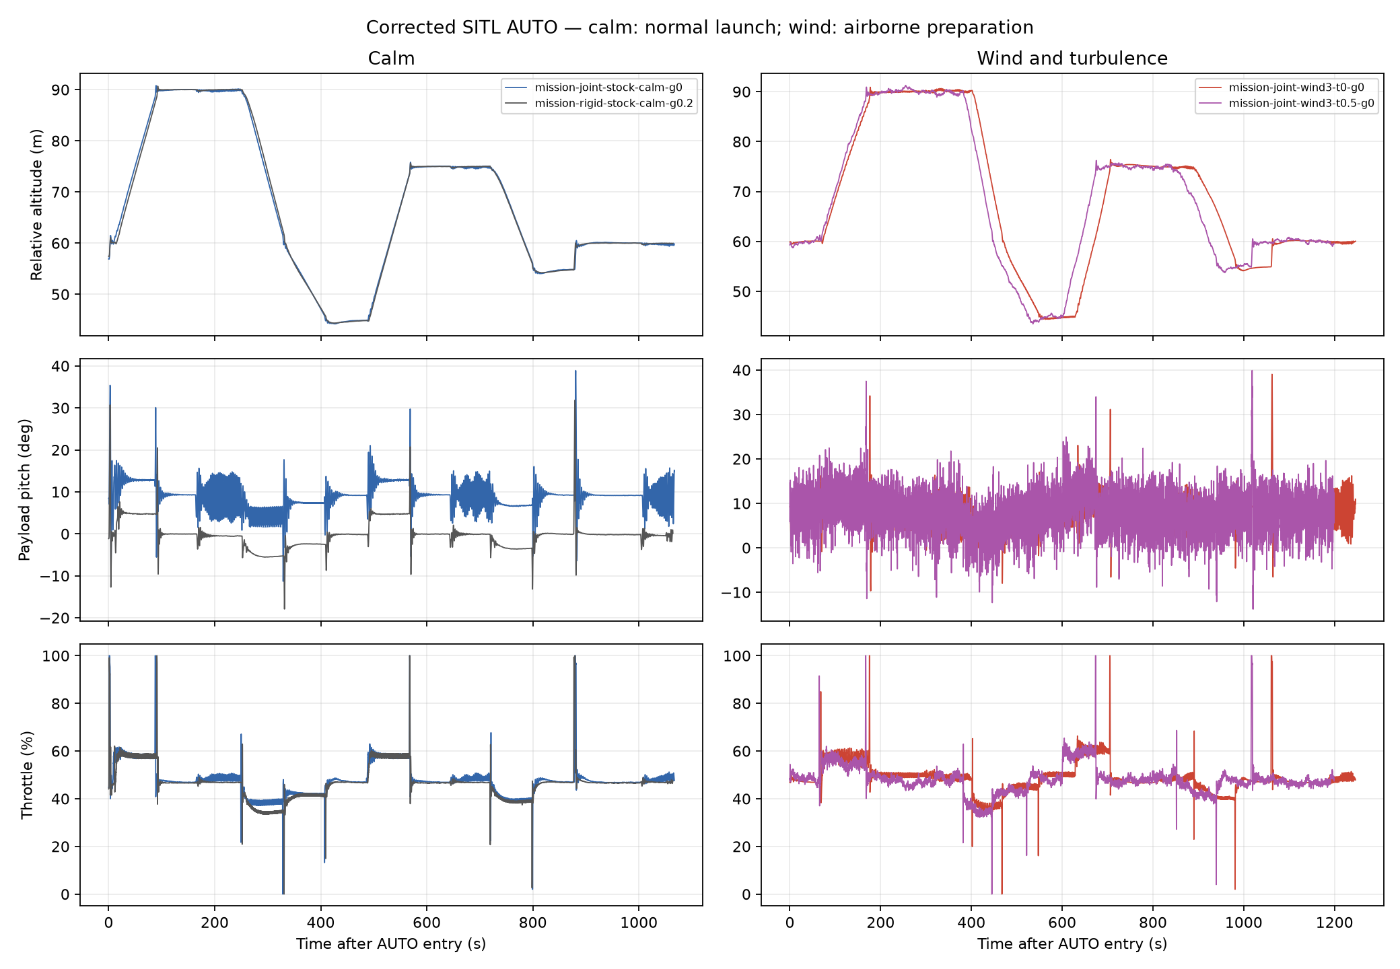
scratch/paraglider-tests/pitch-joint/physics-review/longitudinal-comparison.png
