DavidIngraham/ArduPilot-tinkering/scratch/paraglider-tests/pitch-joint/physics-review/mission-comparison.png

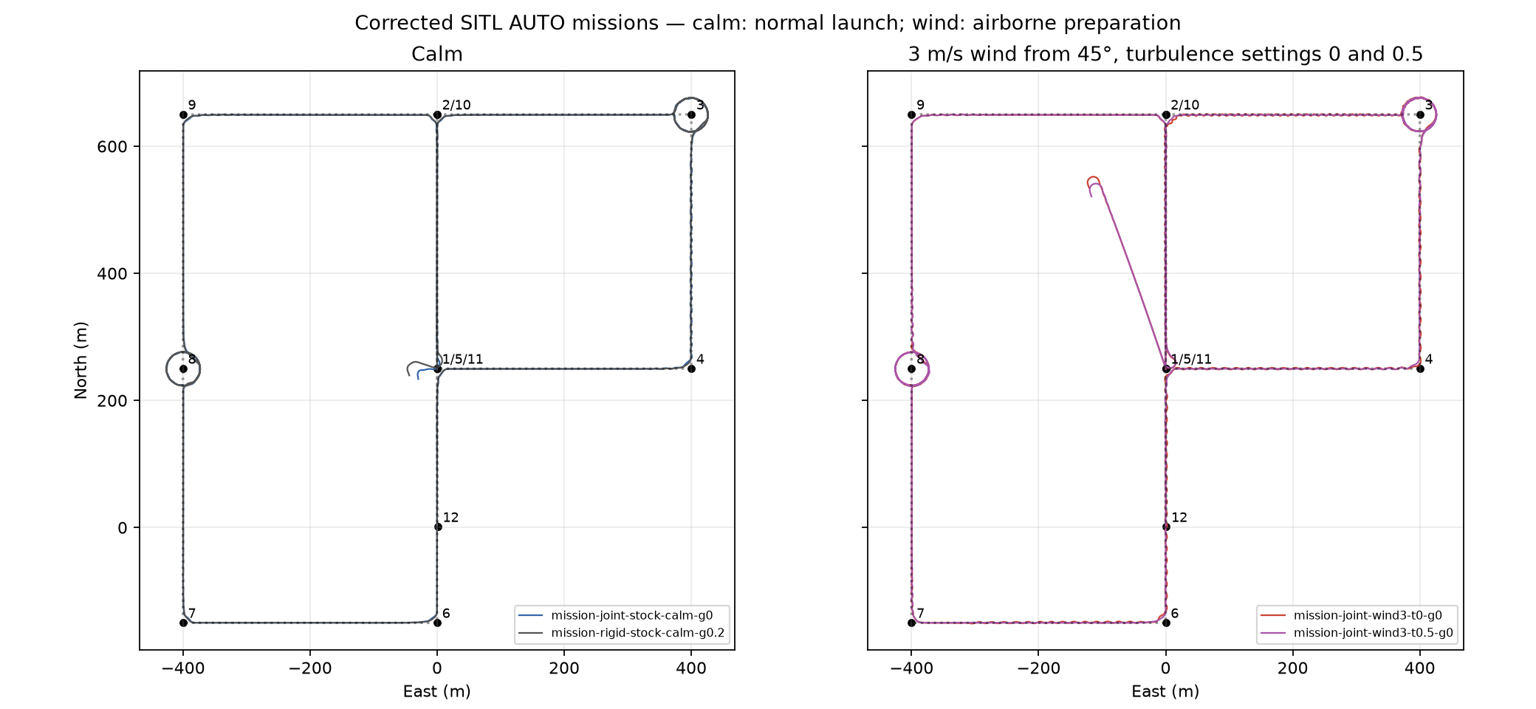
scratch/paraglider-tests/pitch-joint/physics-review/mission-comparison.png
