DavidIngraham/ArduPilot-tinkering/scratch/paraglider-tests/pitch-joint/physics-review/open-loop-response.png

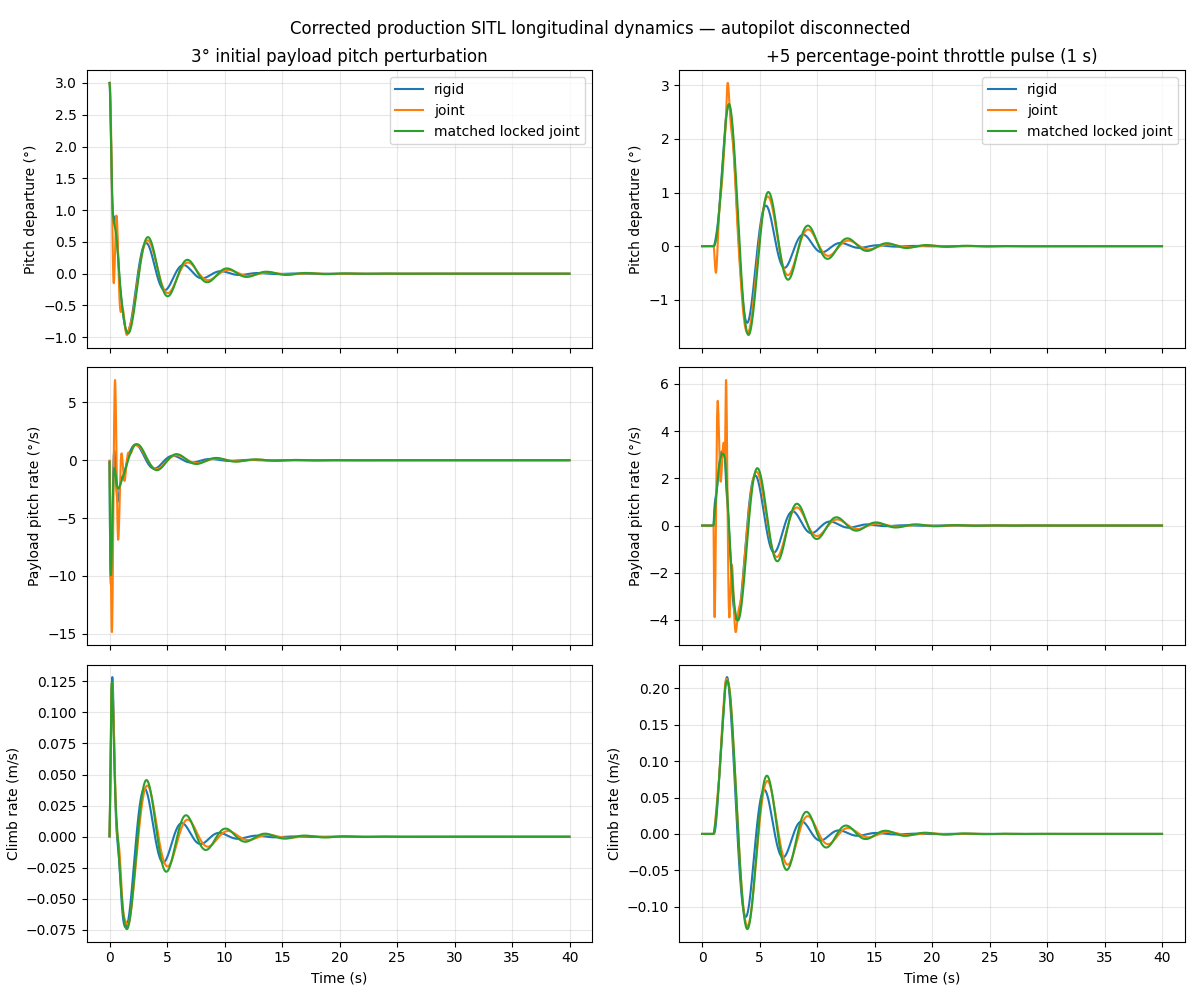
scratch/paraglider-tests/pitch-joint/physics-review/open-loop-response.png
