DavidIngraham/ArduPilot-tinkering/scratch/paraglider-tests/pitch-joint/swing-launch/launch-feasibility.png

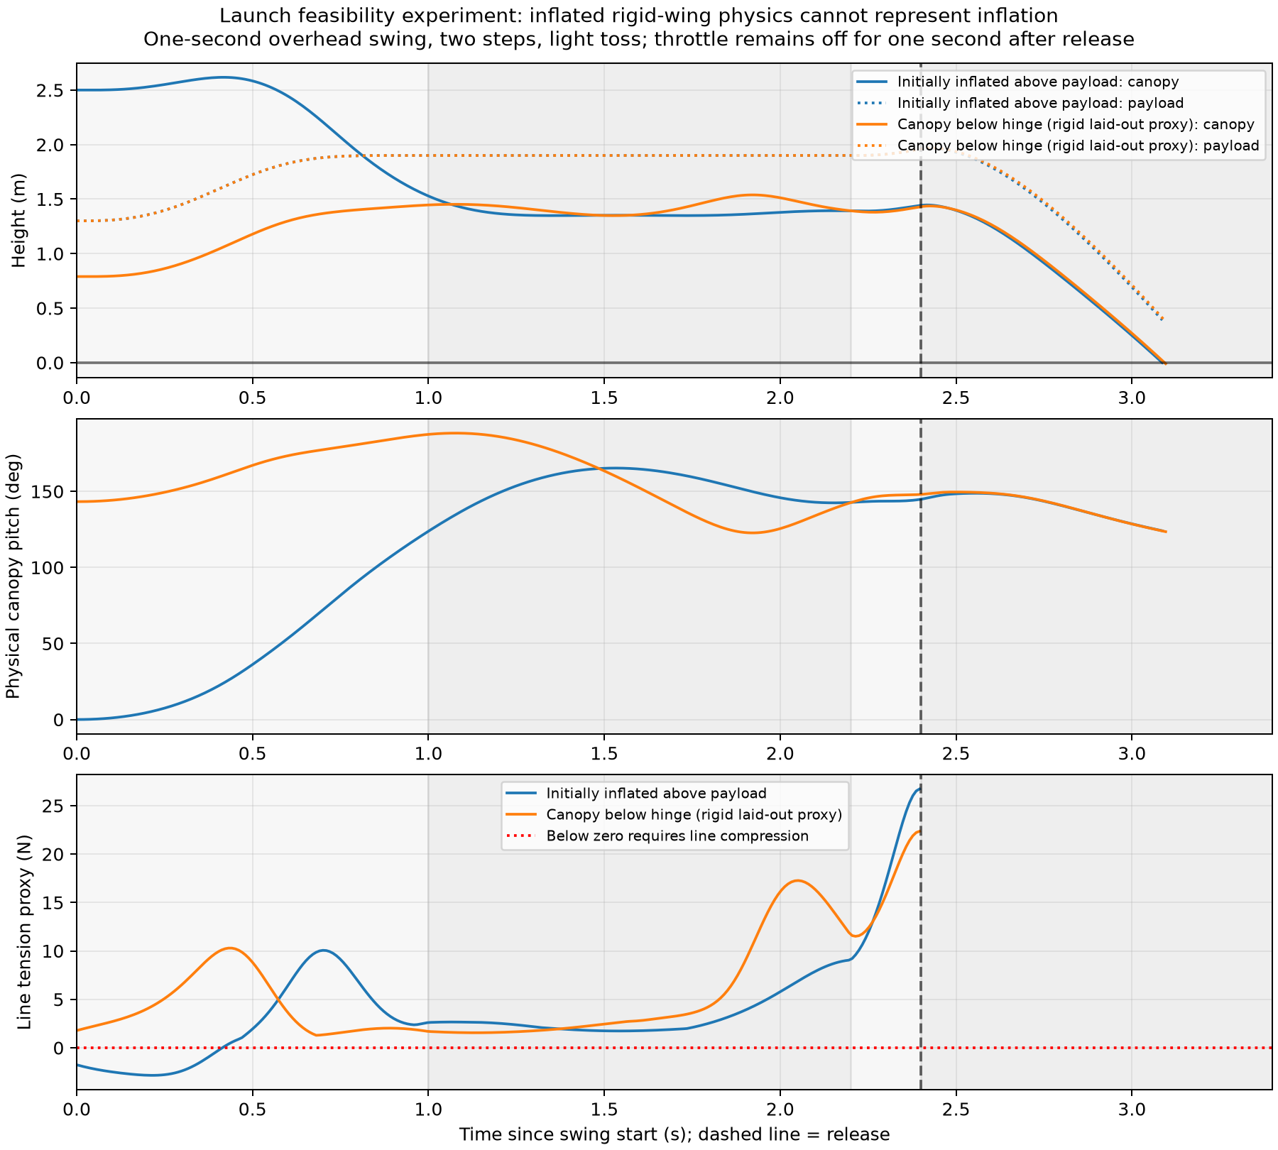
scratch/paraglider-tests/pitch-joint/swing-launch/launch-feasibility.png
