DavidIngraham/ArduPilot-tinkering/scratch/paraglider-tests/quicktune/mission-comparison.png

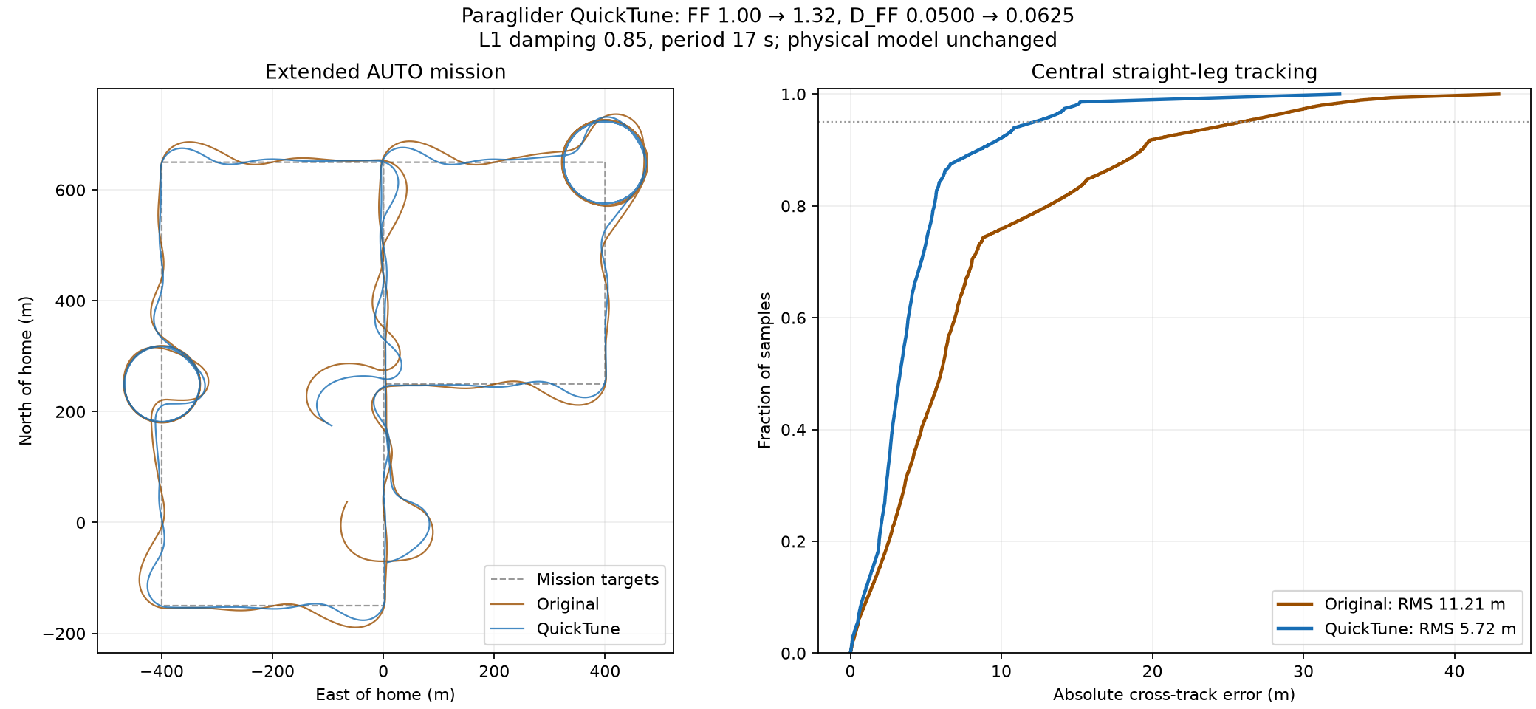
scratch/paraglider-tests/quicktune/mission-comparison.png
