DavidIngraham/ArduPilot-tinkering/scratch/paraglider-tests/quicktune/straight-leg-comparison.png

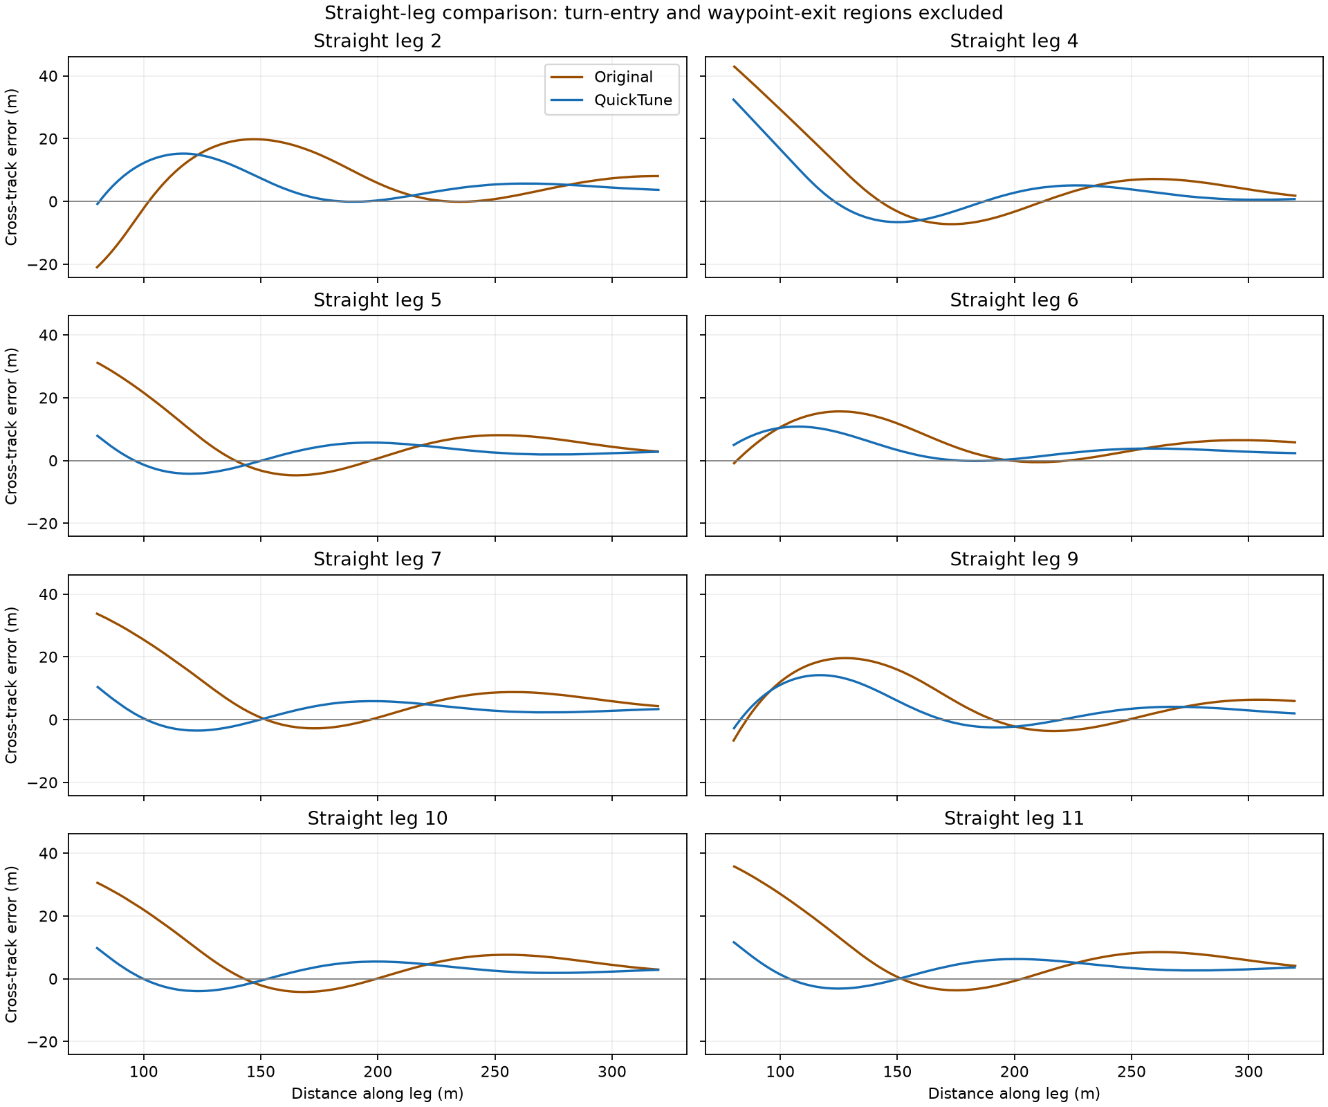
scratch/paraglider-tests/quicktune/straight-leg-comparison.png
