DavidIngraham/ArduPilot-tinkering/scratch/paraglider-tests/radius60/mission-radius-comparison.png

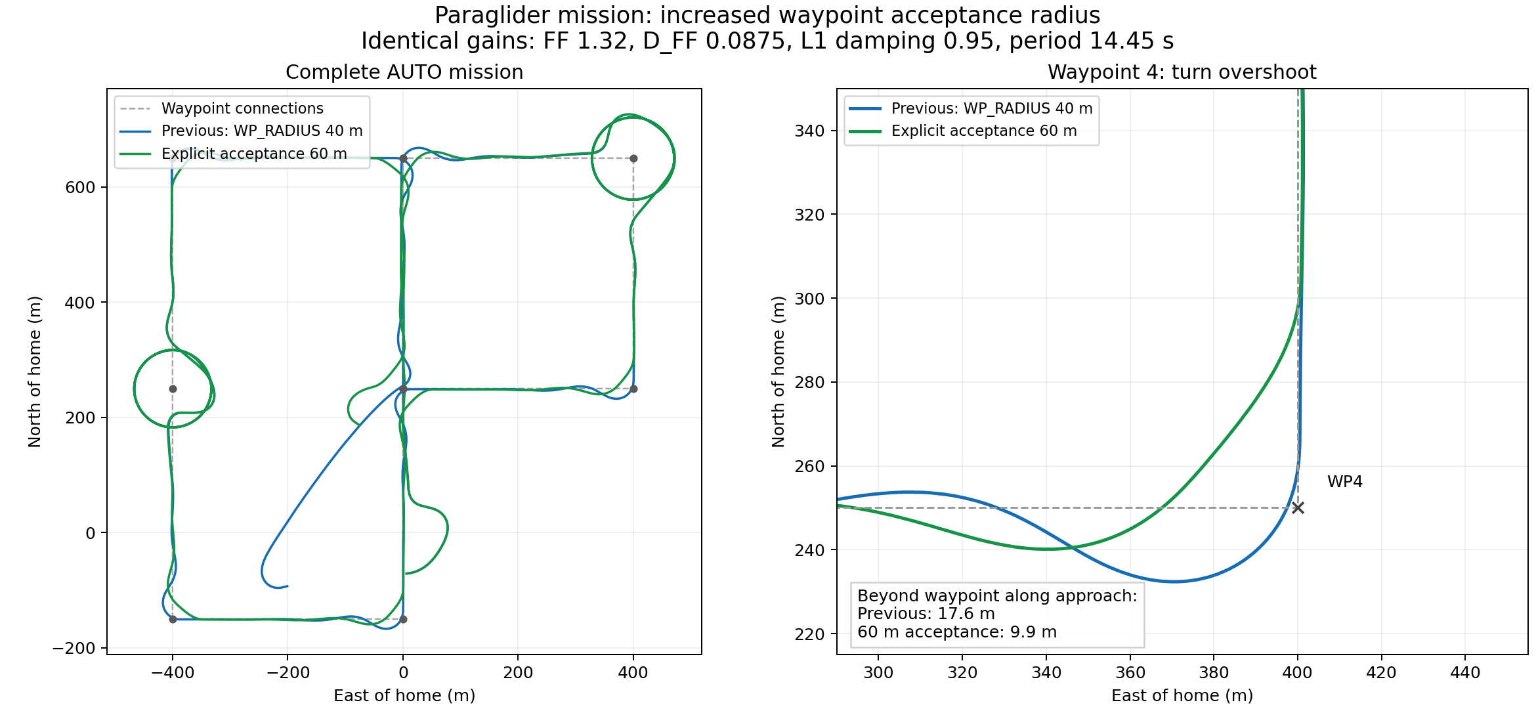
scratch/paraglider-tests/radius60/mission-radius-comparison.png
