DavidIngraham/ArduPilot-tinkering/scratch/paraglider-tests/radius60/turn-response.png

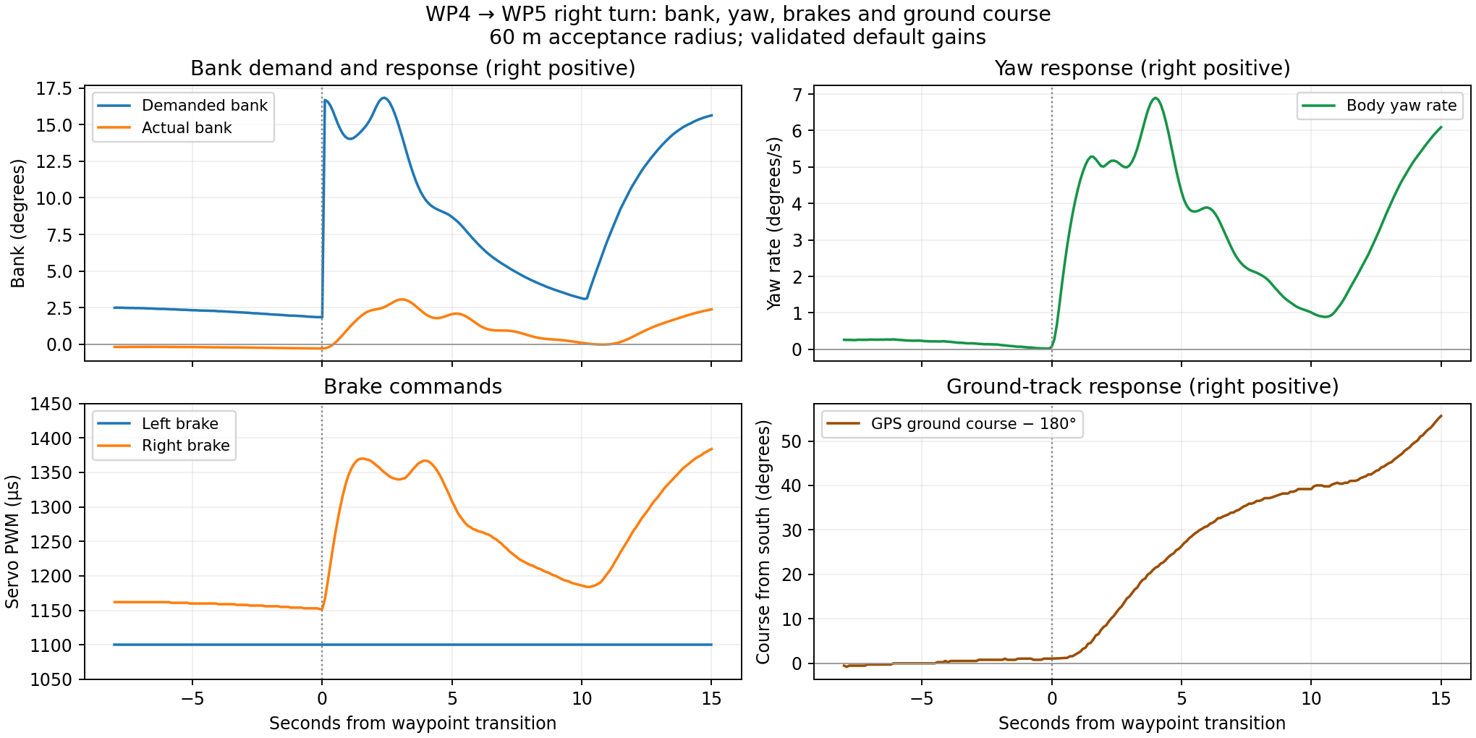
scratch/paraglider-tests/radius60/turn-response.png
