DavidIngraham/ArduPilot-tinkering/scratch/paraglider-tests/turn-optimization/mission-comparison.png

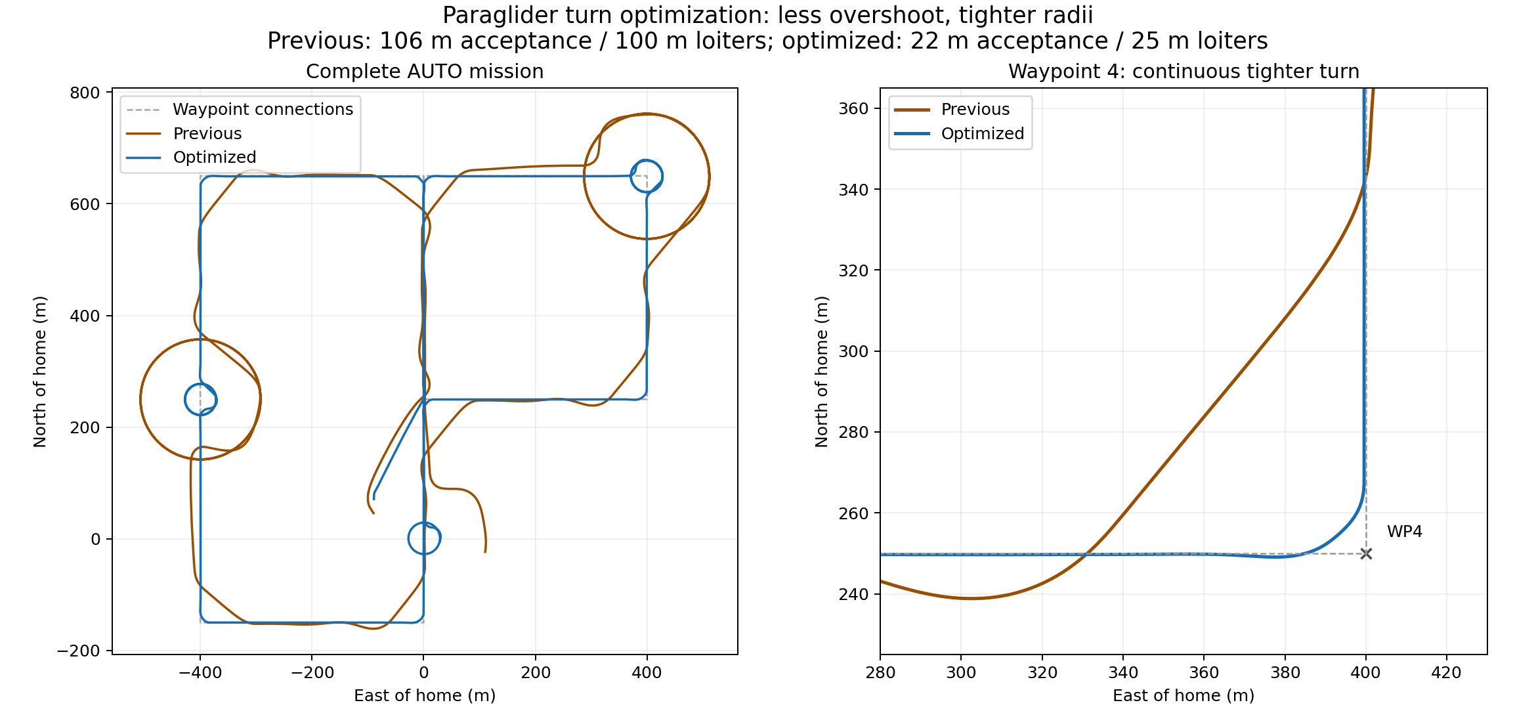
scratch/paraglider-tests/turn-optimization/mission-comparison.png
