DavidIngraham/ArduPilot-tinkering/scratch/paraglider-tests/turn-optimization/turn-response-comparison.png

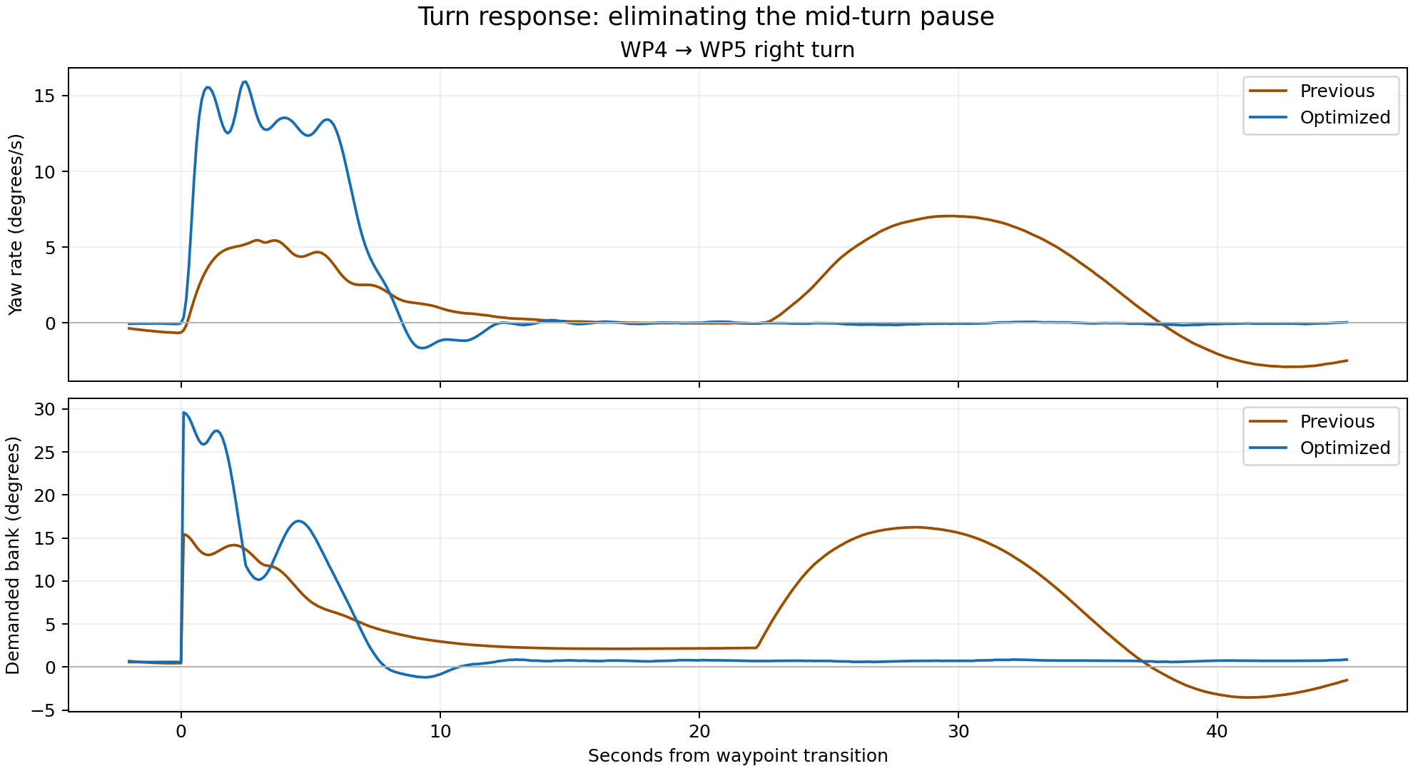
scratch/paraglider-tests/turn-optimization/turn-response-comparison.png
