DavidIngraham/ArduPilot-tinkering/scratch/paraglider-tests/wind-sweep/mission-wind-comparison.png

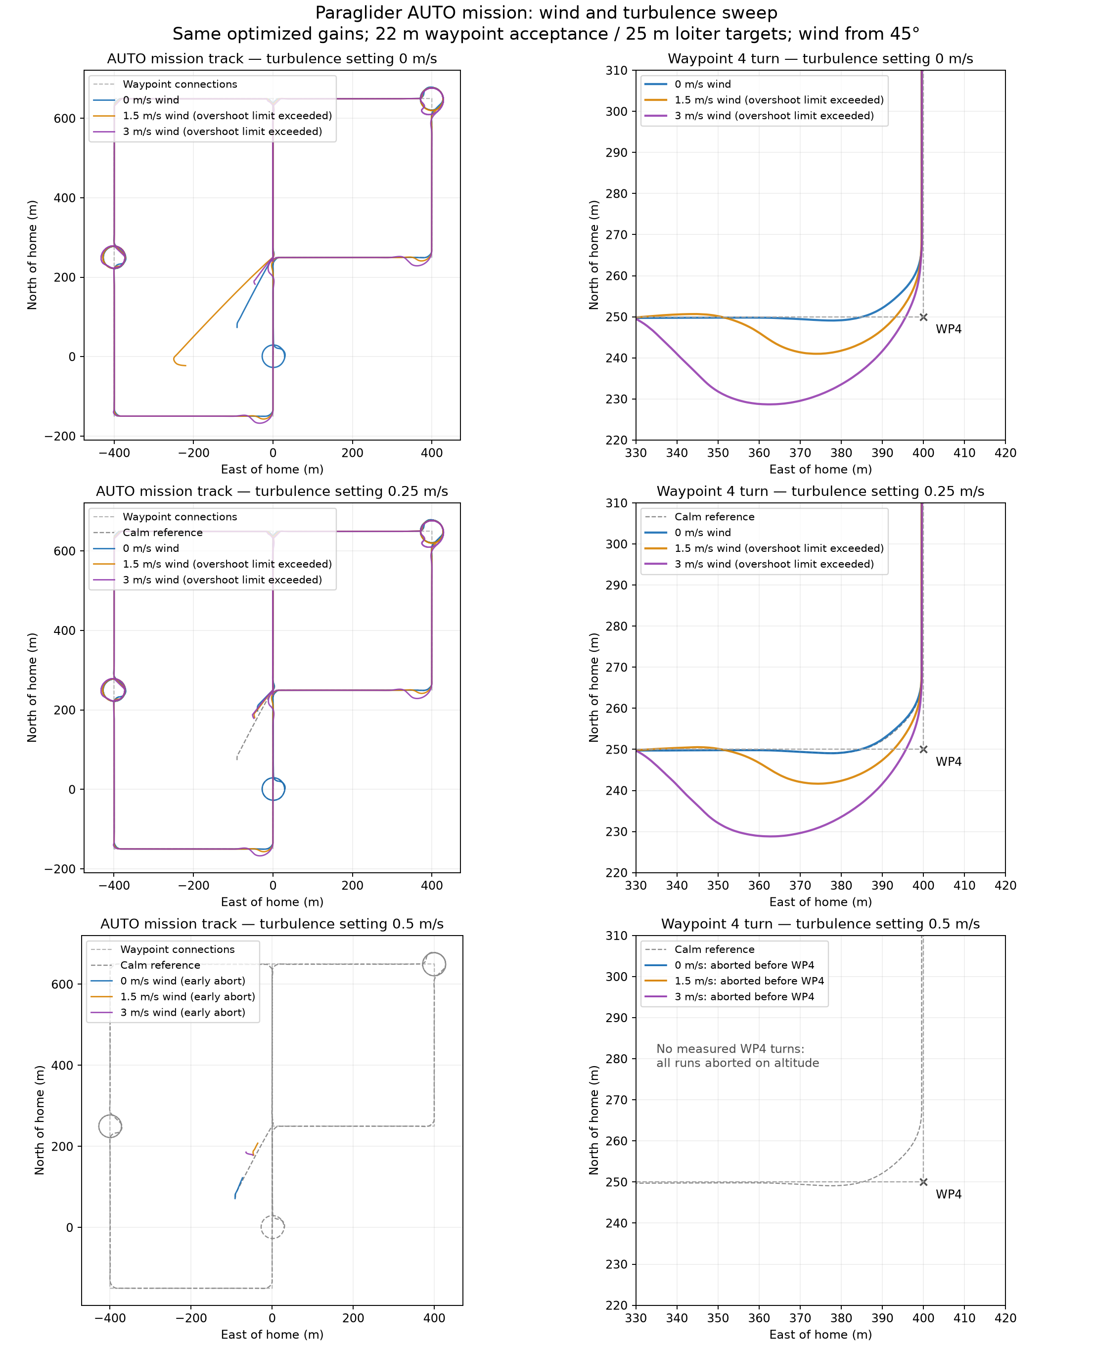
scratch/paraglider-tests/wind-sweep/mission-wind-comparison.png
