DavidIngraham/ArduPilot-tinkering/scratch/paraglider-tests/wind-sweep/wind-tracking-metrics.png

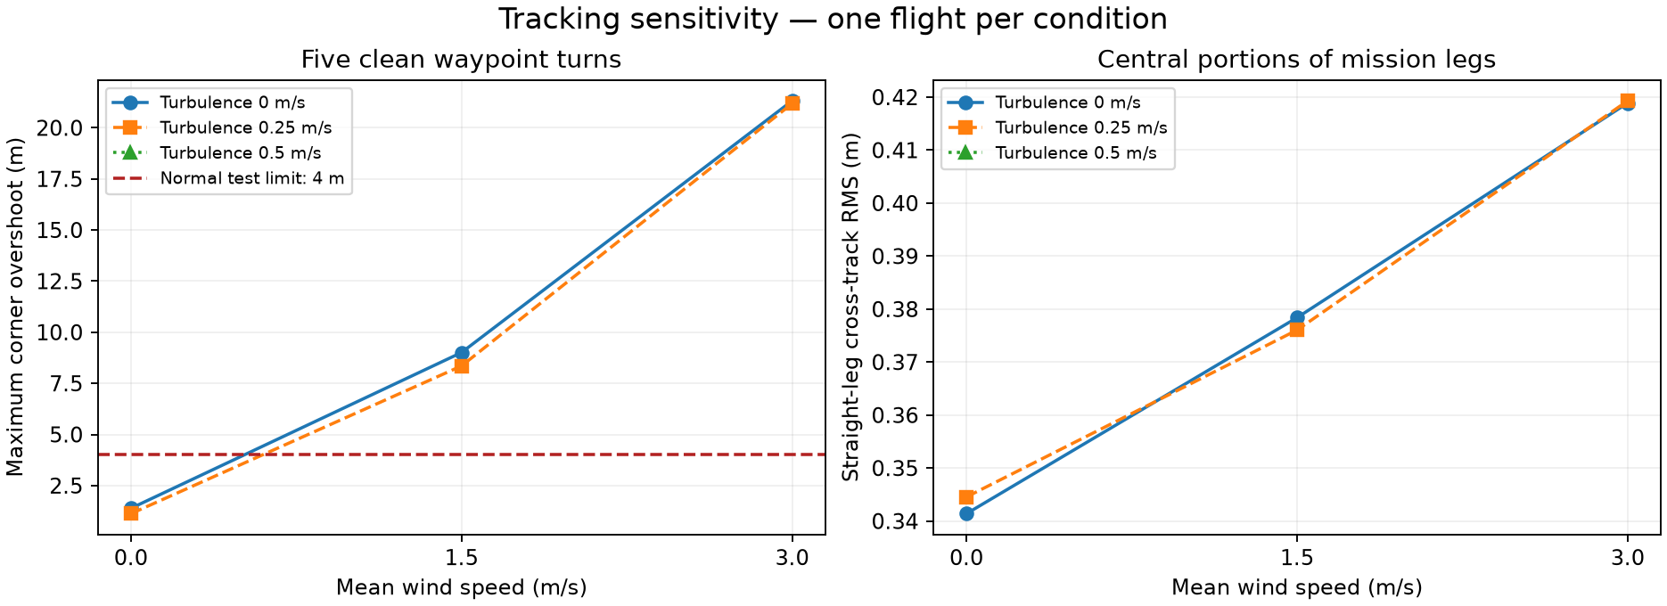
scratch/paraglider-tests/wind-sweep/wind-tracking-metrics.png
