DavidIngraham/ArduPilot-tinkering/scratch/paraglider-tests/yaw-experiments.png

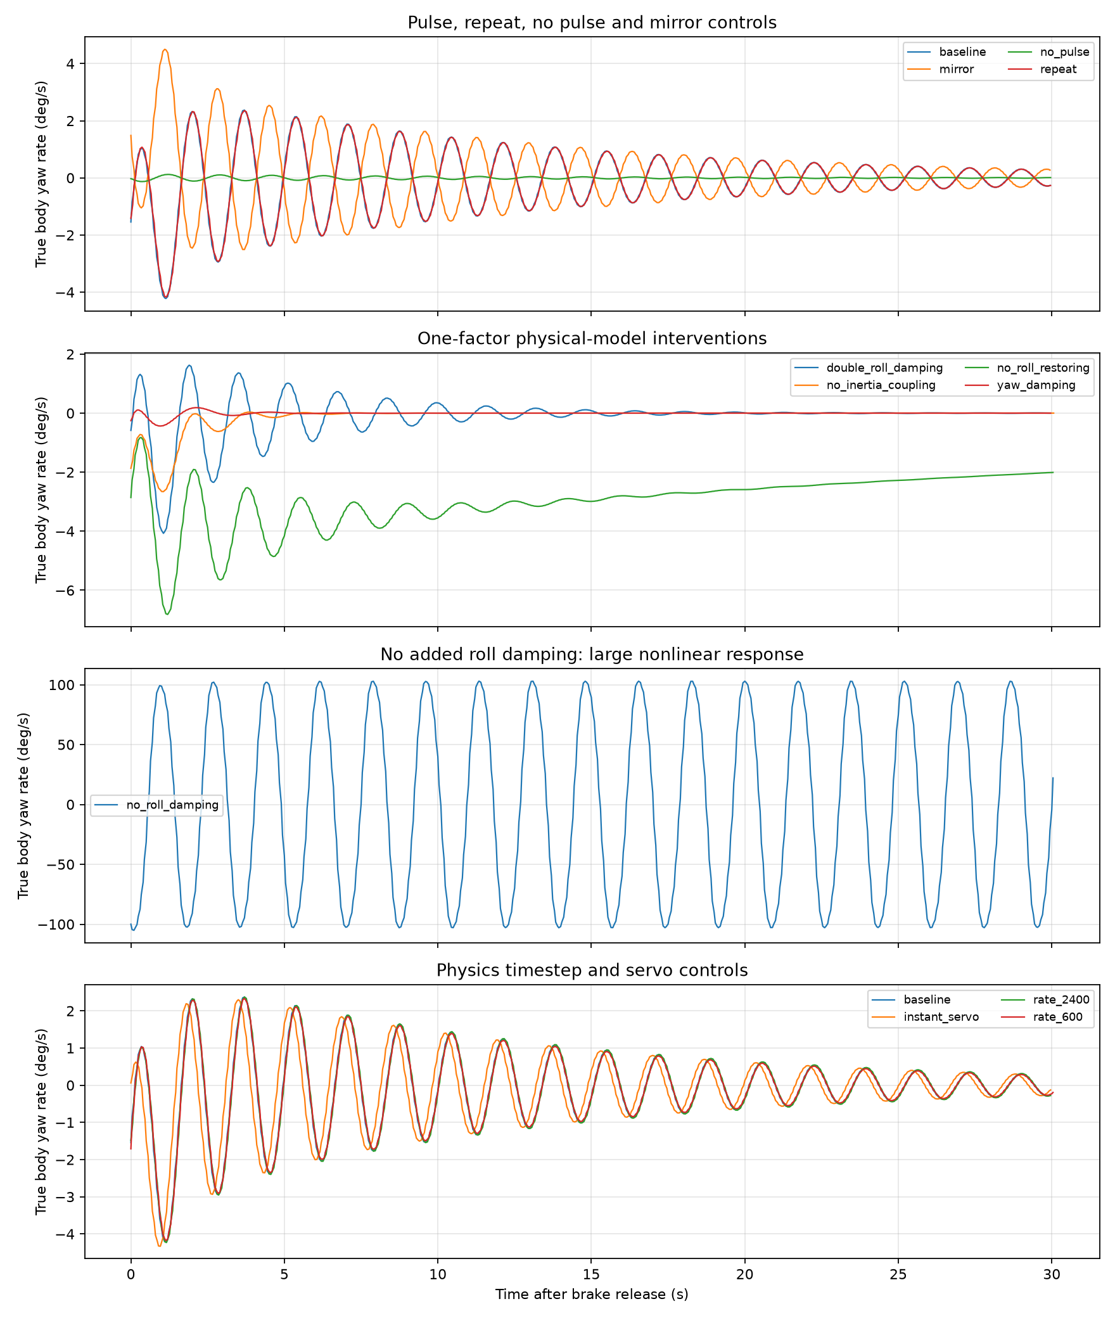
scratch/paraglider-tests/yaw-experiments.png
