DavidIngraham/ArduPilot-tinkering/scratch/paraglider-tests/pitch-joint/damper-comparison.pdf

0

5

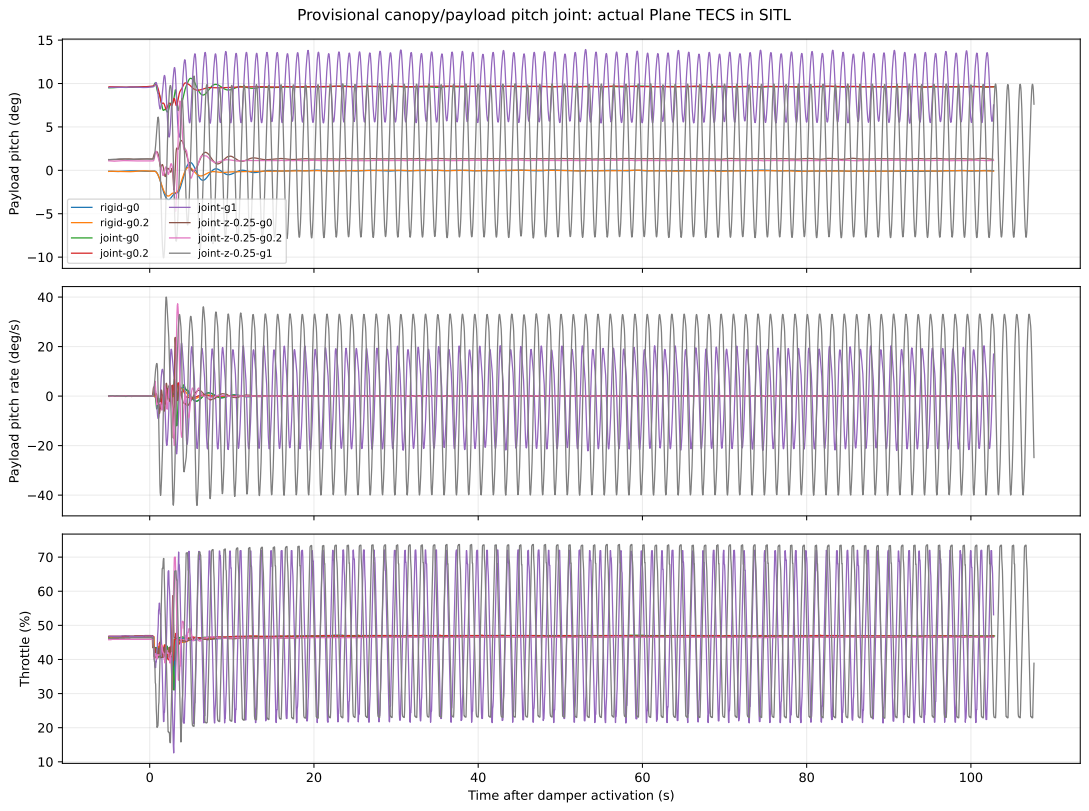
[picture p163: page 1]
Throttle (%)

Provisional canopy/payload pitch joint: actual Plane TECS in SITL

Payload pitch (deg)

rigid-g0 | joint-g1
rigid-g0.2 joint-g0 joint-g0.2 | joint-z-0.25-g0 joint-z-0.25-g0.2 joint-z-0.25-g1

Payload pitch rate (deg/s)

Time after damper activation (s)
