DavidIngraham/ArduPilot-tinkering/scratch/paraglider-tests/pitch-joint/matched-joint-comparison.pdf

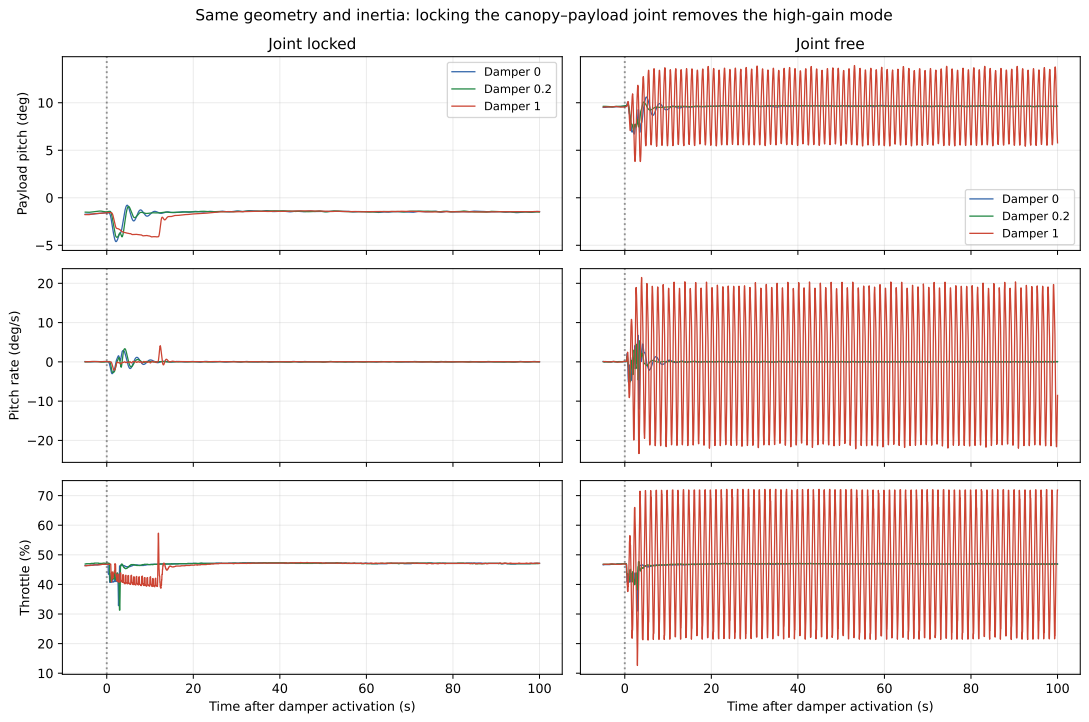
[picture p164: page 1]
Joint locked; Damper 0 Damper 0.2 Damper 1; Joint free; Throttle (%)

Same geometry and inertia: locking the canopy–payload joint removes the high-gain mode

Payload pitch (deg)

Damper 0
Damper 0.2 Damper 1

Pitch rate (deg/s)

Time after damper activation (s)
