DavidIngraham/ArduPilot-tinkering/scratch/paraglider-tests/pitch-joint/integrated-control/auto-mission-longitudinal.pdf

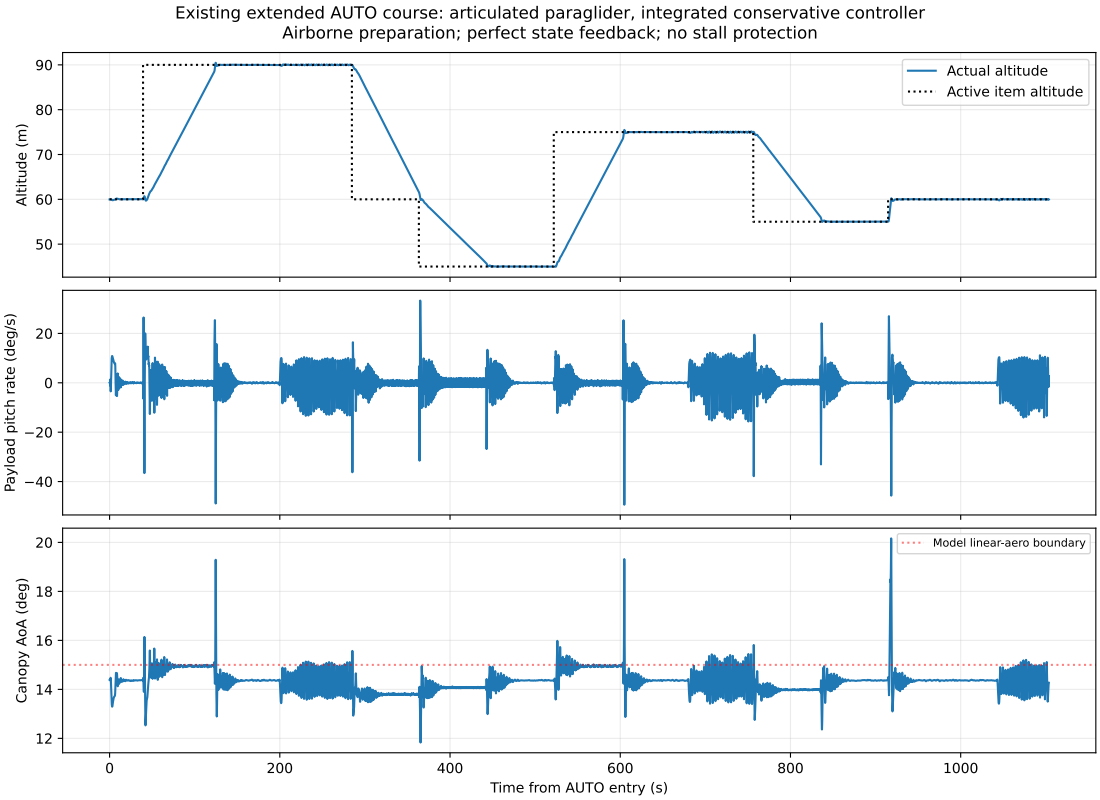
[picture p165: page 1]
Altitude (m)

Existing extended AUTO course: articulated paraglider, integrated conservative controller

Airborne preparation; perfect state feedback; no stall protection

Actual altitude
Active item altitude

Payload pitch rate (deg/s)

Model linear-aero boundary

Canopy AoA (deg)

Time from AUTO entry (s)
