DavidIngraham/ArduPilot-tinkering/scratch/paraglider-tests/pitch-joint/integrated-control/frequency-comparison.pdf

−5

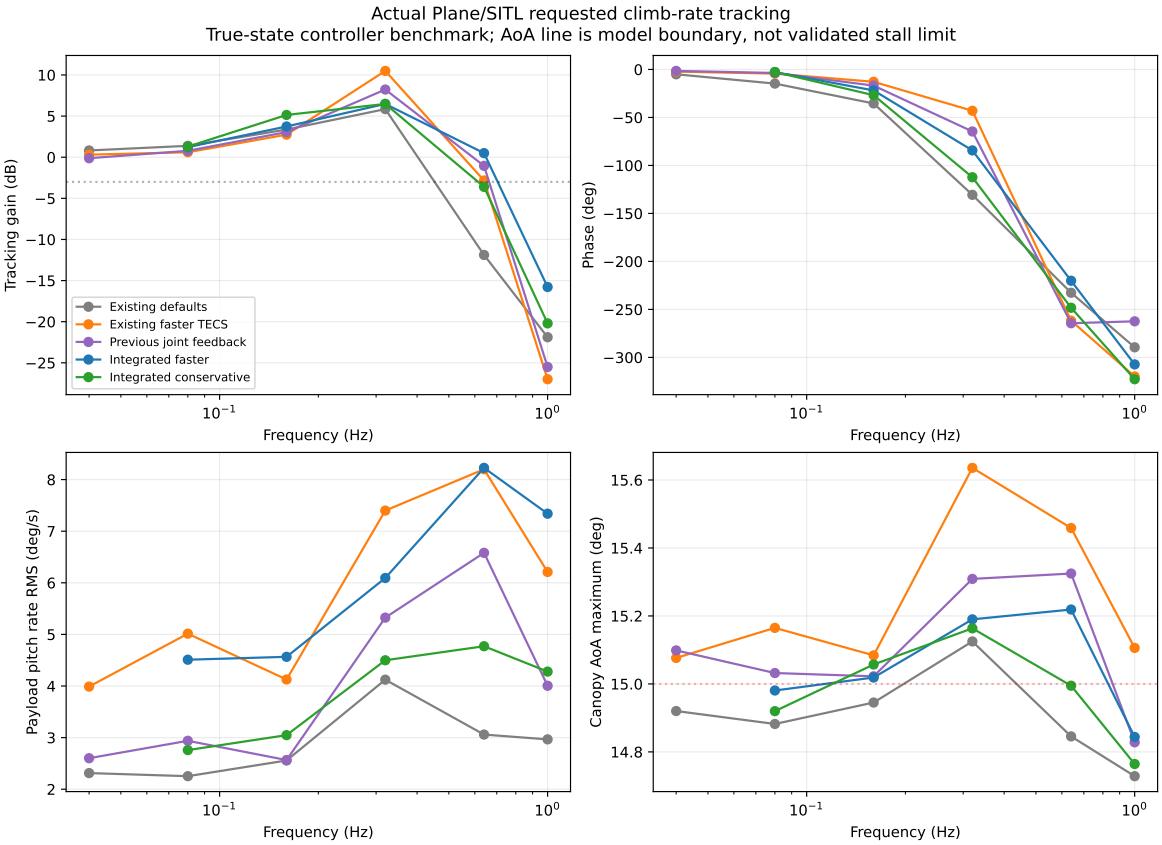
[picture p166: page 1]
Frequency (Hz); Phase (deg)

Actual Plane/SITL requested climb-rate tracking

True-state controller benchmark; AoA line is model boundary, not validated stall limit

Tracking gain (dB)

Existing defaults
Existing faster TECS Previous joint feedback Integrated faster

Integrated conservative

Payload pitch rate RMS (deg/s)

Canopy AoA maximum (deg)
