DavidIngraham/ArduPilot-tinkering/scratch/paraglider-tests/pitch-joint/integrated-control/step-comparison.pdf

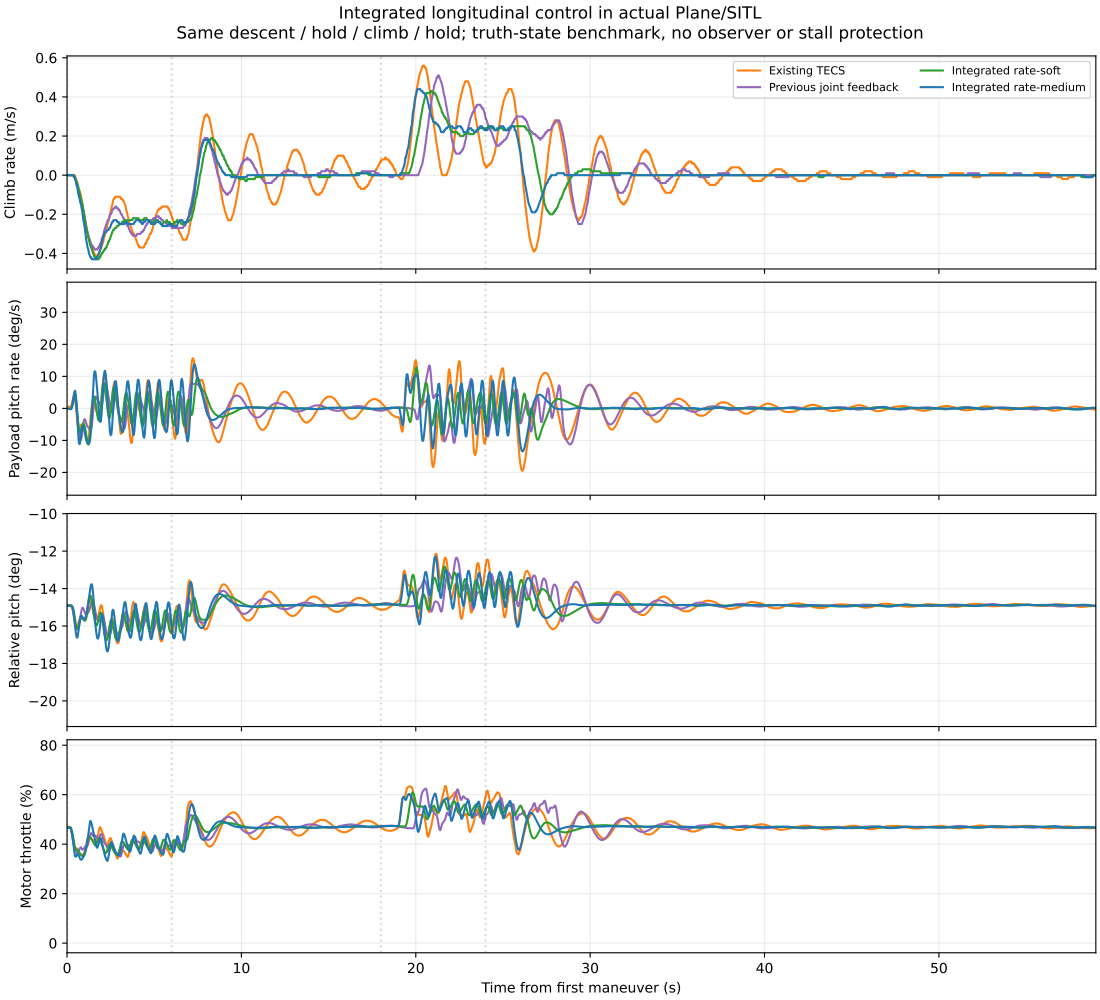
[picture p167: page 1]
Climb rate (m/s); Payload pitch rate (deg/s); Motor throttle (%)

Integrated longitudinal control in actual Plane/SITL

Same descent / hold / climb / hold; truth-state benchmark, no observer or stall protection

Existing TECS
Previous joint feedback

Integrated rate-soft
Integrated rate-medium

Relative pitch (deg)

Time from first maneuver (s)
