DavidIngraham/ArduPilot-tinkering/scratch/paraglider-tests/pitch-joint/oracle-control/controller-comparison.pdf

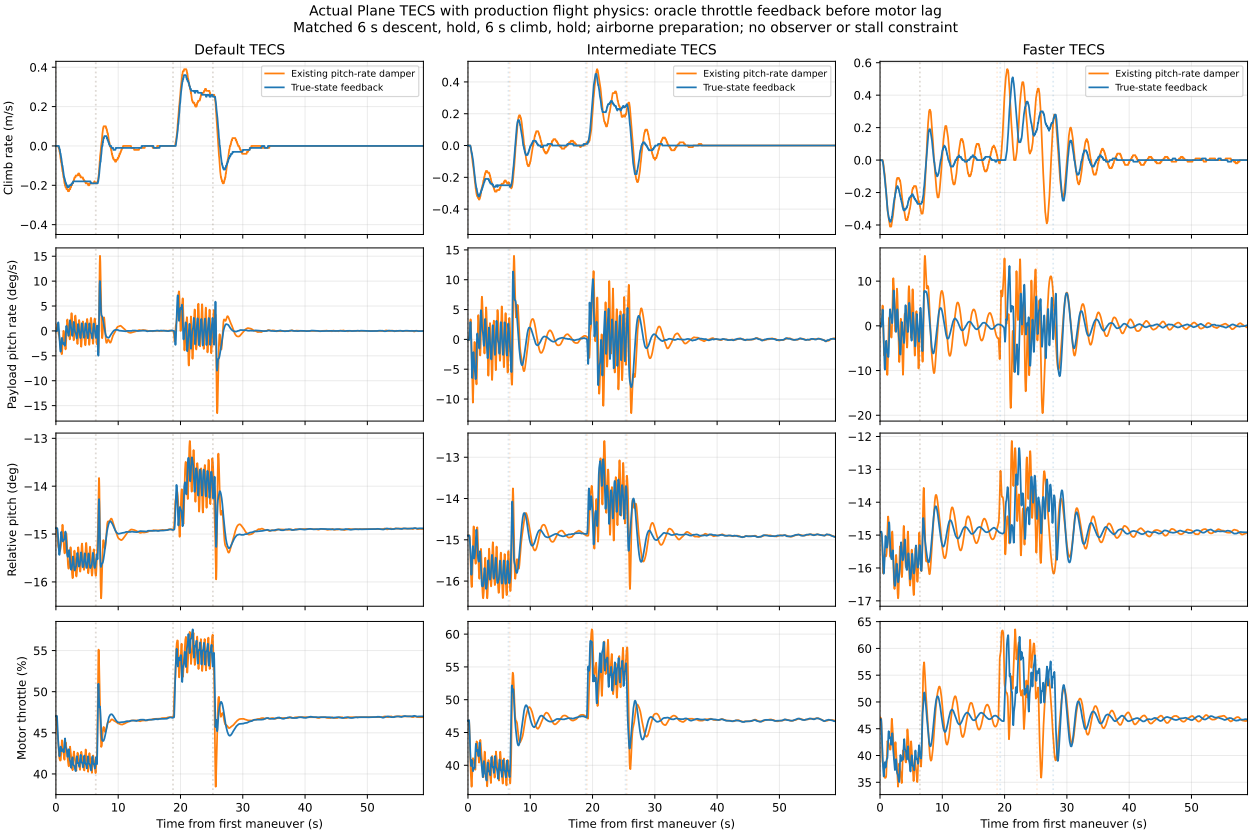
[picture p168: page 1]
Climb rate (m/s); Default TECS; Intermediate TECS; Faster TECS; Motor throttle (%)

Actual Plane TECS with production flight physics: oracle throttle feedback before motor lag
Matched 6 s descent, hold, 6 s climb, hold; airborne preparation; no observer or stall constraint

Existing pitch-rate damper
True-state feedback

Payload pitch rate (deg/s)

Relative pitch (deg)

Time from first maneuver (s)
