DavidIngraham/ArduPilot-tinkering/scratch/paraglider-tests/pitch-joint/oracle-control/frequency-comparison.pdf

−5

0

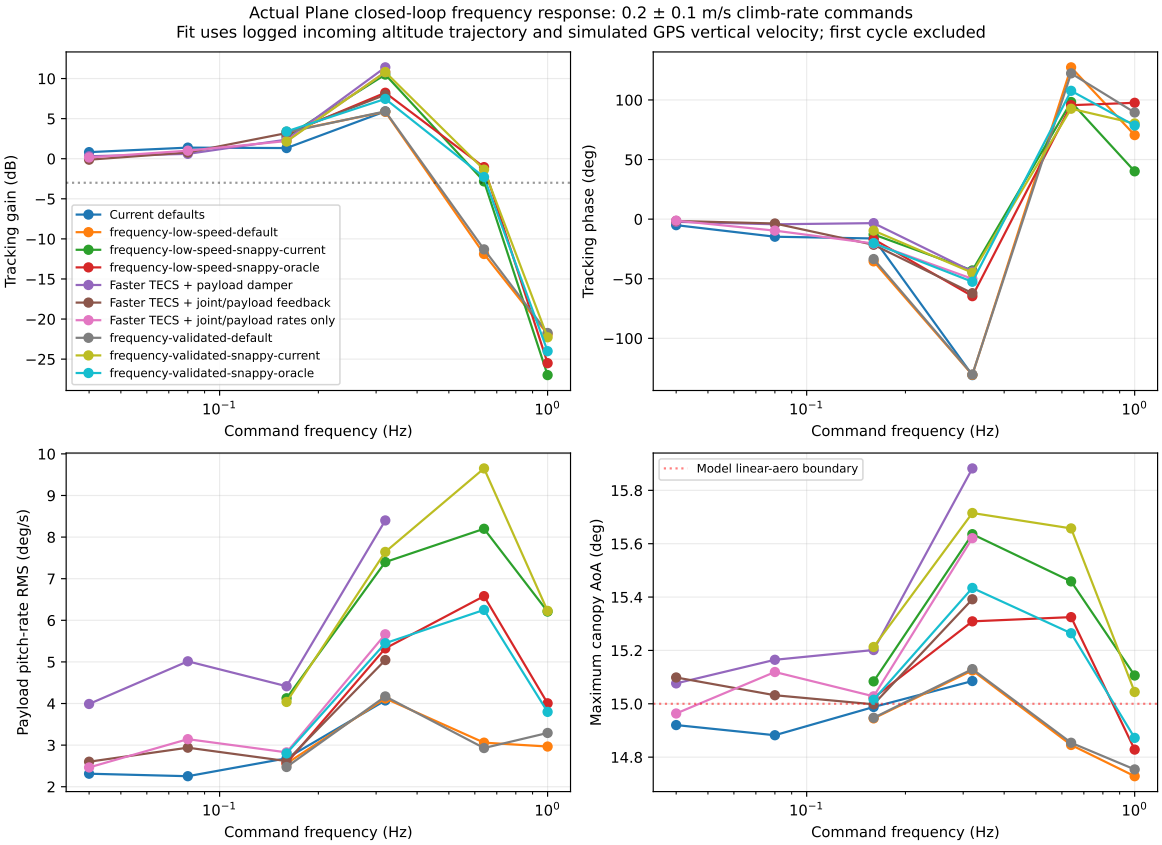
[picture p169: page 1]

Actual Plane closed-loop frequency response: 0.2 ± 0.1 m/s climb-rate commands

Fit uses logged incoming altitude trajectory and simulated GPS vertical velocity; first cycle excluded

Tracking phase (deg)

Tracking gain (dB)

Current defaults frequency-low-speed-default

frequency-low-speed-snappy-current frequency-low-speed-snappy-oracle

Faster TECS + payload damper Faster TECS + joint/payload feedback

Faster TECS + joint/payload rates only frequency-validated-default frequency-validated-snappy-current

frequency-validated-snappy-oracle

Command frequency (Hz)

Model linear-aero boundary

Payload pitch-rate RMS (deg/s)

Maximum canopy AoA (deg)
