DavidIngraham/ArduPilot-tinkering/scratch/paraglider-tests/pitch-joint/oracle-control/frequency-final.pdf

−5

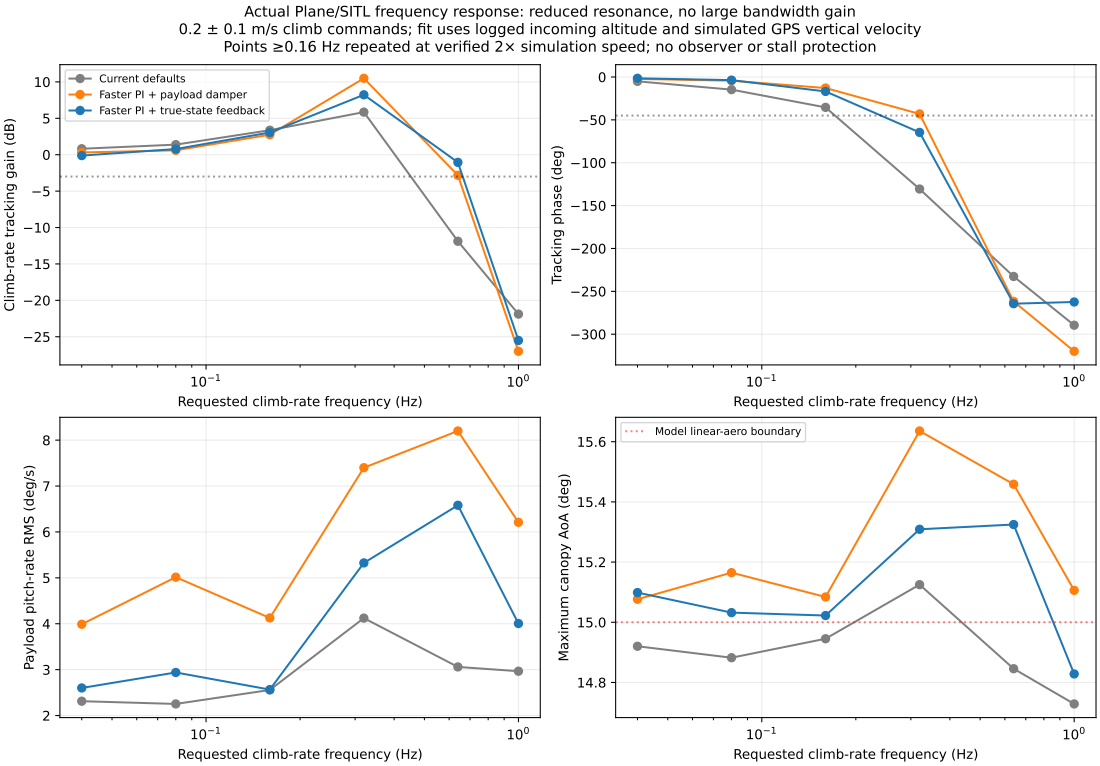
[picture p170: page 1]

Actual Plane/SITL frequency response: reduced resonance, no large bandwidth gain

0.2 ± 0.1 m/s climb commands; fit uses logged incoming altitude and simulated GPS vertical velocity

Points ≥0.16 Hz repeated at verified 2× simulation speed; no observer or stall protection

Current defaults
Faster PI + payload Faster PI + true-state feedback | damper

Climb-rate tracking gain (dB)

Tracking phase (deg)

Requested climb-rate frequency (Hz)

Model linear-aero boundary

Payload pitch-rate RMS (deg/s)

Maximum canopy AoA (deg)
