DavidIngraham/ArduPilot-tinkering/scratch/paraglider-tests/pitch-joint/physics-review/longitudinal-comparison.pdf

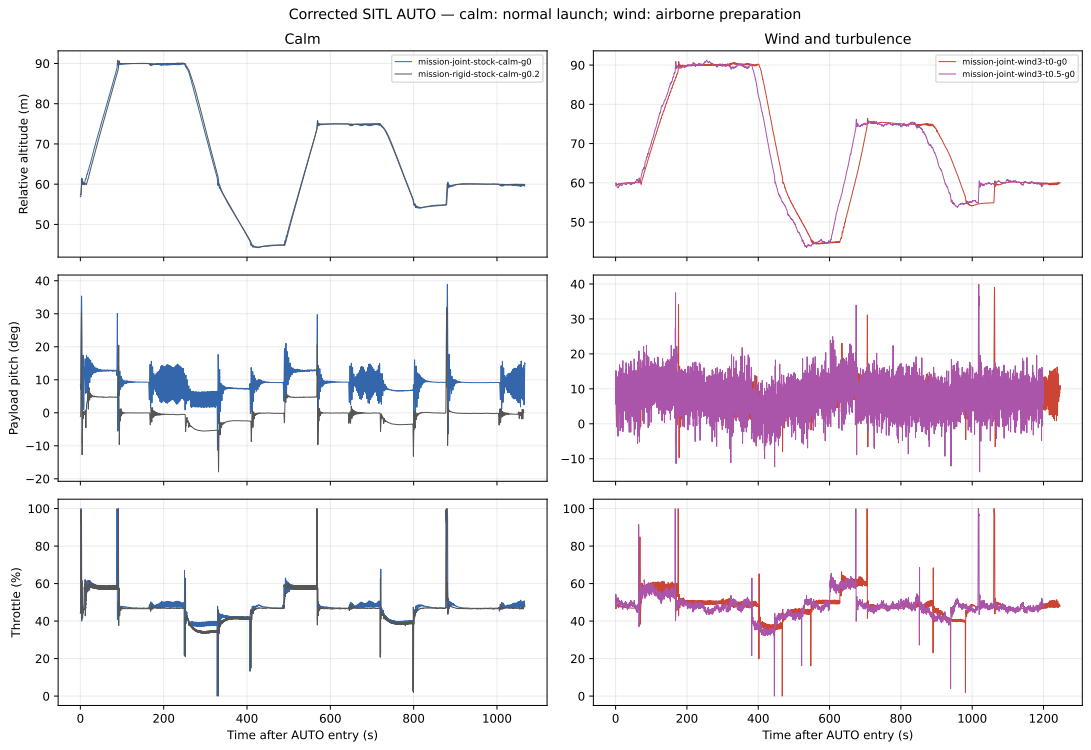
[picture p171: page 1]
Relative altitude (m); Calm; mission-joint-wind3-t0-g0; mission-joint-wind3-t0.5-g0; Throttle (%)

Corrected SITL AUTO — calm: normal launch; wind: airborne preparation

Wind and turbulence

mission-joint-stock-calm-g0
mission-rigid-stock-calm-g0.2

Payload pitch (deg)

Time after AUTO entry (s)
