DavidIngraham/ArduPilot-tinkering/scratch/paraglider-tests/pitch-joint/physics-review/mission-comparison.pdf

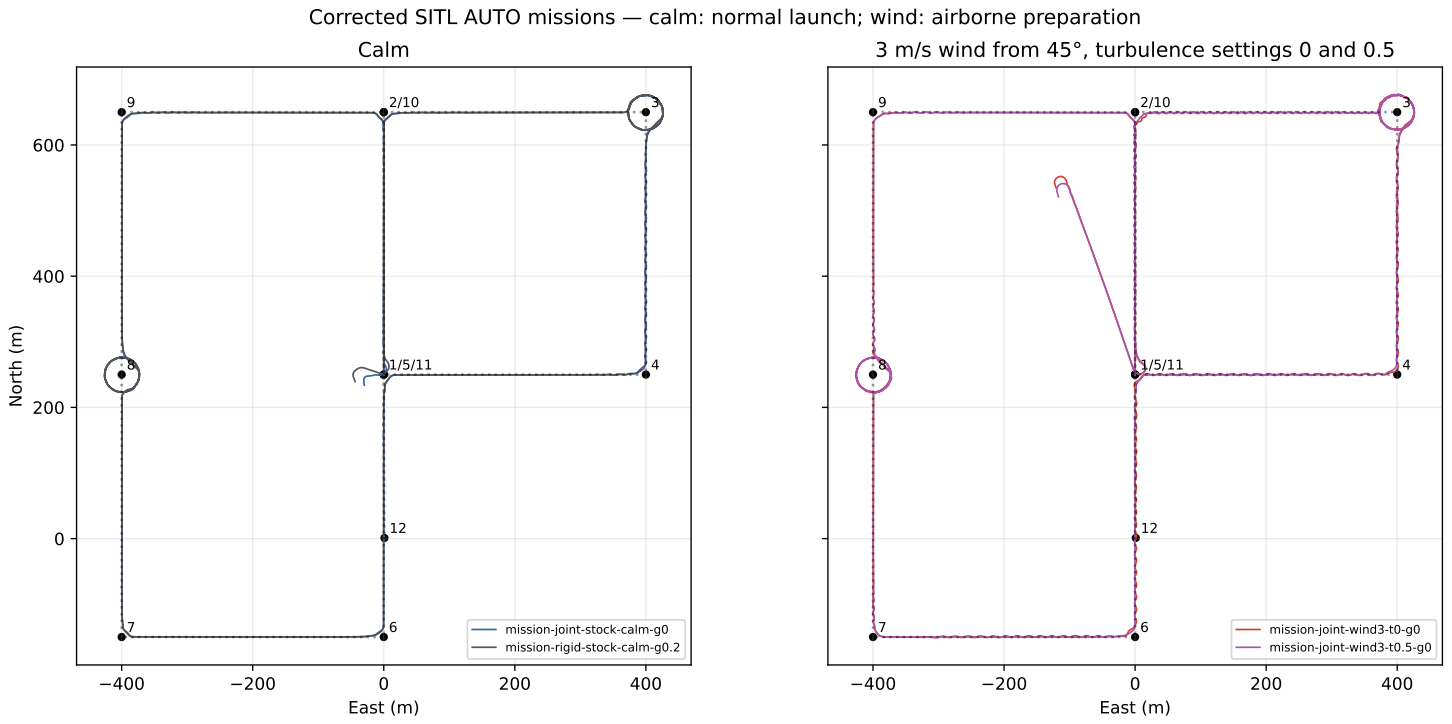
[picture p172: page 1]
East (m); North (m); Calm; mission-joint-wind3-t0-g0; mission-joint-wind3-t0.5-g0

Corrected SITL AUTO missions — calm: normal launch; wind: airborne preparation

3 m/s wind from 45°, turbulence settings 0 and 0.5

mission-joint-stock-calm-g0
mission-rigid-stock-calm-g0.2
