DavidIngraham/ArduPilot-tinkering/scratch/paraglider-tests/pitch-joint/swing-launch/inverted-launch.pdf

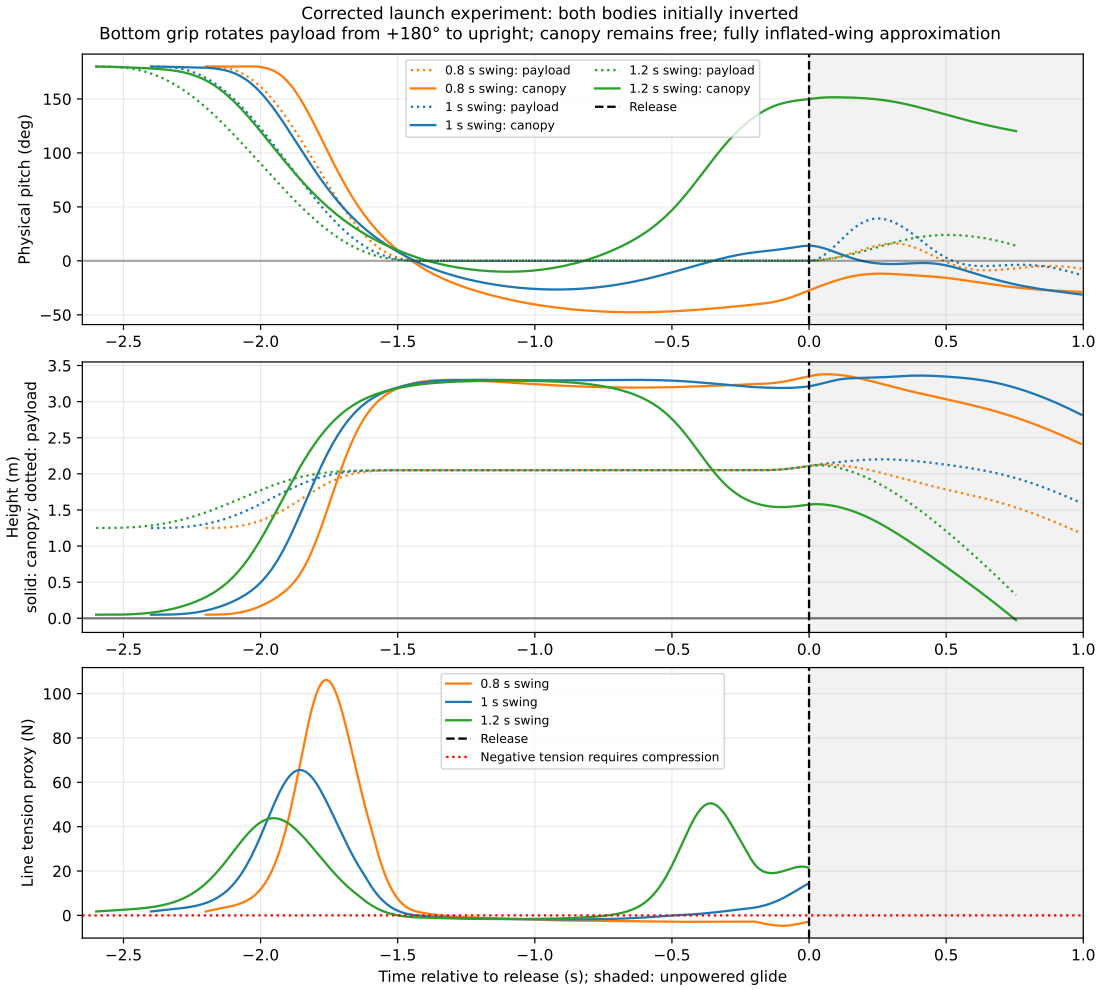
[picture p173: page 1]
Height (m)

Corrected launch experiment: both bodies initially inverted

Bottom grip rotates payload from +180° to upright; canopy remains free; fully inflated-wing approximation

0.8 s swing: payload 0.8 s swing: canopy | 1.2 s swing: payload 1.2 s swing: canopy

1 s swing: payload 1 s swing: canopy | Release

Physical pitch (deg)

solid: canopy; dotted: payload

0.8 s swing
1 s swing 1.2 s swing Release

Line tension proxy (N)

Negative tension requires compression

Time relative to release (s); shaded: unpowered glide
