DavidIngraham/ArduPilot-tinkering/scratch/paraglider-tests/pitch-joint/auto-regression/before-aero-sign/longitudinal-comparison.pdf

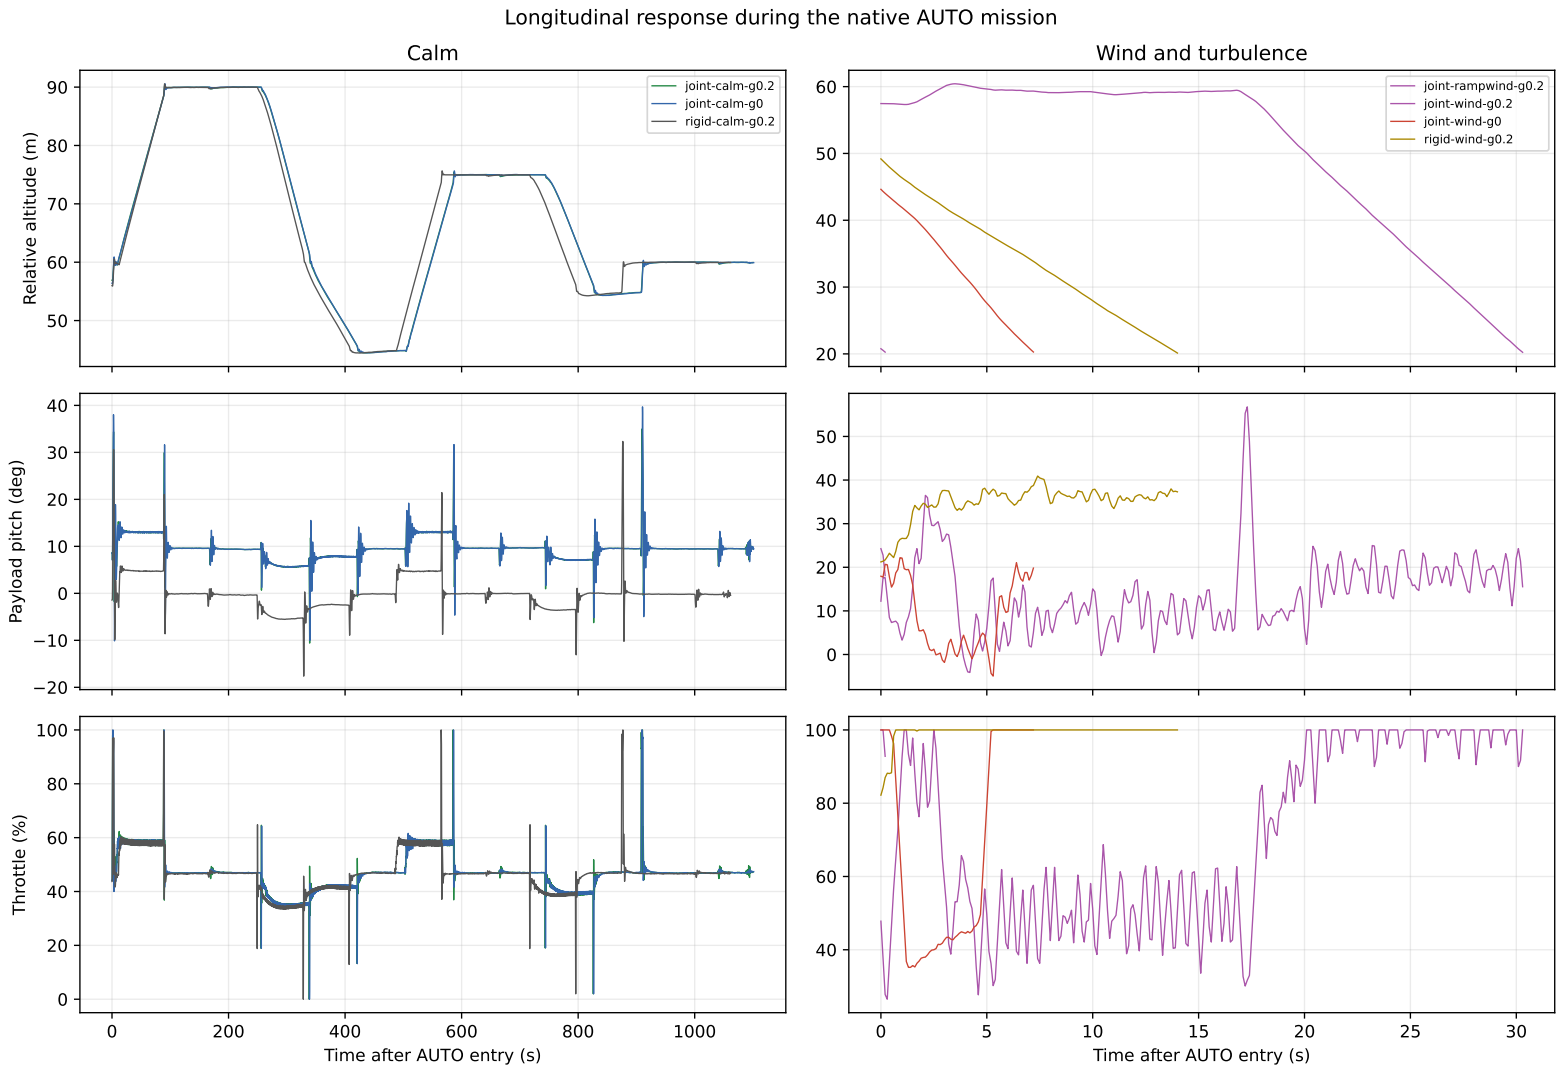
[picture p174: page 1]
Relative altitude (m); Calm; joint-calm-g0.2; joint-calm-g0; rigid-calm-g0.2; joint-rampwind-g0.2; joint-wind-g0.2; joint-wind-g0; rigid-wind-g0.2; Throttle (%)

Longitudinal response during the native AUTO mission

Wind and turbulence

Payload pitch (deg)

Time after AUTO entry (s)
