DavidIngraham/ArduPilot-tinkering/scratch/paraglider-tests/pitch-joint/auto-regression/before-aero-sign/mission-comparison.pdf

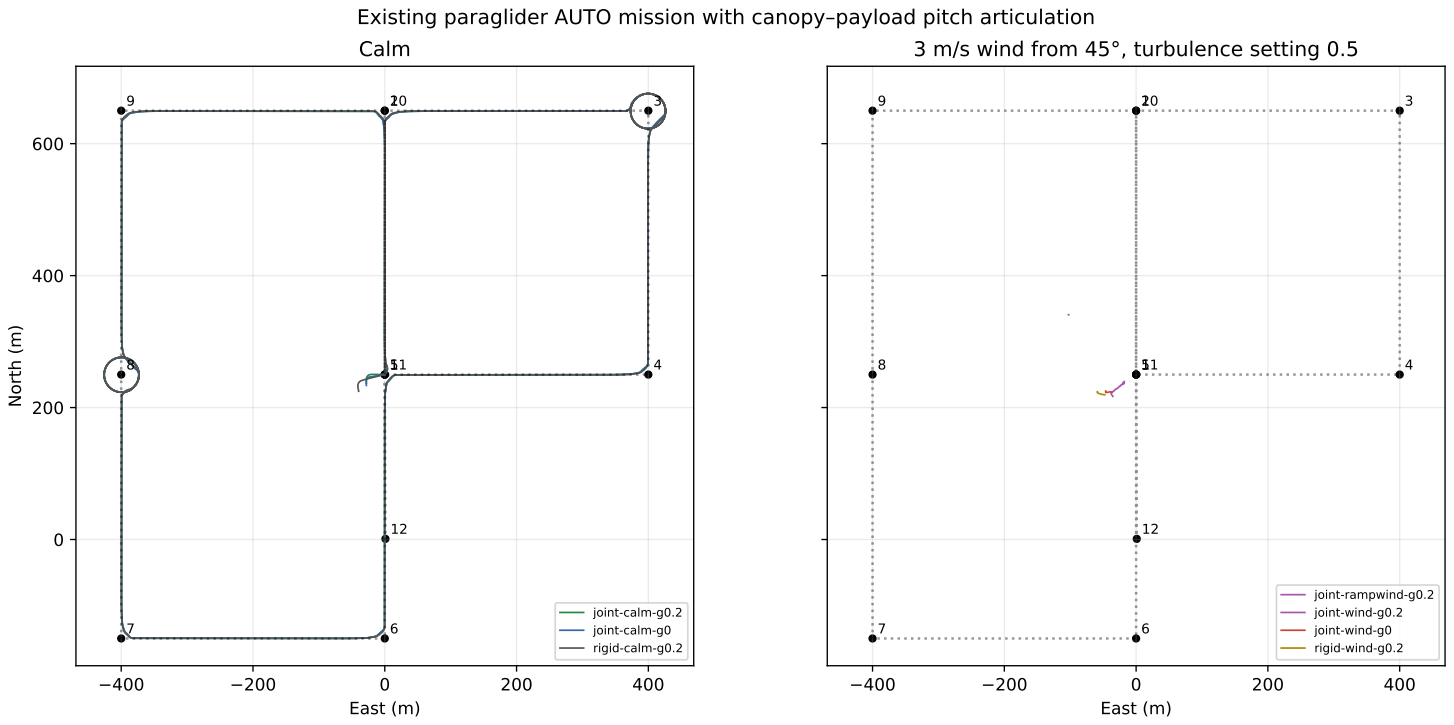
[picture p175: page 1]
East (m); North (m); Calm; joint-calm-g0.2; joint-calm-g0; rigid-calm-g0.2; joint-rampwind-g0.2; joint-wind-g0.2; joint-wind-g0; rigid-wind-g0.2

Existing paraglider AUTO mission with canopy–payload pitch articulation

3 m/s wind from 45°, turbulence setting 0.5
