DavidIngraham/ArduPilot-tinkering/scratch/plane-trajectory/overfly-mission-comparison.pdf

600

800

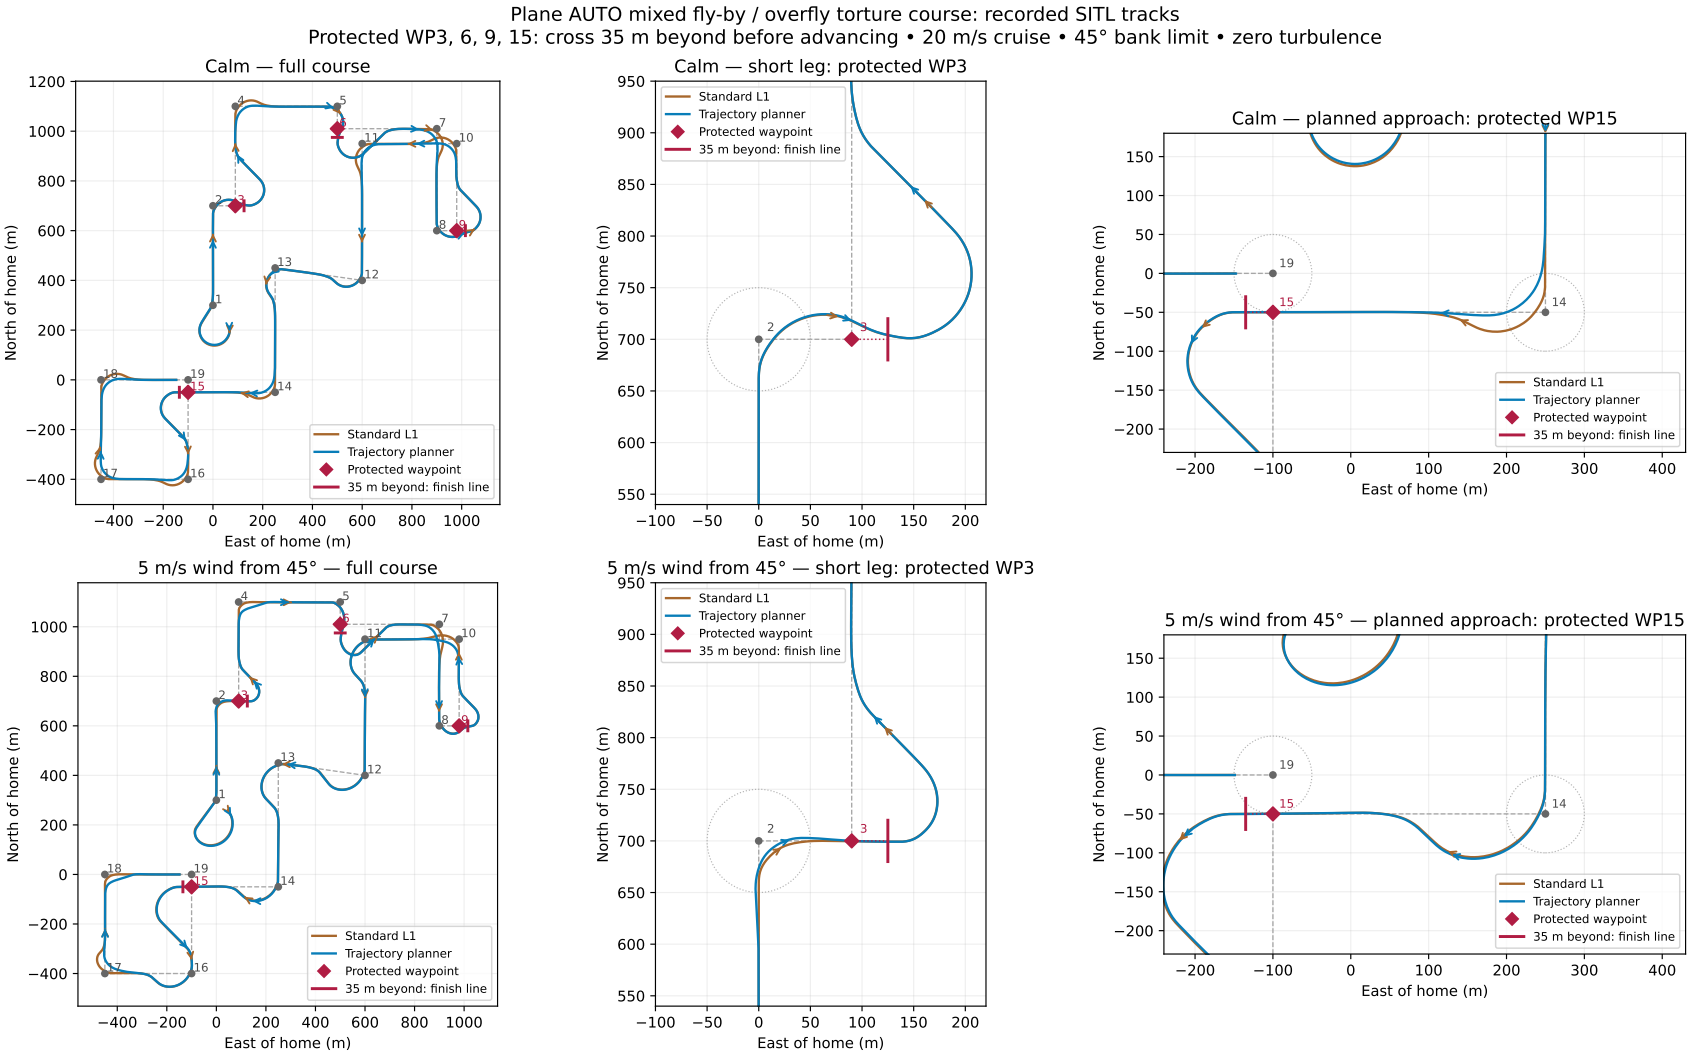
[picture p176: page 1]
Standard L1; Trajectory planner; Protected waypoint; m beyond: finish line; Trajectory; planner; Protected; waypoint; Protected WP3, 6, 9, 15: cross 35 m beyond before advancing • 20 m/s cruise • 45° bank limit • zero; turbulence

Plane AUTO mixed fly-by / overfly torture course: recorded SITL tracks

Calm — full course

Calm — short leg: protected WP3

Standard L1
35 m beyond: finish line

Calm — planned approach: protected WP15

North of home (m)

Trajectory planner Protected waypoint

East of home (m)

5 m/s wind from 45° — full course

5 m/s wind from 45° — short leg: protected WP3

5 m/s wind from 45° — planned approach: protected WP15

17 | 16 | Standard L1 Trajectory planner Protected waypoint

35 | m beyond: finish | line
