DavidIngraham/ArduPilot-tinkering/scratch/plane-trajectory/strong-wind-mission-comparison.pdf

0

200

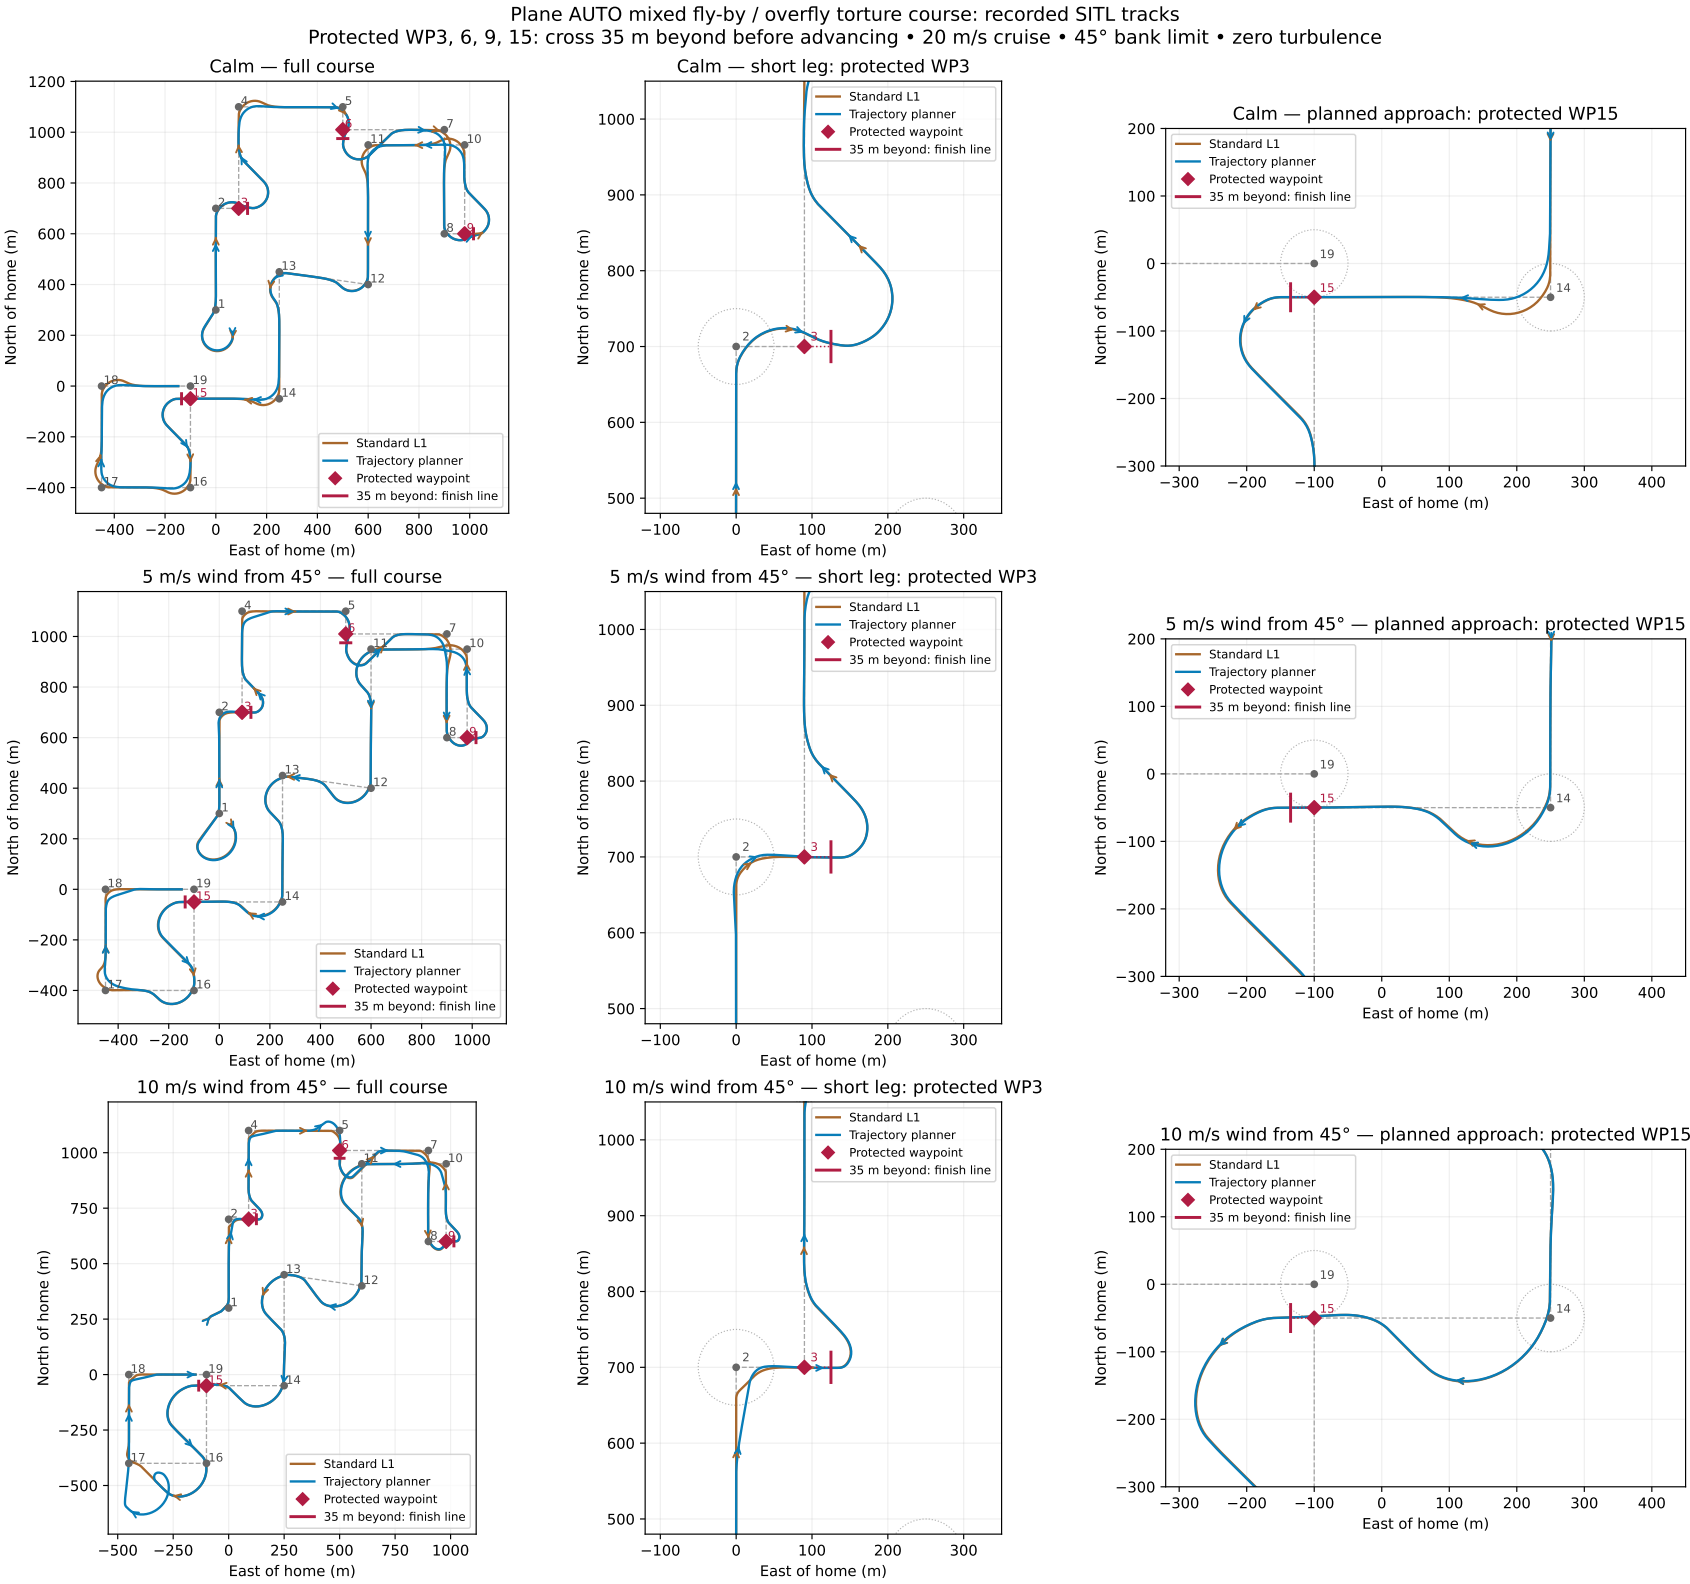
[picture p177: page 1]

Plane AUTO mixed fly-by / overfly torture course: recorded SITL tracks

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

Calm — full course

Calm — short leg: protected WP3

Standard L1
Trajectory planner
Protected waypoint
35 m beyond: finish line

Calm — planned approach: protected WP15

North of home (m)

17 | 16 | Standard L1 Trajectory planner Protected waypoint

East of home (m)

5 m/s wind from 45° — full course

5 m/s wind from 45° — short leg: protected WP3

5 m/s wind from 45° — planned approach: protected WP15

35 | m beyond: finish | line

10 m/s wind from 45° — full course

10 m/s wind from 45° — short leg: protected WP3

10 m/s wind from 45° — planned approach: protected WP15

17 | 16 | Standard L1 Trajectory planner

Protected waypoint 35 | m beyond: finish line
