DavidIngraham/ArduPilot-tinkering/scratch/plane-trajectory/flexible-line-comparison/raster-comparison.pdf

1200

1400

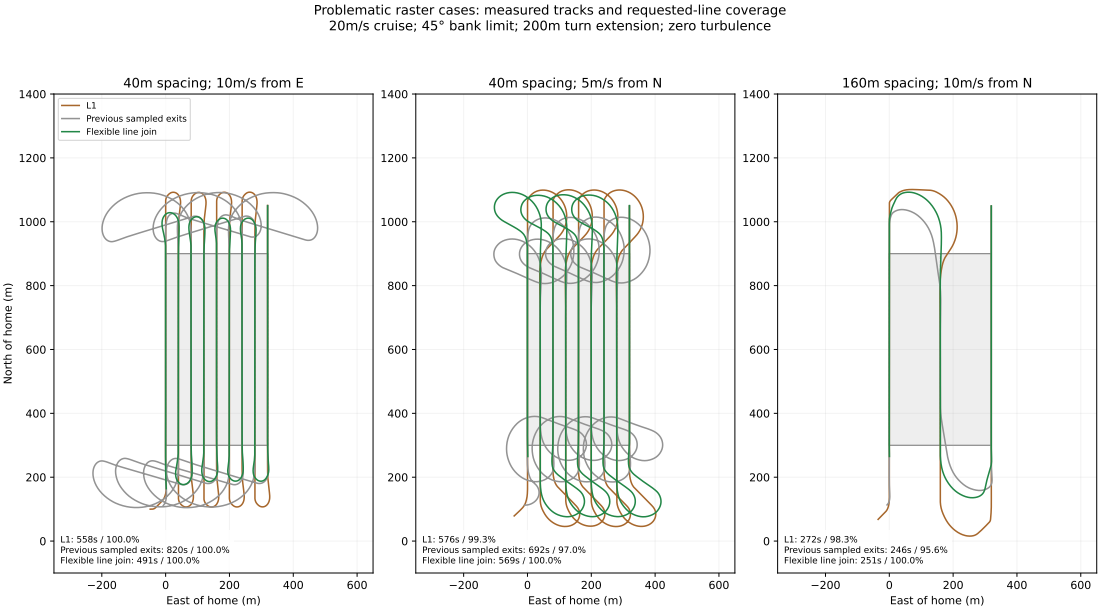
[picture p178: page 1]
40m spacing; 10m/s from E; 40m spacing; 5m/s from N; 160m spacing; 10m/s from N

Problematic raster cases: measured tracks and requested-line coverage
20m/s cruise; 45° bank limit; 200m turn extension; zero turbulence

Previous sampled exits
Flexible line join

North of home (m)

Previous sampled exits: 820s / 100.0%
Flexible line join: 491s / 100.0%

Previous sampled exits: 692s / 97.0%
Flexible line join: 569s / 100.0%

Previous sampled exits: 246s / 95.6%
Flexible line join: 251s / 100.0%

East of home (m)
