DavidIngraham/ArduPilot-tinkering/scratch/plane-trajectory/flexible-line-comparison/torture-comparison.pdf

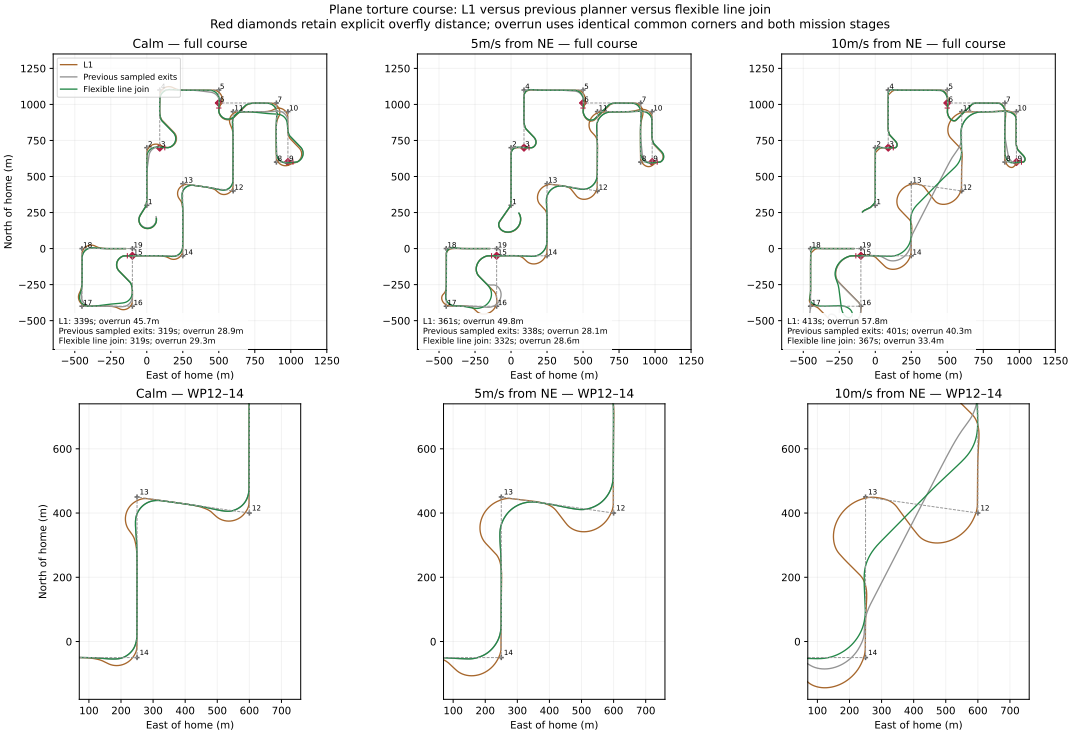
[picture p179: page 1]

Plane torture course: L1 versus previous planner versus flexible line join

Red diamonds retain explicit overfly distance; overrun uses identical common corners and both mission stages

Calm — full course

5m/s from NE — full course

10m/s from NE — full course

Previous sampled exits
Flexible line join

North of home (m)

L1: 339s; overrun 45.7m
Previous sampled exits: 319s; overrun 28.9m
Flexible line join: 319s; overrun 29.3m

L1: 361s; overrun 49.8m
Previous sampled exits: 338s; overrun 28.1m
Flexible line join: 332s; overrun 28.6m
5m/s from NE — WP12–14

L1: 413s; overrun 57.8m
Previous sampled exits: 401s; overrun 40.3m
Flexible line join: 367s; overrun 33.4m
10m/s from NE — WP12–14

East of home (m)
Calm — WP12–14
