DavidIngraham/ArduPilot-tinkering/scratch/paraglider-tests/pitch-joint/physics-review/actual-controller.pdf

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

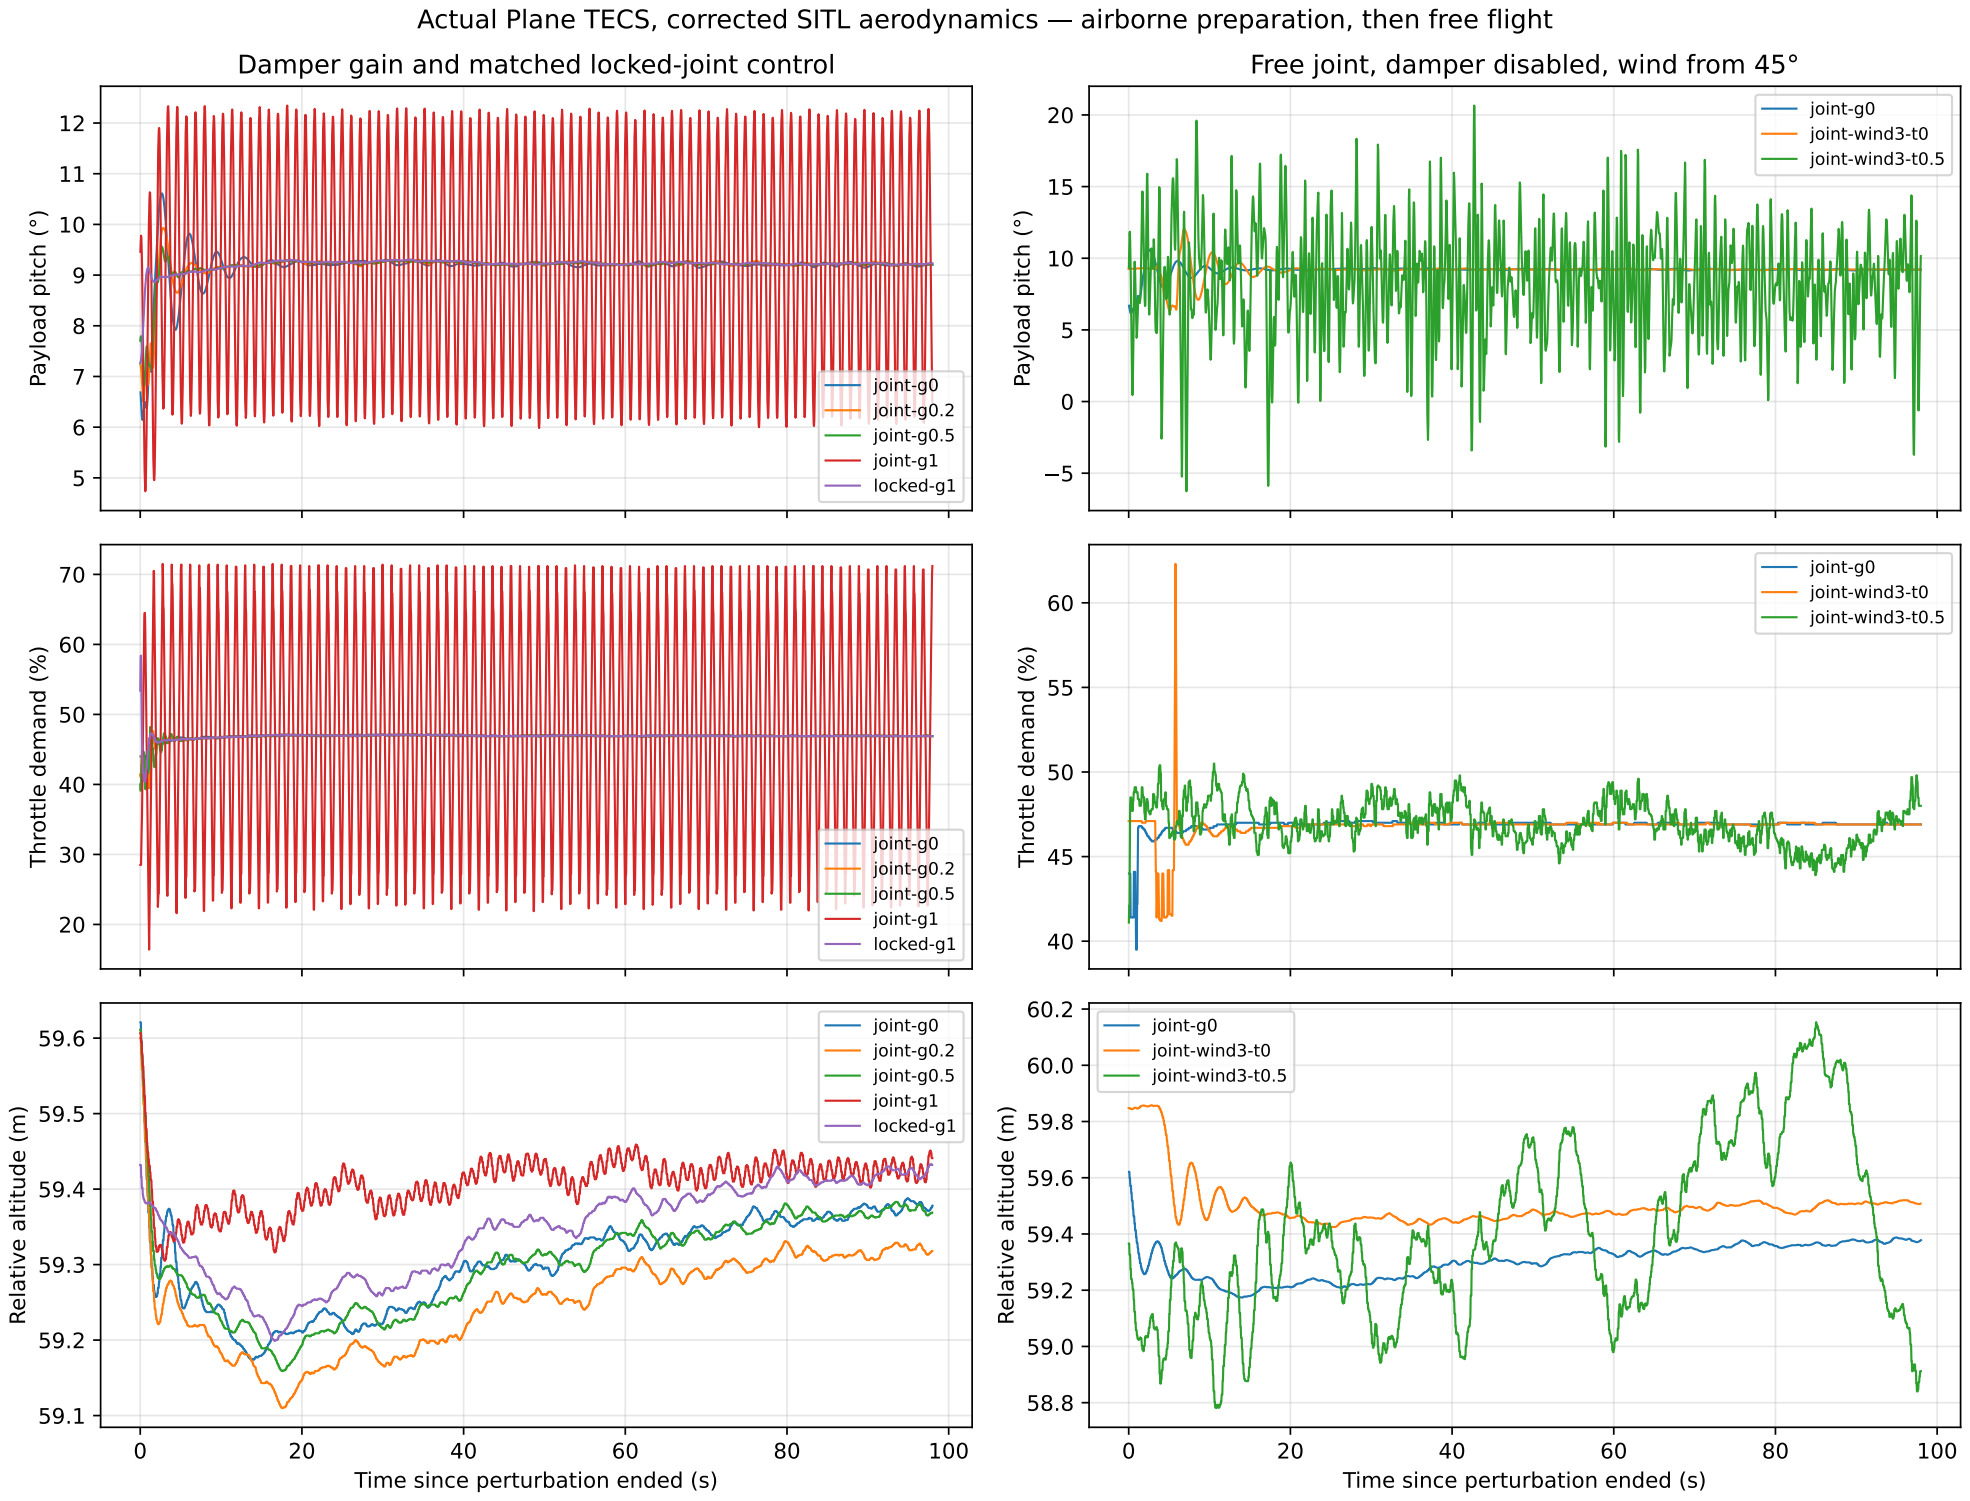
[picture p180: page 1]
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
