DavidIngraham/ArduPilot-tinkering/scratch/paraglider-tests/pitch-joint/physics-review/open-loop-response.pdf

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

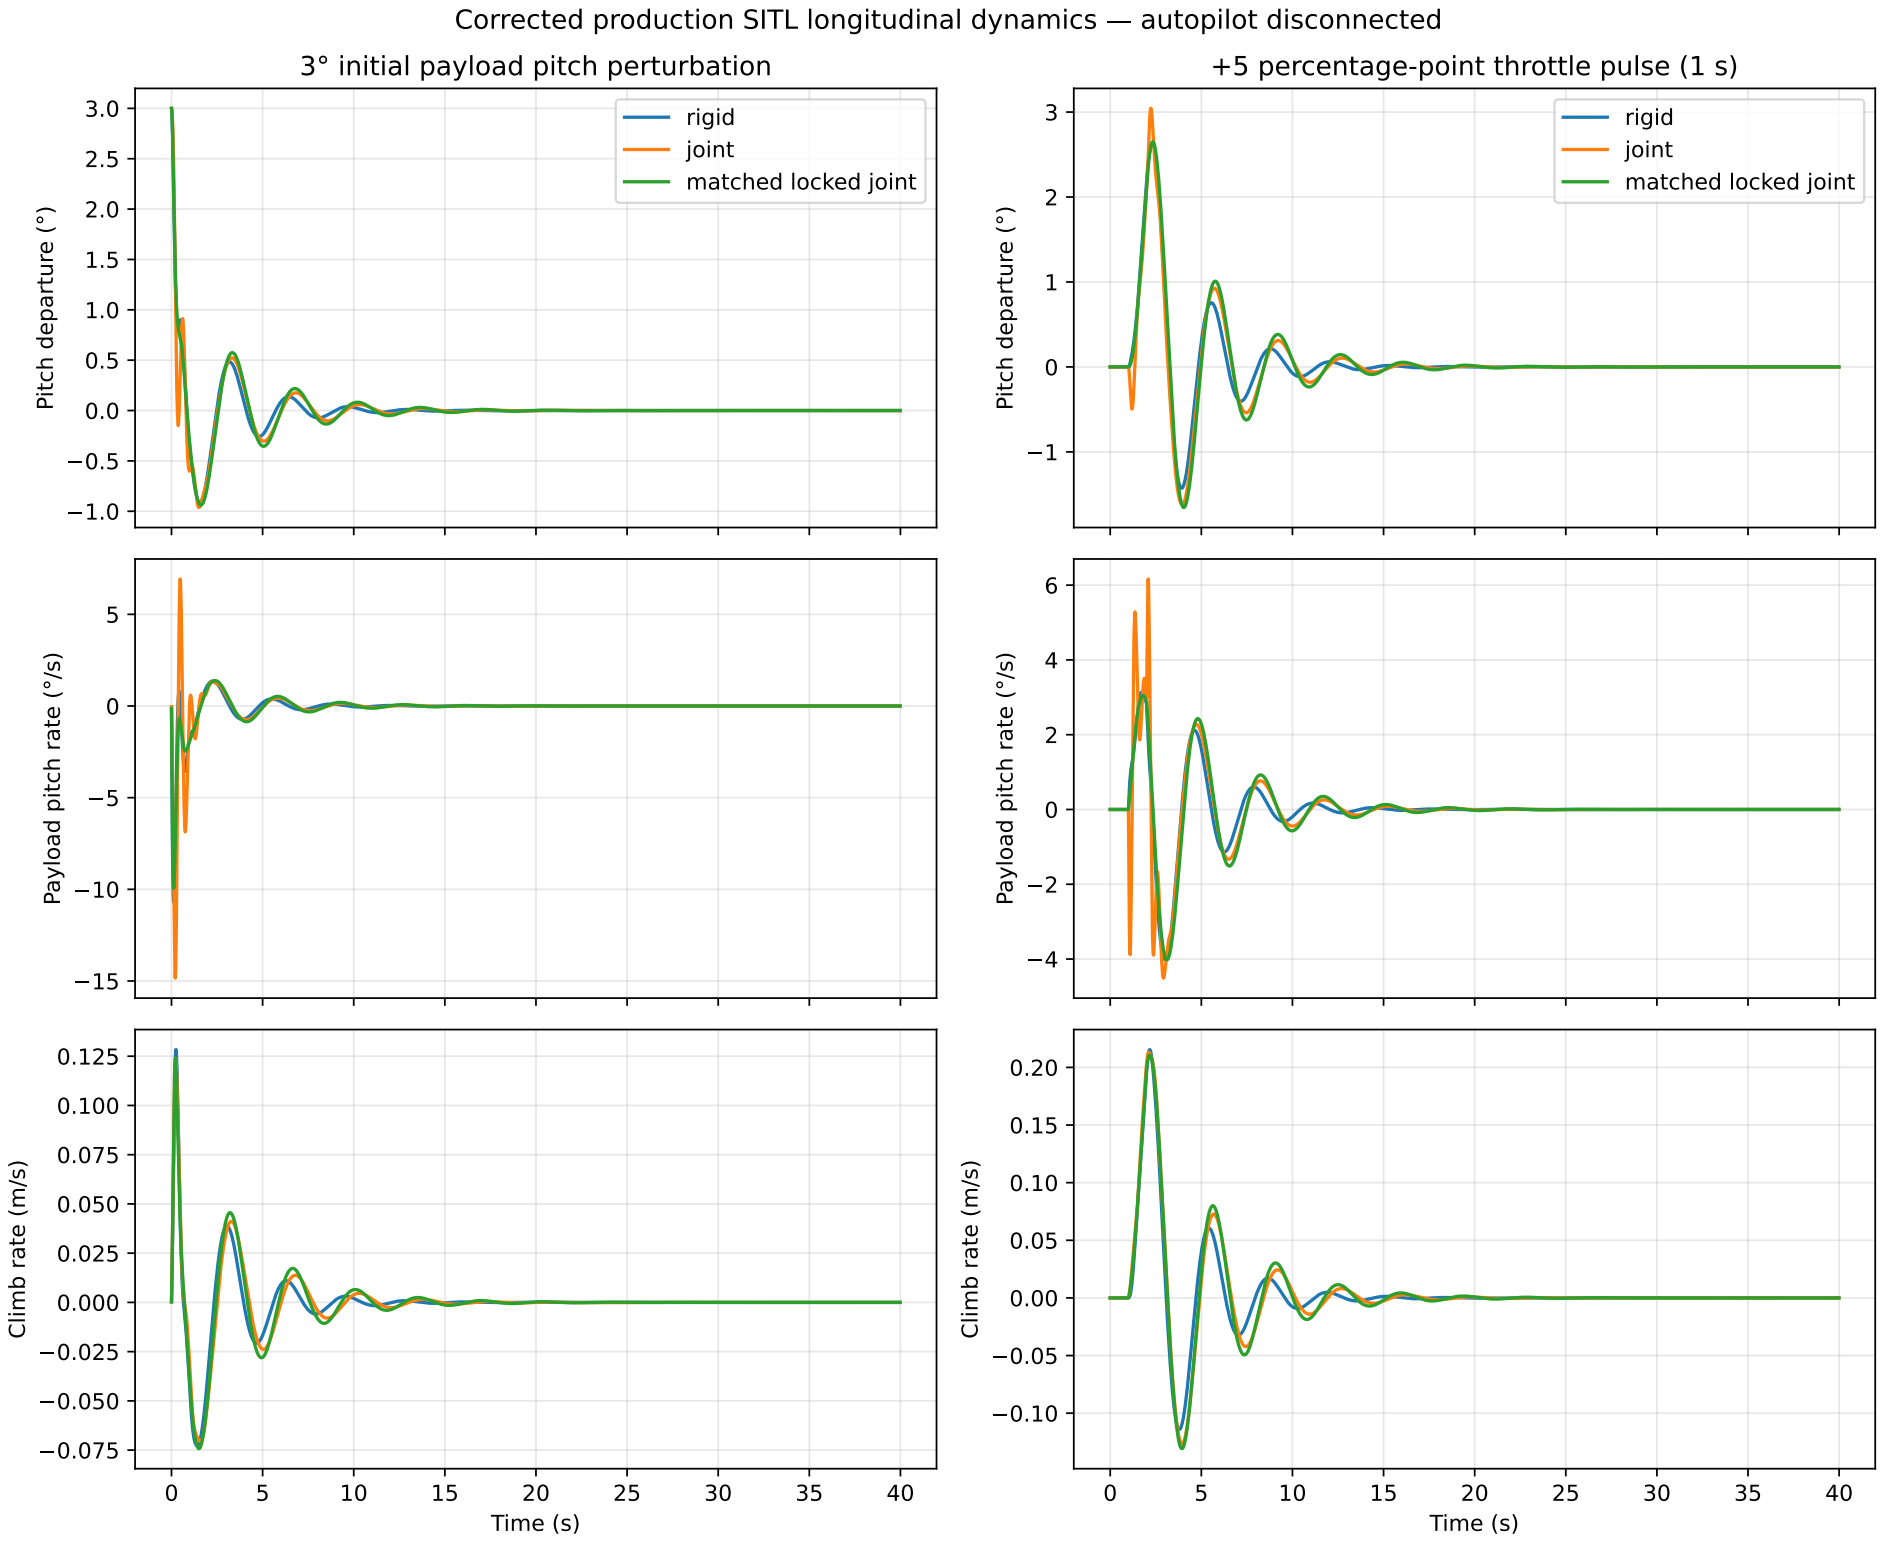
[picture p181: page 1]
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
