DavidIngraham/ArduPilot-tinkering/scratch/plane-trajectory/line-transition-comparison.pdf

0

250

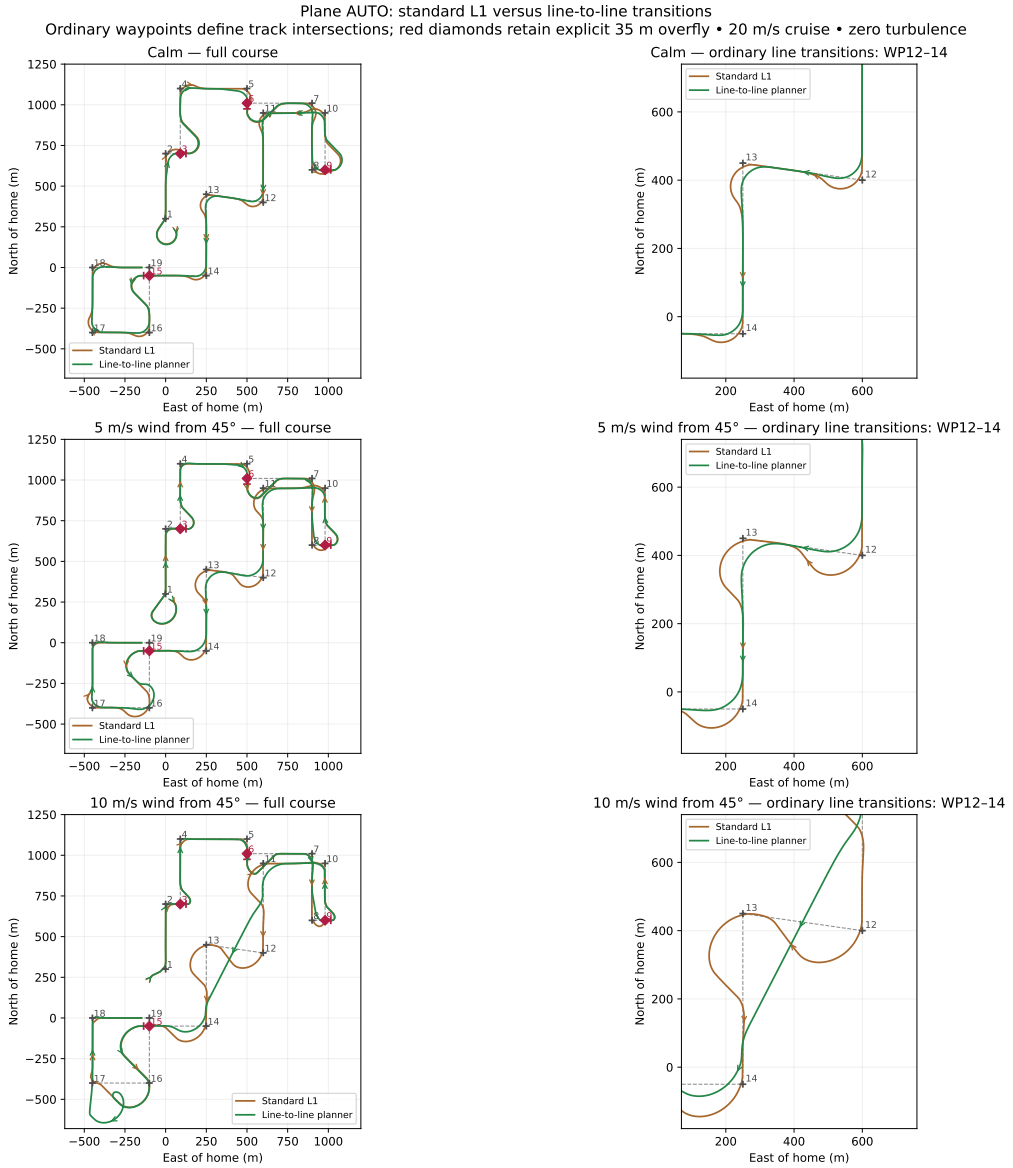
[picture p183: page 1]

Plane AUTO: standard L1 versus line-to-line transitions

Ordinary waypoints define track intersections; red diamonds retain explicit 35 m overfly • 20 m/s cruise • zero turbulence

Calm — full course

Calm — ordinary line transitions: WP12–14

Standard L1
Line-to-line planner

North of home (m)

Standard L1 Line-to-line planner

East of home (m)

5 m/s wind from 45° — full course

5 m/s wind from 45° — ordinary line transitions: WP12–14

10 m/s wind from 45° — full course

10 m/s wind from 45° — ordinary line transitions: WP12–14
