DavidIngraham/ArduPilot-tinkering/scratch/plane-trajectory/derived-settings/monte-carlo/gust-examples.pdf

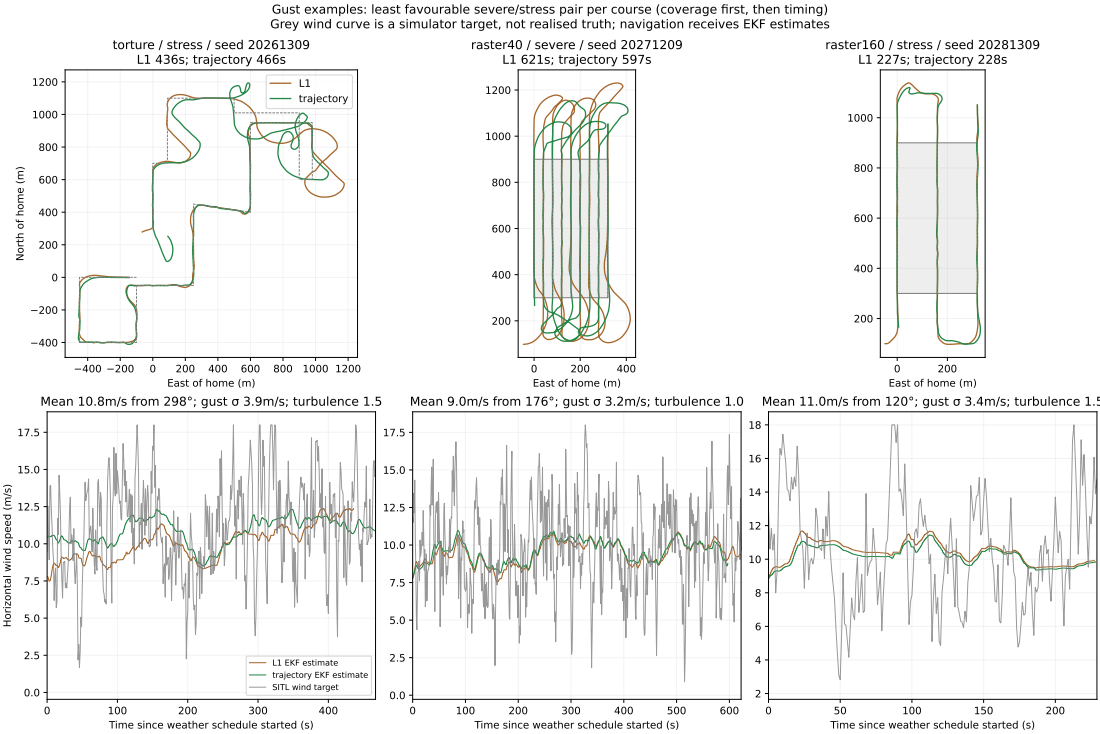
[picture p184: page 1]
raster40 / severe / seed 20271209 L1 621s; trajectory 597s; raster160 / stress / seed 20281309 L1 227s; trajectory 228s

Gust examples: least favourable severe/stress pair per course (coverage first, then timing)
Grey wind curve is a simulator target, not realised truth; navigation receives EKF estimates

torture / stress / seed 20261309
L1 436s; trajectory 466s

L1
trajectory

North of home (m)

Mean 10.8m/s from 298°; gust σ 3.9m/s; turbulence 1.5

East of home (m)

Mean 9.0m/s from 176°; gust σ 3.2m/s; turbulence 1.0

Mean 11.0m/s from 120°; gust σ 3.4m/s; turbulence 1.5

Horizontal wind speed (m/s)

L1 EKF estimate
trajectory EKF estimate
SITL wind target

Time since weather schedule started (s)
