DavidIngraham/ArduPilot-tinkering/scratch/plane-trajectory/derived-settings/regression/raster-comparison.pdf

1200

1400

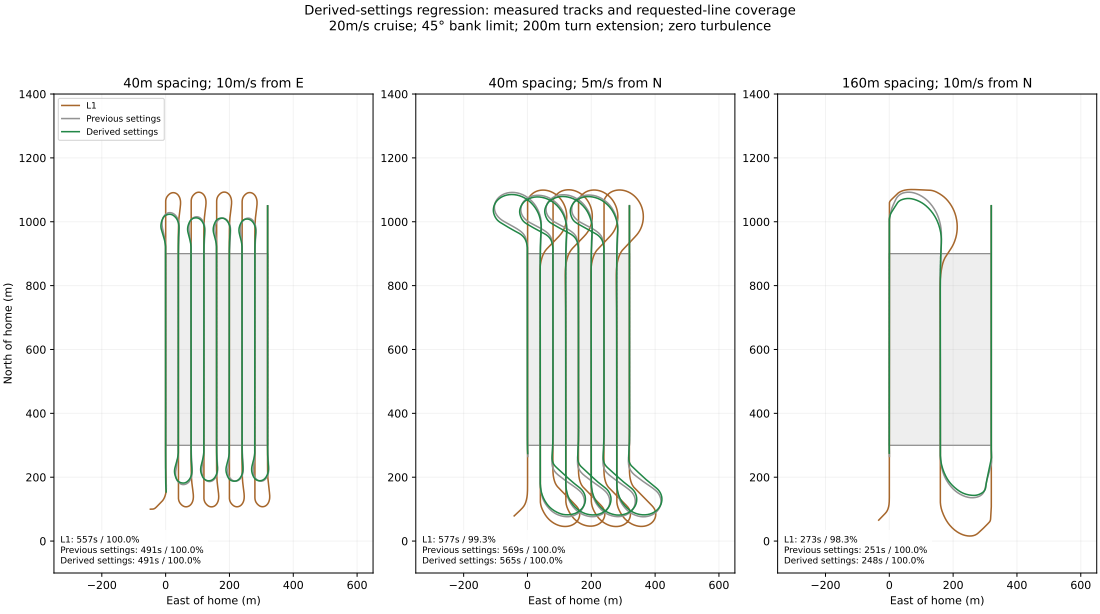
[picture p185: page 1]
L1: 557s / 100.0% Previous settings: 491s / 100.0% Derived settings: 491s / 100.0%; 40m spacing; 10m/s from E; L1 Previous settings Derived settings; L1: 577s / 99.3% Previous settings: 569s / 100.0% Derived settings: 565s / 100.0%; 40m spacing; 5m/s from N; L1: 273s / 98.3% Previous settings: 251s / 100.0% Derived settings: 248s / 100.0%; 160m spacing; 10m/s from N

Derived-settings regression: measured tracks and requested-line coverage
20m/s cruise; 45° bank limit; 200m turn extension; zero turbulence

North of home (m)

East of home (m)
