DavidIngraham/ArduPilot-tinkering/scratch/plane-trajectory/derived-settings/regression/torture-comparison.pdf

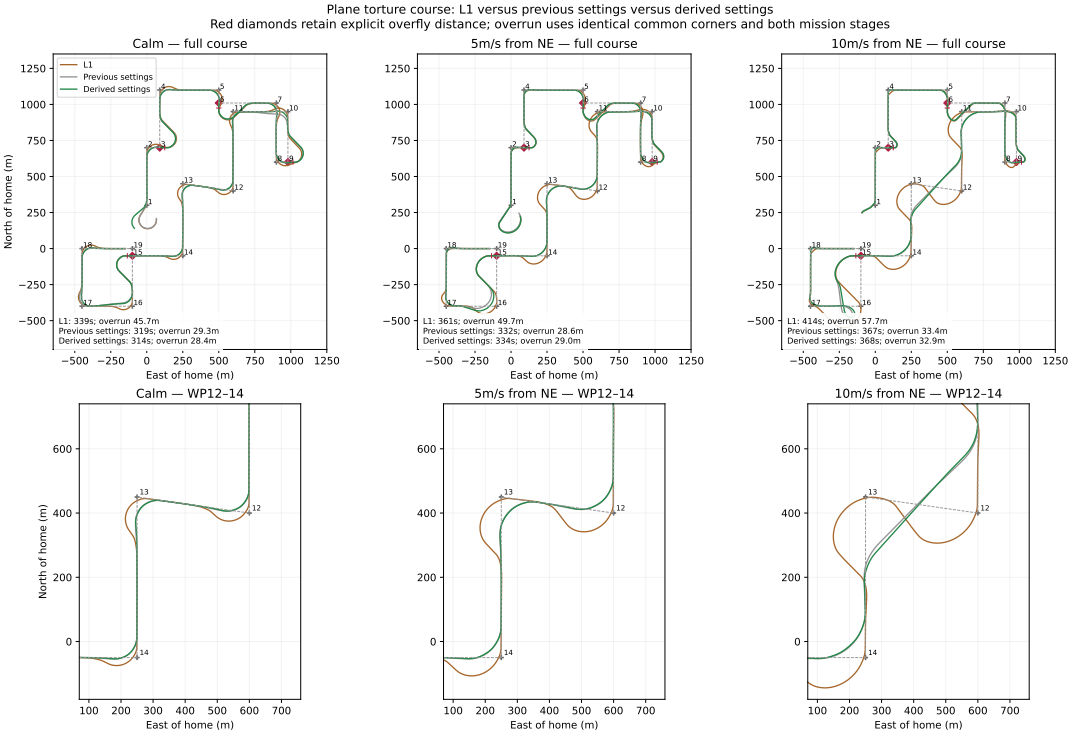
[picture p186: page 1]
L1 Previous settings Derived settings

Plane torture course: L1 versus previous settings versus derived settings

Red diamonds retain explicit overfly distance; overrun uses identical common corners and both mission stages

Calm — full course

5m/s from NE — full course

10m/s from NE — full course

North of home (m)

L1: 339s; overrun 45.7m
Previous settings: 319s; overrun 29.3m
Derived settings: 314s; overrun 28.4m

L1: 361s; overrun 49.7m
Previous settings: 332s; overrun 28.6m
Derived settings: 334s; overrun 29.0m
5m/s from NE — WP12–14

L1: 414s; overrun 57.7m
Previous settings: 367s; overrun 33.4m
Derived settings: 368s; overrun 32.9m
10m/s from NE — WP12–14

East of home (m)
Calm — WP12–14
