DavidIngraham/ArduPilot-tinkering/scratch/paraglider-tests/separation-2026-10-07/before/Tools/autotest/default_params/paraglider.parm

#Paraglider Specific
ARSPD_TYPE      0
AIRSPEED_CRUISE 5
SCALING_SPEED   5
AIRSPEED_STALL  3
AIRSPEED_MIN    5
AIRSPEED_MAX    7
SERVO1_FUNCTION 190
SERVO2_FUNCTION 191

# Disable Pitch controller
PTCH_RATE_D     0
PTCH_RATE_D_FF  0
PTCH_RATE_FF    0
PTCH_RATE_I,    0
PTCH_RATE_P     0
PTCH2SRV_RLL,   0

# Set up Pseudo Roll-Angle controller using Rate FF terms
RLL2SRV_RMAX     30
RLL2SRV_TCONST   0.400000
RLL_RATE_D       0.000000
RLL_RATE_D_FF    0.087500
RLL_RATE_FF      1.320000
RLL_RATE_FLTD    10.000000
RLL_RATE_FLTE    0.000000
RLL_RATE_FLTT    1.000000
RLL_RATE_I       0.000000
RLL_RATE_IMAX    0.660000
RLL_RATE_NEF     0
RLL_RATE_NTF     0
RLL_RATE_P       0.000000
RLL_RATE_PDMX    0.000000
RLL_RATE_SMAX    150.000000

# Disable Roll-Rate Controller
RLL_RATE_P      0
RLL_RATE_I      0
RLL_RATE_D      0

# L1 guidance and radii: validated by the extended paraglider AUTO mission
NAVL1_DAMPING   1.0
NAVL1_PERIOD    8
WP_RADIUS      22
WP_LOITER_RAD  25

# Enable TECS Paraglider
TECS_PG_ENABLE   1
TECS_PG_PR_FILT  10.000000
TECS_HDEM_TCONST 10.000000
TECS_CLMB_MAX    1.800000
TECS_SINK_MAX    3.000000
TECS_SINK_MIN    3.000000
TECS_PTCH_DAMP   0.200000

# Standard SITL Defaults
BATT_MONITOR    4
LOG_BITMASK	    65535
THR_MAX		    100
RC1_MAX         2000
RC1_MIN         1000
RC1_TRIM        1500
RC2_MAX         2000
RC2_MIN         1000
RC2_TRIM        1500
RC3_MAX         2000
RC3_MIN         1000
SERVO3_MIN      1000
SERVO3_MAX      2000
RC3_TRIM        1000
RC4_MAX         2000
RC4_MIN         1000
RC4_TRIM        1500
RC5_MAX         2000
RC5_MIN         1000
RC5_TRIM        1500
RC6_MAX         2000
RC6_MIN         1000
RC6_TRIM        1500
RC7_MAX         2000
RC7_MIN         1000
RC7_TRIM        1500
RC8_MAX         2000
RC8_MIN         1000
RC8_TRIM        1500
FLTMODE1        10
FLTMODE2        11
FLTMODE3        12
FLTMODE4        5
FLTMODE5        2
FLTMODE6        0
FLTMODE_CH      8

# we need small INS_ACC offsets so INS is recognised as being calibrated
INS_ACCOFFS_X   0.001
INS_ACCOFFS_Y   0.001
INS_ACCOFFS_Z   0.001
INS_ACCSCAL_X   1.001
INS_ACCSCAL_Y   1.001
INS_ACCSCAL_Z   1.001
INS_ACC2OFFS_X   0.001
INS_ACC2OFFS_Y   0.001
INS_ACC2OFFS_Z   0.001
INS_ACC2SCAL_X   1.001
INS_ACC2SCAL_Y   1.001
INS_ACC2SCAL_Z   1.001
INS_GYR_CAL      0
