DavidIngraham/ArduPilot-tinkering/tools/draw_control_loops.py

from pathlib import Path
out = Path(__file__).resolve().parents[1] / 'docs/assets/control-loops'
out.mkdir(parents=True, exist_ok=True)
import matplotlib
matplotlib.use('Agg')
import matplotlib.pyplot as plt
from matplotlib.patches import Rectangle, Circle, FancyArrowPatch
fig,ax=plt.subplots(figsize=(16,7.7))
ax.set(xlim=(0,16),ylim=(0,7.7)); ax.axis('off'); fig.patch.set_facecolor('white')
ink='#213747'
def text(x,y,s,size=12,**kw): ax.text(x,y,s,ha='center',va='center',fontsize=size,color=ink,**kw)
def box(x,y,w,h,label,fill='#eff4f7'):
 ax.add_patch(Rectangle((x-w/2,y-h/2),w,h,facecolor=fill,edgecolor=ink,lw=1.4));text(x,y,label)
def wire(points,arrow=True):
 for a,b in zip(points[:-2],points[1:-1]):ax.plot([a[0],b[0]],[a[1],b[1]],color=ink,lw=1.4)
 a,b=points[-2:]
 ax.add_patch(FancyArrowPatch(a,b,arrowstyle='-|>' if arrow else '-',mutation_scale=13,color=ink,lw=1.4,shrinkA=0,shrinkB=0))
def dot(x,y):ax.plot(x,y,'o',color=ink,ms=4)
def summ(x,y):ax.add_patch(Circle((x,y),.19,facecolor='#fff3ce',edgecolor=ink,lw=1.4));text(x,y,r'$\Sigma$',13)
text(8,7.3,'3. Current lateral controller — native SITL candidate',19,weight='bold')
text(8,6.85,'Heading-rate feedback with feedforward and a separate roll-rate damping path',12)
box(1.25,4.35,1.7,1.05,'Guidance\n→ heading rate')
wire([(.05,4.35),(.4,4.35)]);text(.7,5.1,'Bank-command\nencoding',10)
box(3.2,4.35,1.7,1.05,'Target shaping\n±25°/s; 40°/s²\nτ = 0.1 s')
wire([(2.1,4.35),(2.35,4.35)]);wire([(4.05,4.35),(4.86,4.35)]);dot(4.4,4.35)
text(4.45,4.75,r'$\dot\psi_c$',15)
summ(5.05,4.35);text(4.77,4.58,'+',12);text(4.81,4.04,'−',14)
wire([(5.24,4.35),(5.8,4.35)],False);dot(5.8,4.35);text(5.58,4.65,'e',13)
box(7.4,4.35,1.9,.65,r'$K_P S_v = 0.005 S_v$')
wire([(5.8,4.35),(6.45,4.35)]);wire([(8.35,4.35),(9.91,4.35)])
box(7.4,3.05,1.9,.8,'Kᵢ / s = 0.002 / s\nI limit: ±0.15')
wire([(5.8,4.35),(5.8,3.05),(6.45,3.05)])
wire([(8.35,3.05),(9.45,3.05),(9.45,4.12),(9.96,4.22)])
box(7.4,5.75,1.9,.65,r'$K_{FF} S_v = 0.009 S_v$')
wire([(4.4,4.35),(4.4,5.75),(6.45,5.75)])
wire([(8.35,5.75),(10.1,5.75),(10.1,4.54)])
summ(10.1,4.35);text(9.83,4.6,'+',12);text(10.33,4.65,'+',12);text(9.85,4.02,'+',12);text(10.35,4.05,'−',14)
box(11.25,4.35,1.25,.9,'Saturate\n−1 ≤ u ≤ 1')
wire([(10.29,4.35),(10.625,4.35)])
box(12.9,4.35,1.5,1.05,'Brake mixer\n+ servos')
wire([(11.875,4.35),(12.15,4.35)])
box(14.65,4.35,1.5,1.05,'Canopy\n+ payload')
wire([(13.65,4.35),(13.9,4.35)])
wire([(15.4,4.35),(15.8,4.35),(15.8,1.0),(12.0,1.0)])
wire([(9.2,1.0),(5.05,1.0),(5.05,4.16)])
box(10.6,1.0,2.8,.75,'Heading-rate estimate\n4 Hz low-pass')
text(13.5,1.35,r'$\dot\psi = (q\sin\phi+r\cos\phi)/\cos\theta$',12)
wire([(14.65,3.825),(14.65,2.1),(14.2,2.1)])
text(14.95,2.7,'p',14)
wire([(11.2,2.1),(10.1,2.1),(10.1,4.16)])
box(13.75,2.1,.9,.85,'Low-pass\n4 Hz')
box(12.7,2.1,.9,.85,'Gain\n0.003')
box(11.65,2.1,.9,.85,'Speed\nscale Sᵥ')
wire([(13.3,2.1),(13.15,2.1)])
wire([(12.25,2.1),(12.1,2.1)])
text(7.8,2.32,'Conditional integration\nprevents windup at output limits',10)
text(8,.32,'Rates in °/s   •   Sᵥ ≈ 5 / airspeed (bounded)   •   Heading-acceleration feedforward disabled (D_FF = 0)',11)
fig.tight_layout(pad=.4)
fig.savefig(str(out) + '/current-lateral.png',dpi=170,bbox_inches='tight')
fig.savefig(str(out) + '/current-lateral.svg',bbox_inches='tight')
# Earlier architectures: simplified signal paths corresponding to the notebook.
plt.close(fig)
fig,ax=plt.subplots(figsize=(16,6.5));ax.set(xlim=(0,16),ylim=(0,6.5));ax.axis('off');fig.patch.set_facecolor('white')
text(8,6,'1. The original ArduPlane roll architecture',19,weight='bold')
text(8,5.55,'Bank-angle outer loop and roll-rate inner loop — simplified signal paths',12)
text(.55,3.4,r'$\phi_c$',16);wire([(.9,3.4),(1.61,3.4)]);summ(1.8,3.4);text(1.53,3.67,'+',12);text(1.55,3.1,'−',14)
box(3.25,3.4,1.7,.8,'Angle gain\n1 / τ');wire([(1.99,3.4),(2.4,3.4)])
box(5.1,3.4,1.6,.8,'Rate target\nfilter / limits');wire([(4.1,3.4),(4.3,3.4)])
wire([(5.9,3.4),(6.71,3.4)]);dot(6.2,3.4);text(6.2,3.82,r'$p_c$',15)
summ(6.9,3.4);text(6.65,3.65,'+',12);text(6.65,3.1,'−',14)
box(8.7,3.4,2,.8,'Roll-rate feedback\nP + I/s + D s');wire([(7.09,3.4),(7.7,3.4)]);wire([(9.7,3.4),(10.61,3.4)])
box(8.7,4.65,2,.65,'Rate feedforward');wire([(6.2,3.4),(6.2,4.65),(7.7,4.65)]);wire([(9.7,4.65),(10.8,4.65),(10.8,3.59)])
summ(10.8,3.4);text(10.55,3.65,'+',12);text(11.04,3.7,'+',12)
box(12.1,3.4,1.6,.8,'Output /\nactuators');wire([(10.99,3.4),(11.3,3.4)])
box(14.05,3.4,1.7,.8,'Aircraft');wire([(12.9,3.4),(13.2,3.4)])
wire([(14.05,3),(14.05,2),(10,2)]);box(9,2,2,.65,'Measured roll rate p');wire([(8,2),(6.9,2),(6.9,3.21)])
wire([(14.9,3.4),(15.4,3.4),(15.4,.85),(9,.85)]);box(7.7,.85,2.6,.65,'Measured bank angle φ');wire([(6.4,.85),(1.8,.85),(1.8,3.21)])
text(8,.2,'Conceptual architecture; detailed speed scaling, derivative feedforward and actuator limits omitted.',11)
fig.tight_layout(pad=.4)
for ext in ['png','svg']:fig.savefig(str(out) + '/original-roll.'+ext,dpi=170,bbox_inches='tight')
plt.close(fig)
fig,ax=plt.subplots(figsize=(16,5.5));ax.set(xlim=(0,16),ylim=(0,5.5));ax.axis('off');fig.patch.set_facecolor('white')
text(8,5,'2. The flight controller: rate feedforward becomes angle feedback',19,weight='bold')
text(8,4.55,'Inner rate P, I and D disabled; bank-angle feedback remains',12)
text(.55,2.9,r'$\phi_c$',16);wire([(.9,2.9),(1.61,2.9)]);summ(1.8,2.9);text(1.53,3.17,'+',12);text(1.55,2.6,'−',14)
box(3.3,2.9,1.7,.8,'Angle gain\n1 / τ');wire([(1.99,2.9),(2.45,2.9)])
box(5.3,2.9,1.8,.8,'Target shaping\nfilter / limits');wire([(4.15,2.9),(4.4,2.9)])
box(8,2.9,2.8,.8,'FF + optional D_FF × s\nwith speed scaling');wire([(6.2,2.9),(6.6,2.9)])
box(10.85,2.9,2,.8,'Brake mixer\n+ servos');wire([(9.4,2.9),(9.85,2.9)])
box(13.4,2.9,2,.8,'Canopy + payload');wire([(11.85,2.9),(12.4,2.9)])
wire([(14.4,2.9),(15.2,2.9),(15.2,1.35),(9.3,1.35)]);box(8,1.35,2.6,.65,'Measured bank angle φ');wire([(6.7,1.35),(1.8,1.35),(1.8,2.71)])
text(8,.65,'Hood River: FF 0.345, D_FF 0   →   Trout Lake: FF 1.0, D_FF 0.05   (τ = 1 s)',12)
text(8,.15,'With D_FF = 0, unity speed scaling and no filter / limits: u = (KFF / τ) (φc − φ).',11)
fig.tight_layout(pad=.4)
for ext in ['png','svg']:fig.savefig(str(out) + '/flight-angle-workaround.'+ext,dpi=170,bbox_inches='tight')
for path in out.glob('*.svg'):
 path.write_text('\n'.join(line.rstrip() for line in path.read_text().splitlines()) + '\n')
