DavidIngraham/ArduPilot-tinkering/scratch/paraglider-tests/separation-2026-10-07/durable-arduplane.py

'''
Fly ArduPlane in SITL

AP_FLAKE8_CLEAN
'''

import csv
import json
import math
import operator
import os
import re
import signal
import time

from pymavlink import mavextra
from pymavlink import mavutil
from pymavlink import quaternion
from pymavlink.rotmat import Vector3

import vehicle_test_suite

from pysim import util
from pysim import vehicleinfo
from vehicle_test_suite import MAV_POS_TARGET_TYPE_MASK
from vehicle_test_suite import AltFrame
from vehicle_test_suite import AutoTestTimeoutException
from vehicle_test_suite import Location
from vehicle_test_suite import NotAchievedException
from vehicle_test_suite import OldpymavlinkException
from vehicle_test_suite import PreconditionFailedException
from vehicle_test_suite import Test
from vehicle_test_suite import WaitModeTimeout

# get location of scripts
testdir = os.path.dirname(os.path.realpath(__file__))
SITL_START_LOCATION = Location(-35.362938, 149.165085, 585, AltFrame.ABSOLUTE)
SITL_START_HEADING = 354
WIND = "0,180,0.2"  # speed,direction,variance


class AutoTestPlane(vehicle_test_suite.TestSuite):
    @staticmethod
    def get_not_armable_mode_list():
        return []

    @staticmethod
    def get_not_disarmed_settable_modes_list():
        return ["FOLLOW"]

    @staticmethod
    def get_no_position_not_settable_modes_list():
        return []

    @staticmethod
    def get_position_armable_modes_list():
        return ["GUIDED", "AUTO"]

    @staticmethod
    def get_normal_armable_modes_list():
        return ["MANUAL", "STABILIZE", "ACRO"]

    def log_name(self):
        return "ArduPlane"

    def test_filepath(self):
        return os.path.realpath(__file__)

    def sitl_start_location(self):
        return SITL_START_LOCATION

    def sitl_start_heading(self):
        return SITL_START_HEADING

    def set_current_test_name(self, name):
        self.current_test_name_directory = "ArduPlane_Tests/" + name + "/"

    def default_frame(self):
        return "plane-elevrev"

    def is_plane(self):
        return True

    def get_stick_arming_channel(self):
        return int(self.get_parameter("RCMAP_YAW"))

    def get_disarm_delay(self):
        return int(self.get_parameter("LAND_DISARMDELAY"))

    def set_autodisarm_delay(self, delay):
        self.set_parameter("LAND_DISARMDELAY", delay)

    def start_flying_mission(self, filename: str) -> None:
        self.progress(f"Flying mission {filename}")
        self.load_mission(filename)
        self.change_mode('AUTO')
        self.wait_ready_to_arm()
        self.arm_vehicle()

    def takeoff(self, alt=150, alt_max=None, relative=True, mode=None, timeout=None):
        """Takeoff to altitude."""

        if mode == "TAKEOFF":
            return self.takeoff_in_TAKEOFF(alt=alt, relative=relative, timeout=timeout)

        if mode == "QHOVER":
            return self.takeoff_in_QHOVER(alt=alt, relative=relative, timeout=timeout)

        return self.takeoff_in_FBWA(alt=alt, alt_max=alt_max, relative=relative, timeout=timeout)

    def paraglider_takeoff(self, altitude=60):
        '''Start the paraglider model and launch with the simulated throw assist'''
        self.customise_SITL_commandline(
            [],
            model='paraglider-throw',
            defaults_filepath=self.model_defaults_filepath('paraglider'),
            wipe=True,
        )
        self.set_rc_default()
        self.assert_parameter_values({
            'TECS_PG_ENABLE': 1,
            'SERVO1_FUNCTION': 190,
            'SERVO2_FUNCTION': 191,
        })
        self.set_parameters({
            'TKOFF_ALT': altitude,
            'SERVO7_FUNCTION': 0,
        })
        self.change_mode('TAKEOFF')
        self.wait_ready_to_arm()
        self.arm_vehicle()
        self.set_rc(3, 2000)
        self.set_servo(7, 2000)
        self.wait_altitude(altitude - 5, altitude + 10, relative=True, timeout=120)
        self.set_servo(7, 1000)

    def ParagliderAutoMission(self):
        """Fly an extended AUTO route with altitude changes and opposing two-turn loiters"""
        self.paraglider_takeoff(altitude=60)
        self.change_mode('FBWB')
        self.set_rc_from_map({1: 1500, 2: 1500, 3: 1500, 4: 1500})
        self.wait_altitude(45, 75, relative=True, minimum_duration=15, timeout=60)
        waypoint_radius = self.get_parameter('WP_RADIUS')
        loiter_radius = abs(self.get_parameter('WP_LOITER_RAD'))
        self.set_parameters({'WP_RADIUS': waypoint_radius, 'WP_MAX_RADIUS': 0, 'WP_LOITER_RAD': loiter_radius,
                             'SIM_WIND_SPD': 0, 'SIM_WIND_TURB': 0})
        navigation_parameters = self.get_parameters(['NAVL1_DAMPING', 'NAVL1_PERIOD'])
        waypoint = mavutil.mavlink.MAV_CMD_NAV_WAYPOINT
        turns = mavutil.mavlink.MAV_CMD_NAV_LOITER_TURNS
        unlimited = mavutil.mavlink.MAV_CMD_NAV_LOITER_UNLIM
        route = [
            (waypoint, 250, 0, 60),
            (waypoint, 650, 0, 90),
            (turns, 650, 400, 90),
            (waypoint, 250, 400, 60),
            (waypoint, 250, 0, 45),
            (waypoint, -150, 0, 45),
            (waypoint, -150, -400, 75),
            (turns, 250, -400, 75),
            (waypoint, 650, -400, 55),
            (waypoint, 650, 0, 55),
            (waypoint, 250, 0, 60),
            # Nonzero offsets avoid the current-position interpretation.
            (unlimited, 1, 1, 60),
        ]
        mission = self.create_simple_relhome_mission(route)
        # Scale the tested 90-degree acceptance distance by corner angle.
        # Explicit acceptance avoids the L1 lookahead cap on WP_RADIUS.
        # Straight-through items keep zero.
        acceptance_radii = {}
        for seq, item in enumerate(mission[1:], 1):
            if item.command != waypoint:
                continue
            previous = route[seq - 2][1:3] if seq > 1 else (0, 0)
            corner = route[seq - 1][1:3]
            following = route[seq][1:3]
            incoming = (corner[0] - previous[0], corner[1] - previous[1])
            outgoing = (following[0] - corner[0], following[1] - corner[1])
            angle = math.atan2(abs(incoming[0]*outgoing[1] - incoming[1]*outgoing[0]),
                               incoming[0]*outgoing[0] + incoming[1]*outgoing[1])
            if angle >= math.radians(1):
                lead = waypoint_radius * math.tan(angle / 2)
                # Preserve enough leg length for successive corner transitions.
                if lead >= 0.5 * min(math.hypot(*incoming), math.hypot(*outgoing)):
                    raise NotAchievedException('Mission corner too tight for achievable turn rate')
                item.param2 = math.ceil(lead)
            acceptance_radii[seq] = item.param2
        for seq, radius in ((3, loiter_radius), (8, -loiter_radius)):
            mission[seq].param1 = 2
            mission[seq].param3 = radius
        mission[-1].param3 = loiter_radius
        self.check_mission_upload_download(mission)
        home = self.home_position_as_location()
        targets = {seq: self.offset_location_ne(home, north, east)
                   for seq, (_, north, east, _) in enumerate(route, 1)}
        metrics = {seq: {'closest_distance_m': None, 'altitude_at_closest_m': None,
                         'circle_angle_rad': 0.0, 'last_circle_angle_rad': None,
                         'next_track_overshoot_m': None}
                   for seq in targets}
        rows = []

        def observe(mav, message):
            if message.get_type() == 'ATTITUDE':
                if not all(math.isfinite(value) for value in (
                        message.roll, message.pitch, message.yaw,
                        message.rollspeed, message.pitchspeed, message.yawspeed)):
                    raise NotAchievedException('Non-finite extended mission attitude')
            if message.get_type() != 'GLOBAL_POSITION_INT':
                return
            altitude = message.relative_alt * 0.001
            if not 20 <= altitude <= 130:
                raise NotAchievedException('Extended mission exceeded altitude bounds')
            current = mav.messages.get('MISSION_CURRENT')
            attitude = mav.messages.get('ATTITUDE')
            servos = mav.messages.get('SERVO_OUTPUT_RAW')
            navigation = mav.messages.get('NAV_CONTROLLER_OUTPUT')
            if current is None or attitude is None or servos is None or navigation is None:
                return
            seq = current.seq
            if seq not in targets:
                return
            here = Location(message.lat * 1.0e-7, message.lon * 1.0e-7,
                            message.alt * 0.001, AltFrame.ABSOLUTE)
            distance = self.get_distance(targets[seq], here)
            metric = metrics[seq]
            if metric['closest_distance_m'] is None or distance < metric['closest_distance_m']:
                metric['closest_distance_m'] = distance
                metric['altitude_at_closest_m'] = altitude
            # Measure crossing beyond the outgoing track during each clean
            # 90-degree corner, including the following leg's turn transient.
            corner = seq - 1
            if corner in (4, 5, 6, 9, 10):
                _, an, ae, _ = route[corner - 2]
                _, bn, be, _ = route[corner - 1]
                _, cn, ce, _ = route[corner]
                north = math.radians(here.lat - home.lat) * 6371000
                east = math.radians(here.lng - home.lng) * 6371000 * math.cos(math.radians(home.lat))
                dn, de = bn - an, be - ae
                on, oe = cn - bn, ce - be
                along_out = ((north - bn) * on + (east - be) * oe) / math.hypot(on, oe)
                if -150 <= along_out <= 150:
                    overrun = ((north - bn) * dn + (east - be) * de) / math.hypot(dn, de)
                    previous = metrics[corner]['next_track_overshoot_m']
                    metrics[corner]['next_track_overshoot_m'] = max(previous or 0, overrun)
            if seq in (3, 8):
                # Exclude the approach: count angular travel only near the orbit.
                if 0.5 * loiter_radius <= distance <= (5.0 / 3.0) * loiter_radius:
                    angle = math.radians(self.get_bearing(targets[seq], here))
                    previous = metric['last_circle_angle_rad']
                    if previous is not None:
                        metric['circle_angle_rad'] += (angle - previous + math.pi) % (2 * math.pi) - math.pi
                    metric['last_circle_angle_rad'] = angle
                else:
                    metric['last_circle_angle_rad'] = None
            rows.append((seq, message.time_boot_ms * 0.001, here.lat, here.lng,
                         altitude, distance, math.hypot(message.vx, message.vy) * 0.01,
                         attitude.roll, attitude.pitch, attitude.yawspeed,
                         servos.servo1_raw, servos.servo2_raw, servos.servo3_raw,
                         navigation.nav_roll, navigation.xtrack_error))

        for message in ('GLOBAL_POSITION_INT', 'ATTITUDE', 'SERVO_OUTPUT_RAW',
                        'MISSION_CURRENT', 'NAV_CONTROLLER_OUTPUT'):
            self.set_message_rate_hz(message, 10)
        filename = self.buildlogs_path('ParagliderAutoMission.csv')
        self.install_message_hook(observe)
        try:
            self.set_current_waypoint(1)
            self.change_mode('AUTO')
            speed = self.get_parameter('AIRSPEED_CRUISE')
            for seq, (command, _, _, altitude) in enumerate(route[:-1], 1):
                self.start_subtest('AUTO item %u at %u metres' % (seq, altitude))
                self.wait_current_waypoint(seq, timeout=30)
                timeout = 90 + self.distance_to_nav_target() / speed
                if command == turns:
                    timeout += 2 * 2 * math.pi * loiter_radius / speed + 120
                self.wait_current_waypoint(seq + 1, timeout=timeout)
                metric = metrics[seq]
                if command == waypoint:
                    # Record proximity without forcing a tight acquisition:
                    # normal Plane navigation may advance across the finish line.
                    if metric['closest_distance_m'] is None:
                        raise NotAchievedException('No track samples for mission waypoint %u' % seq)
                    if abs(metric['altitude_at_closest_m'] - altitude) > 12:
                        raise NotAchievedException('Wrong altitude at extended mission waypoint %u' % seq)
                else:
                    direction = 1 if seq == 3 else -1
                    if direction * metric['circle_angle_rad'] < 1.5 * 2 * math.pi:
                        raise NotAchievedException('Insufficient correctly directed loiter turns at item %u' % seq)
                self.assert_mode('AUTO')
                self.assert_armed()
            for corner in (4, 5, 6, 9, 10):
                overrun = metrics[corner]['next_track_overshoot_m']
                if overrun is None or overrun > 4:
                    raise NotAchievedException('Excessive next-track overshoot at corner %u: %s' % (corner, overrun))
            self.start_subtest('Sustained home loiter after extended mission')
            self.wait_distance_to_home(0, 1.5 * loiter_radius, minimum_duration=30, timeout=180)
            self.wait_altitude(48, 72, relative=True, minimum_duration=15, timeout=60)
            self.assert_mode('AUTO')
            self.assert_armed()
        finally:
            self.remove_message_hook(observe)
            with open(filename, 'w', newline='') as output:
                writer = csv.writer(output)
                writer.writerow(('seq', 'time_s', 'latitude_deg', 'longitude_deg',
                                 'relative_alt_m', 'target_distance_m', 'groundspeed_mps',
                                 'roll_rad', 'pitch_rad', 'yaw_rate_radps',
                                 'left_brake_pwm', 'right_brake_pwm', 'throttle_pwm',
                                 'nav_roll_deg', 'nav_cross_track_error_m'))
                writer.writerows(rows)
            with open(filename + '.json', 'w') as output:
                json.dump(dict(route=route, metrics=metrics, home_lat=home.lat,
                               home_lng=home.lng, waypoint_radius_m=waypoint_radius, waypoint_max_radius_m=0,
                               waypoint_acceptance_radius_m=acceptance_radii,
                               loiter_radius_m={3: loiter_radius, 8: -loiter_radius, 12: loiter_radius},
                               navigation_parameters=navigation_parameters,
                               roll_gains=self.get_parameters(['RLL_RATE_FF', 'RLL_RATE_D_FF',
                                                              'RLL2SRV_TCONST'])), output, indent=2)
            self.progress('Extended paraglider mission track: %s' % filename)
        self.reset_SITL_commandline()

    def takeoff_in_QHOVER(self, alt=20, relative=True, timeout=None):
        '''VTOL climb to altitude in QHOVER'''
        self.change_mode("QHOVER")
        self.wait_ready_to_arm()
        self.arm_vehicle()
        self.set_rc(3, 1700)  # throttle up to climb
        self.wait_altitude(alt-2, alt+3, relative=relative, timeout=timeout)
        self.set_rc(3, 1500)  # neutral throttle holds altitude in QHOVER

    def takeoff_in_TAKEOFF(self, alt=150, relative=True, mode=None, alt_epsilon=2, timeout=None):
        if relative is not True:
            raise ValueError("Only relative alt supported ATM")
        self.change_mode("TAKEOFF")
        self.context_push()
        self.set_parameter('TKOFF_ALT', alt)
        self.wait_ready_to_arm()
        self.arm_vehicle()
        self.wait_altitude(alt-alt_epsilon, alt+alt_epsilon, relative=True, timeout=timeout)
        self.context_pop()

    def takeoff_in_FBWA(self, alt=150, alt_max=None, relative=True, mode=None, timeout=30):
        if alt_max is None:
            alt_max = alt + 30

        self.change_mode("FBWA")

        self.wait_ready_to_arm()
        self.arm_vehicle()

        # some rudder to counteract the prop torque
        self.set_rc(4, 1700)

        # some up elevator to keep the tail down
        self.set_rc(2, 1200)

        # get it moving a bit first
        self.set_rc(3, 1300)
        self.wait_groundspeed(6, 100)

        # a bit faster again, straighten rudder
        self.set_rc_from_map({
            3: 1600,
            4: 1500,
        })
        self.wait_groundspeed(12, 100)

        # hit the gas harder now, and give it some more elevator
        self.set_rc_from_map({
            2: 1100,
            3: 2000,
        })

        # gain a bit of altitude
        self.wait_altitude(alt, alt_max, timeout=timeout, relative=relative)

        # level off
        self.set_rc(2, 1500)

        self.progress("TAKEOFF COMPLETE")

    def fly_left_circuit(self):
        """Fly a left circuit, 200m on a side."""
        self.change_mode('FBWA')
        self.set_rc(3, 2000)
        self.wait_level_flight()

        self.progress("Flying left circuit")
        # do 4 turns
        for i in range(0, 4):
            # hard left
            self.progress("Starting turn %u" % i)
            self.set_rc(1, 1000)
            self.wait_heading(270 - (90*i), accuracy=10)
            self.set_rc(1, 1500)
            self.progress("Starting leg %u" % i)
            self.wait_distance(100, accuracy=20)
        self.progress("Circuit complete")

    def fly_RTL(self):
        """Fly to home."""
        self.progress("Flying home in RTL")
        target_loc = self.home_position_as_location()
        target_loc.offset_up_m(100)
        self.change_mode('RTL')
        self.wait_location(target_loc,
                           accuracy=120,
                           height_accuracy=20,
                           timeout=180)
        self.progress("RTL Complete")

    def NeedEKFToArm(self):
        """Ensure the EKF must be healthy for the vehicle to arm."""
        self.progress("Ensuring we need EKF to be healthy to arm")
        self.set_parameter("SIM_GPS1_ENABLE", 0)
        self.context_collect("STATUSTEXT")
        tstart = self.get_sim_time()
        success = False
        for run_cmd in self.run_cmd, self.run_cmd_int:
            while not success:
                if self.get_sim_time_cached() - tstart > 60:
                    raise NotAchievedException("Did not get correct failure reason")
                run_cmd(mavutil.mavlink.MAV_CMD_RUN_PREARM_CHECKS)
                try:
                    self.wait_statustext(".*AHRS: not using configured AHRS type.*", timeout=1, check_context=True, regex=True)
                    success = True
                    continue
                except AutoTestTimeoutException:
                    pass

        self.set_parameter("SIM_GPS1_ENABLE", 1)
        self.wait_ready_to_arm()

    def fly_LOITER(self, num_circles=4, timeout=60):
        """Loiter where we are."""
        self.progress("Testing LOITER for %u turns" % num_circles)
        self.change_mode('LOITER')

        m = self.assert_receive_message('VFR_HUD')
        initial_alt = m.alt
        self.progress("Initial altitude %u\n" % initial_alt)

        while num_circles > 0:
            self.wait_heading(0, accuracy=10, timeout=timeout)
            self.wait_heading(180, accuracy=10, timeout=timeout)
            num_circles -= 1
            self.progress("Loiter %u circles left" % num_circles)

        m = self.assert_receive_message('VFR_HUD')
        final_alt = m.alt
        self.progress("Final altitude %u initial %u\n" %
                      (final_alt, initial_alt))

        self.change_mode('FBWA')

        if abs(final_alt - initial_alt) > 20:
            raise NotAchievedException("Failed to maintain altitude")

        self.progress("Completed Loiter OK")

    def fly_CIRCLE(self, num_circles=1):
        """Circle where we are."""
        self.progress("Testing CIRCLE for %u turns" % num_circles)
        self.change_mode('CIRCLE')

        m = self.assert_receive_message('VFR_HUD')
        initial_alt = m.alt
        self.progress("Initial altitude %u\n" % initial_alt)

        while num_circles > 0:
            self.wait_heading(0, accuracy=10, timeout=60)
            self.wait_heading(180, accuracy=10, timeout=60)
            num_circles -= 1
            self.progress("CIRCLE %u circles left" % num_circles)

        m = self.assert_receive_message('VFR_HUD')
        final_alt = m.alt
        self.progress("Final altitude %u initial %u\n" %
                      (final_alt, initial_alt))

        self.change_mode('FBWA')

        if abs(final_alt - initial_alt) > 20:
            raise NotAchievedException("Failed to maintain altitude")

        self.progress("Completed CIRCLE OK")

    def wait_level_flight(self, accuracy=5, timeout=30):
        """Wait for level flight."""
        tstart = self.get_sim_time()
        self.progress("Waiting for level flight")
        self.set_rc(1, 1500)
        self.set_rc(2, 1500)
        self.set_rc(4, 1500)
        while self.get_sim_time_cached() < tstart + timeout:
            m = self.assert_receive_message('ATTITUDE')
            roll = math.degrees(m.roll)
            pitch = math.degrees(m.pitch)
            self.progress("Roll=%.1f Pitch=%.1f" % (roll, pitch))
            if math.fabs(roll) <= accuracy and math.fabs(pitch) <= accuracy:
                self.progress("Attained level flight")
                return
        raise NotAchievedException("Failed to attain level flight")

    def change_altitude(self, altitude, accuracy=30, relative=False):
        """Get to a given altitude."""
        if relative:
            altitude += self.home_position_as_location().get_alt_m(AltFrame.ABSOLUTE)
        self.change_mode('FBWA')
        alt_error = self.mav.messages['VFR_HUD'].alt - altitude
        if alt_error > 0:
            self.set_rc(2, 2000)
        else:
            self.set_rc(2, 1000)
        self.wait_altitude(altitude-accuracy/2, altitude+accuracy/2)
        self.set_rc(2, 1500)
        self.progress("Reached target altitude at %u" %
                      self.mav.messages['VFR_HUD'].alt)
        return self.wait_level_flight()

    def axial_left_roll(self, count=1):
        """Fly a left axial roll."""
        # full throttle!
        self.set_rc(3, 2000)
        self.change_altitude(300, relative=True)

        # fly the roll in manual
        self.change_mode('MANUAL')

        while count > 0:
            self.progress("Starting roll")
            self.set_rc(1, 1000)
            try:
                self.wait_roll(-150, accuracy=90)
                self.wait_roll(150, accuracy=90)
                self.wait_roll(0, accuracy=90)
            except Exception as e:
                self.set_rc(1, 1500)
                raise e
            count -= 1

        # back to FBWA
        self.set_rc(1, 1500)
        self.change_mode('FBWA')
        self.set_rc(3, 1700)
        return self.wait_level_flight()

    def inside_loop(self, count=1):
        """Fly a inside loop."""
        # full throttle!
        self.set_rc(3, 2000)
        self.change_altitude(300, relative=True)
        # fly the loop in manual
        self.change_mode('MANUAL')

        while count > 0:
            self.progress("Starting loop")
            self.set_rc(2, 1000)
            self.wait_pitch(-60, accuracy=20)
            self.wait_pitch(0, accuracy=20)
            count -= 1

        # back to FBWA
        self.set_rc(2, 1500)
        self.change_mode('FBWA')
        self.set_rc(3, 1700)
        return self.wait_level_flight()

    def set_attitude_target(self, tolerance=10):
        """Test setting of attitude target in guided mode."""
        self.change_mode("GUIDED")

        steps = [{"name": "roll-over",         "roll": 60, "pitch": 0,  "yaw": 0, "throttle": 0, "type_mask": 0b10000001},
                 {"name": "roll-back",         "roll": 0,  "pitch": 0,  "yaw": 0, "throttle": 0, "type_mask": 0b10000001},
                 {"name": "pitch-up+throttle", "roll": 0,  "pitch": 20, "yaw": 0, "throttle": 1, "type_mask": 0b11000010},
                 {"name": "pitch-back",        "roll": 0,  "pitch": 0,  "yaw": 0, "throttle": 0, "type_mask": 0b10000010}]

        state_wait = "wait"
        state_hold = "hold"
        try:
            for step in steps:
                step_start = self.get_sim_time_cached()
                state = state_wait
                state_start = self.get_sim_time_cached()
                while True:
                    m = self.mav.recv_match(type='ATTITUDE',
                                            blocking=True,
                                            timeout=0.1)
                    now = self.get_sim_time_cached()
                    if now - step_start > 30:
                        raise AutoTestTimeoutException("Maneuvers not completed")
                    if m is None:
                        continue

                    angle_error = 0
                    if (step["type_mask"] & 0b00000001) or (step["type_mask"] == 0b10000000):
                        angle_error += abs(math.degrees(m.roll) - step["roll"])

                    if (step["type_mask"] & 0b00000010) or (step["type_mask"] == 0b10000000):
                        angle_error += abs(math.degrees(m.pitch) - step["pitch"])

                    if (step["type_mask"] & 0b00000100) or (step["type_mask"] == 0b10000000):
                        # Strictly we should angle wrap, by plane doesn't support yaw correctly anyway so its not tested here
                        angle_error += abs(math.degrees(m.yaw) - step["yaw"])

                    # Note were not checking throttle, however the SITL plane needs full throttle to meet the
                    # target pitch attitude, Pitch test will fail without throttle override

                    if state == state_wait:
                        # Reduced tolerance for initial trigger
                        if angle_error < (tolerance * 0.25):
                            state = state_hold
                            state_start = now

                        # Allow 10 seconds to reach attitude
                        if (now - state_start) > 10:
                            raise NotAchievedException(step["name"] + ": Failed to get to set attitude")

                    elif state == state_hold:
                        # Give 2 seconds to stabilize
                        if (now - state_start) > 2 and not (angle_error < tolerance):
                            raise NotAchievedException(step["name"] + ": Failed to hold set attitude")

                        # Hold for 10 seconds
                        if (now - state_start) > 12:
                            # move onto next step
                            self.progress("%s Done" % (step["name"]))
                            break

                    self.progress("%s %s error: %f" % (step["name"], state, angle_error))

                    time_boot_millis = 0 # FIXME
                    target_system = 1 # FIXME
                    target_component = 1 # FIXME
                    type_mask = step["type_mask"] ^ 0xFF # FIXME
                    # attitude in radians:
                    q = quaternion.Quaternion([math.radians(step["roll"]),
                                               math.radians(step["pitch"]),
                                               math.radians(step["yaw"])])
                    self.mav.mav.set_attitude_target_send(time_boot_millis,
                                                          target_system,
                                                          target_component,
                                                          type_mask,
                                                          q,
                                                          0, # roll rate, not used in AP
                                                          0, # pitch rate, not used in AP
                                                          0, # yaw rate, not used in AP
                                                          step["throttle"])
        except Exception as e:
            self.change_mode('FBWA')
            self.set_rc(3, 1700)
            raise e

        # back to FBWA
        self.change_mode('FBWA')
        self.set_rc(3, 1700)
        self.wait_level_flight()

    def test_stabilize(self, count=1):
        """Fly stabilize mode."""
        # full throttle!
        self.set_rc(3, 2000)
        self.set_rc(2, 1300)
        self.change_altitude(300, relative=True)
        self.set_rc(2, 1500)

        self.change_mode('STABILIZE')

        while count > 0:
            self.progress("Starting roll")
            self.set_rc(1, 2000)
            self.wait_roll(-150, accuracy=90)
            self.wait_roll(150, accuracy=90)
            self.wait_roll(0, accuracy=90)
            count -= 1

        self.set_rc(1, 1500)
        self.wait_roll(0, accuracy=5)

        # back to FBWA
        self.change_mode('FBWA')
        self.set_rc(3, 1700)
        return self.wait_level_flight()

    def test_acro(self, count=1):
        """Fly ACRO mode."""
        # full throttle!
        self.set_rc(3, 2000)
        self.set_rc(2, 1300)
        self.change_altitude(300, relative=True)
        self.set_rc(2, 1500)

        self.change_mode('ACRO')

        while count > 0:
            self.progress("Starting roll")
            self.set_rc(1, 1000)
            self.wait_roll(-150, accuracy=90)
            self.wait_roll(150, accuracy=90)
            self.wait_roll(0, accuracy=90)
            count -= 1
        self.set_rc(1, 1500)

        # back to FBWA
        self.change_mode('FBWA')

        self.wait_level_flight()

        self.change_mode('ACRO')

        count = 2
        while count > 0:
            self.progress("Starting loop")
            self.set_rc(2, 1000)
            self.wait_pitch(-60, accuracy=20)
            self.wait_pitch(0, accuracy=20)
            count -= 1

        self.set_rc(2, 1500)

        # back to FBWA
        self.change_mode('FBWA')
        self.set_rc(3, 1700)
        return self.wait_level_flight()

    def test_FBWB(self, mode='FBWB'):
        """Fly FBWB or CRUISE mode."""
        self.change_mode(mode)
        self.set_rc(3, 1700)
        self.set_rc(2, 1500)

        # lock in the altitude by asking for an altitude change then releasing
        self.set_rc(2, 1000)
        self.wait_distance(50, accuracy=20)
        self.set_rc(2, 1500)
        self.wait_distance(50, accuracy=20)

        m = self.assert_receive_message('VFR_HUD')
        initial_alt = m.alt
        self.progress("Initial altitude %u\n" % initial_alt)

        self.progress("Flying right circuit")
        # do 4 turns
        for i in range(0, 4):
            # hard left
            self.progress("Starting turn %u" % i)
            self.set_rc(1, 1800)
            try:
                self.wait_heading(0 + (90*i), accuracy=20, timeout=60)
            except Exception as e:
                self.set_rc(1, 1500)
                raise e
            self.set_rc(1, 1500)
            self.progress("Starting leg %u" % i)
            # This is a minimum leg length, not a stopping target. At high
            # speedup successive position samples can skip a narrow band.
            self.wait_distance_to_location(self.get_location(), 100, float('inf'))
        self.progress("Circuit complete")

        self.progress("Flying rudder left circuit")
        # do 4 turns
        for i in range(0, 4):
            # hard left
            self.progress("Starting turn %u" % i)
            self.set_rc(4, 1900)
            try:
                self.wait_heading(360 - (90*i), accuracy=20, timeout=60)
            except Exception as e:
                self.set_rc(4, 1500)
                raise e
            self.set_rc(4, 1500)
            self.progress("Starting leg %u" % i)
            self.wait_distance_to_location(self.get_location(), 100, float('inf'))
        self.progress("Circuit complete")

        m = self.assert_receive_message('VFR_HUD')
        final_alt = m.alt
        self.progress("Final altitude %u initial %u\n" %
                      (final_alt, initial_alt))

        # back to FBWA
        self.change_mode('FBWA')

        if abs(final_alt - initial_alt) > 20:
            raise NotAchievedException("Failed to maintain altitude")

        return self.wait_level_flight()

    def fly_mission(self, filename, mission_timeout=60.0, strict=True, quadplane=False):
        """Fly a mission from a file."""
        self.progress("Flying mission %s" % filename)
        num_wp = self.load_mission(filename, strict=strict)-1
        self.fly_mission_waypoints(num_wp, mission_timeout=mission_timeout, quadplane=quadplane)

    def fly_mission_waypoints(self, num_wp, mission_timeout=60.0, quadplane=False,
                              dist_to_final_wp_threshold_m: float | None = None):
        self.set_current_waypoint(0, check_afterwards=False)
        self.context_push()
        self.context_collect('STATUSTEXT')
        self.change_mode('AUTO')
        if dist_to_final_wp_threshold_m is None:
            dist_to_final_wp_threshold_m = 60.0
        self.wait_waypoint(1, num_wp, max_dist_to_final_wp_m=dist_to_final_wp_threshold_m, timeout=mission_timeout)
        self.wait_groundspeed(0, 0.5, timeout=mission_timeout)
        if quadplane:
            self.wait_statustext("Throttle disarmed", timeout=200, check_context=True)
        else:
            self.wait_statustext("Auto disarmed", timeout=60, check_context=True)
        self.context_pop()
        self.progress("Mission OK")

    def DO_REPOSITION(self):
        '''Test mavlink DO_REPOSITION command'''
        self.progress("Takeoff")
        self.takeoff(alt=50)
        self.set_rc(3, 1500)
        self.progress("Entering guided and flying somewhere constant")
        self.change_mode("GUIDED")
        loc = self.get_location()
        self.location_offset_ne(loc, 500, 500)

        new_alt = 100
        self.run_cmd_int(
            mavutil.mavlink.MAV_CMD_DO_REPOSITION,
            p5=int(loc.lat * 1e7),
            p6=int(loc.lng * 1e7),
            p7=new_alt,    # alt
            frame=mavutil.mavlink.MAV_FRAME_GLOBAL_RELATIVE_ALT,
        )
        self.wait_altitude(new_alt-10, new_alt, timeout=30, relative=True)

        self.install_terrain_handlers_context()

        self.location_offset_ne(loc, 500, 500)
        terrain_height_wanted = 150
        self.run_cmd_int(
            mavutil.mavlink.MAV_CMD_DO_REPOSITION,
            0,
            0,
            0,
            0,
            int(loc.lat*1e7),
            int(loc.lng*1e7),
            terrain_height_wanted,    # alt
            frame=mavutil.mavlink.MAV_FRAME_GLOBAL_TERRAIN_ALT,
        )

        # move to specific terrain-relative altitude and hold for <n> seconds
        tstart = self.get_sim_time_cached()
        achieve_start = None
        tr = None
        while True:
            if self.get_sim_time_cached() - tstart > 120:
                raise NotAchievedException("Did not move to correct terrain alt")

            m = self.assert_receive_message('TERRAIN_REPORT')
            tr = m
            terrain_height_achieved = m.current_height
            self.progress("terrain_alt=%f want=%f" %
                          (terrain_height_achieved, terrain_height_wanted))
            if m is None:
                continue
            if abs(terrain_height_wanted - terrain_height_achieved) > 5:
                if achieve_start is not None:
                    self.progress("Achieve stop")
                    achieve_start = None
            elif achieve_start is None:
                self.progress("Achieve start")
                achieve_start = self.get_sim_time_cached()
            if achieve_start is not None:
                if self.get_sim_time_cached() - achieve_start > 10:
                    break
        m = self.assert_receive_message('GLOBAL_POSITION_INT')
        self.progress("TR: %s" % tr)
        self.progress("GPI: %s" % m)
        min_delta = 4
        delta = abs(m.relative_alt/1000.0 - tr.current_height)
        if abs(delta < min_delta):
            raise NotAchievedException("Expected altitude delta (want=%f got=%f)" %
                                       (min_delta, delta))

        self.fly_home_land_and_disarm(timeout=180)

    def DO_REPOSITION_mode_change_refused(self):
        '''DO_REPOSITION must not redirect the vehicle if it cannot change into GUIDED'''
        self.start_flying_simple_relhome_mission([
            (mavutil.mavlink.MAV_CMD_NAV_TAKEOFF, 0, 0, 50),
            (mavutil.mavlink.MAV_CMD_NAV_WAYPOINT, 3000, 0, 50),
        ])
        self.wait_current_waypoint(2, timeout=60)
        self.wait_distance_to_home(300, 1000, timeout=60)

        self.set_parameter("FLTMODE_GCSBLOCK", 1 << 13)  # GUIDED
        target = self.offset_location_ne(self.home_position_as_location(), 0, -1500)
        self.run_cmd_int(
            mavutil.mavlink.MAV_CMD_DO_REPOSITION,
            p2=mavutil.mavlink.MAV_DO_REPOSITION_FLAGS_CHANGE_MODE,
            p5=int(target.lat * 1e7),
            p6=int(target.lng * 1e7),
            p7=50,
            frame=mavutil.mavlink.MAV_FRAME_GLOBAL_RELATIVE_ALT,
            want_result=mavutil.mavlink.MAV_RESULT_FAILED,
        )
        self.assert_mode_is('AUTO')

        # still flying the mission leg north, not heading for the reposition target:
        self.wait_and_maintain(
            value_name="TargetBearing",
            target=0,
            current_value_getter=lambda: self.assert_receive_message('NAV_CONTROLLER_OUTPUT').target_bearing,
            validator=lambda value, target: self.heading_delta(value, target) <= 10,
            minimum_duration=10,
            timeout=30,
        )

        self.reboot_sitl(force=True)

    def ExternalPositionEstimate(self):
        '''Test mavlink EXTERNAL_POSITION_ESTIMATE command'''
        if not hasattr(mavutil.mavlink, 'MAV_CMD_EXTERNAL_POSITION_ESTIMATE'):
            raise OldpymavlinkException("pymavlink too old; upgrade pymavlink to get MAV_CMD_EXTERNAL_POSITION_ESTIMATE")  # noqa
        self.change_mode("TAKEOFF")
        self.wait_ready_to_arm()
        self.arm_vehicle()
        self.wait_altitude(48, 52, relative=True)

        loc = self.get_location()
        self.location_offset_ne(loc, 2000, 2000)

        # setting external position fail while we have GPS lock
        self.progress("set new position with GPS")
        self.run_cmd_int(
            mavutil.mavlink.MAV_CMD_EXTERNAL_POSITION_ESTIMATE,
            p1=self.get_sim_time()-1, # transmit time
            p2=0.5, # processing delay
            p3=50, # accuracy
            p5=int(loc.lat * 1e7),
            p6=int(loc.lng * 1e7),
            p7=float("NaN"),    # alt
            frame=mavutil.mavlink.MAV_FRAME_GLOBAL,
            want_result=mavutil.mavlink.MAV_RESULT_FAILED,
        )

        self.progress("disable the GPS")
        self.run_auxfunc(
            65,
            2,
            want_result=mavutil.mavlink.MAV_RESULT_ACCEPTED
        )

        # fly for a bit to get into non-aiding state
        self.progress("waiting 20 seconds")
        tstart = self.get_sim_time()
        while self.get_sim_time() < tstart + 20:
            self.wait_heartbeat()

        self.progress("getting base position")
        gpi = self.assert_receive_message('GLOBAL_POSITION_INT', timeout=5)
        loc = Location.latlon_only(gpi.lat*1e-7, gpi.lon*1e-7)

        self.progress("set new position with no GPS")
        self.run_cmd_int(
            mavutil.mavlink.MAV_CMD_EXTERNAL_POSITION_ESTIMATE,
            p1=self.get_sim_time()-1, # transmit time
            p2=0.5, # processing delay
            p3=50, # accuracy
            p5=gpi.lat+1,
            p6=gpi.lon+1,
            p7=float("NaN"),    # alt
            frame=mavutil.mavlink.MAV_FRAME_GLOBAL,
            want_result=mavutil.mavlink.MAV_RESULT_ACCEPTED
        )

        self.progress("waiting 3 seconds")
        tstart = self.get_sim_time()
        while self.get_sim_time() < tstart + 3:
            self.wait_heartbeat()

        gpi2 = self.assert_receive_message('GLOBAL_POSITION_INT', timeout=5)
        loc2 = Location.latlon_only(gpi2.lat*1e-7, gpi2.lon*1e-7)
        dist = self.get_distance(loc, loc2)

        self.progress("dist is %.1f" % dist)
        if dist > 200:
            raise NotAchievedException("Position error dist=%.1f" % dist)

        self.progress("re-enable the GPS")
        self.run_auxfunc(
            65,
            0,
            want_result=mavutil.mavlink.MAV_RESULT_ACCEPTED
        )

        self.progress("flying home")
        self.fly_home_land_and_disarm()

    def DeepStall(self):
        '''Test DeepStall Landing'''
        # self.fly_deepstall_absolute()
        self.fly_deepstall_relative()

    def fly_deepstall_absolute(self):
        self.start_subtest("DeepStall Relative Absolute")
        deepstall_elevator_pwm = 1661
        self.set_parameters({
            "LAND_TYPE": 1,
            "LAND_DS_ELEV_PWM": deepstall_elevator_pwm,
            "RTL_AUTOLAND": 1,
        })
        self.start_flying_mission("plane-deepstall-mission.txt")
        self.progress("Waiting for deepstall messages")

        # note that the following two don't necessarily happen in this
        # order, but at very high speedups we may miss the elevator
        # PWM if we first look for the text (due to the get_sim_time()
        # in wait_servo_channel_value)

        self.context_collect('STATUSTEXT')

        # assume elevator is on channel 2:
        self.wait_servo_channel_value(2, deepstall_elevator_pwm, timeout=240)

        self.wait_text("Deepstall: Entry: ", check_context=True)

        self.disarm_wait(timeout=120)

        self.progress("Flying home")
        self.set_current_waypoint(0, check_afterwards=False)
        self.takeoff(10)
        self.set_parameter("LAND_TYPE", 0)
        self.fly_home_land_and_disarm()

    def fly_deepstall_relative(self):
        self.start_subtest("DeepStall Relative")
        deepstall_elevator_pwm = 1661
        self.set_parameters({
            "LAND_TYPE": 1,
            "LAND_DS_ELEV_PWM": deepstall_elevator_pwm,
            "RTL_AUTOLAND": 1,
        })
        self.start_flying_mission("plane-deepstall-relative-mission.txt")
        self.wait_current_waypoint(4)

        # assume elevator is on channel 2:
        self.wait_servo_channel_value(2, deepstall_elevator_pwm, timeout=240)

        self.progress("Waiting for stage DEEPSTALL_STAGE_LAND")
        self.assert_receive_message(
            'DEEPSTALL',
            condition='DEEPSTALL.stage==6',
            timeout=240,
        )
        self.progress("Reached stage DEEPSTALL_STAGE_LAND")

        self.disarm_wait(timeout=120)
        self.set_current_waypoint(0, check_afterwards=False)

        self.progress("Flying home")
        self.set_current_waypoint(0, check_afterwards=False)
        self.takeoff(100)
        self.set_parameter("LAND_TYPE", 0)
        self.fly_home_land_and_disarm(timeout=240)

    def SmartBattery(self):
        '''Test smart battery logging etc'''
        self.set_parameters({
            "BATT_MONITOR": 16, # Maxell battery monitor
        })

        # Must reboot sitl after setting monitor type for SMBus parameters to be set due to dynamic group
        self.reboot_sitl()
        self.set_parameters({
            "BATT_I2C_BUS": 2,      # specified in SIM_I2C.cpp
            "BATT_I2C_ADDR": 11,    # specified in SIM_I2C.cpp
        })
        self.reboot_sitl()

        self.wait_ready_to_arm()
        m = self.assert_receive_message('BATTERY_STATUS', timeout=10)
        if m.voltages_ext[0] == 65536:
            raise NotAchievedException("Flag value rather than voltage")
        if abs(m.voltages_ext[0] - 1000) > 300:
            raise NotAchievedException("Did not get good ext voltage (got=%f)" %
                                       (m.voltages_ext[0],))
        self.arm_vehicle()
        self.delay_sim_time(5, reason="battery log data to be written")
        self.disarm_vehicle()
        if not self.current_onboard_log_contains_message("BCL2"):
            raise NotAchievedException("Expected BCL2 message")

    def context_push_do_change_speed(self):
        # the following lines ensure we revert these parameter values
        # - DO_CHANGE_AIRSPEED is a permanent vehicle change!
        self.context_push()
        self.set_parameters({
            "AIRSPEED_CRUISE": self.get_parameter("AIRSPEED_CRUISE"),
            "MIN_GROUNDSPEED": self.get_parameter("MIN_GROUNDSPEED"),
            "TRIM_THROTTLE": self.get_parameter("TRIM_THROTTLE"),
        })

    def DO_CHANGE_SPEED(self):
        '''Test DO_CHANGE_SPEED command/item'''
        self.set_parameters({
            "RTL_AUTOLAND": 1,
        })

        self.context_push_do_change_speed()
        self.DO_CHANGE_SPEED_mavlink_long()
        self.context_pop()

        self.set_current_waypoint(1)
        self.zero_throttle()

        self.context_push_do_change_speed()
        self.DO_CHANGE_SPEED_mavlink_int()
        self.context_pop()

        self.context_push_do_change_speed()
        self.DO_CHANGE_SPEED_mission()
        self.context_pop()

    def DO_CHANGE_SPEED_mission(self):
        '''test DO_CHANGE_SPEED as a mission item'''
        self.start_subtest("DO_CHANGE_SPEED_mission")
        self.load_mission("mission.txt")
        self.set_current_waypoint(1)

        self.progress("Takeoff")
        self.set_rc(3, 1000)
        self.takeoff(alt=10)
        self.set_rc(3, 1500)

        self.start_subtest("Check initial speed")

        self.change_mode('AUTO')

        checks = [
            (1, self.get_parameter("AIRSPEED_CRUISE")),
            (3, 10),
            (5, 20),
            (7, 15),
        ]

        for (current_waypoint, want_airspeed) in checks:
            self.wait_current_waypoint(current_waypoint, timeout=150)
            self.wait_airspeed(want_airspeed-1, want_airspeed+1, minimum_duration=5, timeout=120)

        self.fly_home_land_and_disarm()

    def GuidedThrottleNudge(self):
        '''ensure THROTTLE_NUDGE nudges target airspeed in GUIDED mode'''
        # regression test for throttle-nudge being ignored in GUIDED (issue #26094)
        self.set_parameters({
            "THROTTLE_NUDGE": 1,
            "AIRSPEED_CRUISE": 22,
            "AIRSPEED_MAX": 32,
            "ARSPD_USE": 1,
            # keep the vehicle flying near-straight for a stable airspeed
            # reading while staying bounded near home
            "WP_LOITER_RAD": 250,
        })
        self.takeoff(alt=100, mode="TAKEOFF", timeout=120)
        self.set_rc(3, 1500)
        self.change_mode("GUIDED")
        # hold position near the current location so the vehicle loiters
        # (auto-throttle active) rather than flying away from home
        self.send_do_reposition(self.get_location(frame=AltFrame.ABOVE_HOME))
        self.delay_sim_time(10, reason="vehicle to establish GUIDED position")

        self.start_subtest("Neutral throttle: target airspeed sits at cruise")
        self.wait_airspeed(20, 24, minimum_duration=5, timeout=60)

        self.start_subtest("Full throttle: nudge raises target airspeed toward AIRSPEED_MAX")
        self.set_rc(3, 2000)
        self.wait_airspeed(28, 40, minimum_duration=5, timeout=60)

        self.start_subtest("Neutral throttle: nudge released, back to cruise")
        self.set_rc(3, 1500)
        self.wait_airspeed(20, 24, minimum_duration=5, timeout=60)

        self.start_subtest("Offboard guided speed active: throttle nudge stays suppressed")
        # an active offboard airspeed slew must keep suppressing the nudge
        self.run_cmd(
            mavutil.mavlink.MAV_CMD_GUIDED_CHANGE_SPEED,
            p1=0,   # SPEED_TYPE_AIRSPEED
            p2=26,  # target airspeed m/s (between cruise and AIRSPEED_MAX)
            p3=5,   # acceleration m/s/s
        )
        self.delay_sim_time(8, reason="offboard airspeed slew to take effect")
        self.set_rc(3, 2000)
        # with a slew active the nudge is suppressed, so the target holds at
        # the commanded 26 m/s and does not climb toward AIRSPEED_MAX (32)
        self.wait_airspeed(24, 28, minimum_duration=8, timeout=40)
        self.set_rc(3, 1500)

        self.reboot_sitl(force=True)

    def DO_CHANGE_SPEED_mavlink_int(self):
        self.DO_CHANGE_SPEED_mavlink(self.run_cmd_int)

    def DO_CHANGE_SPEED_mavlink_long(self):
        self.DO_CHANGE_SPEED_mavlink(self.run_cmd)

    def DO_CHANGE_SPEED_mavlink(self, run_cmd_method):
        '''test DO_CHANGE_SPEED as a mavlink command'''
        self.progress("Takeoff")
        self.takeoff(alt=100, mode="TAKEOFF", timeout=120)
        self.set_rc(3, 1500)
        # ensure we know what the airspeed is:
        self.progress("Entering guided and flying somewhere constant")
        self.change_mode("GUIDED")
        self.run_cmd_int(
            mavutil.mavlink.MAV_CMD_DO_REPOSITION,
            p5=12345, # lat* 1e7
            p6=12345, # lon* 1e7
            p7=100,   # alt
            frame=mavutil.mavlink.MAV_FRAME_GLOBAL_RELATIVE_ALT,
        )
        self.delay_sim_time(10, reason="vehicle to establish GUIDED position")
        self.progress("Ensuring initial speed is known and relatively constant")
        initial_speed = 22.0
        timeout = 15
        self.wait_airspeed(initial_speed-1, initial_speed+1, minimum_duration=5, timeout=timeout)

        self.start_subtest("Setting groundspeed")
        for new_target_groundspeed in initial_speed + 5, initial_speed + 2:
            run_cmd_method(
                mavutil.mavlink.MAV_CMD_DO_CHANGE_SPEED,
                p1=1, # groundspeed
                p2=new_target_groundspeed,
                p3=-1, # throttle / no change
                p4=0, # absolute values
            )
            self.wait_groundspeed(new_target_groundspeed-2, new_target_groundspeed+2, timeout=80, minimum_duration=5)
            self.progress("Adding some wind, ensuring groundspeed holds")
            self.set_parameter("SIM_WIND_SPD", 5)
            self.delay_sim_time(5, reason="wind to take effect")
            self.wait_groundspeed(new_target_groundspeed-2, new_target_groundspeed+2, timeout=40, minimum_duration=5)
            self.set_parameter("SIM_WIND_SPD", 0)

        # clear target groundspeed
        run_cmd_method(
            mavutil.mavlink.MAV_CMD_DO_CHANGE_SPEED,
            p1=1, # groundspeed
            p2=0,
            p3=-1, # throttle / no change
            p4=0, # absolute values
        )

        self.start_subtest("Setting airspeed")
        for new_target_airspeed in initial_speed - 5, initial_speed + 5:
            run_cmd_method(
                mavutil.mavlink.MAV_CMD_DO_CHANGE_SPEED,
                p1=0, # airspeed
                p2=new_target_airspeed,
                p3=-1, # throttle / no change
                p4=0, # absolute values
            )
            self.wait_airspeed(new_target_airspeed-2, new_target_airspeed+2, minimum_duration=5)

        self.context_push()
        self.progress("Adding some wind, hoping groundspeed increases/decreases")
        self.set_parameters({
            "SIM_WIND_SPD": 7,
            "SIM_WIND_DIR": 270,
        })
        self.delay_sim_time(5, reason="wind to take effect")
        timeout = 10
        tstart = self.get_sim_time()
        while True:
            if self.get_sim_time_cached() - tstart > timeout:
                raise NotAchievedException("Did not achieve groundspeed delta")
            m = self.assert_receive_message('VFR_HUD')
            delta = abs(m.airspeed - m.groundspeed)
            want_delta = 5
            self.progress("groundspeed and airspeed should be different (have=%f want=%f)" % (delta, want_delta))
            if delta > want_delta:
                break
        self.context_pop()

        # cancel minimum groundspeed:
        run_cmd_method(
            mavutil.mavlink.MAV_CMD_DO_CHANGE_SPEED,
            p1=0, # groundspeed
            p2=-2,  # return to default
            p3=0, # throttle / no change
            p4=0, # absolute values
        )
        # cancel airspeed:
        run_cmd_method(
            mavutil.mavlink.MAV_CMD_DO_CHANGE_SPEED,
            p1=1, # airspeed
            p2=-2,  # return to default
            p3=0, # throttle / no change
            p4=0, # absolute values
        )

        self.start_subtest("Setting throttle")
        self.set_parameter('ARSPD_USE', 0)  # setting throttle only effective without airspeed
        for (set_throttle, expected_throttle) in (97, 79), (60, 51), (95, 77):
            run_cmd_method(
                mavutil.mavlink.MAV_CMD_DO_CHANGE_SPEED,
                p1=3, # throttle
                p2=0,
                p3=set_throttle, # throttle / no change
                p4=0, # absolute values
            )
            self.wait_message_field_values('VFR_HUD', {
                "throttle": expected_throttle,
            }, minimum_duration=5, epsilon=5)

        self.fly_home_land_and_disarm(timeout=240)

    def fly_home_land_and_disarm(self, timeout=120):
        filename = "flaps.txt"
        self.progress("Using %s to fly home" % filename)
        n = self.load_generic_mission(filename)
        self.change_mode("AUTO")
        # don't set current waypoint to 8 unless we're distant from it
        # or we arrive instantly and never see it as our current
        # waypoint:
        self.wait_distance_to_waypoint(8, 100, 10000000)
        self.set_current_waypoint(8)
        self.wait_current_waypoint(n-1, timeout=timeout)
        self.wait_disarmed(60)

    def TestFlaps(self):
        """Test flaps functionality."""
        filename = "flaps.txt"
        flaps_ch = 5
        flaps_ch_min = 1000
        flaps_ch_trim = 1500
        flaps_ch_max = 2000

        servo_ch = 5
        servo_ch_min = 1200
        servo_ch_trim = 1300
        servo_ch_max = 1800

        self.set_parameters({
            "SERVO%u_FUNCTION" % servo_ch: 3, # flapsauto
            "RC%u_OPTION" % flaps_ch: 208, # Flaps RCx_OPTION
            "LAND_FLAP_PERCNT": 50,
            "LOG_DISARMED": 1,
            "RTL_AUTOLAND": 1,

            "RC%u_MIN" % flaps_ch: flaps_ch_min,
            "RC%u_MAX" % flaps_ch: flaps_ch_max,
            "RC%u_TRIM" % flaps_ch: flaps_ch_trim,

            "SERVO%u_MIN" % servo_ch: servo_ch_min,
            "SERVO%u_MAX" % servo_ch: servo_ch_max,
            "SERVO%u_TRIM" % servo_ch: servo_ch_trim,
        })

        self.progress("check flaps are not deployed")
        self.set_rc(flaps_ch, flaps_ch_min)
        self.wait_servo_channel_value(servo_ch, servo_ch_min, timeout=3)
        self.progress("deploy the flaps")
        self.set_rc(flaps_ch, flaps_ch_max)
        tstart = self.get_sim_time()
        self.wait_servo_channel_value(servo_ch, servo_ch_max)
        tstop = self.get_sim_time_cached()
        delta_time = tstop - tstart
        delta_time_min = 0.5
        delta_time_max = 1.5
        if delta_time < delta_time_min or delta_time > delta_time_max:
            raise NotAchievedException((
                "Flaps Slew not working (%f seconds)" % (delta_time,)))
        self.progress("undeploy flaps")
        self.set_rc(flaps_ch, flaps_ch_min)
        self.wait_servo_channel_value(servo_ch, servo_ch_min)

        self.start_flying_mission(filename)
        self.start_subtest("flaps should deploy for landing")  # (RC input value used for position?!)
        self.wait_servo_channel_value(servo_ch, flaps_ch_trim, timeout=300)
        self.start_subtest("flaps should undeploy at the end")
        self.wait_servo_channel_value(servo_ch, servo_ch_min, timeout=30)

        self.progress("Flaps OK")

        # because we have used flaps, RC output 5 is now non-zero -
        # it's actually the SERVO5_MIN value of 1100 now.  The simulator
        # sees that as 100us above the zero-position (it is
        # 1000-to-2000 for flaps).  That slows the aircraft down!
        self.reboot_sitl()

    def TestAutoSpeedFlaps(self):
        """Test auto flap deployment based on airspeed thresholds."""
        servo_ch = 5
        servo_ch_min = 1200
        servo_ch_max = 1800

        flap_1_speed = 18   # m/s
        flap_2_speed = 12   # m/s
        flap_1_percent = 30
        flap_2_percent = 60

        def flap_pct_to_pwm(pct):
            return int(servo_ch_min + (pct / 100.0) * (servo_ch_max - servo_ch_min))

        flap_1_pwm = flap_pct_to_pwm(flap_1_percent)   # 1380
        flap_2_pwm = flap_pct_to_pwm(flap_2_percent)   # 1560
        pwm_epsilon = 20

        self.set_parameters({
            "SERVO%u_FUNCTION" % servo_ch: 3,     # flapsauto
            "SERVO%u_MIN" % servo_ch: servo_ch_min,
            "SERVO%u_MAX" % servo_ch: servo_ch_max,
            "SERVO%u_TRIM" % servo_ch: servo_ch_min,
            "FLAP_1_SPEED": flap_1_speed,
            "FLAP_2_SPEED": flap_2_speed,
            "FLAP_1_PERCNT": flap_1_percent,
            "FLAP_2_PERCNT": flap_2_percent,
            "FLAP_SLEWRATE": 100,
            "TKOFF_FLAP_PCNT": 0,
            "AIRSPEED_CRUISE": 22,
            "AIRSPEED_MAX": 30,
            "ARSPD_USE": 1,
        })

        self.takeoff(alt=100, mode="TAKEOFF", timeout=120)
        self.set_rc(3, 1500)
        self.change_mode("GUIDED")
        self.delay_sim_time(5, reason="establish guided flight")

        self.start_subtest("Target-airspeed-based auto flap deployment in GUIDED mode")

        self.progress("No flaps when target above FLAP_1_SPEED")
        self.run_cmd(
            mavutil.mavlink.MAV_CMD_DO_CHANGE_SPEED,
            p1=0,   # airspeed type
            p2=22,  # above FLAP_1_SPEED=18
            p3=-1,
        )
        self.wait_servo_channel_value(servo_ch, servo_ch_min, epsilon=pwm_epsilon, timeout=10)

        self.progress("FLAP_1 deploys when target drops below FLAP_1_SPEED")
        self.run_cmd(
            mavutil.mavlink.MAV_CMD_DO_CHANGE_SPEED,
            p1=0,
            p2=15,  # between FLAP_2_SPEED=12 and FLAP_1_SPEED=18
            p3=-1,
        )
        self.wait_servo_channel_value(servo_ch, flap_1_pwm, epsilon=pwm_epsilon, timeout=10)

        self.progress("FLAP_2 deploys when target drops below FLAP_2_SPEED")
        self.run_cmd(
            mavutil.mavlink.MAV_CMD_DO_CHANGE_SPEED,
            p1=0,
            p2=10,  # below FLAP_2_SPEED=12
            p3=-1,
        )
        self.wait_servo_channel_value(servo_ch, flap_2_pwm, epsilon=pwm_epsilon, timeout=10)

        self.progress("Flaps retract when target rises above FLAP_1_SPEED")
        self.run_cmd(
            mavutil.mavlink.MAV_CMD_DO_CHANGE_SPEED,
            p1=0,
            p2=22,
            p3=-1,
        )
        self.wait_servo_channel_value(servo_ch, servo_ch_min, epsilon=pwm_epsilon, timeout=10)

        self.start_subtest("FLAP_ACTUAL_SPEED deploys flaps in non-auto modes using measured airspeed")
        # Set FLAP_1_SPEED above the cruise airspeed so measured speed will be below threshold
        self.set_parameter("FLAP_1_SPEED", 26)  # above typical cruise of ~22 m/s
        self.set_parameter("FLIGHT_OPTIONS", 1 << 15)  # enable FLAP_ACTUAL_SPEED
        self.change_mode("FBWA")
        # cruise throttle, not full throttle: at 1700 the aircraft settles around
        # 26.6m/s, *above* the FLAP_1_SPEED we just set, so the flaps deploy on the
        # way up through 26 and retract again a few seconds later.  Both assertions
        # below then only hold during that transient, and which side of the bound
        # the first sample lands on decides the run.
        self.set_rc(3, 1500)
        # a settled airspeed below the threshold, not one passing through it:
        self.wait_airspeed(18, 24, timeout=30, minimum_duration=5)
        self.wait_servo_channel_value(servo_ch, flap_1_pwm, epsilon=pwm_epsilon, timeout=15)

        self.progress("Flaps retract when FLAP_ACTUAL_SPEED option is disabled")
        self.set_parameter("FLIGHT_OPTIONS", 0)
        self.wait_servo_channel_value(servo_ch, servo_ch_min, epsilon=pwm_epsilon, timeout=10)

        self.fly_home_land_and_disarm(timeout=180)

    def TestRCRelay(self):
        '''Test Relay RC Channel Option'''
        self.set_parameters({
            "RELAY1_FUNCTION": 1, # Enable relay as a standard relay pin
            "RC12_OPTION": 28 # Relay On/Off
        })
        self.set_rc(12, 1000)
        self.reboot_sitl() # needed for RC12_OPTION and RELAY1_FUNCTION to take effect

        off = self.get_parameter("SIM_PIN_MASK")
        if off:
            raise PreconditionFailedException("SIM_MASK_PIN off")

        # allow time for the RC library to register initial value:
        self.delay_sim_time(1, reason="RC library to register initial value")

        self.set_rc(12, 2000)
        self.wait_heartbeat()
        self.wait_heartbeat()

        on = self.get_parameter("SIM_PIN_MASK")
        if not on:
            raise NotAchievedException("SIM_PIN_MASK doesn't reflect ON")
        self.set_rc(12, 1000)
        self.wait_heartbeat()
        self.wait_heartbeat()
        off = self.get_parameter("SIM_PIN_MASK")
        if off:
            raise NotAchievedException("SIM_PIN_MASK doesn't reflect OFF")

    def TestRCCamera(self):
        '''Test RC Option - Camera Trigger'''
        self.set_parameter("RC12_OPTION", 9) # CameraTrigger
        self.set_parameter("CAM1_TYPE", 1)   # Camera with servo trigger
        self.reboot_sitl() # needed for RC12_OPTION to take effect

        x = self.mav.messages.get("CAMERA_FEEDBACK", None)
        if x is not None:
            raise PreconditionFailedException("Receiving CAMERA_FEEDBACK?!")
        self.set_rc(12, 2000)
        tstart = self.get_sim_time()
        while self.get_sim_time_cached() - tstart < 10:
            x = self.mav.messages.get("CAMERA_FEEDBACK", None)
            if x is not None:
                break
            self.wait_heartbeat()
        self.set_rc(12, 1000)
        if x is None:
            raise NotAchievedException("No CAMERA_FEEDBACK message received")

        self.wait_ready_to_arm()

        original_alt = self.get_altitude()

        takeoff_alt = 30
        self.takeoff(takeoff_alt)
        self.set_rc(12, 2000)
        self.delay_sim_time(1, reason="camera trigger to register")
        self.set_rc(12, 1000)
        x = self.mav.messages.get("CAMERA_FEEDBACK", None)
        if abs(x.alt_rel - takeoff_alt) > 10:
            raise NotAchievedException("Bad relalt (want=%f vs got=%f)" % (takeoff_alt, x.alt_rel))
        if abs(x.alt_msl - (original_alt+30)) > 10:
            raise NotAchievedException("Bad absalt (want=%f vs got=%f)" % (original_alt+30, x.alt_msl))

        loc = self.get_location()
        self.run_cmd_int(
            mavutil.mavlink.MAV_CMD_DO_REPOSITION,
            p2=mavutil.mavlink.MAV_DO_REPOSITION_FLAGS_CHANGE_MODE,
            p5=int(loc.lat * 1e7),
            p6=int(loc.lng * 1e7),
            p7=x.alt_rel,    # alt
            frame=mavutil.mavlink.MAV_FRAME_GLOBAL_RELATIVE_ALT,
        )
        expected_radius = 100
        self.wait_circling_point_with_radius(loc, expected_radius)

        self.context_collect('CAMERA_FEEDBACK')
        self.set_rc(12, 2000)
        self.delay_sim_time(1, reason="camera trigger to register")
        self.set_rc(12, 1000)
        self.assert_received_message_field_values('CAMERA_FEEDBACK', {
            "roll": math.degrees(self.assert_receive_message('ATTITUDE').roll),
        }, check_context=True, epsilon=5.0)

        self.fly_home_land_and_disarm()

    def ThrottleFailsafe(self):
        '''Fly throttle failsafe'''
        self.change_mode('MANUAL')
        m = self.assert_receive_message('SYS_STATUS')
        receiver_bit = mavutil.mavlink.MAV_SYS_STATUS_SENSOR_RC_RECEIVER
        self.progress("Testing receiver enabled")
        if (not (m.onboard_control_sensors_enabled & receiver_bit)):
            raise PreconditionFailedException()
        self.progress("Testing receiver present")
        if (not (m.onboard_control_sensors_present & receiver_bit)):
            raise PreconditionFailedException()
        self.progress("Testing receiver health")
        if (not (m.onboard_control_sensors_health & receiver_bit)):
            raise PreconditionFailedException()

        self.progress("Ensure we know original throttle value")
        self.wait_rc_channel_value(3, 1000)

        self.set_parameter("THR_FS_VALUE", 960)
        self.progress("Failing receiver (throttle-to-950)")
        self.context_collect("HEARTBEAT")
        self.set_parameter("SIM_RC_FAIL", 2) # throttle-to-950
        self.wait_mode('RTL') # long failsafe
        if (self.get_mode_from_mode_mapping("CIRCLE") not in
                [x.custom_mode for x in self.context_stop_collecting("HEARTBEAT")]):
            raise NotAchievedException("Did not go via circle mode")
        self.progress("Ensure we've had our throttle squashed to 950")
        self.wait_rc_channel_value(3, 950)
        self.do_timesync_roundtrip()
        m = self.assert_receive_message('SYS_STATUS')
        self.progress("Got (%s)" % str(m))
        self.progress("Testing receiver enabled")
        if (not (m.onboard_control_sensors_enabled & receiver_bit)):
            raise NotAchievedException("Receiver not enabled")
        self.progress("Testing receiver present")
        if (not (m.onboard_control_sensors_present & receiver_bit)):
            raise NotAchievedException("Receiver not present")
        # skip this until RC is fixed
#        self.progress("Testing receiver health")
#        if (m.onboard_control_sensors_health & receiver_bit):
#            raise NotAchievedException("Sensor healthy when it shouldn't be")
        self.set_parameter("SIM_RC_FAIL", 0)
        # wait for RC to be fetched from SITL and the receiver to recover
        self.wait_sensor_state(receiver_bit, True, True, True)
        self.do_timesync_roundtrip()
        m = self.assert_receive_message('SYS_STATUS')
        self.progress("Testing receiver enabled")
        if (not (m.onboard_control_sensors_enabled & receiver_bit)):
            raise NotAchievedException("Receiver not enabled")
        self.progress("Testing receiver present")
        if (not (m.onboard_control_sensors_present & receiver_bit)):
            raise NotAchievedException("Receiver not present")
        self.progress("Testing receiver health")
        if (not (m.onboard_control_sensors_health & receiver_bit)):
            raise NotAchievedException("Receiver not healthy2")
        self.change_mode('MANUAL')

        self.progress("Failing receiver (no-pulses)")
        self.context_collect("HEARTBEAT")
        self.set_parameter("SIM_RC_FAIL", 1) # no-pulses
        self.wait_mode('RTL') # long failsafe
        if (self.get_mode_from_mode_mapping("CIRCLE") not in
                [x.custom_mode for x in self.context_stop_collecting("HEARTBEAT")]):
            raise NotAchievedException("Did not go via circle mode")
        self.do_timesync_roundtrip()
        m = self.assert_receive_message('SYS_STATUS')
        self.progress("Got (%s)" % str(m))
        self.progress("Testing receiver enabled")
        if (not (m.onboard_control_sensors_enabled & receiver_bit)):
            raise NotAchievedException("Receiver not enabled")
        self.progress("Testing receiver present")
        if (not (m.onboard_control_sensors_present & receiver_bit)):
            raise NotAchievedException("Receiver not present")
        self.progress("Testing receiver health")
        if (m.onboard_control_sensors_health & receiver_bit):
            raise NotAchievedException("Sensor healthy when it shouldn't be")
        self.progress("Making RC work again")
        self.set_parameter("SIM_RC_FAIL", 0)
        self.progress("Giving receiver time to recover")
        self.wait_sensor_state(receiver_bit, True, True, True)
        self.do_timesync_roundtrip()
        m = self.assert_receive_message('SYS_STATUS')
        self.progress("Testing receiver enabled")
        if (not (m.onboard_control_sensors_enabled & receiver_bit)):
            raise NotAchievedException("Receiver not enabled")
        self.progress("Testing receiver present")
        if (not (m.onboard_control_sensors_present & receiver_bit)):
            raise NotAchievedException("Receiver not present")
        self.progress("Testing receiver health")
        if (not (m.onboard_control_sensors_health & receiver_bit)):
            raise NotAchievedException("Receiver not healthy")
        self.change_mode('MANUAL')

        self.progress("Ensure long failsafe can trigger when short failsafe disabled")
        self.context_push()
        self.context_collect("STATUSTEXT")
        self.set_parameters({
            "FS_SHORT_ACTN": 3, # 3 means disabled
            "SIM_RC_FAIL": 1,
        })
        self.wait_statustext("Long failsafe on", check_context=True)
        self.wait_mode("RTL")
#            self.context_clear_collection("STATUSTEXT")
        self.set_parameter("SIM_RC_FAIL", 0)
        self.wait_text("Long Failsafe Cleared", check_context=True)
        self.change_mode("MANUAL")

        self.progress("Trying again with THR_FS_VALUE")
        self.set_parameters({
            "THR_FS_VALUE": 960,
            "SIM_RC_FAIL": 2,
        })
        self.wait_statustext("Long Failsafe on", check_context=True)
        self.wait_mode("RTL")
        self.context_pop()

        self.start_subtest("Not use RC throttle input when THR_FAILSAFE==2")
        self.takeoff(100)
        self.set_rc(3, 1800)
        self.set_rc(1, 2000)
        self.wait_attitude(desroll=45, timeout=1)
        self.context_push()
        self.set_parameters({
            "THR_FAILSAFE": 2,
            "SIM_RC_FAIL": 1,  # no pulses
        })
        self.delay_sim_time(1, reason="failsafe to take effect")
        self.wait_attitude(desroll=0, timeout=5)
        self.assert_servo_channel_value(3, self.get_parameter("RC3_MIN"))
        self.set_parameters({
            "SIM_RC_FAIL": 0,  # fix receiver
        })
        self.zero_throttle()
        self.disarm_vehicle(force=True)
        self.context_pop()
        self.reboot_sitl()

    def ThrottleFailsafeFence(self):
        '''Fly fence survives throttle failsafe'''
        fence_bit = mavutil.mavlink.MAV_SYS_STATUS_GEOFENCE

        self.progress("Checking fence is not present before being configured")
        m = self.assert_receive_message('SYS_STATUS')
        self.progress("Got (%s)" % str(m))
        if (m.onboard_control_sensors_enabled & fence_bit):
            raise NotAchievedException("Fence enabled before being configured")

        self.change_mode('MANUAL')
        self.wait_ready_to_arm()

        self.load_fence("CMAC-fence.txt")

        self.set_parameter("RC7_OPTION", 11) # AC_Fence uses Aux switch functionality
        self.set_parameter("FENCE_ACTION", 4) # Fence action Brake
        self.set_rc_from_map({
            3: 1000,
            7: 2000,
        }) # Turn fence on with aux function

        m = self.assert_receive_message('FENCE_STATUS', timeout=2, verbose=True)

        self.progress("Checking fence is initially OK")
        self.wait_sensor_state(mavutil.mavlink.MAV_SYS_STATUS_GEOFENCE,
                               present=True,
                               enabled=True,
                               healthy=True,
                               verbose=True,
                               timeout=30)

        self.set_parameter("THR_FS_VALUE", 960)
        self.progress("Failing receiver (throttle-to-950)")
        self.set_parameter("SIM_RC_FAIL", 2) # throttle-to-950
        self.wait_mode("CIRCLE")
        self.delay_sim_time(1, reason="fence status to update") # give
        self.do_timesync_roundtrip()

        self.progress("Checking fence is OK after receiver failure (bind-values)")
        fence_bit = mavutil.mavlink.MAV_SYS_STATUS_GEOFENCE
        m = self.assert_receive_message('SYS_STATUS')
        if (not (m.onboard_control_sensors_enabled & fence_bit)):
            raise NotAchievedException("Fence not enabled after RC fail")
        self.do_fence_disable() # Ensure the fence is disabled after test

    def NoShortFailsafe(self):
        '''No short failsafe in auto mode'''
        self.set_parameters({
            "FS_GCS_ENABL": 1, # GCS failsafe : heartbeat
            "FS_SHORT_ACTN": 0, # Short failsafe action: ignore if in auto|guided|loiter, otherwise circle
            "FS_LONG_ACTN": 0, # Long failsafe action: continue
            "RTL_AUTOLAND": 1,
            "MAV_GCS_SYSID": self.mav.source_system,
        })
        self.start_flying_simple_relhome_mission([
            (mavutil.mavlink.MAV_CMD_NAV_TAKEOFF, 0, 0, 30),
            (mavutil.mavlink.MAV_CMD_NAV_WAYPOINT, 800, 0, 0),
            (mavutil.mavlink.MAV_CMD_NAV_WAYPOINT, 800, 800, 0),
        ])
        self.wait_current_waypoint(2)
        self.progress("Disconnecting GCS")
        self.set_heartbeat_rate(0)
        self.delay_sim_time(10, reason="short failsafe window to pass")
        self.wait_mode("AUTO", timeout=10)
        self.set_heartbeat_rate(self.speedup)
        self.fly_home_land_and_disarm()

    def GCSFailsafe(self):
        '''Ensure Long-Failsafe works on GCS loss'''
        self.start_subtest("Test Failsafe: RTL")
        self.load_sample_mission()
        self.set_parameters({
            "FS_GCS_ENABL": 1,
            "FS_LONG_ACTN": 1,
            "RTL_AUTOLAND": 1,
            "MAV_GCS_SYSID": self.mav.source_system,
        })
        self.takeoff()
        self.change_mode('LOITER')
        self.progress("Disconnecting GCS")
        self.set_heartbeat_rate(0)
        self.wait_mode("RTL", timeout=10)
        self.set_heartbeat_rate(self.speedup)
        self.end_subtest("Completed RTL Failsafe test")

        self.start_subtest("Test Failsafe: FBWA Glide")
        self.set_parameters({
            "FS_LONG_ACTN": 2,
        })
        self.change_mode('AUTO')
        self.progress("Disconnecting GCS")
        self.set_heartbeat_rate(0)
        self.wait_mode("FBWA", timeout=10)
        self.set_heartbeat_rate(self.speedup)
        self.end_subtest("Completed FBWA Failsafe test")

        self.start_subtest("Test Failsafe: Deploy Parachute")
        self.load_mission("plane-parachute-mission.txt")
        self.set_current_waypoint(1)
        self.setup_simulated_parachute({"FS_LONG_ACTN": 3})
        self.change_mode("AUTO")
        self.progress("Disconnecting GCS")
        self.set_heartbeat_rate(0)
        self.wait_statustext("BANG", timeout=60)
        self.set_heartbeat_rate(self.speedup)
        self.disarm_vehicle(force=True)
        self.reboot_sitl()
        self.end_subtest("Completed Parachute Failsafe test")

    def TestGripperMission(self):
        '''Test Gripper mission items'''
        self.set_parameter("RTL_AUTOLAND", 1)
        self.load_mission("plane-gripper-mission.txt")
        self.set_current_waypoint(1)
        self.change_mode('AUTO')
        self.wait_ready_to_arm()
        self.arm_vehicle()
        self.wait_statustext("Gripper Grabbed", timeout=60)
        self.wait_statustext("Gripper Released", timeout=60)
        self.wait_statustext("Auto disarmed", timeout=60)

    def assert_fence_sys_status(self, present, enabled, health):
        self.wait_sensor_state(mavutil.mavlink.MAV_SYS_STATUS_GEOFENCE, present, enabled, health)

    def MODE_SWITCH_RESET(self):
        '''test the MODE_SWITCH_RESET auxiliary function'''
        self.set_parameters({
            "RC9_OPTION": 96,
        })

        self.progress("Using RC to change modes")
        self.set_rc(8, 1500)
        self.wait_mode('FBWA')

        self.progress("Killing RC to engage RC failsafe")
        self.set_parameter('SIM_RC_FAIL', 1)
        self.wait_mode('RTL')

        self.progress("Reinstating RC")
        self.set_parameter('SIM_RC_FAIL', 0)

        self.progress("Ensuring we don't automatically revert mode")
        self.delay_sim_time(2, reason="mode to not automatically revert")
        self.assert_mode_is('RTL')

        self.progress("Ensuring MODE_SWITCH_RESET switch resets to pre-failsafe mode")
        self.set_rc(9, 2000)
        self.wait_mode('FBWA')

    def FenceStatic(self):
        '''Test Basic Fence Functionality'''
        self.progress("Checking for bizarre healthy-when-not-present-or-enabled")
        self.set_parameter("FENCE_TYPE", 4) # Start by only setting polygon fences, otherwise fence will report present
        self.assert_fence_sys_status(False, False, True)
        self.load_fence("CMAC-fence.txt")
        m = self.mav.recv_match(type='FENCE_STATUS', blocking=True, timeout=2)
        if m is not None:
            raise NotAchievedException("Got FENCE_STATUS unexpectedly")
        self.set_parameter("FENCE_ACTION", 0) # report only
        self.assert_fence_sys_status(True, False, True)
        self.set_parameter("FENCE_ACTION", 1) # RTL
        self.assert_fence_sys_status(True, False, True)
        self.do_fence_enable()
        self.assert_fence_sys_status(True, True, True)
        m = self.assert_receive_message('FENCE_STATUS', timeout=2)
        if m.breach_status:
            raise NotAchievedException("Breached fence unexpectedly (%u)" %
                                       (m.breach_status))
        self.do_fence_disable()
        self.assert_fence_sys_status(True, False, True)
        self.set_parameter("FENCE_ACTION", 1)
        self.assert_fence_sys_status(True, False, True)
        self.set_parameter("FENCE_ACTION", 0)
        self.assert_fence_sys_status(True, False, True)
        self.clear_fence()
        if self.get_parameter("FENCE_TOTAL") != 0:
            raise NotAchievedException("Expected zero points remaining")
        self.assert_fence_sys_status(False, False, True)
        self.progress("Trying to enable fence with no points")
        self.do_fence_enable(want_result=mavutil.mavlink.MAV_RESULT_FAILED)

        # test a rather unfortunate behaviour:
        self.progress("Killing a live fence with fence-clear")
        self.load_fence("CMAC-fence.txt")
        self.set_parameter("FENCE_ACTION", 1) # AC_FENCE_ACTION_RTL_AND_LAND == 1. mavutil.mavlink.FENCE_ACTION_RTL == 4
        self.do_fence_enable()
        self.assert_fence_sys_status(True, True, True)
        self.clear_fence()
        self.wait_sensor_state(mavutil.mavlink.MAV_SYS_STATUS_GEOFENCE, False, False, True)
        if self.get_parameter("FENCE_TOTAL") != 0:
            raise NotAchievedException("Expected zero points remaining")
        self.assert_fence_sys_status(False, False, True)
        self.do_fence_disable()

        # ensure that a fence is present if it is tin can, min alt or max alt
        self.progress("Test other fence types (tin-can, min alt, max alt")
        self.set_parameter("FENCE_TYPE", 1) # max alt
        self.assert_fence_sys_status(True, False, True)
        self.set_parameter("FENCE_TYPE", 8) # min alt
        self.assert_fence_sys_status(True, False, True)
        self.set_parameter("FENCE_TYPE", 2) # tin can
        self.assert_fence_sys_status(True, False, True)

        # Test cannot arm if outside of fence and fence is enabled
        self.progress("Test Arming while vehicle below FENCE_ALT_MIN")
        default_fence_alt_min = self.get_parameter("FENCE_ALT_MIN")
        self.set_parameter("FENCE_ALT_MIN", 50)
        self.set_parameter("FENCE_TYPE", 8) # Enables minimum altitude breaches
        self.do_fence_enable()
        self.delay_sim_time(2, reason="breach to propagate") # Allow breach to propagate
        self.assert_fence_enabled()

        self.try_arm(False, "Vehicle breaching Min Alt fence")
        self.do_fence_disable()
        self.set_parameter("FENCE_ALT_MIN", default_fence_alt_min)

        # Test arming outside inclusion zone
        self.progress("Test arming while Vehicle breaching of inclusion zone")
        self.set_parameter("FENCE_TYPE", 4) # Enables polygon fence types
        self.upload_fences_from_locations([(
            mavutil.mavlink.MAV_CMD_NAV_FENCE_POLYGON_VERTEX_INCLUSION, [
                Location.latlon_only(1.000, 1.000),
                Location.latlon_only(1.000, 1.001),
                Location.latlon_only(1.001, 1.001),
                Location.latlon_only(1.001, 1.000)
            ]
        )])
        self.delay_sim_time(10, reason="fence check to run") # let fence check run so it loads-from-eeprom
        self.do_fence_enable()
        self.assert_fence_enabled()
        self.delay_sim_time(2, reason="breach to propagate") # Allow breach to propagate
        self.try_arm(False, "Vehicle breaching Polygon fence")
        self.do_fence_disable()
        self.clear_fence()

        self.progress("Test arming while vehicle inside exclusion zone")
        self.set_parameter("FENCE_TYPE", 4) # Enables polygon fence types
        home_loc = self.get_location()
        locs = [
            Location.latlon_only(home_loc.lat - 0.001, home_loc.lng - 0.001),
            Location.latlon_only(home_loc.lat - 0.001, home_loc.lng + 0.001),
            Location.latlon_only(home_loc.lat + 0.001, home_loc.lng + 0.001),
            Location.latlon_only(home_loc.lat + 0.001, home_loc.lng - 0.001),
        ]
        self.upload_fences_from_locations([
            (mavutil.mavlink.MAV_CMD_NAV_FENCE_POLYGON_VERTEX_EXCLUSION, locs),
        ])
        self.delay_sim_time(10, reason="fence check to run") # let fence check run so it loads-from-eeprom
        self.do_fence_enable()
        self.assert_fence_enabled()
        self.delay_sim_time(2, reason="breach to propagate") # Allow breach to propagate
        self.try_arm(False, "Vehicle breaching Polygon fence")
        self.do_fence_disable()

    def test_fence_breach_circle_at(self, loc, disable_on_breach=False):
        self.load_fence("CMAC-fence.txt")
        want_radius = 100
        # when ArduPlane is fixed, remove this fudge factor
        REALLY_BAD_FUDGE_FACTOR = 1.16
        expected_radius = REALLY_BAD_FUDGE_FACTOR * want_radius
        self.set_parameters({
            "RTL_RADIUS": want_radius,
            "NAVL1_LIM_BANK": 60,
            "FENCE_ACTION": 1, # AC_FENCE_ACTION_RTL_AND_LAND == 1. mavutil.mavlink.FENCE_ACTION_RTL == 4
        })

        self.wait_ready_to_arm()  # need an origin to load fence

        self.do_fence_enable()
        self.assert_fence_sys_status(True, True, True)

        self.takeoff(alt=45, alt_max=300)

        tstart = self.get_sim_time()
        while True:
            if self.get_sim_time() - tstart > 30:
                raise NotAchievedException("Did not breach fence")
            m = self.assert_receive_message('FENCE_STATUS', timeout=2)
            if m.breach_status == 0:
                continue

            # we've breached; check our state;
            if m.breach_type != mavutil.mavlink.FENCE_BREACH_BOUNDARY:
                raise NotAchievedException("Unexpected breach type %u" %
                                           (m.breach_type,))
            if m.breach_count == 0:
                raise NotAchievedException("Unexpected breach count %u" %
                                           (m.breach_count,))
            self.assert_fence_sys_status(True, True, False)
            break

        self.wait_circling_point_with_radius(loc, expected_radius)
        self.do_fence_disable()
        self.disarm_vehicle(force=True)
        self.reboot_sitl()

    def FenceRTL(self):
        '''Test Fence RTL'''
        self.progress("Testing FENCE_ACTION_RTL no rally point")
        # have to disable the fence once we've breached or we breach
        # it as part of the loiter-at-home!
        self.test_fence_breach_circle_at(self.home_position_as_location())

    def FenceRTLRally(self):
        '''Test Fence RTL Rally'''
        self.progress("Testing FENCE_ACTION_RTL with rally point")

        self.wait_ready_to_arm()
        loc = self.offset_location_ne(self.home_position_as_location(), 50, -50)
        loc.set_alt_m(15, AltFrame.ABOVE_HOME)
        self.upload_rally_points_from_locations([loc])
        self.test_fence_breach_circle_at(loc)

    def FenceRetRally(self):
        """ Tests the FENCE_RET_RALLY flag, either returning to fence return point,
            or rally point """
        target_system = 1
        target_component = 1
        self.progress("Testing FENCE_ACTION_RTL with fence rally point")

        self.wait_ready_to_arm()

        # Grab a location for fence return point, and upload it.
        fence_loc = self.home_position_as_location()
        self.location_offset_ne(fence_loc, 50, 50)
        fence_return_mission_items = [
            self.mav.mav.mission_item_int_encode(
                target_system,
                target_component,
                0, # seq
                mavutil.mavlink.MAV_FRAME_GLOBAL_INT,
                mavutil.mavlink.MAV_CMD_NAV_FENCE_RETURN_POINT,
                0, # current
                0, # autocontinue
                0, # p1
                0, # p2
                0, # p3
                0, # p4
                int(fence_loc.lat * 1e7), # latitude
                int(fence_loc.lng * 1e7), # longitude
                0, # altitude
                mavutil.mavlink.MAV_MISSION_TYPE_FENCE
            )
        ]
        self.upload_using_mission_protocol(mavutil.mavlink.MAV_MISSION_TYPE_FENCE,
                                           fence_return_mission_items)
        self.delay_sim_time(1, reason="fence upload to complete")

        # Grab a location for rally point, and upload it.
        rally_loc = self.offset_location_ne(self.home_position_as_location(), -50, 50)
        rally_loc.set_alt_m(15, AltFrame.ABOVE_HOME)
        self.upload_rally_points_from_locations([rally_loc])

        return_radius = 100
        return_alt = 80
        self.set_parameters({
            "RTL_RADIUS": return_radius,
            "FENCE_ACTION": 6, # Set Fence Action to Guided
            "FENCE_TYPE": 8,   # Only use fence floor
            "FENCE_RET_ALT": return_alt,
        })
        self.do_fence_enable()
        self.assert_fence_enabled()

        self.takeoff(alt=15, alt_max=40)
        # Trigger fence breach, fly to rally location
        self.set_parameters({
            "FENCE_RET_RALLY": 1,
            "FENCE_ALT_MIN": 60,
        })
        self.wait_circling_point_with_radius(rally_loc, return_radius)
        self.set_parameter("FENCE_ALT_MIN", 0) # Clear fence breach

        # 10 second fence min retrigger time
        self.delay_sim_time(15, reason="fence retrigger timeout")

        # Fly up before re-triggering fence breach. Fly to fence return point
        self.change_altitude(30, relative=True)
        self.set_parameters({
            "FENCE_RET_RALLY": 0,
            "FENCE_ALT_MIN": 60,
        })
        self.wait_altitude(altitude_min=return_alt-3,
                           altitude_max=return_alt+3,
                           relative=True)
        self.wait_circling_point_with_radius(fence_loc, return_radius)
        self.do_fence_disable() # Disable fence so we can land
        self.fly_home_land_and_disarm() # Pack it up, we're going home.

    def TerrainRally(self):
        """ Tests terrain follow with a rally point """
        self.context_push()
        self.install_terrain_handlers_context()

        def terrain_following_above_80m(mav, m):
            if m.get_type() == 'TERRAIN_REPORT':
                if m.current_height < 50:
                    raise NotAchievedException(
                        "TERRAIN_REPORT.current_height below 50m %fm" % m.current_height)
            if m.get_type() == 'VFR_HUD':
                if m.groundspeed < 2:
                    raise NotAchievedException("hit ground")

        def terrain_wait_path(loc1, loc2, steps):
            '''wait till we have terrain for N steps from loc1 to loc2'''
            tstart = self.get_sim_time_cached()
            self.progress("Waiting for terrain data")
            while True:
                now = self.get_sim_time_cached()
                if now - tstart > 60:
                    raise NotAchievedException("Did not get correct required terrain")
                for i in range(steps):
                    lat = loc1.lat + i * (loc2.lat-loc1.lat)/steps
                    lon = loc1.lng + i * (loc2.lng-loc1.lng)/steps
                    self.mav.mav.terrain_check_send(int(lat*1.0e7), int(lon*1.0e7))

                report = self.assert_receive_message('TERRAIN_REPORT', timeout=60)
                self.progress("Terrain pending=%u" % report.pending)
                if report.pending == 0:
                    break
            self.progress("Got required terrain")

        self.wait_ready_to_arm()
        homeloc = self.get_location()
        homeloc_alt_amsl = homeloc.get_alt_m(AltFrame.ABSOLUTE)

        guided_loc = Location(-35.39723762, 149.07284612, homeloc_alt_amsl+99.0, AltFrame.ABSOLUTE)
        rally_loc = Location(-35.3654952000, 149.1558698000, homeloc_alt_amsl+100, AltFrame.ABSOLUTE)

        # the reposition and rally altitudes below go out in the terrain
        # frame while carrying these AMSL magnitudes; that mismatch is the
        # alt-frame confusion this (disabled) test is filed against, so it
        # is preserved rather than fixed here
        guided_loc_terrain = guided_loc.copy()
        guided_loc_terrain.set_alt_m(homeloc_alt_amsl+99.0, AltFrame.ABOVE_TERRAIN)

        terrain_wait_path(homeloc, rally_loc, 10)

        # set a rally point to the west of home
        self.upload_rally_points_from_locations([rally_loc])

        self.set_parameter("TKOFF_ALT", 100)
        self.change_mode("TAKEOFF")
        self.wait_ready_to_arm()
        self.arm_vehicle()
        self.set_parameter("TERRAIN_FOLLOW", 1)
        self.wait_altitude(90, 120, timeout=30, relative=True)
        self.progress("Done takeoff")

        self.install_message_hook_context(terrain_following_above_80m)

        self.change_mode("GUIDED")
        self.send_do_reposition(guided_loc_terrain)
        self.progress("Flying to guided location")
        self.wait_location(
            guided_loc,
            accuracy=200,
            timeout=600,
            height_accuracy=10,
        )

        self.progress("Reached guided location")
        self.set_parameter("RALLY_LIMIT_KM", 50)
        self.change_mode("RTL")
        self.progress("Flying to rally point")
        self.wait_location(
            rally_loc,
            accuracy=200,
            timeout=600,
            height_accuracy=10,
        )
        self.progress("Reached rally point with TERRAIN_FOLLOW")

        # Fly back to guided location
        self.change_mode("GUIDED")
        self.send_do_reposition(guided_loc_terrain)
        self.progress("Flying to back to guided location")

        # Disable terrain following and re-load rally point with relative to terrain altitude
        self.set_parameter("TERRAIN_FOLLOW", 0)

        rally_item = [self.create_MISSION_ITEM_INT(
            mavutil.mavlink.MAV_CMD_NAV_RALLY_POINT,
            x=int(rally_loc.lat*1e7),
            y=int(rally_loc.lng*1e7),
            z=rally_loc.get_alt_m(AltFrame.ABSOLUTE),
            frame=mavutil.mavlink.MAV_FRAME_GLOBAL_TERRAIN_ALT,
            mission_type=mavutil.mavlink.MAV_MISSION_TYPE_RALLY
        )]
        self.correct_wp_seq_numbers(rally_item)
        self.check_rally_upload_download(rally_item)

        # Once back at guided location re-trigger RTL
        self.wait_location(
            guided_loc,
            accuracy=200,
            timeout=600,
            height_accuracy=10,
        )

        self.change_mode("RTL")
        self.progress("Flying to rally point")
        self.wait_location(
            rally_loc,
            accuracy=200,
            timeout=600,
            height_accuracy=10,
        )
        self.progress("Reached rally point with terrain alt frame")

        self.context_pop()
        self.disarm_vehicle(force=True)
        self.reboot_sitl()

    def setup_simulated_parachute(self, extra_parameters=None):
        '''set the vehicle and its simulated parachute up, without firing it

        SIM_Parachute deploys as soon as the PWM on SIM_PARA_PIN reads 1250
        or more, and it begins watching that pin the moment the pin number
        is set.  Setting the pin in the same set_parameters() call as the
        release servo's function therefore races the servo output: until
        AP_Parachute has driven the channel to CHUTE_SERVO_OFF (1100 by
        default, below the trigger) it still holds whatever the last test
        left there, and anything at or above 1250 fires the chute during
        setup.  The "BANG!" then arrives before the test starts waiting for
        it, and the real release later in the test is silent because the
        chute has already gone.

        So configure the vehicle first, wait for the release servo to reach
        its off position, and only then let the simulation watch the pin.
        '''
        parameters = {
            "CHUTE_ENABLED": 1,
            "CHUTE_TYPE": 10,
            "SERVO9_FUNCTION": 27,
        }
        if extra_parameters is not None:
            parameters.update(extra_parameters)
        self.set_parameters(parameters)
        self.wait_servo_channel_value(9, 1250, comparator=operator.lt, timeout=10)
        self.set_parameters({
            "SIM_PARA_PIN": 9,
            "SIM_PARA_ENABLE": 1,
        })

    def Parachute(self):
        '''Test Parachute'''
        self.set_rc(9, 1000)
        self.setup_simulated_parachute()

        self.load_mission("plane-parachute-mission.txt")
        self.set_current_waypoint(1)
        self.change_mode('AUTO')
        self.wait_ready_to_arm()
        self.arm_vehicle()
        self.wait_statustext("BANG", timeout=60)
        self.disarm_vehicle(force=True)
        self.reboot_sitl()

    def ParachuteSinkRate(self):
        '''Test Parachute (SinkRate triggering)'''
        self.set_rc(9, 1000)
        self.setup_simulated_parachute({"CHUTE_CRT_SINK": 9})

        self.progress("Takeoff")
        self.takeoff(alt=300)

        self.progress("Diving")
        self.set_rc(2, 2000)
        self.wait_statustext("BANG", timeout=60)

        self.disarm_vehicle(force=True)
        self.reboot_sitl()

    def run_subtest(self, desc, func):
        self.start_subtest(desc)
        func()

    def fly_ahrs2_test(self):
        '''check secondary estimator is looking OK'''

        ahrs2 = self.assert_receive_message('AHRS2', verbose=1)
        gpi = self.assert_receive_message('GLOBAL_POSITION_INT', verbose=1)
        if self.get_distance_int(gpi, ahrs2) > 10:
            raise NotAchievedException("Secondary location looks bad")

        # secondary altitude should be close to the primary altitude
        # (AHRS2.altitude is MSL in metres, GLOBAL_POSITION_INT.alt is
        # MSL in mm):
        if abs(ahrs2.altitude - gpi.alt * 1.0e-3) > 10:
            raise NotAchievedException(
                "Secondary altitude looks bad (want=%f got=%f)" %
                (gpi.alt * 1.0e-3, ahrs2.altitude))

        # secondary yaw should match the simulated yaw; check_attitudes_match
        # only checks AHRS2 roll and pitch:
        simstate = self.assert_receive_message('SIMSTATE', verbose=1)
        want = math.degrees(simstate.yaw)
        got = math.degrees(ahrs2.yaw)
        if abs(mavextra.angle_diff(want, got)) > 15:
            raise NotAchievedException(
                "Secondary yaw looks bad (want=%f got=%f)" % (want, got))

        self.check_attitudes_match()

    def AHRS2Logging(self):
        '''check the secondary AHRS estimate is logged to the AHR2 message'''
        self.wait_ready_to_arm()
        self.takeoff(alt=100, mode='TAKEOFF')
        self.change_mode('LOITER')
        # loiter long enough to sweep the yaw through a full circle so the
        # secondary yaw and position are meaningfully exercised:
        self.delay_sim_time(60, reason="sweep yaw through a circle")
        self.fly_home_land_and_disarm()
        self.assert_AHR2_log_matches_primary()

    def AHRS2NoSecondaryEstimate(self):
        '''check AHRS2 mavlink reporting when the secondary estimator has no
        valid estimate.  Disabling the EKFs leaves DCM as the active
        estimator and the configured-but-unstarted EKF3 as the secondary;
        that secondary has no valid attitude or location.'''
        self.context_push()
        try:
            self.set_parameters({
                "EK2_ENABLE": 0,
                "EK3_ENABLE": 0,
                "AHRS_EKF_TYPE": 3,
            })
            self.reboot_sitl()
            self.delay_sim_time(5, reason="allow DCM to settle")
            # the secondary estimate is now reported even though it has no
            # valid location; AHRS2 is sent regardless of estimate validity:
            self.assert_receive_message('AHRS2', timeout=5)
        finally:
            self.context_pop()
            self.reboot_sitl()

    def MainFlight(self):
        '''Lots of things in one flight'''
        self.change_mode('MANUAL')

        self.progress("Asserting we do support transfer of fence via mission item protocol")
        self.assert_capability(mavutil.mavlink.MAV_PROTOCOL_CAPABILITY_MISSION_FENCE)

        self.run_subtest("Takeoff", self.takeoff)

        self.run_subtest("Set Attitude Target", self.set_attitude_target)

        self.run_subtest("Fly left circuit", self.fly_left_circuit)

        self.run_subtest("Left roll", lambda: self.axial_left_roll(1))

        self.run_subtest("Inside loop", self.inside_loop)

        self.run_subtest("Stabilize test", self.test_stabilize)

        self.run_subtest("ACRO test", self.test_acro)

        self.run_subtest("FBWB test", self.test_FBWB)

        self.run_subtest("CRUISE test", lambda: self.test_FBWB(mode='CRUISE'))

        self.run_subtest("RTL test", self.fly_RTL)

        self.run_subtest("LOITER test", self.fly_LOITER)

        self.run_subtest("CIRCLE test", self.fly_CIRCLE)

        self.run_subtest("AHRS2 test", self.fly_ahrs2_test)

        self.run_subtest("Mission test",
                         lambda: self.fly_mission("ap1.txt", strict=False))

    def PitotBlockage(self):
        '''Test detection and isolation of a blocked pitot tube'''
        self.set_parameters({
            "ARSPD_OPTIONS": 15,
            "ARSPD_USE": 1,
            "SIM_WIND_SPD": 7,
            "SIM_WIND_DIR": 0,
            "ARSPD_WIND_MAX": 15,
        })
        self.takeoff(alt=50, mode='TAKEOFF')
        # simulate the effect of a blocked pitot tube
        self.set_parameter("ARSPD_RATIO", 0.1)
        self.wait_parameter_value("ARSPD_USE", 0, timeout=15)
        self.progress("Faulty Sensor Disabled")
        self.delay_sim_time(20, reason="sensor fault monitoring period")
        # simulate the effect of blockage partially clearing
        self.set_parameter("ARSPD_RATIO", 1.0)
        self.delay_sim_time(60, reason="partial blockage monitoring period")
        if (self.get_parameter("ARSPD_USE") == 0):
            self.progress("Faulty Sensor Remains Disabled")
        else:
            raise NotAchievedException("Fault Sensor Re-Enabled")
        # simulate the effect of blockage fully clearing
        self.set_parameter("ARSPD_RATIO", 2.0)
        self.wait_parameter_value("ARSPD_USE", 1, timeout=70)
        self.progress("Sensor Re-Enabled")
        self.fly_home_land_and_disarm()

    def AIRSPEED_AUTOCAL(self):
        '''Test AIRSPEED_AUTOCAL'''
        self.progress("Ensure no AIRSPEED_AUTOCAL on ground")
        self.set_parameters({
            "ARSPD_AUTOCAL": 1,
            "ARSPD_PIN": 2,
            "ARSPD_RATIO": 0,
            "ARSPD2_RATIO": 4,
            "ARSPD2_TYPE": 3,  # MS5525
            "ARSPD2_BUS": 1,
            "ARSPD2_AUTOCAL": 1,
            "SIM_ARSPD2_OFS": 1900,  # default is 2013

            "RTL_AUTOLAND": 1,
        })
        self.context_collect('STATUSTEXT')
        self.reboot_sitl()

        self.assert_not_receive_message('AIRSPEED_AUTOCAL', timeout=5)

        # these are boot-time calibration messages:
        self.wait_statustext('Airspeed 1 calibrated', check_context=True, timeout=30)
        self.wait_statustext('Airspeed 2 calibrated', check_context=True)

        mission_filepath = "flaps.txt"
        self.load_mission(mission_filepath)
        self.wait_ready_to_arm()
        self.arm_vehicle()
        self.change_mode("AUTO")
        self.progress("Ensure AIRSPEED_AUTOCAL in air")
        self.assert_receive_message('AIRSPEED_AUTOCAL')
        self.wait_statustext("Airspeed 0 ratio reset", check_context=True, timeout=70)
        self.wait_statustext("Airspeed 1 ratio reset", check_context=True, timeout=70)
        self.fly_home_land_and_disarm()

    def deadreckoning_main(self, disable_airspeed_sensor=False):
        self.context_push()
        self.set_parameter("EK3_OPTIONS", 1)
        self.set_parameter("AHRS_OPTIONS", 3)
        self.set_parameter("LOG_REPLAY", 1)
        self.reboot_sitl()
        self.wait_ready_to_arm()

        if disable_airspeed_sensor:
            max_allowed_divergence = 300
        else:
            max_allowed_divergence = 150
        self.install_message_hook_context(vehicle_test_suite.TestSuite.ValidateGlobalPositionIntAgainstSimState(self, max_allowed_divergence=max_allowed_divergence))  # noqa

        try:
            # wind is from the West:
            self.set_parameter("SIM_WIND_DIR", 270)
            # light winds:
            self.set_parameter("SIM_WIND_SPD", 10)
            if disable_airspeed_sensor:
                self.set_parameter("ARSPD_USE", 0)

            target_alt = 100
            loc = self.offset_location_ne(self.home_position_as_location(), 500, 500)
            loc.set_alt_m(target_alt, AltFrame.ABOVE_HOME)
            self.takeoff(50)
            self.run_cmd_int(
                mavutil.mavlink.MAV_CMD_DO_REPOSITION,
                p1=0,
                p2=mavutil.mavlink.MAV_DO_REPOSITION_FLAGS_CHANGE_MODE,
                p5=int(loc.lat * 1e7),
                p6=int(loc.lng * 1e7),
                p7=target_alt,    # alt
                frame=mavutil.mavlink.MAV_FRAME_GLOBAL_RELATIVE_ALT_INT,
            )
            self.wait_location(loc, accuracy=100, height_accuracy=10)
            self.progress("Orbit with GPS and learn wind")
            # allow longer to learn wind if there is no airspeed sensor
            if disable_airspeed_sensor:
                self.delay_sim_time(180, reason="wind learning without airspeed sensor")
            else:
                self.delay_sim_time(20, reason="wind learning in orbit")
            self.set_parameter("SIM_GPS1_ENABLE", 0)
            self.progress("Continue orbit without GPS")
            self.delay_sim_time(20, reason="dead reckoning data collection")
            self.change_mode("RTL")
            self.wait_distance_to_home(100, 200, timeout=200)
            # go into LOITER to create additional time for a GPS re-enable test
            self.change_mode("LOITER")
            self.set_parameter("SIM_GPS1_ENABLE", 1)
            t_enabled = self.get_sim_time()
            # The EKF should wait for GPS checks to pass when we are still able to navigate using dead reckoning
            # to prevent bad GPS being used when coming back after loss of lock due to interence.
            self.wait_ekf_flags(mavutil.mavlink.ESTIMATOR_POS_HORIZ_ABS, 0, timeout=15)
            if self.get_sim_time() < (t_enabled+9):
                raise NotAchievedException("GPS use re-started too quickly")
            # wait for EKF and vehicle position to stabilise, then test response to jamming
            self.delay_sim_time(20, reason="EKF and position to stabilise")

            self.set_parameter("AHRS_OPTIONS", 1)
            self.set_parameter("SIM_GPS1_JAM", 1)
            self.delay_sim_time(13, reason="GPS jamming simulation")
            self.set_parameter("SIM_GPS1_JAM", 0)
            t_enabled = self.get_sim_time()
            # The EKF should wait for GPS checks to pass when we are still able to navigate using dead reckoning
            # to prevent bad GPS being used when coming back after loss of lock due to interence.
            # The EKF_STATUS_REPORT does not tell us when the good to align check passes, so the minimum time
            # value of 3.0 seconds is an arbitrary value set on inspection of dataflash logs from this test
            self.wait_ekf_flags(mavutil.mavlink.ESTIMATOR_POS_HORIZ_ABS, 0, timeout=20)
            time_since_jamming_stopped = self.get_sim_time() - t_enabled
            if time_since_jamming_stopped < 3:
                raise NotAchievedException("GPS use re-started %f sec after jamming stopped" % time_since_jamming_stopped)
            self.set_rc(3, 1000)
            self.fly_home_land_and_disarm()
        finally:
            pass

        self.context_pop()
        self.reboot_sitl()

    def Deadreckoning(self):
        '''Test deadreckoning support'''
        self.deadreckoning_main()

    def DeadreckoningNoAirSpeed(self):
        '''Test deadreckoning support with no airspeed sensor'''
        self.deadreckoning_main(disable_airspeed_sensor=True)

    def ClimbBeforeTurn(self):
        '''Test climb-before-turn'''
        self.wait_ready_to_arm()
        self.set_parameters({
            "FLIGHT_OPTIONS": 0,
            "RTL_ALTITUDE": 80,
            "RTL_AUTOLAND": 1,
        })
        takeoff_alt = 10
        self.takeoff(alt=takeoff_alt)
        self.change_mode("CRUISE")
        self.wait_distance_to_home(500, 1000, timeout=60)
        self.change_mode("RTL")
        expected_alt = self.get_parameter("RTL_ALTITUDE")

        home = self.home_position_as_location()
        distance = self.get_distance(home, self.get_location())

        self.wait_altitude(expected_alt - 10, expected_alt + 10, relative=True, timeout=80)

        new_distance = self.get_distance(home, self.get_location())
        # We should be closer to home.
        if new_distance > distance:
            raise NotAchievedException(
                "Expected to be closer to  home (was %fm, now %fm)."
                % (distance, new_distance)
            )

        self.fly_home_land_and_disarm()
        self.set_current_waypoint(0, check_afterwards=False)

        self.change_mode("MANUAL")
        self.set_rc(3, 1000)

        self.wait_ready_to_arm()
        self.set_parameters({
            "FLIGHT_OPTIONS": 16,
            "RTL_ALTITUDE": 100,
        })
        self.takeoff(alt=takeoff_alt)
        self.change_mode("CRUISE")
        self.wait_distance_to_home(500, 1000, timeout=60)
        self.change_mode("RTL")

        home = self.home_position_as_location()
        distance = self.get_distance(home, self.get_location())

        self.wait_altitude(expected_alt - 10, expected_alt + 10, relative=True, timeout=80)

        new_distance = self.get_distance(home, self.get_location())
        # We should be farther from to home.
        if new_distance < distance:
            raise NotAchievedException(
                "Expected to be farther from home (was %fm, now %fm)."
                % (distance, new_distance)
            )

        self.fly_home_land_and_disarm(timeout=240)

    def AltOffsetReset(self):
        '''Test automatic ALT_OFFSET reset'''
        reset_alt_offset_option = 1 << 17
        self.change_mode("MANUAL")
        self.set_parameters({
            "FLIGHT_OPTIONS": 0,
            "ALT_OFFSET": 100,
            "SOAR_ENABLE": 0,
        })

        self.change_mode("LOITER")
        self.wait_parameter_value("ALT_OFFSET", 100)

        self.context_collect("STATUSTEXT")
        self.set_parameter("FLIGHT_OPTIONS", reset_alt_offset_option)
        self.run_cmd_do_set_mode(
            "THERMAL",
            want_result=mavutil.mavlink.MAV_RESULT_FAILED,
        )
        self.assert_mode("LOITER")
        self.wait_text("Reset ALT_OFFSET", check_context=True)
        self.wait_parameter_value("ALT_OFFSET", 0)

        self.context_clear_collection("STATUSTEXT")
        self.set_parameter("ALT_OFFSET", 100)
        self.change_mode("MANUAL")
        self.wait_text("Reset ALT_OFFSET", check_context=True)
        self.wait_parameter_value("ALT_OFFSET", 0)

        self.upload_simple_relhome_mission([
            (mavutil.mavlink.MAV_CMD_NAV_WAYPOINT, 100, 0, 50),
            (mavutil.mavlink.MAV_CMD_NAV_WAYPOINT, 200, 0, 50),
        ])
        self.change_mode("AUTO")
        self.wait_current_waypoint(1)

        self.context_clear_collection("STATUSTEXT")
        self.set_parameter("ALT_OFFSET", 100)
        self.set_current_waypoint(2)
        self.wait_text("Reset ALT_OFFSET", check_context=True)
        self.wait_parameter_value("ALT_OFFSET", 0)

        # ALT_OFFSET always resets at boot, independently of FLIGHT_OPTIONS.
        self.set_parameters({
            "FLIGHT_OPTIONS": 0,
            "ALT_OFFSET": 100,
        })
        self.context_clear_collection("STATUSTEXT")
        self.reboot_sitl()
        self.wait_parameter_value("ALT_OFFSET", 0)

        # The reset is not saved, so the stored value is reset again next boot.
        self.context_clear_collection("STATUSTEXT")
        self.reboot_sitl()
        self.wait_parameter_value("ALT_OFFSET", 0)

    def RTL_CLIMB_MIN(self):
        '''Test RTL_CLIMB_MIN'''
        self.wait_ready_to_arm()
        rtl_climb_min = 100
        self.set_parameter("RTL_CLIMB_MIN", rtl_climb_min)
        takeoff_alt = 50
        self.takeoff(alt=takeoff_alt)
        self.change_mode('CRUISE')
        self.wait_distance_to_home(1000, 1500, timeout=60)
        post_cruise_alt = self.get_altitude(relative=True)
        self.change_mode('RTL')
        expected_alt = self.get_parameter("RTL_ALTITUDE")
        if expected_alt == -1:
            expected_alt = self.get_altitude(relative=True)

        # ensure we're about half-way-down at the half-way-home stage:
        self.wait_distance_to_nav_target(
            0,
            500,
            timeout=240,
        )
        alt = self.get_altitude(relative=True)
        expected_halfway_alt = expected_alt + (post_cruise_alt + rtl_climb_min - expected_alt)/2.0
        if abs(alt - expected_halfway_alt) > 30:
            raise NotAchievedException("Not half-way-down and half-way-home (want=%f got=%f" %
                                       (expected_halfway_alt, alt))
        self.progress("Half-way-down at half-way-home (want=%f vs got=%f)" %
                      (expected_halfway_alt, alt))

        rtl_radius = self.get_parameter("RTL_RADIUS")
        if rtl_radius == 0:
            rtl_radius = self.get_parameter("WP_LOITER_RAD")
        self.wait_distance_to_nav_target(
            0,
            rtl_radius,
            timeout=120,
        )
        alt = self.get_altitude(relative=True)
        if abs(alt - expected_alt) > 10:
            raise NotAchievedException(
                "Expected to have %fm altitude at end of RTL (got %f)" %
                (expected_alt, alt))
        self.fly_home_land_and_disarm()

    def sample_enable_parameter(self):
        return "Q_ENABLE"

    def RangeFinder(self):
        '''Test RangeFinder Basic Functionality'''
        self.progress("Making sure we don't ordinarily get RANGEFINDER")
        self.assert_not_receive_message('RANGEFINDER')
        self.assert_not_receive_message('DISTANCE_SENSOR')

        self.set_analog_rangefinder_parameters()

        self.reboot_sitl()

        self.context_set_message_rate_hz('RANGEFINDER', self.sitl_streamrate())

        '''ensure rangefinder gives height-above-ground'''
        self.load_mission("plane-gripper-mission.txt") # borrow this
        self.set_parameter("RTL_AUTOLAND", 1)
        self.set_current_waypoint(1)
        self.change_mode('AUTO')
        self.wait_ready_to_arm()
        self.arm_vehicle()
        self.wait_waypoint(5, 5, max_dist_to_final_wp_m=100)
        rf = self.assert_receive_message('RANGEFINDER')
        ds = self.assert_receive_message('DISTANCE_SENSOR')
        gpi = self.assert_receive_message('GLOBAL_POSITION_INT')
        if abs(rf.distance - gpi.relative_alt/1000.0) > 3:
            raise NotAchievedException(
                "rangefinder alt (%s) disagrees with global-position-int.relative_alt (%s)" %
                (rf.distance, gpi.relative_alt/1000.0))
        if abs(ds.current_distance*0.01 - gpi.relative_alt/1000.0) > 3:
            raise NotAchievedException(
                "distance_sensor alt (%s) disagrees with global-position-int.relative_alt (%s)" %
                (ds.current_distance*0.01, gpi.relative_alt/1000.0))
        self.wait_statustext("Auto disarmed", timeout=60)

        self.progress("Ensure RFND messages in log")
        if not self.current_onboard_log_contains_message("RFND"):
            raise NotAchievedException("No RFND messages in log")

    def TemperatureSensorRangefinder(self):
        '''Test that AP_TemperatureSensor can push temperature into a rangefinder'''
        self.progress("Configure rangefinder and temperature sensor")
        self.set_parameters({
            'RNGFND1_TYPE': 100,  # SIM backend
            'TEMP1_TYPE': 8,      # SHT3X (simulated in SITL)
            'TEMP1_ADDR': 0x44,   # SHT3X I2C address
            'TEMP1_BUS': 1,       # SITL registers SHT3X on I2C bus 1
            'TEMP1_SRC': 9,       # Rangefinder
            'TEMP1_SRC_ID': 1,    # rangefinder instance 0 (source_id-1)
            'TEMP_LOG': 1,        # enable temperature sensor logging
        })
        self.reboot_sitl()

        self.context_push()
        self.set_parameter('LOG_DISARMED', 1)
        self.delay_sim_time(15, reason="waiting for temperature data to flow")
        self.context_pop()

        self.progress("Checking RFND log for valid temperature")
        dfreader = self.dfreader_for_current_onboard_log()
        found_valid_temp = False
        while True:
            m = dfreader.recv_match(type='RFND')
            if m is None:
                break
            if not math.isnan(m.Temp):
                self.progress("RFND instance %d temperature: %.1f degC" % (m.Instance, m.Temp))
                found_valid_temp = True
                break

        if not found_valid_temp:
            raise NotAchievedException("No valid temperature in RFND log messages")

    def rc_defaults(self):
        ret = super(AutoTestPlane, self).rc_defaults()
        ret[3] = 1000
        ret[8] = 1800
        return ret

    def initial_mode_switch_mode(self):
        return "MANUAL"

    def default_mode(self):
        return "MANUAL"

    def PIDTuning(self):
        '''Test PID Tuning'''
        self.change_mode("FBWA") # we don't update PIDs in MANUAL
        super(AutoTestPlane, self).PIDTuning()

    def AuxModeSwitch(self):
        '''Set modes via auxswitches'''
        self.set_parameter("FLTMODE1", 1)  # circle
        self.set_rc(8, 950)
        self.wait_mode("CIRCLE")
        self.set_rc(9, 1000)
        self.set_rc(10, 1000)
        self.set_parameters({
            "RC9_OPTION": 4, # RTL
            "RC10_OPTION": 55, # guided
        })
        self.set_rc(9, 1900)
        self.wait_mode("RTL")
        self.set_rc(10, 1900)
        self.wait_mode("GUIDED")

        self.progress("resetting both switches - should go back to CIRCLE")
        self.set_rc(9, 1000)
        self.set_rc(10, 1000)
        self.wait_mode("CIRCLE")

        self.set_rc(9, 1900)
        self.wait_mode("RTL")
        self.set_rc(10, 1900)
        self.wait_mode("GUIDED")

        self.progress("Resetting switch should repoll mode switch")
        self.set_rc(10, 1000) # this re-polls the mode switch
        self.wait_mode("CIRCLE")
        self.set_rc(9, 1000)

    def wait_for_collision_threat_to_clear(self):
        '''wait to get a "clear" collision message", then slurp remaining
        messages'''
        last_collision = self.get_sim_time()
        while True:
            now = self.get_sim_time()
            if now - last_collision > 5:
                return
            self.progress("Waiting for collision message")
            m = self.mav.recv_match(type='COLLISION', blocking=True, timeout=1)
            self.progress("Got (%s)" % str(m))
            if m is None:
                continue
            last_collision = now

    def SimADSB(self):
        '''Tests to ensure simulated ADSB sensor continues to function'''
        self.set_parameters({
            "SIM_ADSB_COUNT": 1,
            "ADSB_TYPE": 1,
        })
        self.reboot_sitl()
        self.assert_receive_message('ADSB_VEHICLE', timeout=30)

    def ADSBResumeActionResumeLoiter(self):
        '''ensure we resume auto mission or enter loiter'''
        self.set_parameters({
            "ADSB_TYPE": 1,
            "AVD_ENABLE": 1,
            "AVD_F_ACTION": mavutil.mavlink.MAV_COLLISION_ACTION_MOVE_HORIZONTALLY,
            "AVD_F_RCVRY": 3,  # resume auto or loiter
        })
        self.reboot_sitl()
        self.takeoff(50)
        # fly North, create thread to east, wait for flying east
        self.start_subtest("Testing loiter resume")
        self.reach_heading_manual(0)
        here = self.get_location()
        self.test_adsb_send_threatening_adsb_message(here, offset_ne=(0, 30))
        self.wait_mode('AVOID_ADSB')
        # recovery has the vehicle circling a point... but we don't
        # know which point.  So wait 'til it looks like it is
        # circling, then grab the point, then check we're circling
        # it...
        self.wait_heading(290)
        self.wait_heading(300)
        dest = self.position_target_loc()
        REALLY_BAD_FUDGE_FACTOR = 1.25  # FIXME
        expected_radius = REALLY_BAD_FUDGE_FACTOR * self.get_parameter('WP_LOITER_RAD')
        self.wait_circling_point_with_radius(dest, expected_radius)

        self.start_subtest("Testing mission resume")
        self.reach_heading_manual(270)
        self.load_generic_mission("CMAC-circuit.txt", strict=False)
        self.change_mode('AUTO')
        self.wait_current_waypoint(2)
        self.test_adsb_send_threatening_adsb_message(here, offset_ne=(0, 30))
        self.wait_mode('AVOID_ADSB')
        self.wait_mode('AUTO')

        self.fly_home_land_and_disarm()

    def ADSBFailActionRTL(self):
        '''test ADSB avoidance action of RTL'''
        # message ADSB_VEHICLE 37 -353632614 1491652305 0 584070 0 0 0 "bob" 3 1 255 17
        self.set_parameter("RC12_OPTION", 38) # avoid-adsb
        self.set_rc(12, 2000)
        self.set_parameters({
            "ADSB_TYPE": 1,
            "AVD_ENABLE": 1,
            "AVD_F_ACTION": mavutil.mavlink.MAV_COLLISION_ACTION_RTL,
        })
        self.reboot_sitl()
        self.wait_ready_to_arm()
        here = self.get_location()
        self.change_mode("FBWA")
        self.delay_sim_time(2, reason="mode change to settle") # TODO: work out why this is required...
        self.test_adsb_send_threatening_adsb_message(here)
        self.progress("Waiting for collision message")
        m = self.assert_receive_message('COLLISION', timeout=4)
        if m.threat_level != 2:
            raise NotAchievedException("Expected some threat at least")
        if m.action != mavutil.mavlink.MAV_COLLISION_ACTION_RTL:
            raise NotAchievedException("Incorrect action; want=%u got=%u" %
                                       (mavutil.mavlink.MAV_COLLISION_ACTION_RTL, m.action))
        self.wait_mode("RTL")
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
