DavidIngraham/ArduPilot-tinkering/tools/report_classical_lateral.py

"""Write the local classical lateral-controls research report from computed results."""
import argparse
import html
import json
from pathlib import Path
import numpy as np
p=argparse.ArgumentParser();p.add_argument('directory',type=Path);a=p.parse_args();root=a.directory
m=json.loads((root/'summary.json').read_text());plant=json.loads((root/'plant.json').read_text())
def factors(roots):
    terms=[]
    for x,y in roots:
        if y < -1e-7:continue
        if abs(y)<1e-7:terms.append(f'(s {(-x):+.6g})')
        else:terms.append(f'(s² {(-2*x):+.6g} s {(x*x+y*y):+.6g})')
    return terms
rows=[]
for label,rr in [('D(s)',m['plant_poles']),('Nψ(s) / 1224.36945',m['transfer_functions']['heading_zeros']),('Np(s) / 2611.15459',m['transfer_functions']['roll_zeros'])]:
    rows.append('<tr><th>'+label+'</th><td>'+ '<br> × '.join(html.escape(x) for x in factors(rr))+'</td></tr>')
poles=np.array(m['selected_poles']);mode=poles[np.argmin(abs(poles[:,1]-15.96853))]
zeta=-mode[0]/np.linalg.norm(mode)
report='''<!doctype html><html lang="en"><meta charset="utf-8"><title>Classical lateral control analysis</title><style>body{font:17px/1.55 system-ui;color:#17313d;max-width:1150px;margin:32px auto;padding:0 20px}img{width:100%}pre{background:#eef3f6;padding:18px;white-space:pre-wrap;overflow-wrap:anywhere}table{border-collapse:collapse}td,th{border-bottom:1px solid #ccd;padding:10px;text-align:left;vertical-align:top}code{font-size:.94em}</style>
<h1>Classical analysis of the current lateral controller</h1><p>10 October 2026 · straight level Trout Lake trim · native high-DOF mission model</p>
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
