DavidIngraham/ArduPilot-tinkering/(commit log)

2026-10-09 Initial commit
    Preserve trajectory and paraglider research, first-person write-ups, experiment scripts, plots, measured results and implementation provenance. Raw logs and built binaries are omitted. AI-assisted research and documentation.
    [ParagliderAutoMission-L1-0.85.csv, ParagliderAutoMission-L1Tune.csv, ParagliderAutoMission-Original.csv, ParagliderAutoMission-QuickTune.csv, ParagliderAutoMission-baseline-calm.csv, ParagliderAutoMission-baseline-w15-t025.csv, ParagliderAutoMission-baseline-w15-t05.csv, ParagliderAutoMission-baseline-w3-t0.csv]
2026-10-09 Clarify rear pusher thrust in flight-test force diagram
2026-10-09 Analyze measured endurance and document battery and capacitor history
2026-10-09 Tell the progression from yaw-rate idea to roll-loop shortcut
2026-10-10 Organize Micro-AGU into four chapters and shared evidence appendix
    [lateral-parameter-ledger.csv, longitudinal-parameter-ledger.csv]
2026-10-11 Explain classical control analysis and filter results in 9-DOF blog chapters
2026-10-11 Analyze longitudinal modes and damper tradeoffs with causal rotor dynamics
2026-10-11 Correct longitudinal analysis for existing native voltage compensation
    Connect the existing output compensation and native TECS limit feedback in
    linear/nonlinear diagnostics, rerun the comparisons, and archive the final
    plots and plotting scripts. Correct the blog explanation and record the
    native nominal/low-voltage mission results and their capture/corner tradeoffs.
    Raw telemetry and experiment traces remain outside this repository.
    AI-assisted research and editing with OpenAI Codex.
2026-10-11 Add Three.js paraglider replay and live state viewer
    Include a SolidWorks payload export, preparation tools, synchronized joint plots, and local UDP/WebSocket bridge. AI-assisted implementation and validation.
2026-10-11 Animate CAD propeller and capstans from simulator state
    Integrate rotor RPM for deterministic replay and rotate named mechanisms about their CAD shafts. Use relative brake travel and preserve static geometry when channels are absent. AI-assisted implementation; five tests and production build pass.
2026-10-11 Show throttle history and brake pull in flight videos
2026-10-11 Show matched pitch damper sign responses in current simulator
2026-10-11 Show actual carriage translation and rotation in pitch sign comparison
2026-10-12 Compare commanded climbs with four pitch damper configurations
2026-10-12 Fix interpolated camera tracking in altitude comparison video
2026-10-12 Document native filter results and illustrate pitch-damper mechanics
2026-10-12 Explain TECS adaptation and throttle-only design intent
2026-10-12 Add build avionics and power overview
2026-10-12 Show H743-WLITE integrated power distribution
2026-10-12 Illustrate nine mechanical freedoms and explain joint parameter selection
2026-10-12 Add interactive nine-DOF tour and physics-driven joint response demonstrations
2026-10-12 Scale joint disturbances and follow nominal flight with ground flow
2026-10-12 Follow lateral drift while retaining nominal forward camera motion
2026-10-12 Add physical payload-only joint disturbance releases
2026-10-12 Add matched native CRUISE joint-release comparisons and control plots
2026-10-12 Explain gyroscopic yaw coupling in the pitch-release example
2026-10-12 Use settled waypoint AUTO flight for joint disturbance comparisons
2026-10-12 Simplify joint viewer to trim open loop and active AUTO
2026-10-13 Tell the manual brake trim story with launch and passive glide animation
2026-10-13 Introduce trim technique with the pilot’s Opale reference
2026-10-13 Extend flight test card with landing and flare characterization
2026-10-13 Publish spot-landing study and interactive native AUTO replay
    Document the held-out landing-aim improvement with final plots, an orbitable CAD replay, earth-fixed target rings, actuator histories and a video fallback. AI-assisted analysis and implementation.
2026-10-13 Explain landing architecture and visualize flare response
    Developed with OpenAI Codex assistance.
2026-10-13 Add wind direction compass to landing applet
2026-10-13 Explain landing lateral validation with matched interactive replays
    Document the preset mismatch, descending trims, selected 1 Hz filter and mission/landing tradeoffs. Include final landing results, before/after applets and reproducible analysis. AI-assisted work.
2026-10-13 Restore controller design article before landing analysis additions
2026-10-13 Explain landing refinement from the mission-controller baseline
2026-10-13 Compare calm and gentle-turbulence landings with the final controller
2026-10-13 Evaluate L1 guidance across missions and landing regressions
2026-10-13 Explain landing guidance tuning and refresh final-controller replays
2026-10-14 Demonstrate native turning landings and document swoop limits
2026-10-14 Consolidate Micro-AGU project with native SolidWorks CAD
2026-10-15 Explain sampled state-space linearization with rendered equations
2026-10-15 Refine scheduled state feedback with IMU estimation and fresh validation
2026-10-15 Test tension-dependent suspension stiffness against flight replays
2026-10-15 Study routed brakes and wider spreader; publish comparisons and flight card
2026-10-15 Deform canopy trailing fabric with recorded brake travel
2026-10-15 Amplify visible canopy brake deformation for overview cameras
2026-10-16 Simulation: own external model and add as-built calibration and assisted launch
2026-10-16 Match wind truth to adjacent ground speed telemetry pill
2026-10-16 Use Emscripten socket emulation for browser JSON physics
2026-10-16 Add compact altitude and cross-track history plots
2026-10-17 Add reproducible three-input LQI synthesis and native comparison
    AI-assisted. Separate reusable as-built model synthesis from one-off firmware/EKF validation. Retain baseline as default: the revised LQI follows the mission but underperforms baseline in this weather case.
2026-10-17 Add experimental MIMO controller selection to the browser simulator
    AI-assisted. Preserve PG+TECS as default, show firmware-confirmed ownership, package tested firmware, and cover switching, steering, mode exclusion and mobile UI.
2026-10-17 Verify throttle continuity during coordinated controller handovers
    AI-assisted integration test against the published WASM firmware and full Rust physics. Observed switch steps remain below one percentage point.
