DavidIngraham/ArduPilot-tinkering/(notices)

Notices in the files:
scratch/paraglider-tests/pitch-joint/integrated-control/experimental-SIM_Paraglider.h:
This program is free software: you can redistribute it and/or modify
it under the terms of the GNU General Public License as published by
the Free Software Foundation, either version 3 of the License, or
(at your option) any later version.
